vedderb/rise_sdvp/Hardware/Controller/Documents/CC2520/Readme.txt

XXXXXXXXXXXXXXXXXXXXXXXXXXXXXXXXXXXXXXXXXXXXXXXXXXXXXXXXXXXXXXXXX
X   	Artwork and documentation done by: 			X
X								X
X	TEXAS INSTRUMENTS NORWAY LPW              		X
X  								X
X	Address: Gaustadalléen 21    0349 OSLO                  X
X 	web: www.ti.com/lpw 		                        X
X                                                           	X
XXXXXXXXXXXXXXXXXXXXXXXXXXXXXXXXXXXXXXXXXXXXXXXXXXXXXXXXXXXXXXXXX

PCB NAME : CC2520-CC2591EM
REVISION: 3.0
DATE: 2009-09-21

FILE:  PACKED WITH WinZIP 

PCB DESCRIPTION:4 LAYER PCB 1.6 MM
      Copper        1   35 um
      Dielectric  1-2   0.175 mm (e.g. 1x Prepreg 7628 AT05 47% Resin)
      Copper        2   18 um
      Dielectric  2-3   1.14 mm (6x 7628M 43% Resin)
      Copper        3   18 um
      Dielectric  3-4   0.175 mm (e.g. 1x Prepreg 7628 AT05 47% Resin)
      Copper        4   35 um
  DE104iML or equivalent substrate (Resin contents around 45%, which gives Er=4.42@2.4GHz, TanD=0.016)
  Dimensions in mil (0.001 inch)
  DOUBLE SIDE SOLDER MASK,
  DOUBLE SIDE SILKSCREEN,
  8 MIL MIN TRACE WIDTH AND 5 MIL MIN ISOLATION.

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

*** ASSEMBLY FILES:
PASTCOMP.SPL            SOLDER PAST COMPONENT SIDE/POSITIVE         EXT. GERBER
PASTSOLD.SPL             SOLDER PAST SOLDER SIDE/POSITIVE            EXT. GERBER
ASSYCOMP.SPL            ASSEMBLY DRAWING COMPONENT SIDE/NEGATIVE    EXT. GERBER
ASSYSOLD.SPL            ASSEMBLY DRAWING SOLDER SIDE/NEGATIVE       EXT. GERBER
P_P_COMP.REP             PICK AND PLACE FILE COMPONENT SIDE          ASCII
P_P_SOLD.REP             PICK AND PLACE FILE SOLDER SIDE             ASCII
CC2520-CC2591EM_Partlist.xls	BOM				Excel

PDF FILES:
CC2520_CC2591_EM_SCHEMATIC.PDF	Circuit Diagram
CC2520_CC2591_EM_LAYOUT.PDF	Layout Diagram

CADSTAR FILES:
CC2520_CC2591_EM.SCM		Cadstar Schematic file
CC2520_CC2591_EM.CSA		Cadstar Shematic archive
CC2520_CC2591_EM.PCB		Cadstar layout file
CC2520_CC2591_EM.CPA		Cadstar PCB archive

README.TXT           	THIS FILE                                 			ASCII

END.
