vedderb/rise_sdvp/Misc/Test Data/paper_2018-06/plots/3_diff_flat_10.pdf

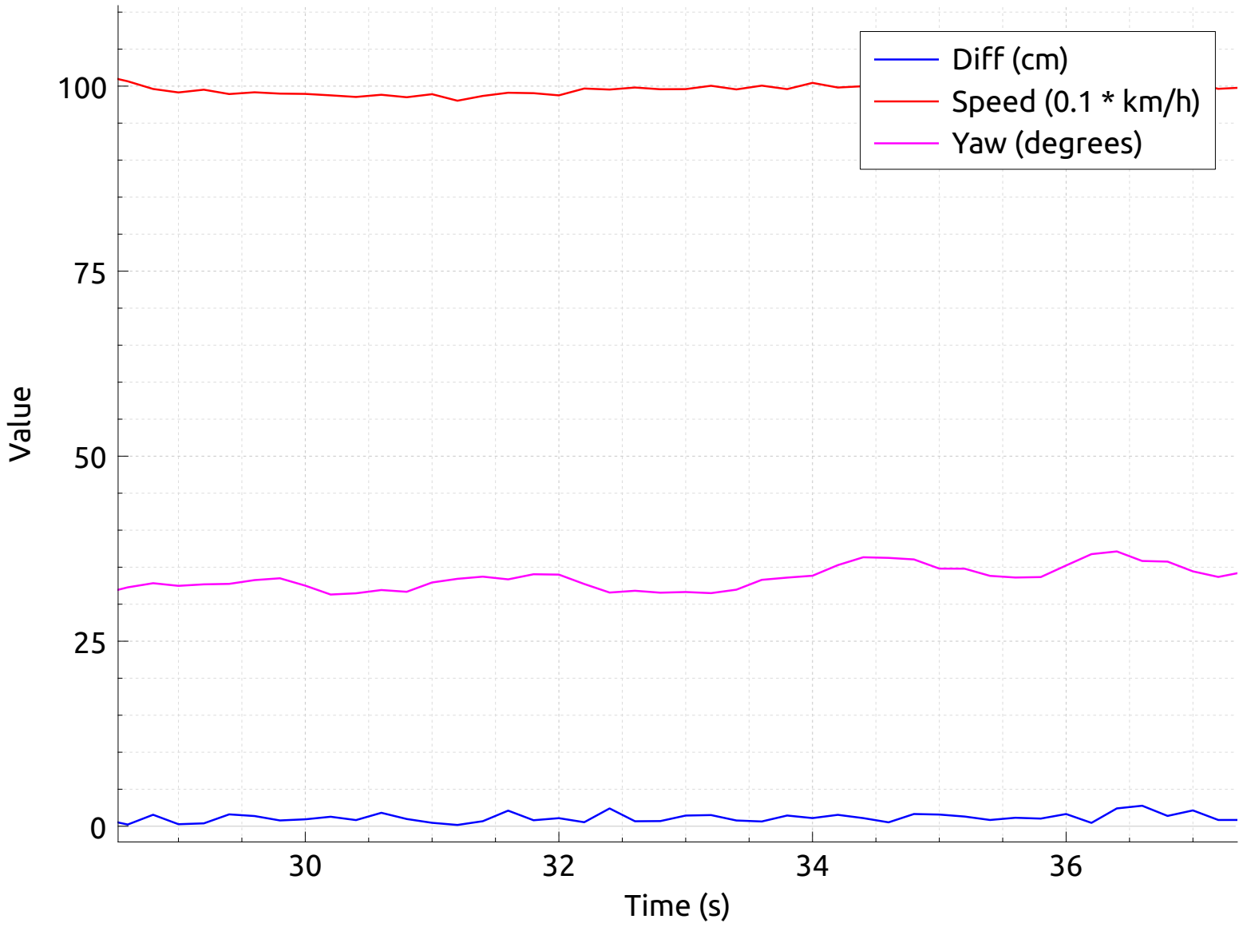
[picture p5: figure]
Time (s); alu; Diff (cm) Speed (0.1 * km/h) Yaw (degrees)
