vedderb/rise_sdvp/Misc/Test Data/paper_2018-06/plots/1_diff_flat_wrong_wheel_rad.pdf

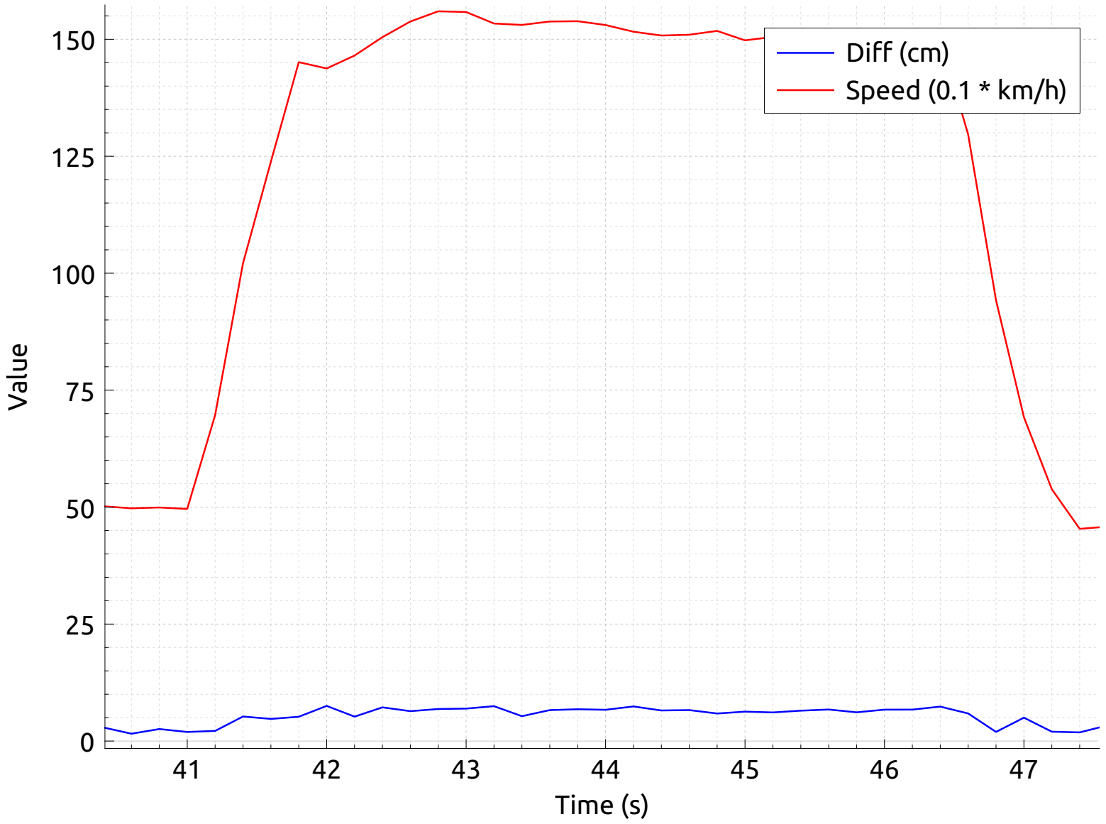
[picture p7: figure]
Time (s); alu; Diff (cm) Speed (0.1 * km/h)
