vedderb/rise_sdvp/Misc/Test Data/paper_2018-06/plots/3_diff_no_corr_zoom.pdf

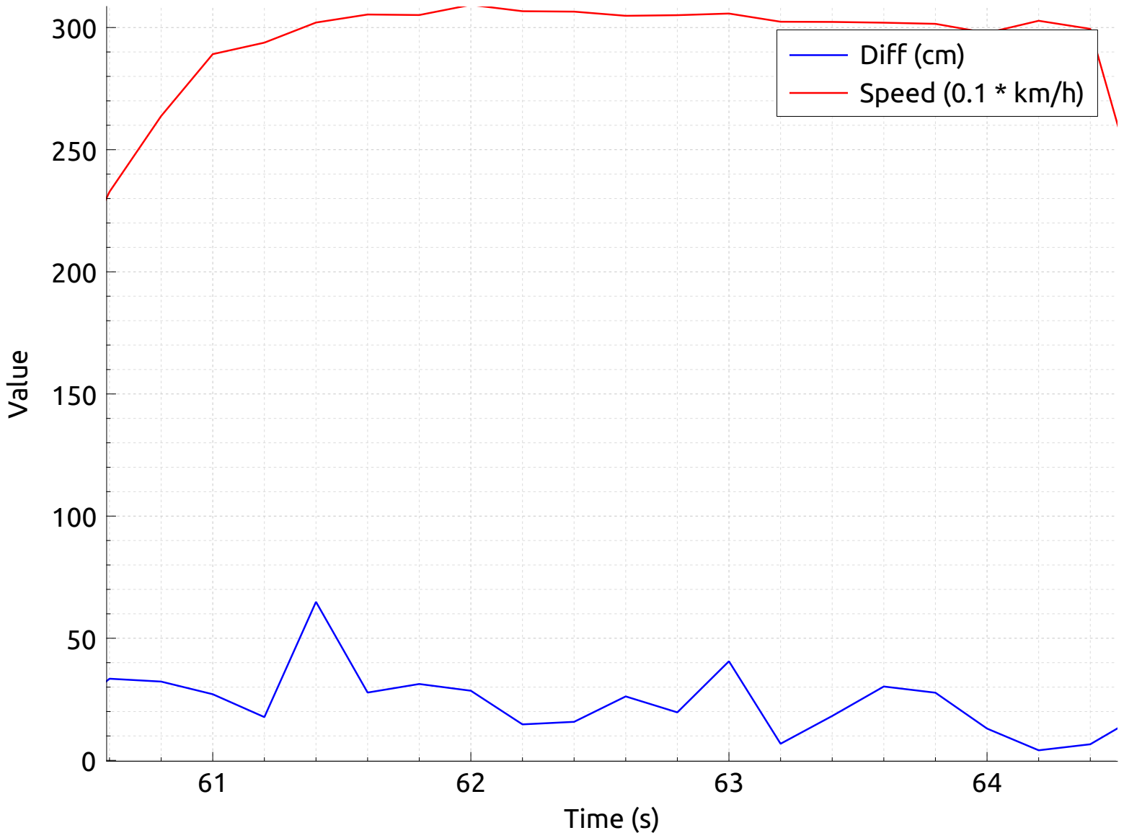
[picture p10: figure]
Time (s); alu; Diff (cm) Speed (0.1 * km/h)
