vedderb/rise_sdvp/Misc/Test Data/paper_2018-06/plots/3_diff_zoom.pdf

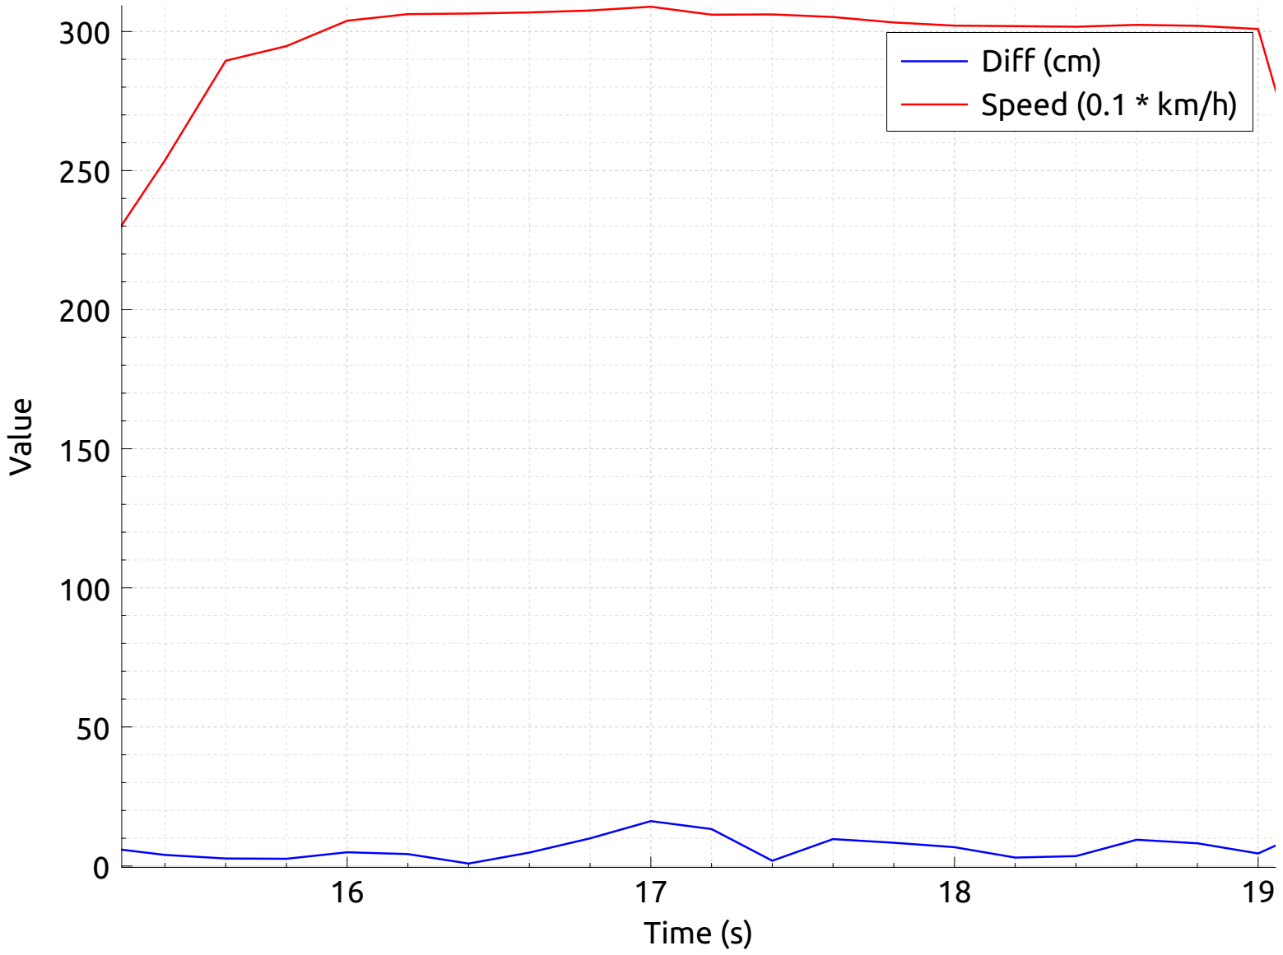
[picture p11: figure]
Value
