vedderb/rise_sdvp/Hardware/Controller/Images/Back.png

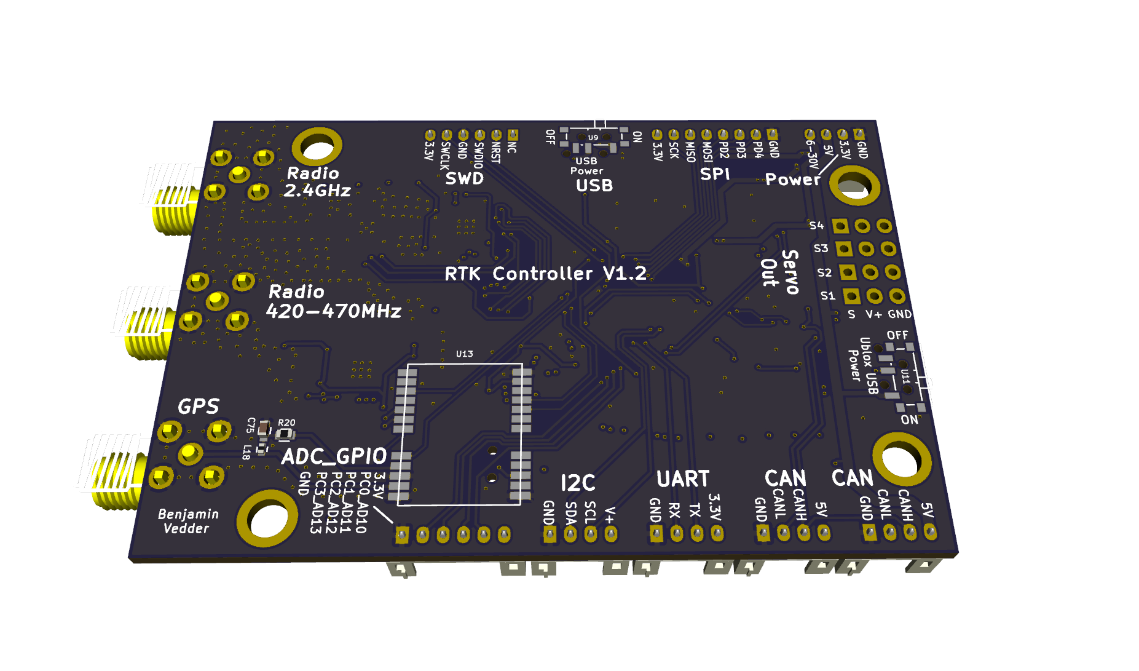
Hardware/Controller/Images/Back.png
