vedderb/rise_sdvp/Hardware/Controller/Images/Front.png

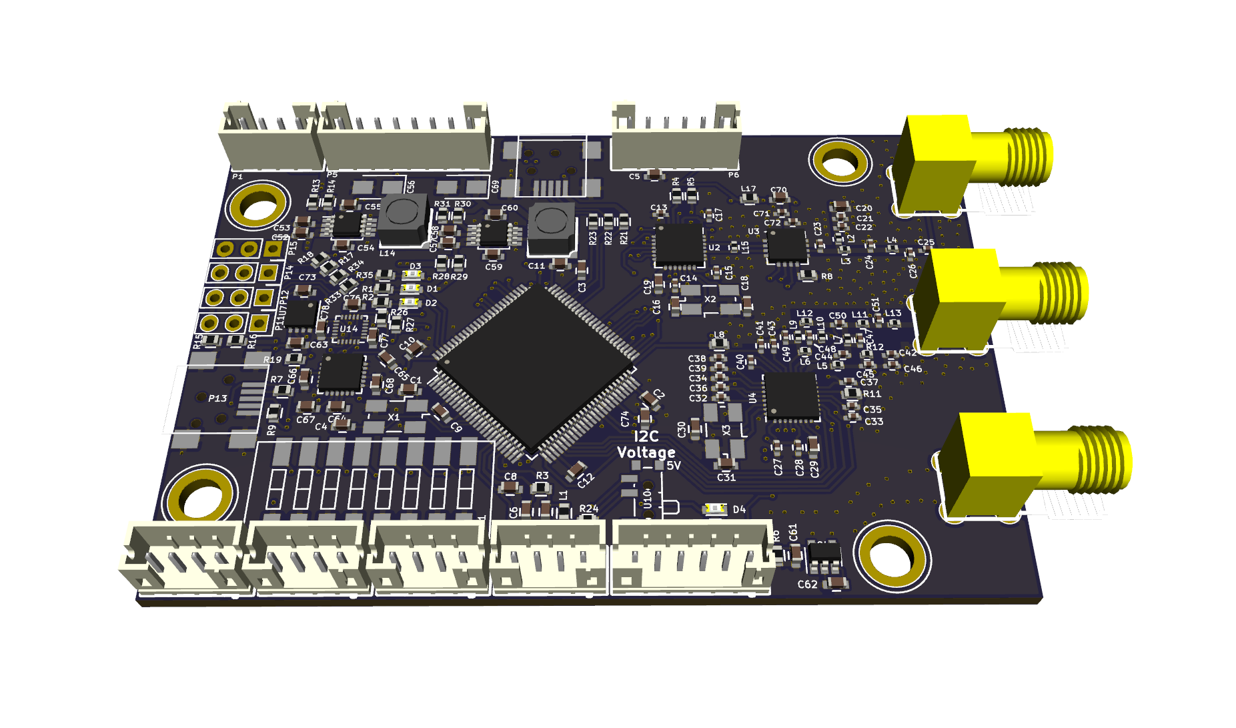
Hardware/Controller/Images/Front.png
