vedderb/rise_sdvp/Hardware/Controller/Images/pcb_dim.png

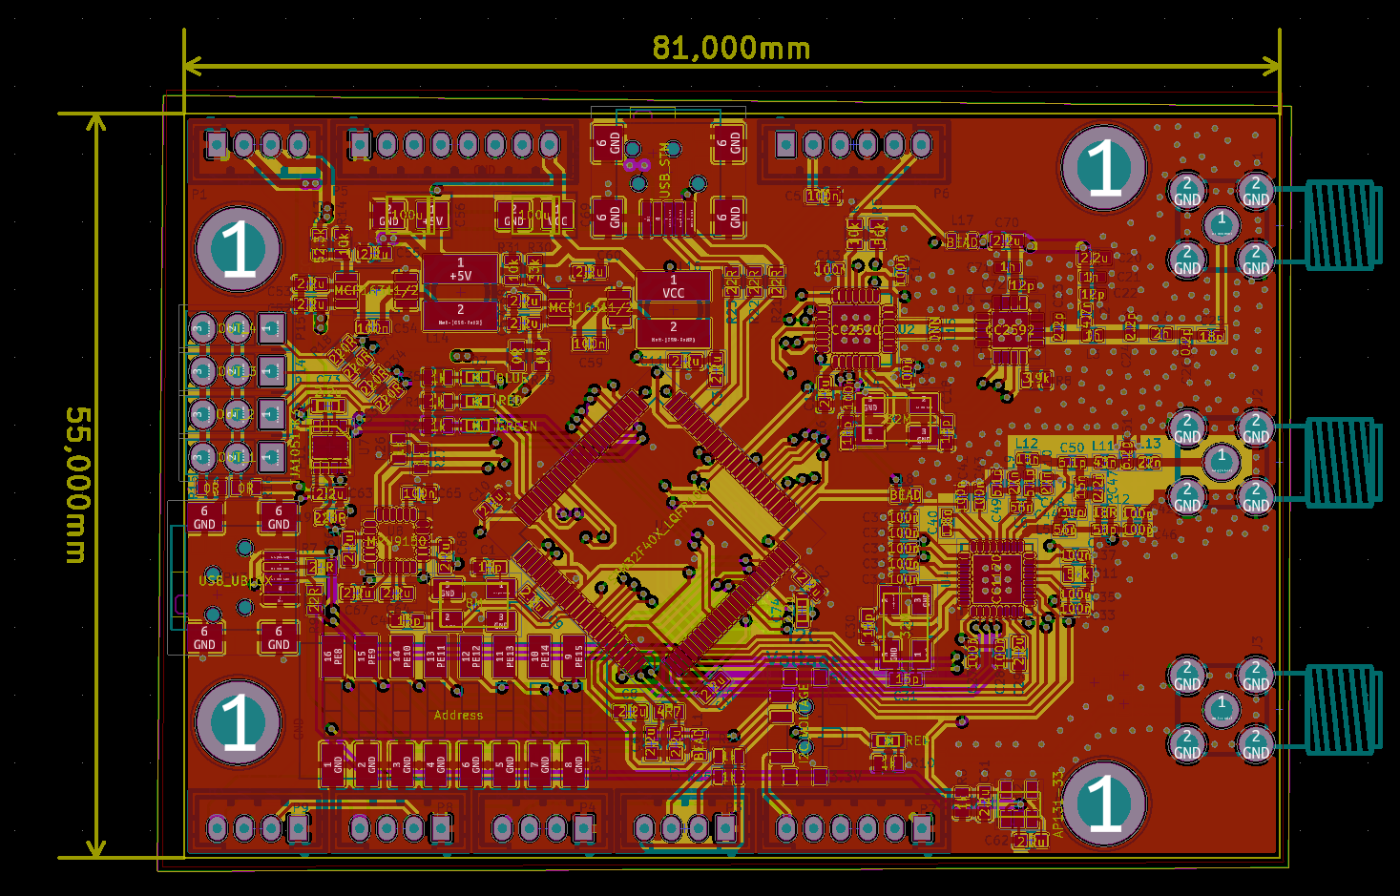
Hardware/Controller/Images/pcb_dim.png
