vedderb/rise_sdvp/Hardware/io_board/doc/20200402_221031.jpg

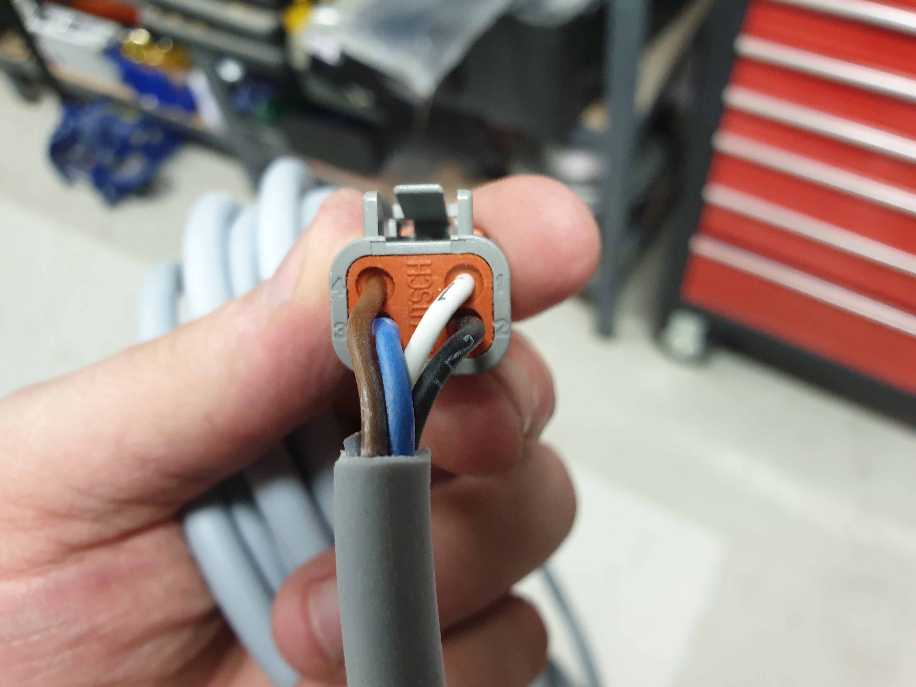
Hardware/io_board/doc/20200402_221031.jpg
