vedderb/rise_sdvp/Hardware/io_board/freecad/20200411_190108.jpg

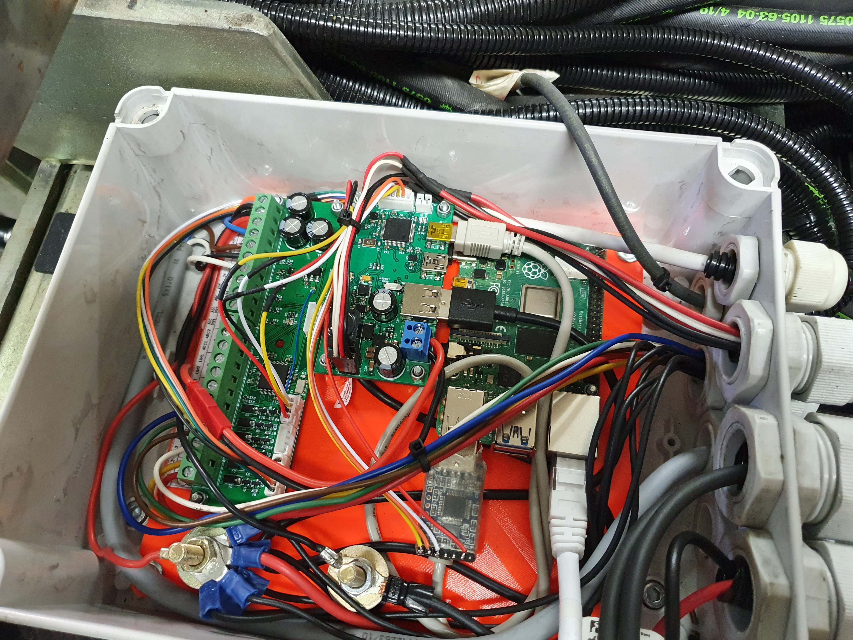
Hardware/io_board/freecad/20200411_190108.jpg
