vedderb/rise_sdvp/Hardware/io_board/freecad/freecad.png

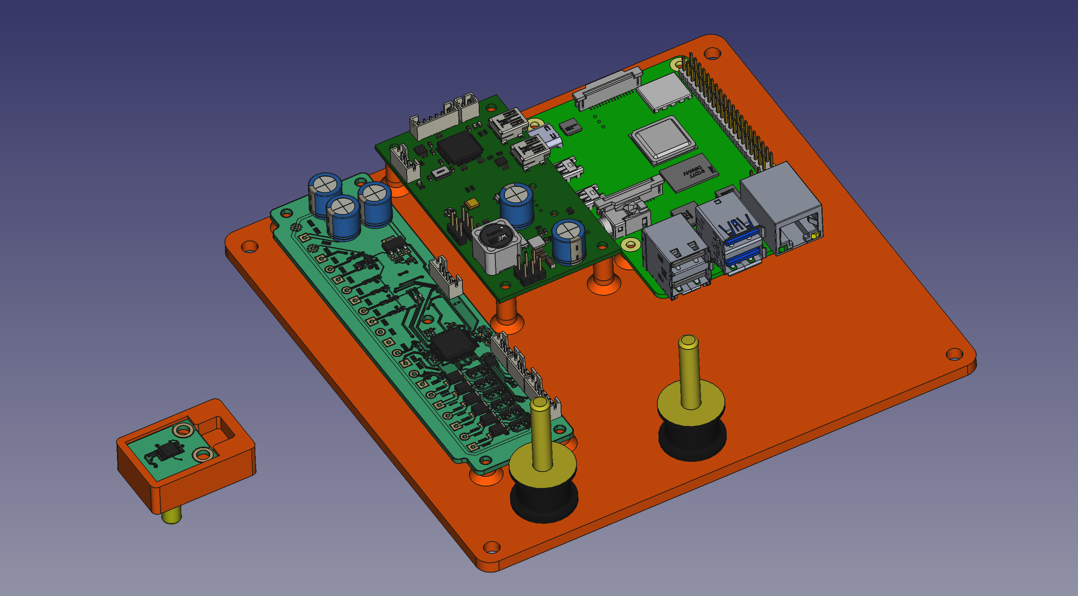
Hardware/io_board/freecad/freecad.png
