vedderb/rise_sdvp/Hardware/RFMote_PA/Images/Back_3D.png

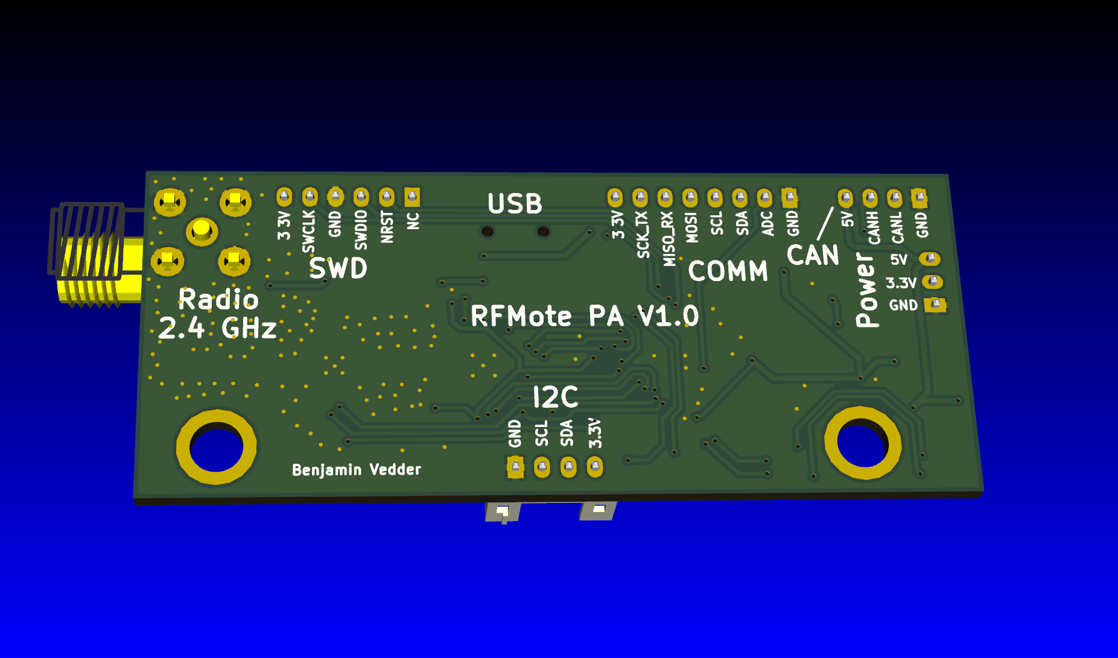
Hardware/RFMote_PA/Images/Back_3D.png
