vedderb/rise_sdvp/Hardware/RFMote_PA/Images/Front_3D.png

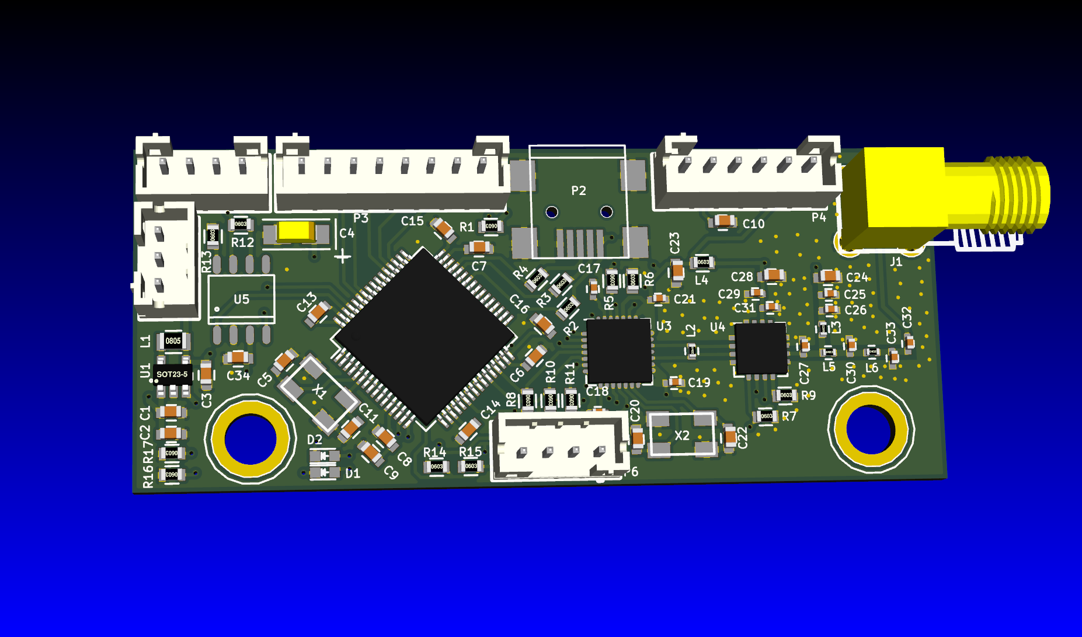
Hardware/RFMote_PA/Images/Front_3D.png
