vedderb/rise_sdvp/Linux/Car_Client/res/button.png

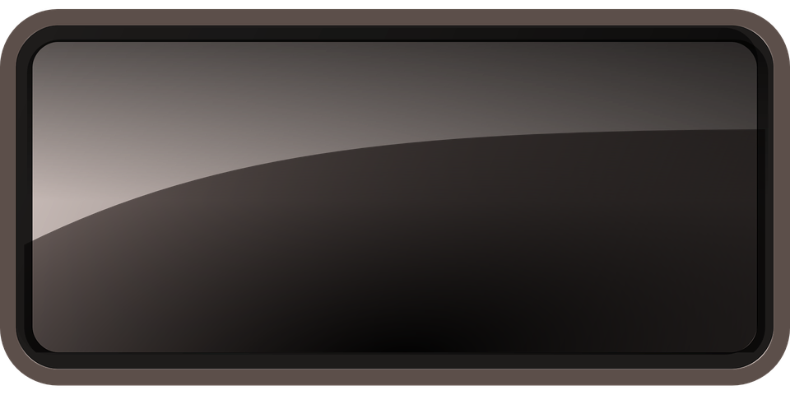
Linux/Car_Client/res/button.png
