vedderb/rise_sdvp/Linux/Car_Client/res/start.jpg

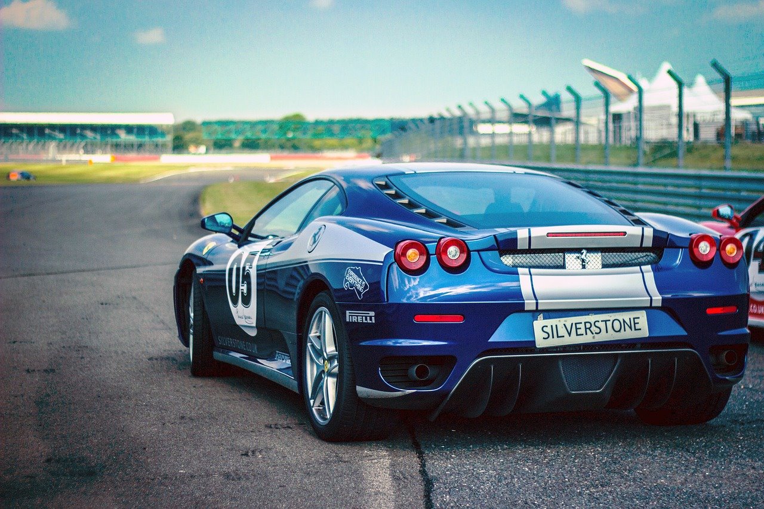
Linux/Car_Client/res/start.jpg
