vedderb/rise_sdvp/Hardware/Controller/Documents/BOM.ods

Designator | Package | Designation | Qty/Board | Mouser | Farnell | Part Number | Price/Unit | Price/Board | Comment
C1,C4,C16,C18,C30,C31 | C_0603 | 15p | 6 |  | 1759124 | MC0603N150J101CT | 0,228 | 1,368
C2,C3,C6,C7,C8,C9,C10,C11,C12,C19,C20,C29,C52,C53,C55,C57,C58,C60,C61,C62,C63,C64,C66,C67,C68,C70,C73,C74,C77,C78 | C_0603 | 2.2u | 30 | 810-C1608X5R1C225M-4 |  | C1608X5R1C225M-4 | 0,515 | 15,45
C5,C54,C59,C65,C75,C76 | C_0603 | 100n | 6 |  | 432210 | CC0603KRX7R7BB104 | 0,08 | 0,48
C13,C14,C15,C17,C27,C28,C32,C33,C34,C35,C36,C37,C38,C39,C41,C42,C43 | C_0402 | 100n | 17 |  | 1759380 | MC0402X104K100CT | 0,0457 | 0,7769
C21,C71 | C_0402 | 1n | 2 |  | 8819556 | GRM1555C1H102JA01D | 0,327 | 0,654
C22,C72 | C_0402 | 12p | 2 |  | 1828875 | GRM1555C1H120JA01D | 0,113 | 0,226
C23,C24,C47 | C_0402 | 2.2p | 3 |  | 2434609 | GRM1555C1H2R2CA01D | 0,113 | 0,339
C25 | C_0402 | 18p | 1 |  | 1828876 | GRM1555C1H180JA01D | 0,1164 | 0,1164
C26 | C_0402 | 0.2p | 1 | 81-GRM1555C1HR20BA1D |  | GRM1555C1HR20BA1D | 0,326 | 0,326
C40 | C_0402 | 1.8n | 1 |  | 2456099 | GRM1557U1A182JA01D | 0,676 | 0,676
C44 | C_0402 | 39p | 1 |  | 1828878 | GRM1555C1H390JA01D | 0,1212 | 0,1212
C45 | C_0402 | 56p | 1 |  | 1828879 | GRM1555C1H560JA01D | 0,123 | 0,123
C46 | C_0402 | 100p | 1 |  | 2218836 | GRM1555C1H101JA01D | 0,0927 | 0,0927
C48,C49,C50 | C_0402 | 5.1p | 3 | 81-GRM1555C1E5R1CA1D |  | GRM1555C1E5R1CA01D | 0,074 | 0,222
C51 | C_0402 | 6.2p | 1 | 81-GRM1555C1H6R2BA1D |  | GRM1555C1H6R2BA01D | 0,205 | 0,205
C56,C69 | TantalC_SizeB_EIA-3528_Wave | 100u | 2 |  | 1432579 | TPSB107K006R0400 | 4,01 | 8,02
J1,J2,J3 | sma_90_r300.124.403 | SMA | 3 |  | 1909297 | 73251-3131 | 28,79 | 86,37
L1,L8,L17 | R_0603 | BEAD | 3 |  | 2443237 | BLM18HE152SN1D | 1,1 | 3,3
L2 | R_0402 | 4.7n | 1 | 81-LQW15AN4N7B00D |  | LQW15AN4N7B00D | 1,09 | 1,09
L3 | R_0402 | 1n | 1 | 81-LQP15MN1N0B02D |  | LQP15MN1N0B02D | 1,11 | 1,11
L4 | R_0402 | 2n | 1 | 81-LQP15MN2N0B02D |  | LQP15MN2N0B02D | 1,11 | 1,11
L5,L6,L18 | R_0402 | 56n | 3 | 81-LQW15AN56NJ00D |  | LQW15AN56NJ00D | 0,986 | 2,958
L7,L12 | R_0402 | 15n | 2 | 81-LQW15AN15NJ00D |  | LQW15AN15NJ00D | 0,986 | 1,972
L9,L10 | R_0402 | 27n | 2 | 81-LQW15AN27NG00D |  | LQW15AN27NG00D | 1,09 | 2,18
L11 | R_0402 | 43n | 1 | 81-LQW15AN43NG00D |  | LQW15AN43NG00D | 1,09 | 1,09
L13 | R_0402 | 22n | 1 | 81-LQW15AN22NG00D |  | LQW15AN22NG00D | 1,09 | 1,09
L14,L16 | inductor_smd_4.8x2.8mm | 22U | 2 |  | 2066945 | 74408943220 | 16,55 | 33,1
L15 | R_0402 | DNM | 1 |  |  |  |  | 0 | Do not mount
P1,P3,P4,P8,P9 | b4b-ph-kl | Mini-JST 4P | 5 |  | 9492437 | B4B-PH-K-S(LF)(SN) | 1,75 | 8,75
P2,P13 | USB_Mini-B | USB_OTG | 2 |  | 2112367 | 10033526-N3212MLF | 4,45 | 8,9
P5 | b8b-ph-kl | Mini-JST 8P | 1 |  | 9492461 | B8B-PH-K-S(LF)(SN) | 3,5 | 3,5
P6,P7 | b6b-ph-kl | Mini-JST 6P | 2 |  | 9492453 | B6B-PH-K-S(LF)(SN) | 2,6 | 5,2
P11,P12,P14,P15 | Pin_Header_Straight_1x03 | Servo | 4 | 538-22-28-4035 |  | 22-28-4035 | 1,81 | 7,24
R1,R2,R6,R10,R24,R25,R26,R27,R35 | R_0603 | 1k | 9 |  | 2447272 | MCWR06X1001FTL | 0,0636 | 0,5724
R3,R20 | R_0603 | 4R7 | 2 |  | 2447390 | MCWR06W4R70FTL | 0,0793 | 0,1586
R4,R14,R31 | R_0603 | 10k | 3 |  | 2447230 | MCWR06X1002FTL | 0,0627 | 0,1881
R5,R11 | R_0603 | 56k | 2 |  | 2447399 | MCWR06X5602FTL | 0,0627 | 0,1254
R8 | R_0603 | 3.9k | 1 |  | 2447363 | MCWR06X3901FTL | 0,0627 | 0,0627
R12 | R_0402 | 18R | 1 |  | 2447119 | MCWR04X18R0FTL | 0,0614 | 0,0614
R13 | R_0603 | 52.3k | 1 |  | 1170957 | MC0063W0603152K3 | 0,156 | 0,156
R16,R28 | R_0603 | 0R | 0 |  | 2689614 | MCWR06X000 PTL | 0,0575 | 0 | Do not mount
R15,R29 | R_0603 | 0R | 2 |  | 2689614 | MCWR06X000 PTL | 0,0575 | 0,115
R17,R18,R19,R33,R34 | R_0603 | 220R | 5 |  | 2447298 | MCWR06X2200FTL | 0,0627 | 0,3135
R7,R9,R21,R22,R23 | R_0603 | 22R | 5 |  | 2447301 | MCWR06X22R0FTL | 0,0636 | 0,318
R30 | R_0603 | 33k | 1 |  | 2447342 | MCWR06X3302FTL | 0,0636 | 0,0636
SW1 | SW_DIP_x8_Slide | Address | 1 |  | 1813625 | ADF08S04 | 13,55 | 13,55
U1 | LQFP-100_14x14mm_Pitch0.5mm | STM32F40X_LQFP100 | 1 |  | 2064368 | STM32F407VGT6 | 86,41 | 86,41
U2 | QFN-28-1EP_5x5mm_Pitch0.5mm | CC2520 | 1 |  | 1573887 | CC2520RHDT | 42,35 | 42,35
U3 | QFN-16-1EP_4x4mm_Pitch0.65mm | CC2592 | 1 |  | 2422919 | CC2592RGVT | 25,3 | 25,3
U4 | QFN-32-1EP_5x5mm_Pitch0.5mm | CC1120 | 1 |  | 2422922 | CC1120RHBT | 50 | 50
U5,U6 | MSOP-8_3x3mm_Pitch0.65mm | MCP16311/2 | 2 |  | 2414134 |  | 10,42 | 20,84
U7 | DFN-8-EP-0.65 | TJA1051TK/3118 | 1 | 771-TJA1051TK/3118 | 2574964 | TJA1051TK/3 | 7,64 | 7,64 | Mouser or farnell, depending on stock
U8 | QFN-24_4x4mm_Pitch0.5mm | MPU9150 | 0 |  |  |  |  | 0 | Do not mount
U14 | QFN-24_3x3mm_Pitch0.4mm | MPU9250 | 1 | 410-MPU-9250 |  | MPU-9250 | 68,02 | 68,02
X1 | Crystal_5x3mm_3pin | 8M | 1 |  | 2467817 | ABM3B-8.000MHZ-10-1-U-T | 6,68 | 6,68
X2,X3 | Crystal_5x3mm_3pin | 32M | 2 | 815-ABM3B-32-B2 |  | ABM3B-32.000MHZ-B2-T | 8,08 | 16,16
D1,D4 | LED-0603 | RED | 2 |  | 1226390 | LSQ976-Z | 2,68 | 5,36
D2 | LED-0603 | GREEN | 1 |  | 2575345 | LGQ396-PS-35 | 1,23 | 1,23
D3 | LED-0603 | BLUE | 1 |  | 1908058 | LNJ937W8CRA | 3,1 | 3,1
U9,U10,U11 | Switch | Switch | 3 | 611-PCM12SMTR |  | PCM12SMTR | 0,75 | 2,25
U12 | SOT23-5 | Vreg | 1 | 998-MIC5504-3.3YM5TR |  | MIC5504-3.3YM5TR | 1,02 | 1,02
U13 | Ublox-NEO | Ublox M8P | 0 |  |  | NEO-M8P-2 | 1650 | 0 | Do not mount
 |  | Components total | 165 |  |  |  | Total SEK | 550,2009
