vedderb/rise_sdvp/Hardware/RFMote_PA/Documents/BOM_RFMote_PA.ods

Designator | Package | Designation | Qty/Board | Qty Order | Mouser | Farnell | Part Number | Price/Unit | Price/Board | Price Order | Comment
C1,C2,C3,C6,C7,C8,C9,C13,C14,C15,C16,C23,C24,C28,C34 | C_0603 | 2.2u | 15 | 100 |  | 1962117 | C1608X5R1C225M080AB | 0,241 | 3,615 | 24,1
C4 | TantalC_SizeA_EIA-3216_Wave | 100u | 1 | 10 |  | 1432579 | TPSB107K006R0400 | 4,01 | 4,01 | 40,1
C5,C11,C20,C22 | C_0603 | 15p | 4 | 50 |  | 1759124 | MC0603N150J101CT | 0,228 | 0,912 | 11,4
C10 | C_0603 | 100n | 1 | 10 |  | 432210 | CC0603KRX7R7BB104 | 0,08 | 0,08 | 0,8
C17,C18,C19,C21 | C_0402 | 100n | 4 | 100 |  | 1759380 | MC0402X104K100CT | 0,0457 | 0,1828 | 4,57
C25,C29 | C_0402 | 1n | 2 | 50 |  | 8819556 | GRM1555C1H102JA01D | 0,327 | 0,654 | 16,35
C26,C31 | C_0402 | 12p | 2 | 50 |  | 1828875 | GRM1555C1H120JA01D | 0,113 | 0,226 | 5,65
C27,C30 | C_0402 | 2.2p | 2 | 50 |  | 2434609 | GRM1555C1H2R2CA01D | 0,113 | 0,226 | 5,65
C32 | C_0402 | 18p | 1 | 10 |  | 1828876 | GRM1555C1H180JA01D | 0,1164 | 0,1164 | 1,164
C33 | C_0402 | 0.2p | 1 | 10 | 81-GRM1555C1HR20BA1D |  | GRM1555C1HR20BA1D | 0,326 | 0,326 | 3,26
J1 | sma_90_crf | SMA | 1 | 5 |  | 1909297 | 73251-3131 | 28,79 | 28,79 | 143,95
L1 | R_0805 | 2.2u | 1 | 10 |  | 2309790 | ELG-TEA2R2NA | 2,34 | 2,34 | 23,4
L2 | R_0402 | DNM | 0 | 0 |  |  |  |  | 0 | 0
L3 | R_0402 | 4.7n | 1 | 10 | 81-LQW15AN4N7B00D |  | LQW15AN4N7B00D | 1,09 | 1,09 | 10,9
L4 | R_0603 | BEAD | 1 | 10 |  | 2443237 | BLM18HE152SN1D | 1,1 | 1,1 | 11
L5 | R_0402 | 1n | 1 | 10 | 81-LQP15MN1N0B02D |  | LQP15MN1N0B02D | 1,11 | 1,11 | 11,1
L6 | R_0402 | 2n | 1 | 10 | 81-LQP15MN2N0B02D |  | LQP15MN2N0B02D | 1,11 | 1,11 | 11,1
P1 | b3b-ph-kl | V_IN | 1 | 10 |  | 9492429 | B3B-PH-K-S(LF)(SN) | 1,55 | 1,55 | 15,5
P2 | USB_Mini-B | USB_OTG | 1 | 10 |  | 2112367 | 10033526-N3212MLF | 4,45 | 4,45 | 44,5
P3 | b8b-ph-kl | COMM | 1 | 10 |  | 9492461 | B8B-PH-K-S(LF)(SN) | 3,5 | 3,5 | 35
P4 | b6b-ph-kl | SWD | 1 | 10 |  | 9492453 | B6B-PH-K-S(LF)(SN) | 2,6 | 2,6 | 26
P5,P6 | b4b-ph-kl | CAN | 2 | 10 |  | 9492437 | B4B-PH-K-S(LF)(SN) | 1,75 | 3,5 | 17,5
R1 | R_0603 | 0R | 1 | 10 |  | 2447743 | MCWR06X000 PTL | 0,0575 | 0,0575 | 0,575
R2,R3,R4 | R_0603 | 22R | 3 | 50 |  | 2447301 | MCWR06X22R0FTL | 0,0636 | 0,1908 | 3,18
R5,R8,R10,R11,R13 | R_0603 | 10k | 5 | 100 |  | 2447230 | MCWR06X1002FTL | 0,0627 | 0,3135 | 6,27
R6,R7 | R_0603 | 56k | 2 | 50 |  | 2447399 | MCWR06X5602FTL | 0,0627 | 0,1254 | 3,135
R9 | R_0603 | 3.9k | 1 | 10 |  | 2447363 | MCWR06X3901FTL | 0,0627 | 0,0627 | 0,627
R12 | R_0603 | 220R | 1 | 10 |  | 2447298 | MCWR06X2200FTL | 0,0627 | 0,0627 | 0,627
U1 | SOT-23-5 | LM3671 | 1 | 5 |  | 1685767 | LM3671MF-3.3/NOPB | 6,55 | 6,55 | 32,75
U3 | QFN-28-1EP_5x5mm_Pitch0.5mm | CC2520 | 1 | 5 |  | 1573887 | CC2520RHDT | 42,35 | 42,35 | 211,75
U4 | QFN-16-1EP_4x4mm_Pitch0.65mm | CC2592 | 1 | 5 |  | 2422919 | CC2592RGVT | 25,3 | 25,3 | 126,5
U5 | SO-8 | MCP2551-I/SN | 1 | 5 |  | 9758569 | MCP2551-I/SN | 7,64 | 7,64 | 38,2
X2 | Crystal_5x3mm_3pin | 32M | 1 | 5 | 815-ABM3B-32-B2 |  | ABM3B-32.000MHZ-B2-T | 8,08 | 8,08 | 40,4
U2 | LQFP-64_10x10mm_Pitch0.5mm | STM32F40X_LQFP64 | 1 | 5 |  | 2064363 | STM32F405RGT6 | 115,25 | 115,25 | 576,25
X1 | Crystal_5x3mm_3pin | 8m | 1 | 5 |  | 2467817 | ABM3B-8.000MHZ-10-1-U-T | 10,4 | 10,4 | 52
R14,R15,R16,R17 | R_0603 | 1k | 4 | 10 |  | 2447272 | MCWR06X1001FTL | 0,0636 | 0,2544 | 0,636
D1 | LED-0603 | RED | 1 | 10 |  | 1226390 | LSQ976-Z | 2,68 | 2,68 | 26,8
D2 | LED-0603 | GREEN | 1 | 10 |  | 1226372 | LGQ971 | 1,15 | 1,15 | 11,5
 |  | Total | 71 |  |  |  |  | Total | 281,9552 | 1594,194
