vedderb/rise_sdvp/Hardware/Controller/Documents/CC1120/CC1120EM_420_470_Partlist.xls

CC1120 EM Rev 1.1.0 420-470 MHz version
Including LPF
Ref. | Part name | Pcs/unit | Description | Manufacturer | Part number | Supplier | Ordering code | Alt. Manufacturer | Alt. Part number | Alt. Supplier | Alt. Ordering code | Comments
C11 | C_47N_0402_X7R_K_25 | 1 | Capacitor, 47n, 0402, X7R, 10%, 25V | Murata | GRM155R71E473KA88D
C12 | C_100N_0402_X5R_K_10 | 0 | Do not mount
C41 | C_10N_0402_X7R_K_25 | 0 | Do not mount
C51 | C_47N_0402_X7R_K_25 | 1 | Capacitor, 47n, 0402, X7R, 10%, 25V | Murata | GRM155R71E473KA88D
C52 | C_2U2_0603_X5R_K_10 | 1 | Capacitor, 2u2, 0603, X5R, 10%, 10V | Murata | GRM188R61A225KE34D
C53 | C_0402 | 0 | Do not mount
C61 | C_220N_0402_X5R_K_10 | 1 | Capacitor, 220n, 0402, X5R, 10%, 10V | Murata | GRM155R61A224KE19D
C121 | C_47N_0402_X7R_K_25 | 1 | Capacitor, 47n, 0402, X7R, 10%, 25V | Murata | GRM155R71E473KA88D
C131 | C_47N_0402_X7R_K_25 | 1 | Capacitor, 47n, 0402, X7R, 10%, 25V | Murata | GRM155R71E473KA88D
C151 | C_47N_0402_X7R_K_25 | 1 | Capacitor, 47n, 0402, X7R, 10%, 25V | Murata | GRM155R71E473KA88D
C171 | C_10N_0402_X7R_K_25 | 1 | Capacitor, 10n, 0402, X7R, 10%, 25V | Murata | GRM155R71E103KA01D
C172 | C_100P_0402_NP0_J_50 | 1 | Capacitor, 100p, 0402, NP0, 5% 50V | Murata | GRM1555C1H101JZ01D
C173 | C_56P_0402_NP0_J_50 | 0 | Do not mount |  |  | #N/A | #N/A | #N/A | #N/A | #N/A | #N/A | #N/A
C174 | C_39P_0402_NP0_J_50 | 1 | Capacitor, 39p, 0402, NP0, 5%, 50V | Murata | GRM1555C1H390JZ01D
C175 | C_6P2_0402_NP0_C_50 | 1 | Capacitor, 6p2, 0402, NP0, +-0.25pF 50V | Murata | GRM1555C1H6R2CZ01D
C176 | C_2P2_0402_NP0_C_50 | 1 | Capacitor, 2p2, 0402, NP0, +-0.25pF, 50V | Murata | GRM1555C1H2R2CZ01
C177 | C_0402 | 0 | Do not mount
C181 | C_5P1_0402_NP0_C_50 | 1 | Capacitor, 5p1, 0402, NP0, +-0.25pF, 50V | Murata | GRM1555C1H5R1CZ01D
C191 | C_5P1_0402_NP0_C_50 | 1 | Capacitor, 5p1, 0402, NP0, +-0.25pF, 50V | Murata | GRM1555C1H5R1CZ01D
C201 | C_5P1_0402_NP0_C_50 | 1 | Capacitor, 5p1, 0402, NP0, +-0.25pF, 50V | Murata | GRM1555C1H5R1CZ01D
C211 | C_10N_0402_X7R_K_25 | 1 | Capacitor, 10n, 0402, X7R, 10%, 25V | Murata | GRM155R71E103KA01D
C221 | C_47N_0402_X7R_K_25 | 1 | Capacitor, 47n, 0402, X7R, 10%, 25V | Murata | GRM155R71E473KA88D
C231 | C_1N8_0402_U2J_J_10 | 1 | Capacitor, 1n8, 0402, U2J, 5%, 10V | Murata | GRM1557U1A182JA01D
C251 | C_47N_0402_X7R_K_25 | 1 | Capacitor, 47n, 0402, X7R, 10%, 25V | Murata | GRM155R71E473KA88D
C261 | C_47N_0402_X7R_K_25 | 1 | Capacitor, 47n, 0402, X7R, 10%, 25V | Murata | GRM155R71E473KA88D
C271 | C_47N_0402_X7R_K_25 | 1 | Capacitor, 47n, 0402, X7R, 10%, 25V | Murata | GRM155R71E473KA88D
C281 | C_47N_0402_X7R_K_25 | 1 | Capacitor, 47n, 0402, X7R, 10%, 25V | Murata | GRM155R71E473KA88D
C291 | C_47N_0402_X7R_K_25 | 1 | Capacitor, 47n, 0402, X7R, 10%, 25V | Murata | GRM155R71E473KA88D
C301 | C_15P_0402_NP0_J_50 | 1 | Capacitor, 15p, 0402, NP0, 5%, 50V | Murata | GRM1555C1H150JZ01D
C302 | C_0402 | 0 | Do not mount
C311 | C_15P_0402_NP0_J_50 | 1 | Capacitor, 15p, 0402, NP0, 5%, 50V | Murata | GRM1555C1H150JZ01D
C321 | C_100N_0402_X5R_K_10 | 0 | Do not mount
C322 | C_22P_0402_NP0_J_50 | 0 | Do not mount
L1 | L_BEAD_102_0402 | 1 | EMI filter bead, 0402 1k ohms Tape GHz Band Gen Use | Murata | BLM15HG102SN1D | ACTE
L171 | L_56N_0402_J_LQW | 1 | Inductor, 56n, 0402, ±5%, wire-wound type | Murata | LQW15AN56NJ00 | ACTE
L172 | L_15N_0402_J_LQW | 1 | Inductor, 15n, 0402, ±5%, wire-wound type | Murata | LQW15AN15NJ00D
L173 | L_43N_0402_J_LQW | 1 | Inductor, 43n, 0402, ±5%, wire-wound type | Murata | LQW15AN43NJ00 | ACTE
L174 | L_22N_0402_J_LQW | 1 | Inductor, 22n, 0402, ±5%, wire-wound type | Murata | LQW15AN22NJ00D | ACTE
L191 | L_56N_0402_J_LQW | 1 | Inductor, 56n, 0402, ±5%, wire-wound type | Murata | LQW15AN56NJ00 | ACTE
L192 | L_27N_0402_J_LQW | 1 | Inductor, 27n, 0402, ±5%, wire-wound type | Murata | LQW15AN27NJ00D | ACTE
L193 | L_15N_0402_J_LQW | 1 | Inductor, 15n, 0402, ±5%, wire-wound type | Murata | LQW15AN15NJ00D
L201 | L_27N_0402_J_LQW | 1 | Inductor, 27n, 0402, ±5%, wire-wound type | Murata | LQW15AN27NJ00D | ACTE
P1 | SMD_SOCKET_2x10 | 1 | SMD pinrow socket, .050 spacing, 2x10 | Samtec | SFM-110-02-SM-D-A-K-TR | Abacus |  |  |  | AFU, Arrow |  | Yes
P2 | SMD_SOCKET_2x10 | 1 | SMD pinrow socket, .050 spacing, 2x10 | Samtec | SFM-110-02-SM-D-A-K-TR | Abacus |  |  |  | AFU, Arrow |  | Yes
P3 | SMA_SMD | 1 | SMA connector, straight SMD-mount | Hus-Tsan Group Taiwan | SMA-10V21-TGG | EC Partner A/S | SMA-10V21-TGG
R12 | R_0_0402 | 1 | Resistor, 0 ohm, 0402 | Koa | RK73Z1ETTP | ELFA | 60-470-05
R141 | R_56K_0402_F | 1 | Resistor, 56k ohms, 0402, ±1% | Koa | RK73H1ETTP5602F | ELFA | 60-488-96
R171 | R_18_0402_J | 1 | Resistor, 18 ohms, 0402, 5% | Koa | RK73H1ETTP18R0F (±1%) | ELFA | 60-472-11
R321 | R_0402 | 0 | Do not mount | Koa | RK73Z1ETTP | ELFA | 60-470-05
R322 | R_0_0402 | 0 | Do not mount
U1 | CC112X | 1 | TI tranciver | Texas Instruments
U2 | TPS79930 | 0 | Do not mount |  |  |  | #N/A | #N/A | #N/A | #N/A
X1 | X_32.000/10/20/60/10 | 1 | Crystal, 32.000000MHz, FA-128, 10.0pF, +/-10ppm, (FTC: +/-20ppm at -40/85C), 60ohms | Epson Toyocom | FA-128, 32MHZ, 10PPM, 10PF, 2x1.6mm, -40/+85C, 60ohms | ACTE | Q22FA1280009200
X2 | TG_5021CG | 0 | Do not mount |  |  |  |  | #N/A | #N/A | #N/A
 |  | 42
