vedderb/rise_sdvp/Hardware/Controller/Documents/CC2520/CC2520-CC2591EM_PARTLIST_zip.xls

CC2520_CC2591EM_3_0_1 Part List
Ref. | Part name | Pcs/unit | Description | Manufacturer | Part number | Supplier | Ordering code | Alt. Manufacturer | Alt. Part number | Alt. Supplier | Alt. Ordering code | Comments
C1;C2 | C_2U2_0402_X5R_M_4VDC | 2 | Capacitor, 2u2, 0402, X5R, +/-20%, 4V | Murata | GRM1555C1H2R2CD01
C11;C131;C161 | C_1N_0402_NP0_J_50 | 3 | Capacitor, 1n, 0402, NP0, 5%, 50V | Murata | GRM1555C1H102JA01D
C12;C132 | C_0402 | 2 | Capacitor, general, 0402; Do not mount
C21 | C_3P0_0402_NP0_C_50 | 1 | Capacitor, 3p0, 0402, NP0, +-0.25pF, 50V | Murata | GRM1555C1H3R0CZ01D
C41 | C_3P9_0402_NP0_C_50 | 1 | Capacitor, 3p9, 0402, NP0, +-0.25pF, 50V | Murata | GRM1555C1H3R9CZ01D
C102 | L_1N1_0402_S | 1 | Inductor, 1n1, 0402, Monolithic type, +/-0.3 nH | Murata | LQG15HS1N1S02D | ACTE |  | Coilcraft
C111 | C_6P8_0402_NP0_C_50 | 1 | Capacitor, 6p8, 0402, NP0, +-0.25pF 50V | Murata | GRM1555C1H6R8CZ01D | ELFA | 65-881-23
C112 | C_1P0_0402_NP0_B_50 | 1 | Capacitor, 1p, 0402, NP0, +/-0.1pF 50V | Murata | GRM1555C1H1R0BZ01D
C113 | C_2P7_0402_NP0_C_50 | 1 | Capacitor, 2p7, 0402, NP0, +-0.25pF, 50V | Murata | GRM1555C1H2R7CZ01D
C121;C1301 | C_27P_0402_NP0_J_50 | 2 | Capacitor, 27p, 0402, NP0, 5%, 50V | Murata | GRM1555C1H270JZ01D
C271;C1401;C1501;C1601 | C_100N_0402_X5R_K_10 | 4 | Capacitor, 100n, 0402, X5R, 10%, 10V | Murata | GRM155R71A104KA01D
L1;L2 | L_BEAD_102_0402 | 2 | EMI filter bead, 0402 1Kohms Tape GHz Band Gen Use | Murata | BLM15HG102SN1D | ACTE
L21;L41;L42;L112 | L_1N0_0402_S | 4 | Inductor, 1n0, 0402, Monolithic type, +/-0.3 nH | Murata | LQG15HS1N0S02D |  |  | Coilcraft
L22 | L_2N0_0402_S | 1 | Inductor, 2n0, 0402, +/-0.3 nH | Murata | LQG15HS2N0S02D
L23 | L_0402 | 1 | Inductor, general, 0402; Do not mount
L101 | C_15P_0402_NP0_J_50 | 1 | Capacitor, 15p, 0402, NP0, 5%, 50V | Murata | GRM1555C1H150JZ01D
L102 | L_5N1_0402_S | 1 | Inductor, 5n1, 0402, +/-0.3 nH | Murata | LQG15HS5N1S02D |  |  | Coilcraft
L111 | L_1N5_0402_B_LQW | 1 | Inductor, 1n5, 0402, wire-wound type, +/-0.1 nH | Murata | LQW15AN1N5B00D
P1;P2 | SMD_SOCKET_2x10 | 2 | SMD pinrow socket, .050 spacing, 2x10 | Samtec | SFM-110-02-SM-D-A-K-TR | Abacus |  |  |  | Freber, AFU, Arrow
P3 | SMA_SMD | 1 | SMA connector, straight SMD-mount | Hus-Tsan Group Taiwan | SMA-10V21-TGG | EC Partner A/S | SMA-10V21-TGG | Vitelec | 142-0711-201 | AFU
R1 | R_330K_0402_F | 1 | Resistor, 330k ohms, 0402, ±1% | Koa | RK73H1ETTP3303F | ELFA | 60-492-58
R2;R3;R4;R8 | R_0_0402_3PORT_1-2 | 4 | Resistor 3 ports, 0 ohm, 0402, mounted between pad 1 and pad 2 | Koa | RK73Z1ETTP | ELFA | 60-470-05
R5;R6;R7 | R_1K0_0402_F | 3 | Resistor, 1k ohm, 0402, ±1% | Koa | RK73H1ETTP1001F | ELFA | 60-480-52
R11 | R_1M0_0402_F | 1 | Resistor, 1m0 ohm, 0402, ±1% | Koa | RK73H1ETTP1004F | ELFA | 60-494-98
R111 | R_3R3_0402_F | 1 | Resistor, 3.3 ohms, 0402, ±1% | Koa | RK73H1ETTP3R32F
R151 | R_4K3_0402_G | 1 | Resistor, 4k3 ohms, 0402, 2% | Koa | RK73H1ETTP4301F | ELFA | 60-483-59
R231 | R_56K_0402_F | 1 | Resistor, 56k ohms, 0402, ±1% | Koa | RK73H1ETTP5602F | ELFA | 60-488-96
R261 | R_0402 | 1 | Resistor, general, 0402; Do not mount
U1 | CC2520 | 1 | Single-chip transceiver | TI | CC2520 | TI | CC2520 |  |  |  |  | Yes
U2 | CC2591 | 1 | LNA and PA 20 dBm | TI | CC2591 | TI | CC2591
X1 | X_32.000/10/15/30/16 | 1 | Crystal, 32.000MHz, NX3225DA, 10/15ppm, 16 pF ! Temp range -30 - +85 deg C ! | NDK | NX3225SA | NDK France | NX3225SA 32 MHz EXS00A-02994
Total number of components |  | 49
