vedderb/rise_sdvp/Hardware/f9p_board/stp/DPR0010A.stp

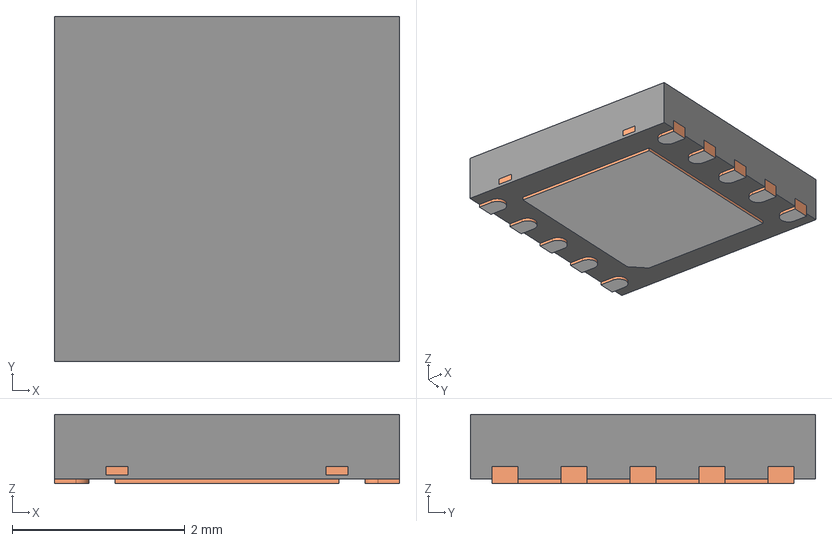
[picture p25: CAD file, 2019-11-06]
Hardware/f9p_board/stp/DPR0010A.stp
4.00 x 4.00 x 0.8 mm
BODY-SON
FRAME-AAA00XXA
PIN1-ID
