vedderb/rise_sdvp/Hardware/f9p_board/stp/PowerDI5.stp

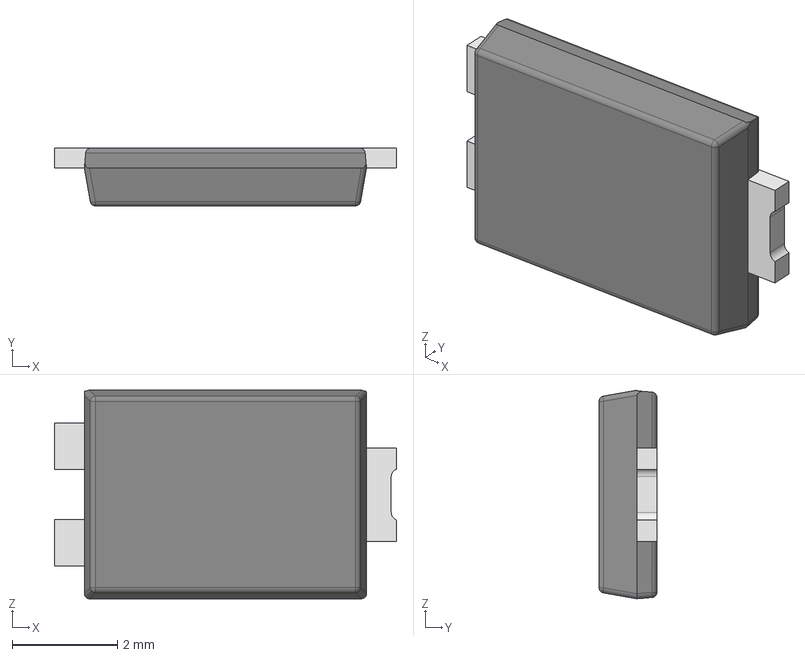
[picture p26: CAD file, 2019-11-06]
Hardware/f9p_board/stp/PowerDI5.stp
6.51 x 1.10 x 3.97 mm
PD-5 compound
PD-5 LF_0
PD-5 LF
