vedderb/rise_sdvp/Hardware/f9p_board/stp/STEP-WE-PD-1210-rev1.stp

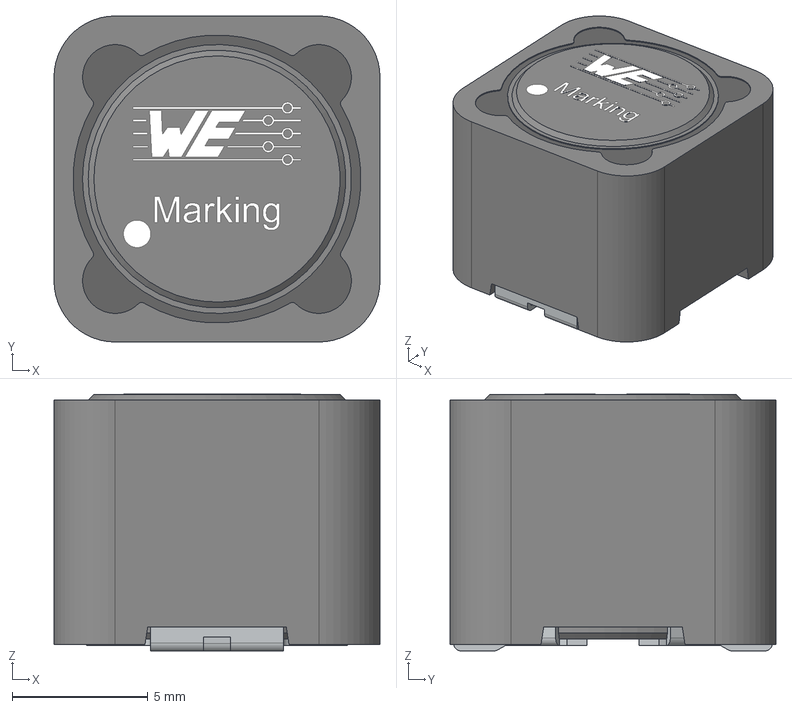
[picture p27: CAD file, 2019-11-06]
Hardware/f9p_board/stp/STEP-WE-PD-1210-rev1.stp
12.0 x 12.0 x 9.46 mm
Core
ShieldRing
Glue
Leadframe
