vedderb/rise_sdvp/Hardware/f9p_board/stp/ABM3C.STEP

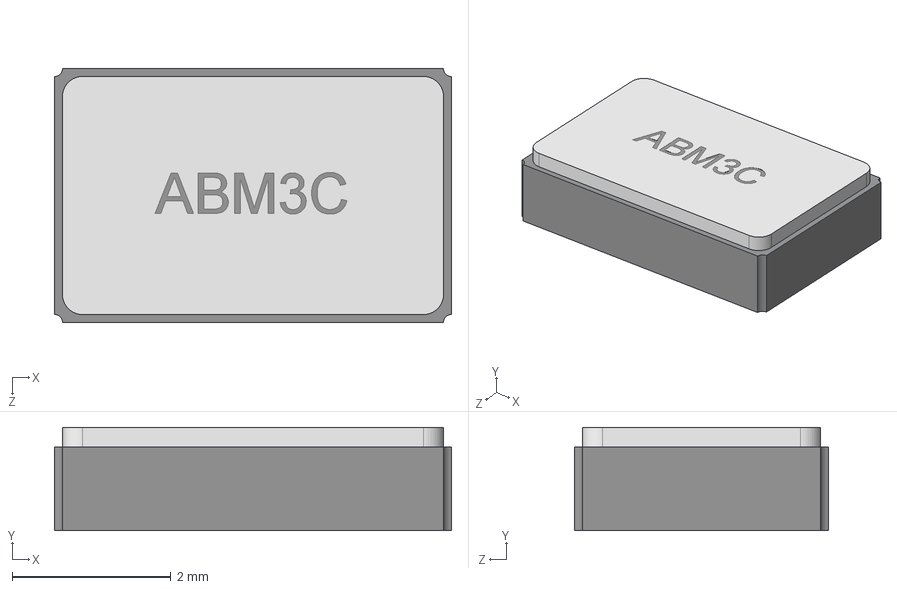
[picture p28: CAD file, 2019-11-06]
Hardware/f9p_board/stp/ABM3C.STEP
5.00 x 1.30 x 3.20 mm
