vedderb/rise_sdvp/Hardware/f9p_board/stp/734120110.stp

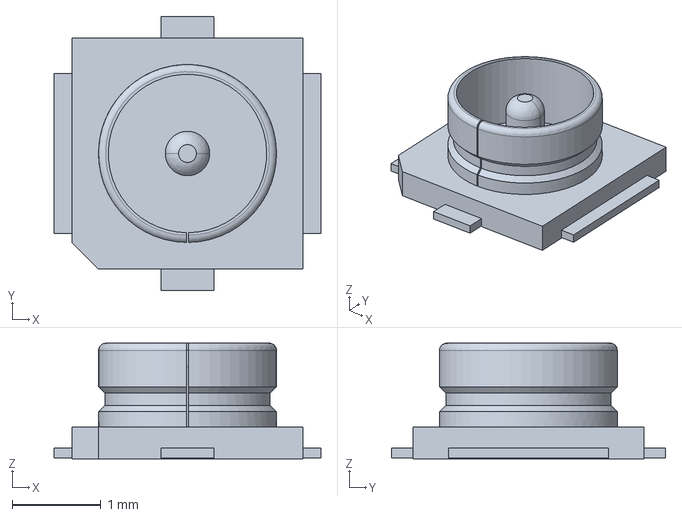
[picture p29: CAD file, 2019-11-06]
Hardware/f9p_board/stp/734120110.stp
3.00 x 3.08 x 1.30 mm
