vedderb/rise_sdvp/Hardware/uwb_pcb/cad/case.FCStd

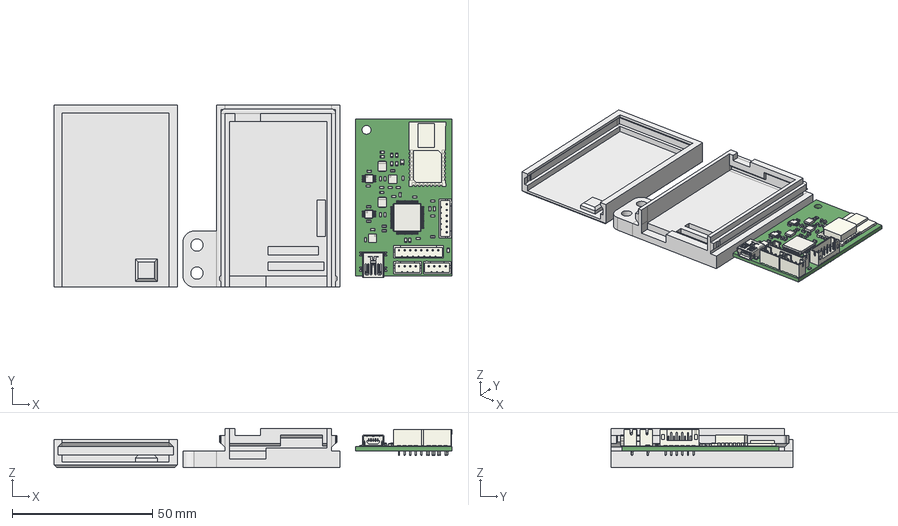
[picture p30: CAD file, 2019-09-25, an earlier design]
Hardware/uwb_pcb/cad/case.FCStd
142.0 x 65.0 x 14.0 mm
Base
Cover
