vedderb/rise_sdvp/Hardware/uwb_pcb/cad/base.stl

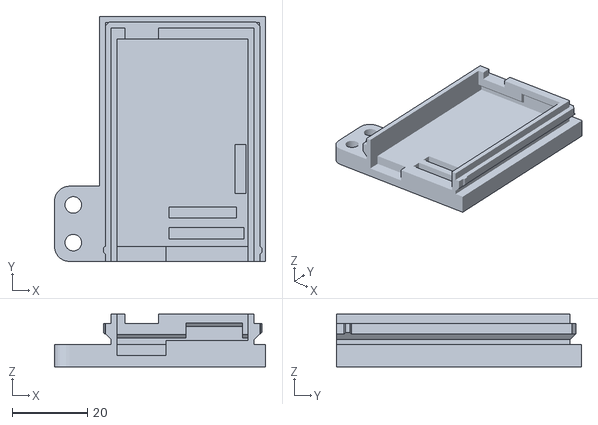
[picture p31: CAD file, 2019-09-25, an earlier design]
Hardware/uwb_pcb/cad/base.stl
56.0 x 65.0 x 14.0
