vedderb/rise_sdvp/Hardware/uwb_pcb/cad/cover.stl

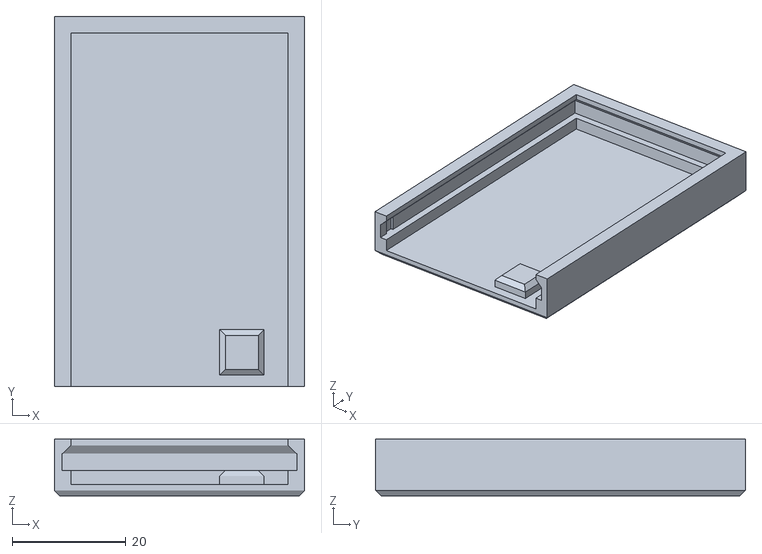
[picture p32: CAD file, 2019-09-25, an earlier design]
Hardware/uwb_pcb/cad/cover.stl
44.0 x 65.0 x 10.0
