vedderb/rise_sdvp/(list of files, cad)

Other CAD files:
Linux/RC_Car_Tool/Models/quadrotor.blend
Linux/RControlStation/Models/car.blend
Linux/RControlStation/Models/quadrotor.blend
