vedderb/rise_sdvp/Hardware/Controller/Plot/plot_all.pdf

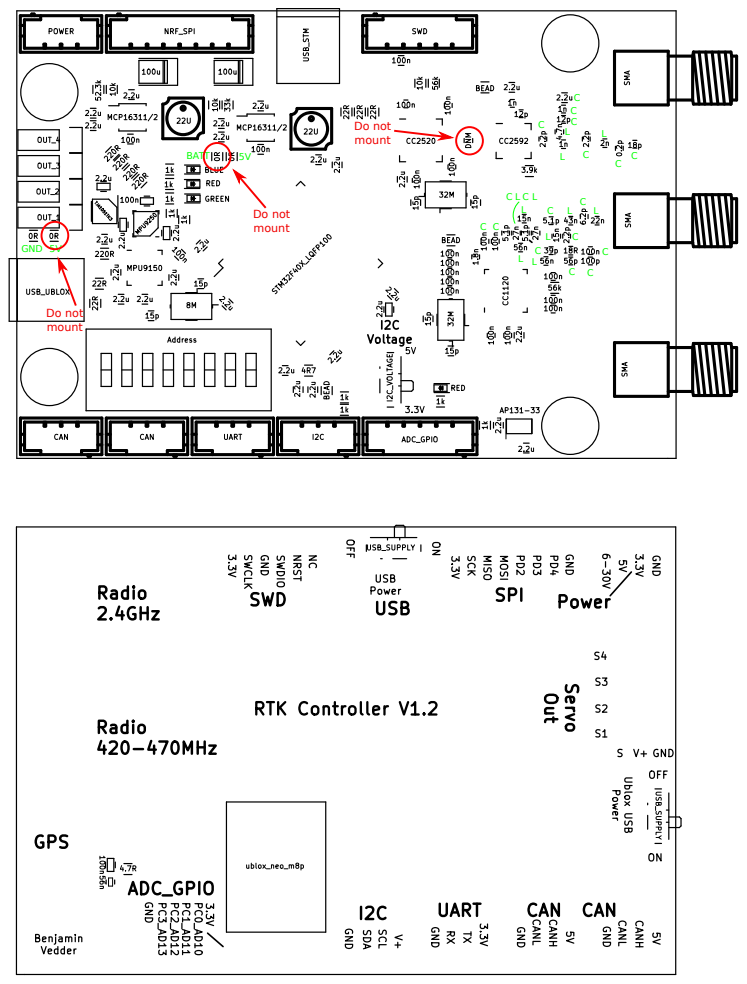
[picture p33: page 1]
BATT; GND 5V; Do not mount; CCC; LCL
