vedderb/rise_sdvp/Hardware/Controller/Plot/RCCAR_IF_Board_GPS.pdf

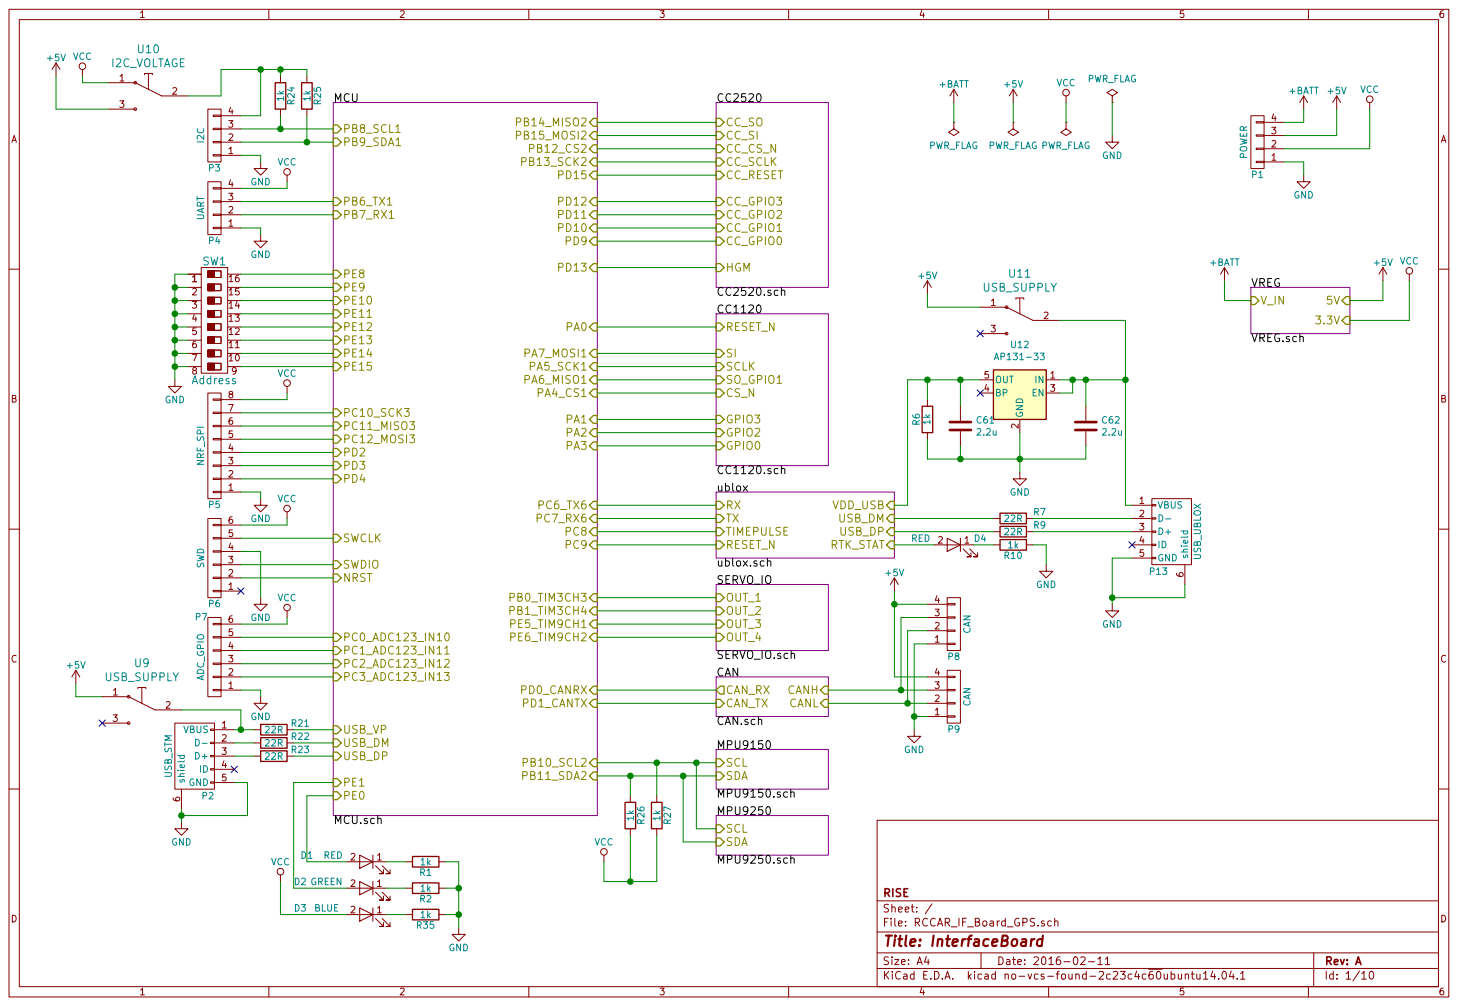
[picture p34: page 1]

5 | 12
6 | 11
7 | 10

2 EN 3 BP 4 OUT 5 U12 AP131-33 GND

6 P6 SWD 4

File: RCCAR_IF_Board_GPS.sch Sheet: / RISE

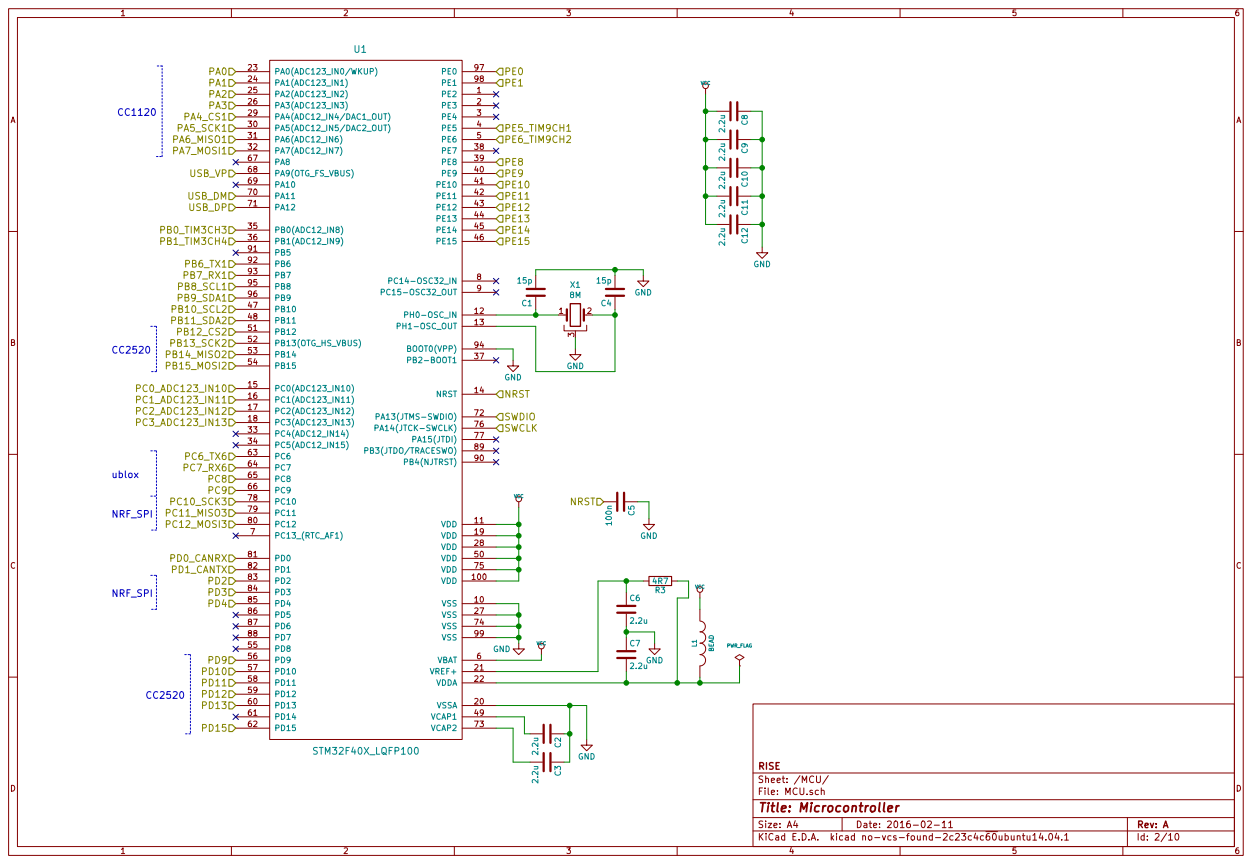
[picture p35: page 2]

Id: 2/10 Title: Microcontroller File: MCU.sch Sheet: /MCU/ RISE

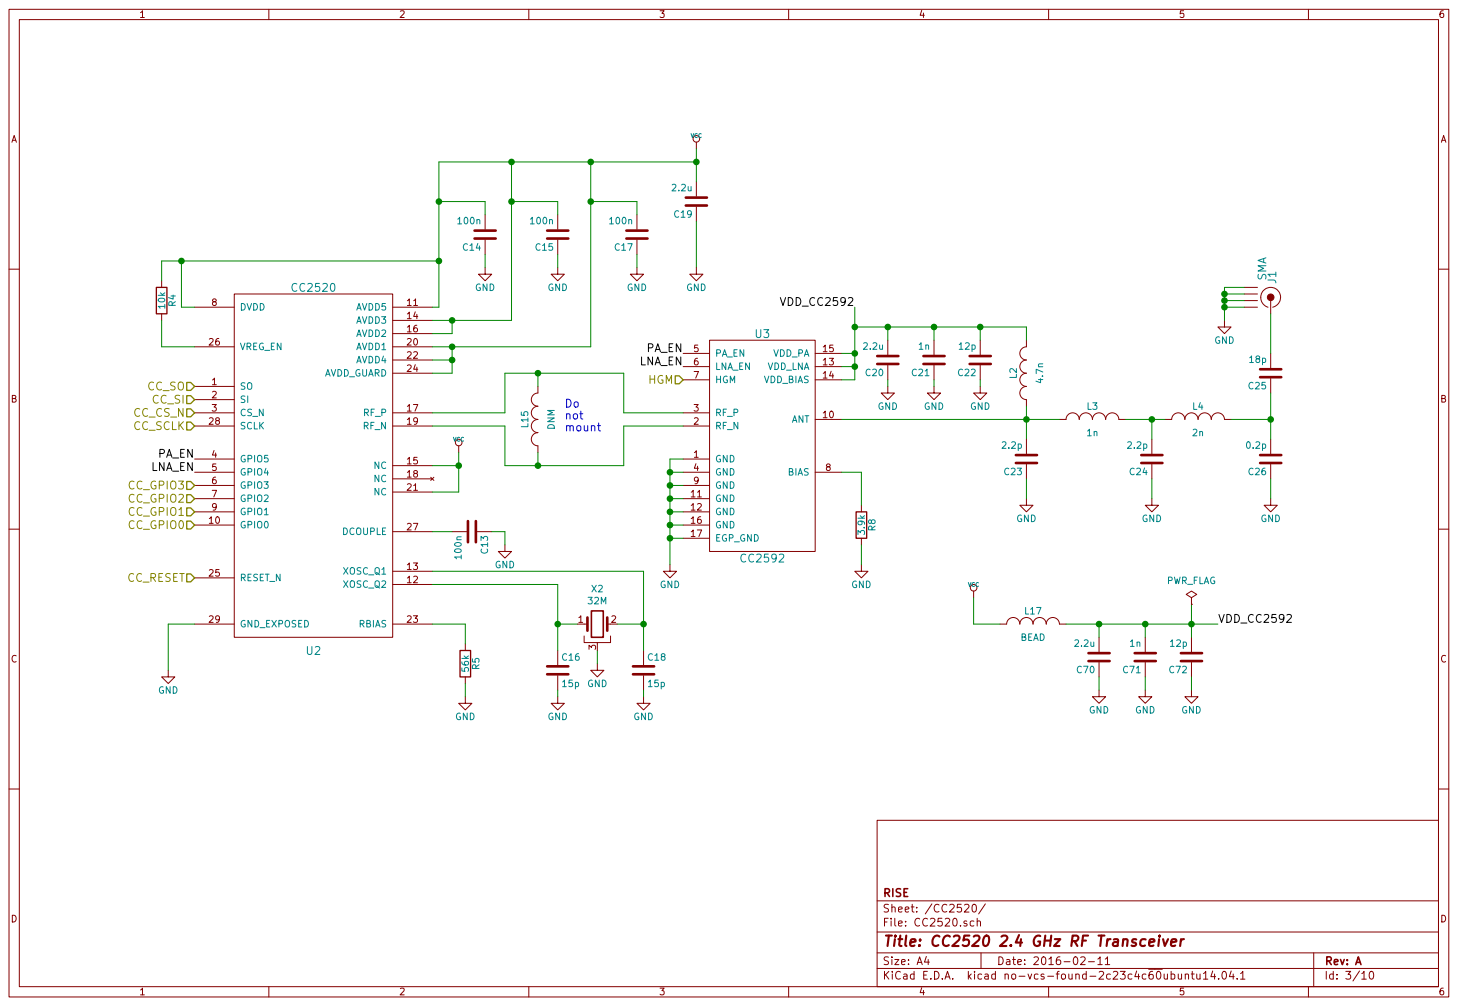
[picture p36: page 3]

Id: 3/10 Title: CC2520 2.4 GHz RF Transceiver File: CC2520.sch Sheet: /CC2520/ RISE

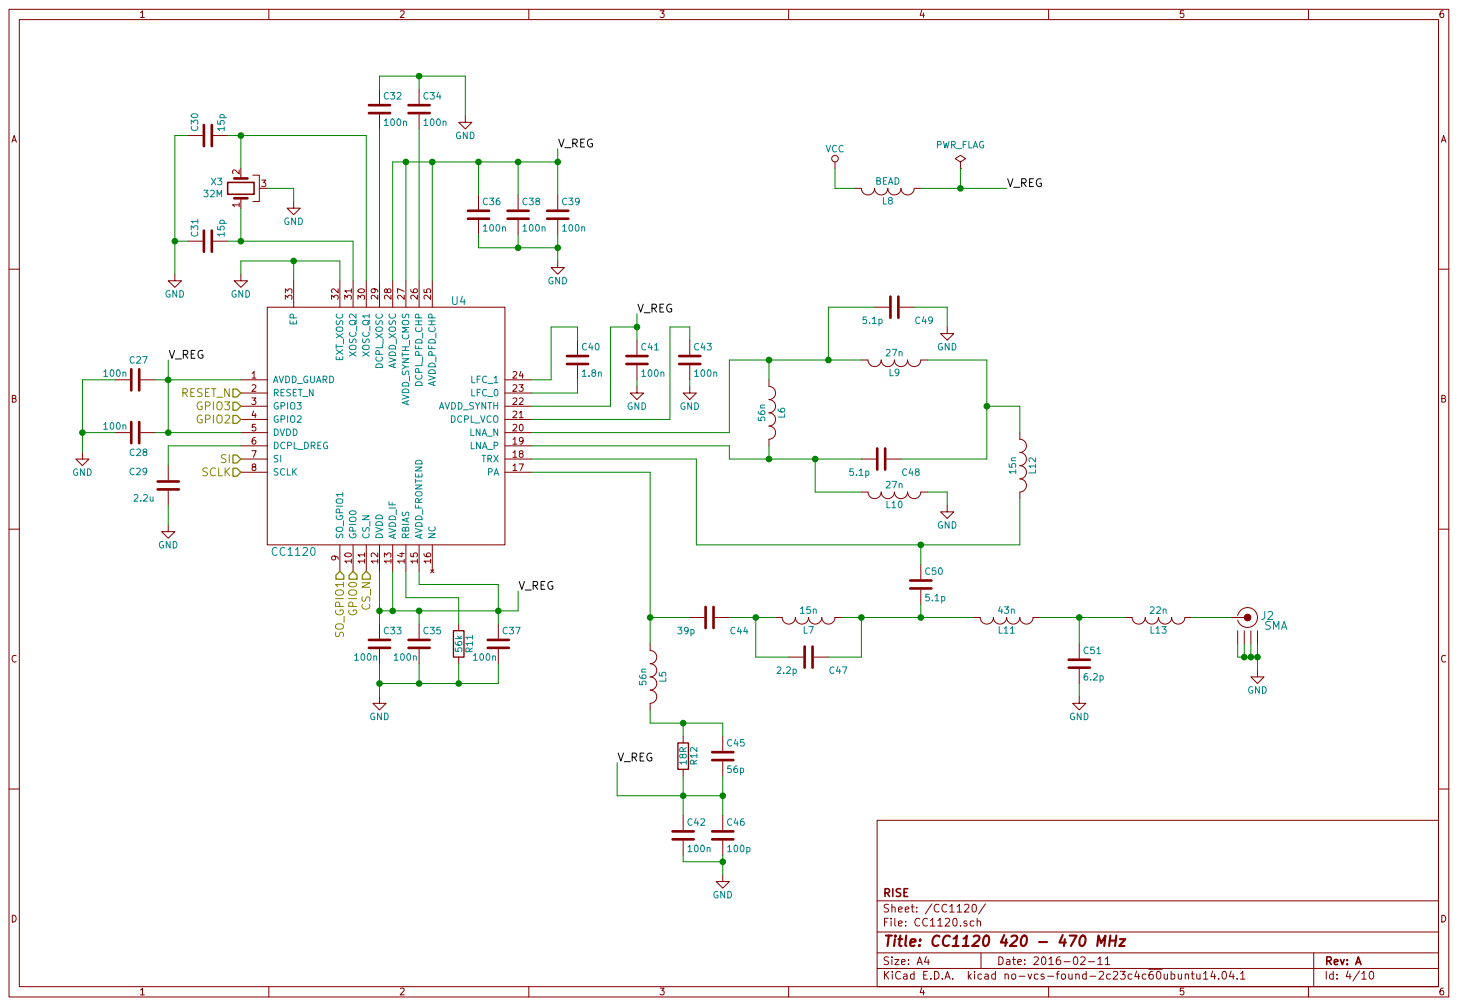
[picture p37: page 4]

File: CC1120.sch Sheet: /CC1120/ RISE

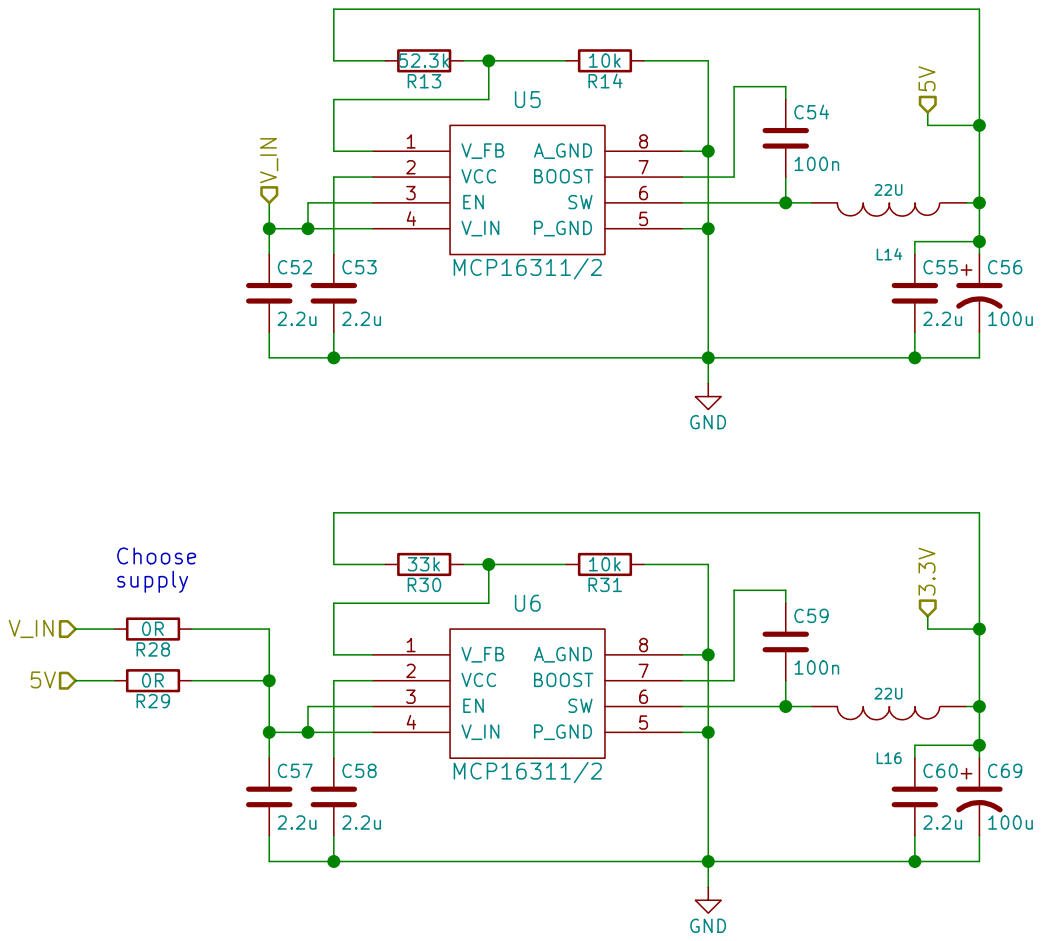
[picture p38: page 5]

File: VREG.sch Sheet: /VREG/ RISE

Id: 5/10 Title: Voltage regulators

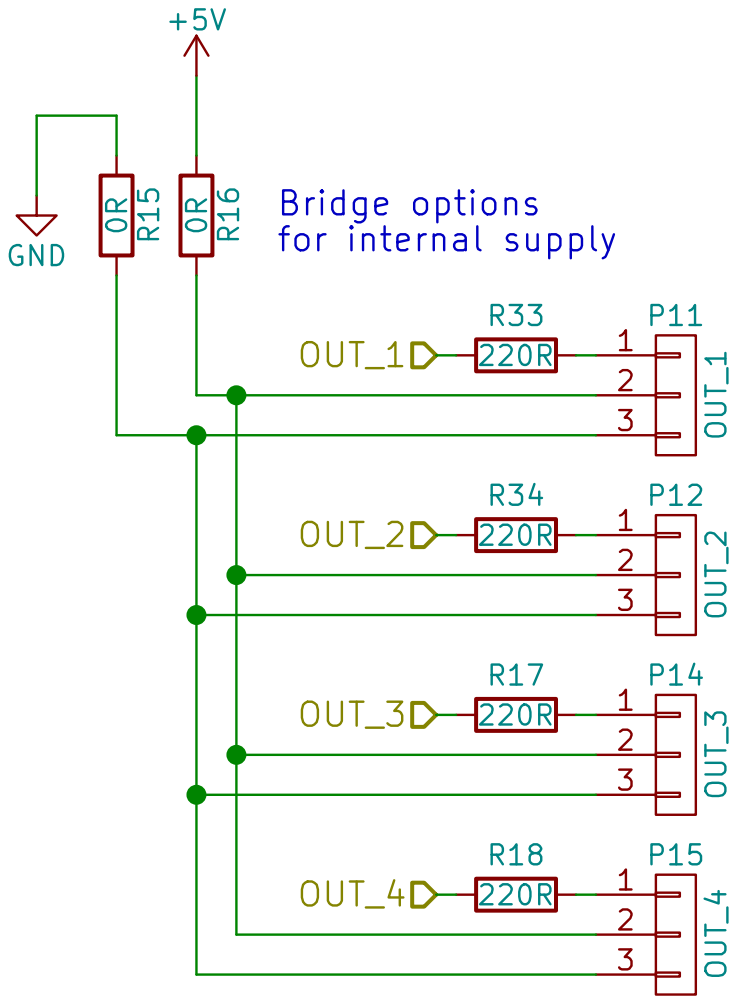
[picture p39: page 6]

File: SERVO_IO.sch
Id: 6/10 Title: Servo IO

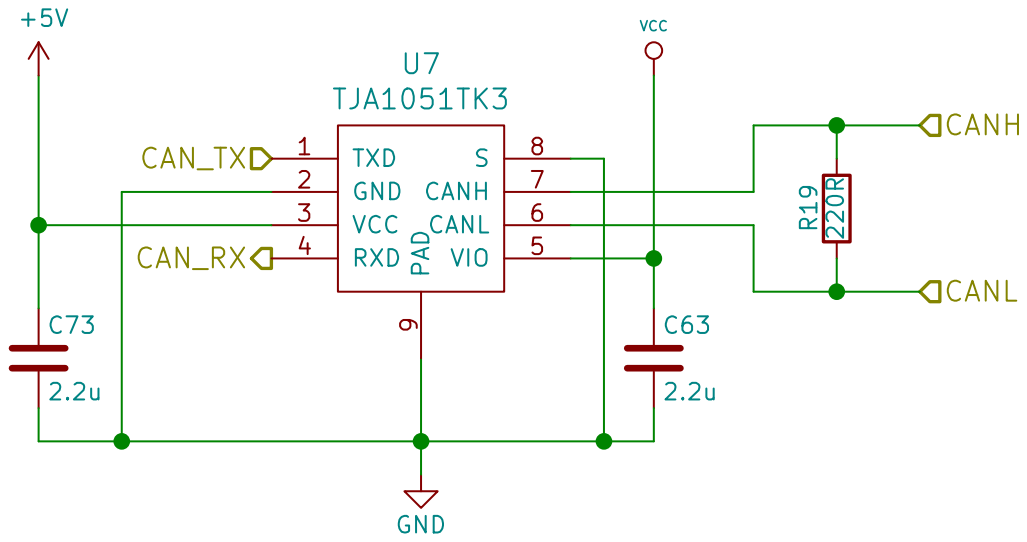
[picture p40: page 7]

Id: 7/10 Title: CAN Transceiver File: CAN.sch Sheet: /CAN/ RISE

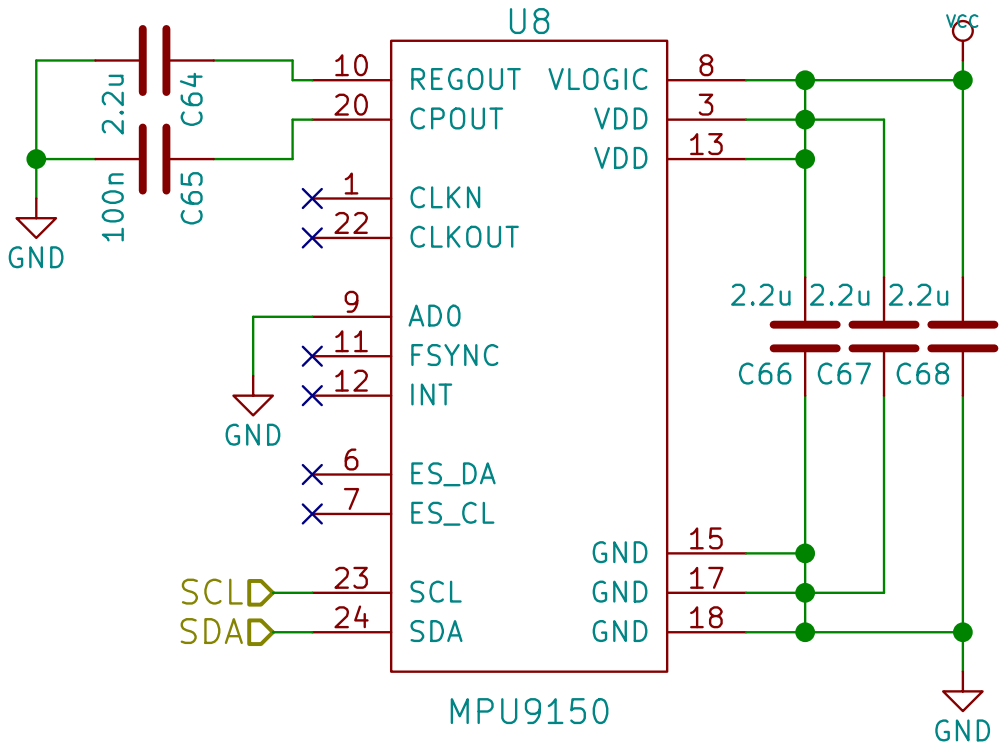
[picture p41: page 8]

File: MPU9150.sch Sheet: /MPU9150/ RISE

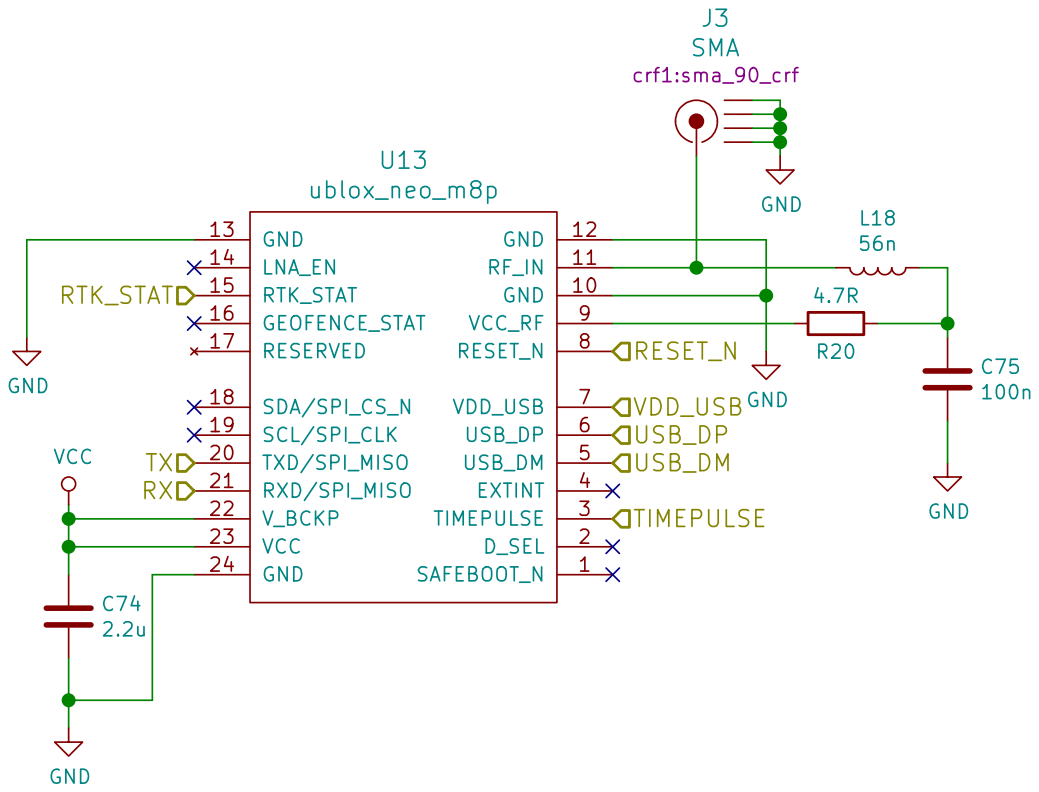
[picture p42: page 9]

File: ublox.sch Sheet: /ublox/ RISE

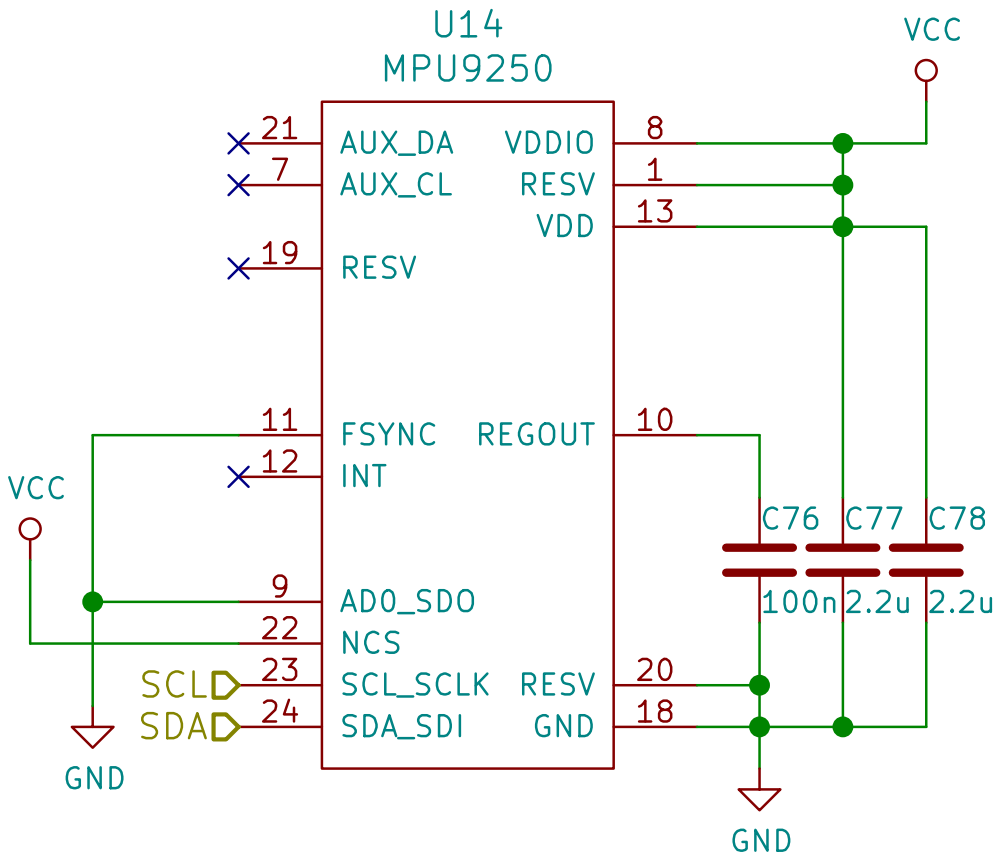
[picture p43: page 10]

Id: 10/10 Title: File: MPU9250.sch Sheet: /MPU9250/ RISE
