vedderb/rise_sdvp/Hardware/RFMote_PA/Images/RFMote_PA.pdf

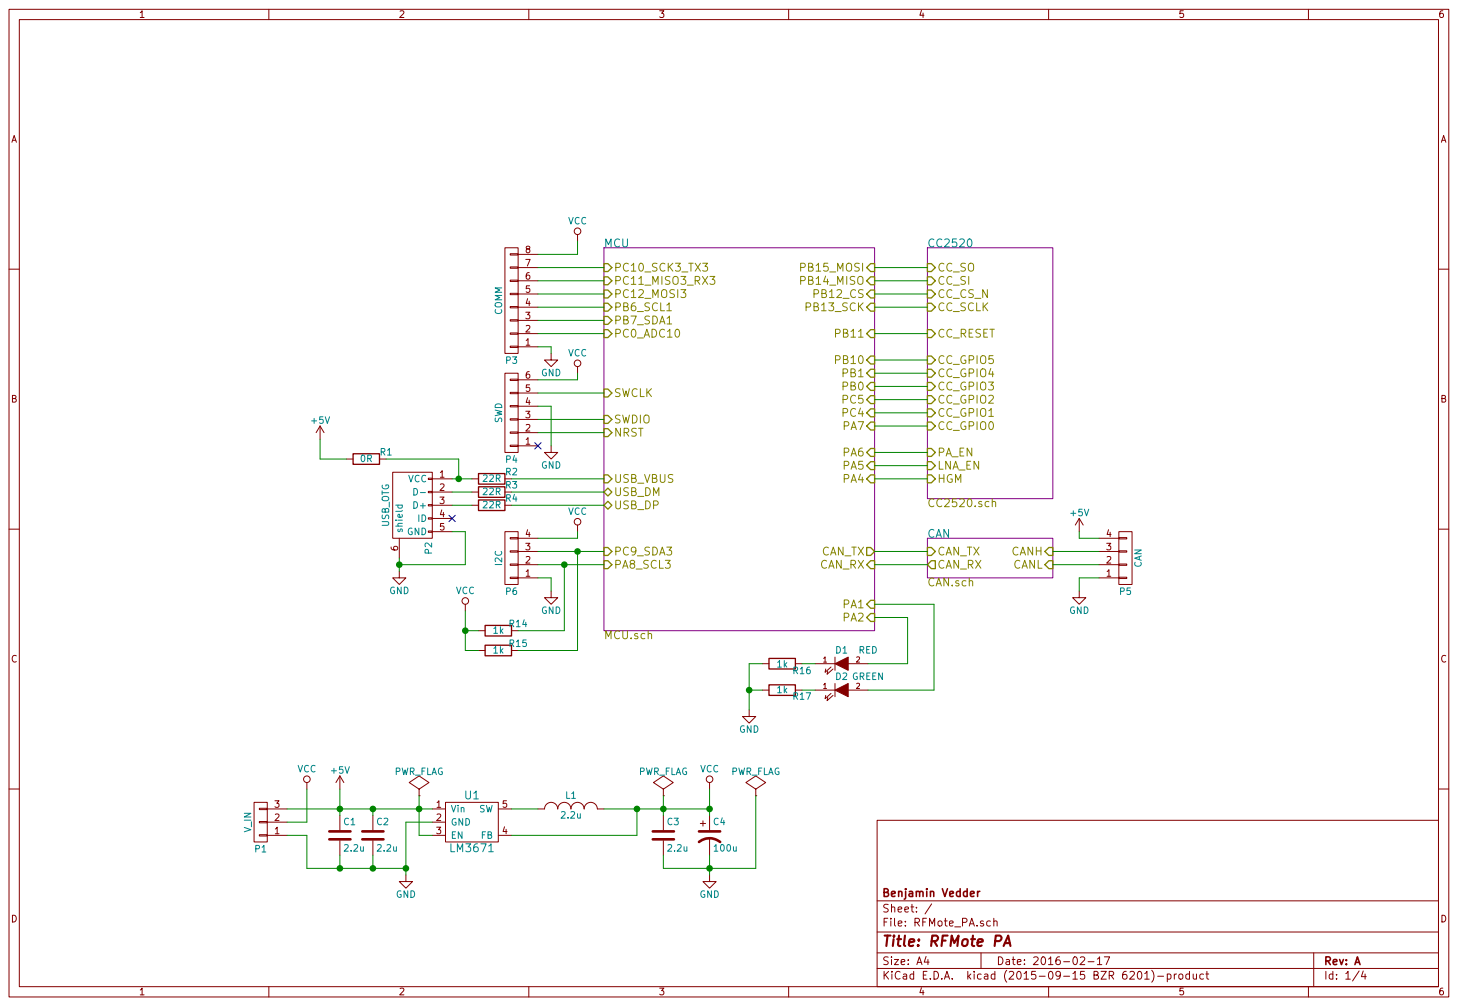
[picture p44: page 1]

6 P4 SWD 4

File: RFMote_PA.sch Sheet: / Benjamin Vedder

Id: 1/4 Title: RFMote PA

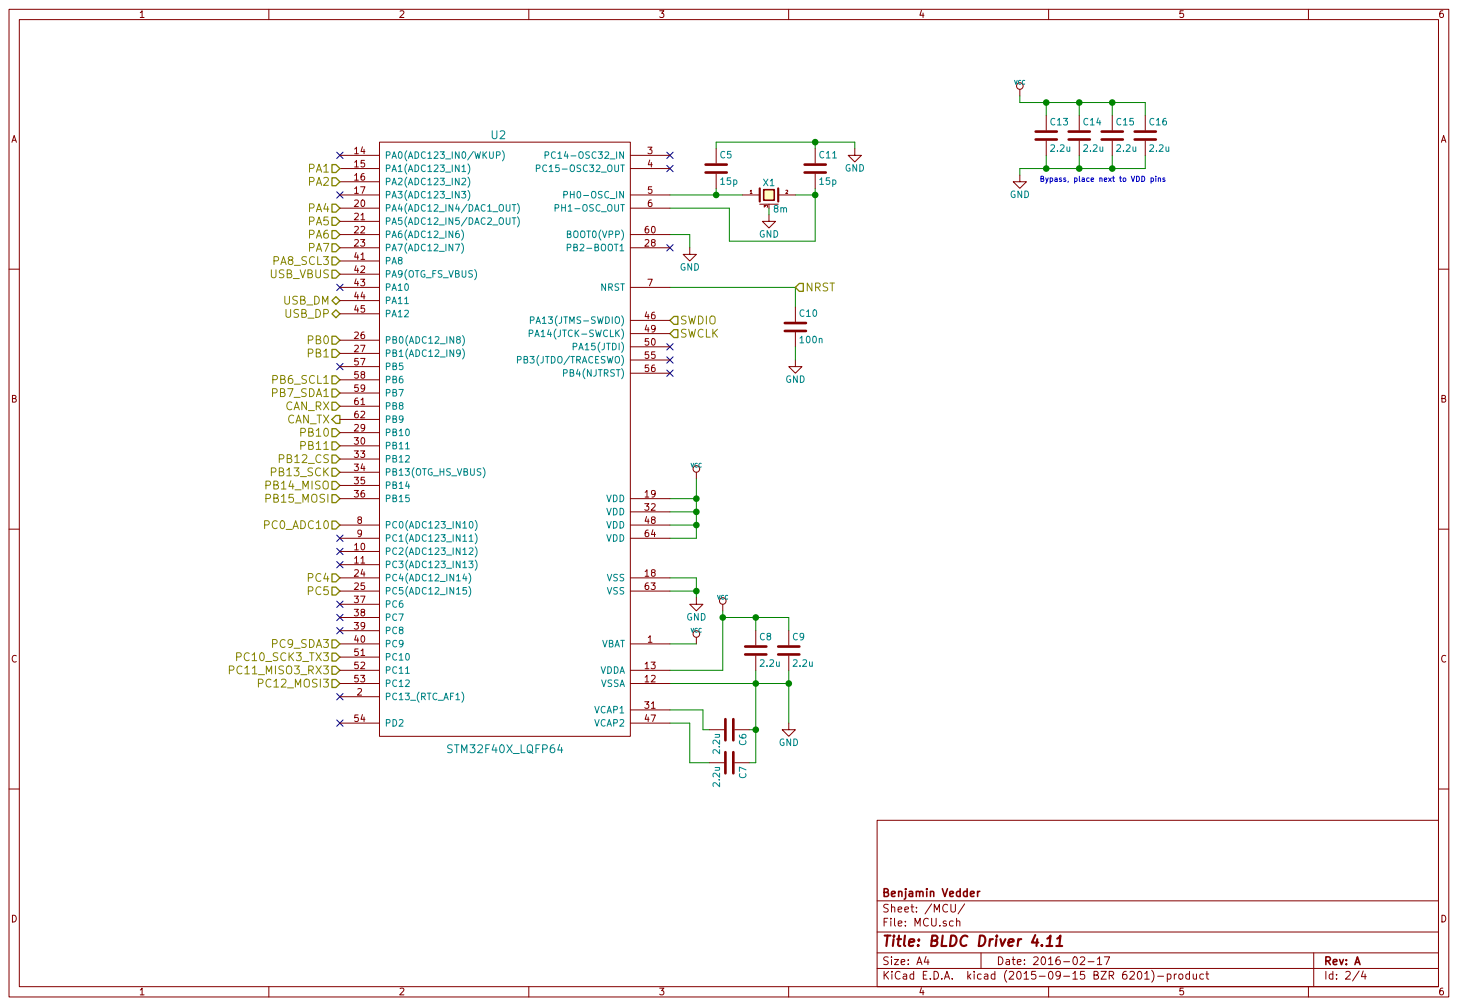
[picture p45: page 2]

2.2u USB_VBUS
PA8_SCL3 PA1 PA2
Bypass, place next to VDD pins CAN_RX

File: MCU.sch Sheet: /MCU/ Benjamin Vedder

Id: 2/4 Title: BLDC Driver 4.11

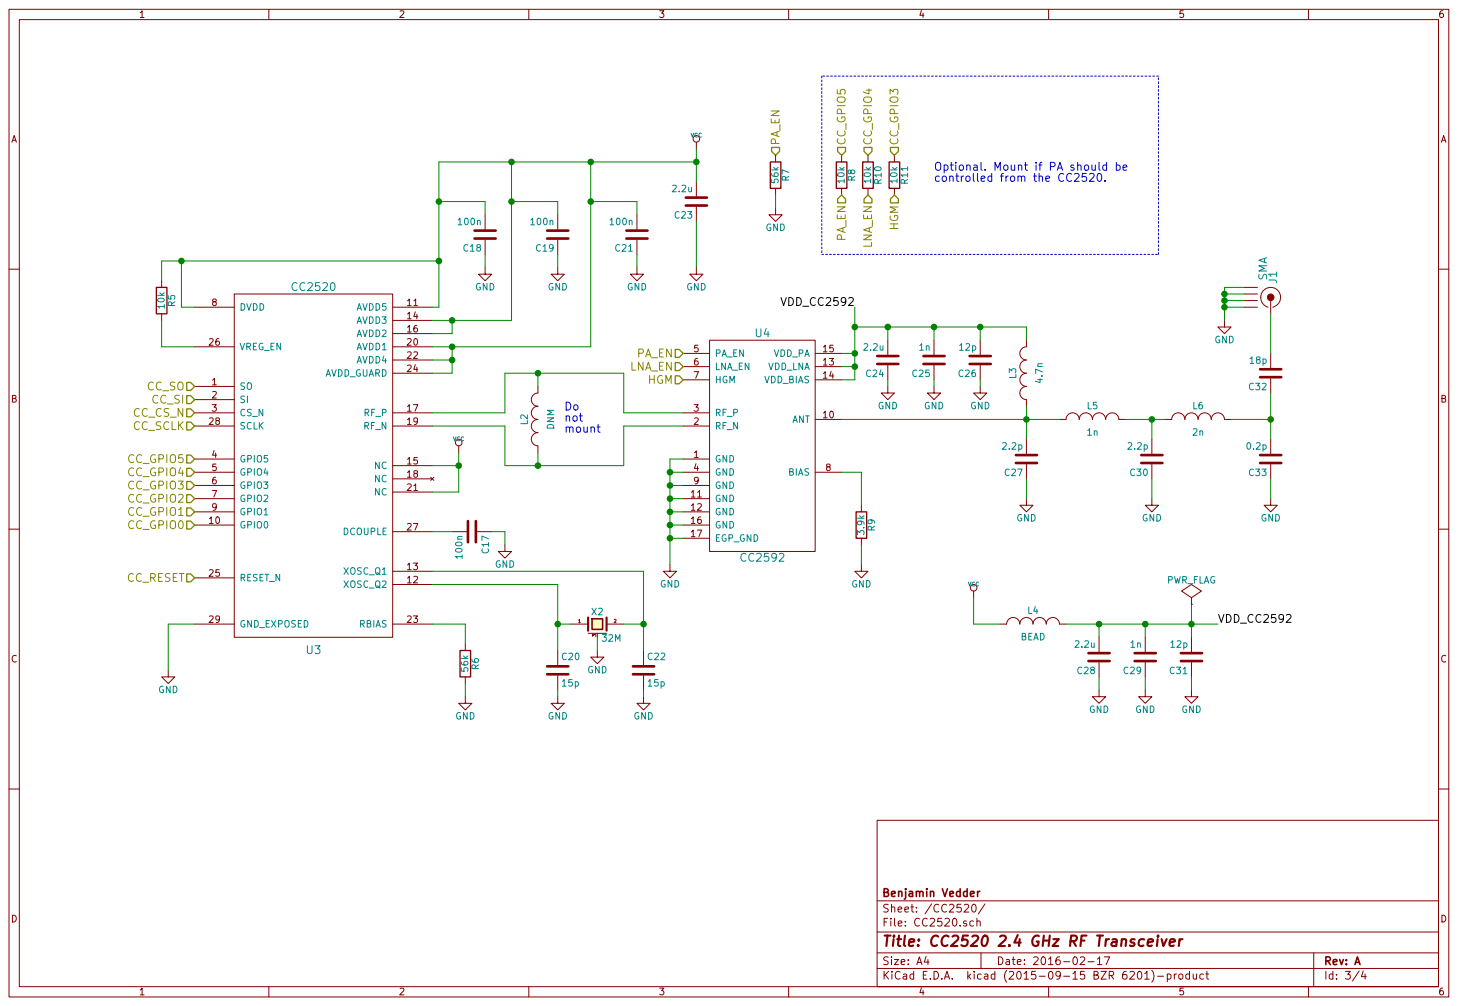
[picture p46: page 3]

controlled from the CC2520. PA_EN 56k R7 GND

Optional. Mount if PA should be

Id: 3/4 Title: CC2520 2.4 GHz RF Transceiver File: CC2520.sch Sheet: /CC2520/ Benjamin Vedder

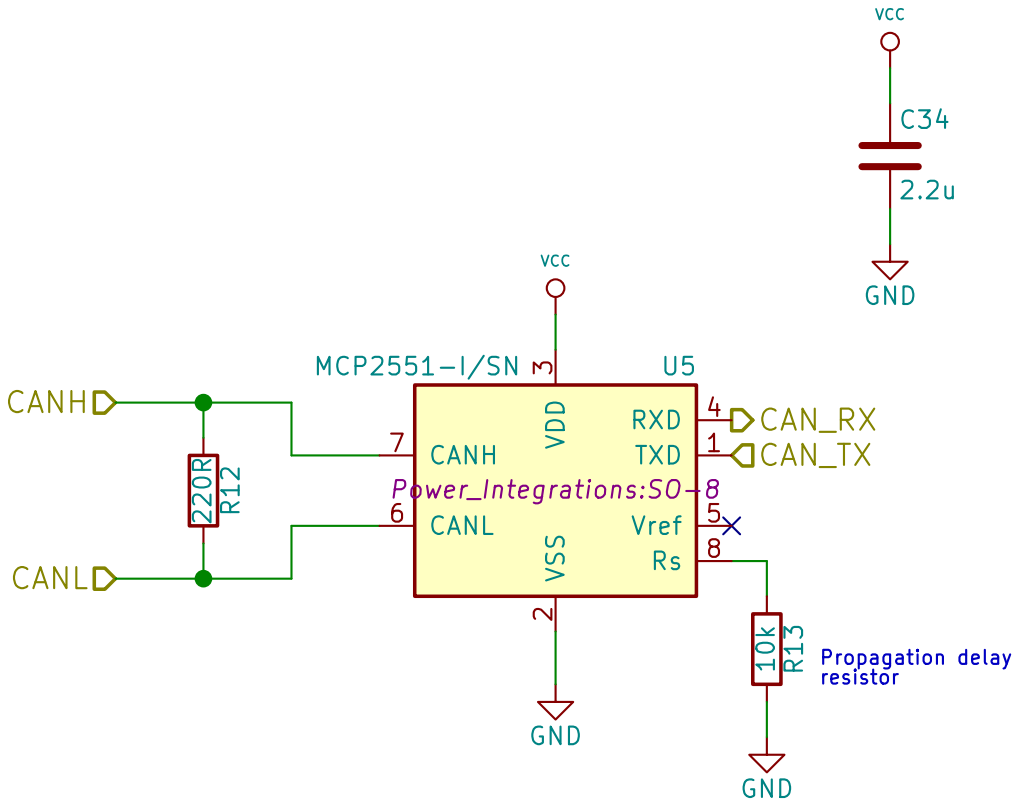
[picture p47: page 4]

3 RXD 4 Vref 5 CANL 6 CANH 7 Rs 8 MCP2551-I/SN U5 Power_Integrations:SO-8

Id: 4/4 Title: CAN Transceiver File: CAN.sch Sheet: /CAN/ Benjamin Vedder
