vedderb/rise_sdvp/Misc/Test Data/Automated_testing_2019/data_1/fi_01_zoom.pdf

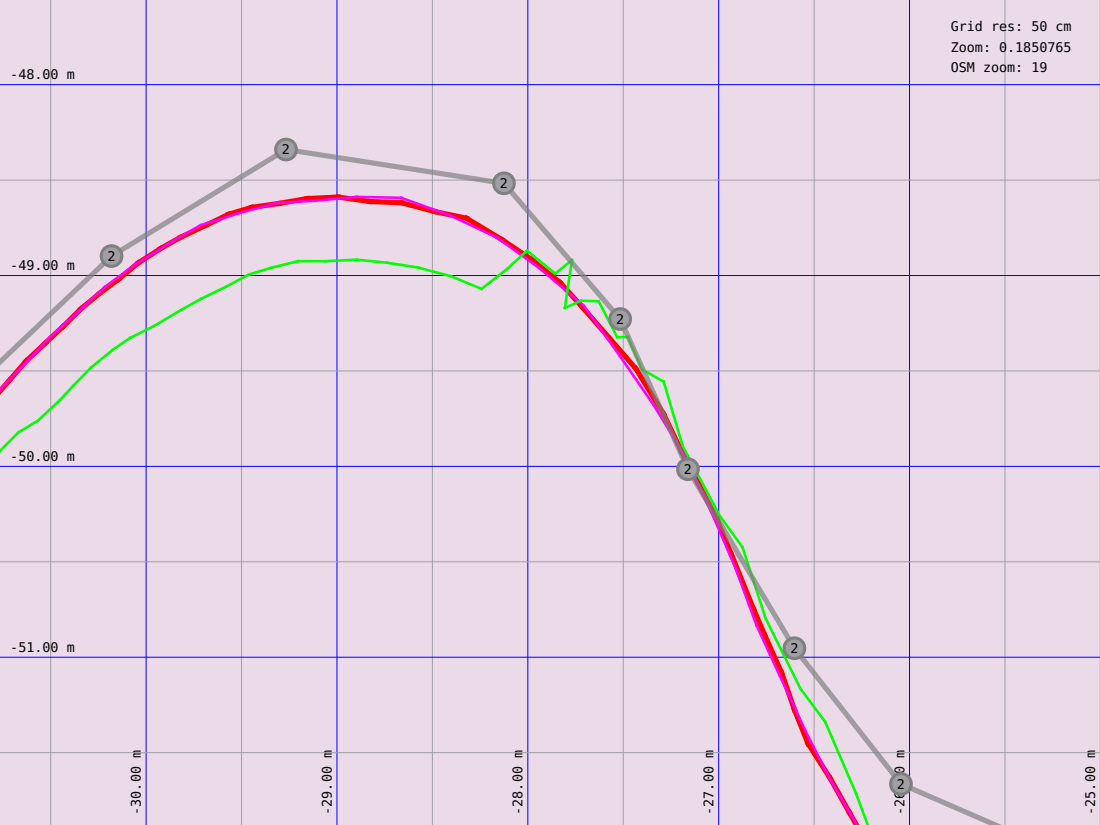
[picture p48: page 1]

Grid res: 50 cm
Zoom: 0.1850765
OSM zoom: 19
