vedderb/rise_sdvp/Misc/Test Data/Automated_testing_2019/data_1/fi_04_zoom.pdf

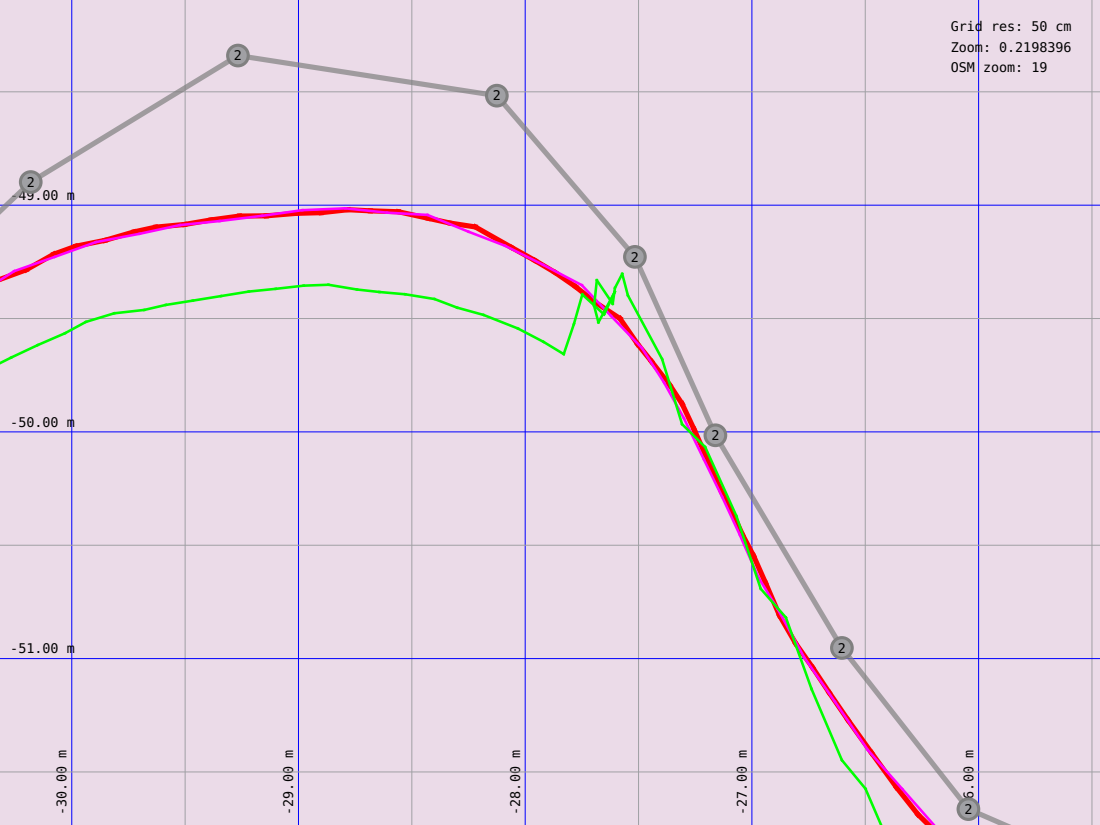
[picture p49: page 1]
OSM; zoom: 19

Grid res: 50 cm
Zoom: 0.2198396
