vedderb/rise_sdvp/Misc/Test Data/paper_2018-06/plots/ap_comp_0.8.pdf

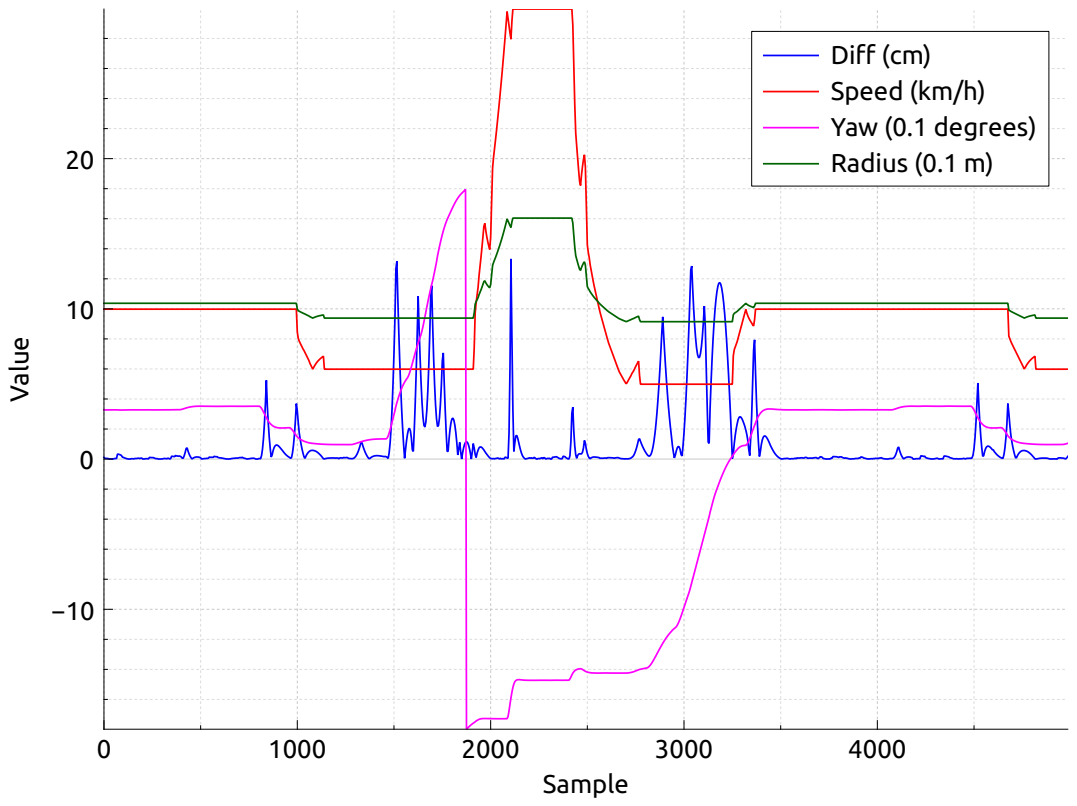
[picture p51: page 1]
Sample; alu; Diff (cm) Speed (km/h) Yaw (0.1 degrees) Radius (0.1 m)
