vedderb/rise_sdvp/Misc/Test Data/paper_2018-06/plots/delay.pdf

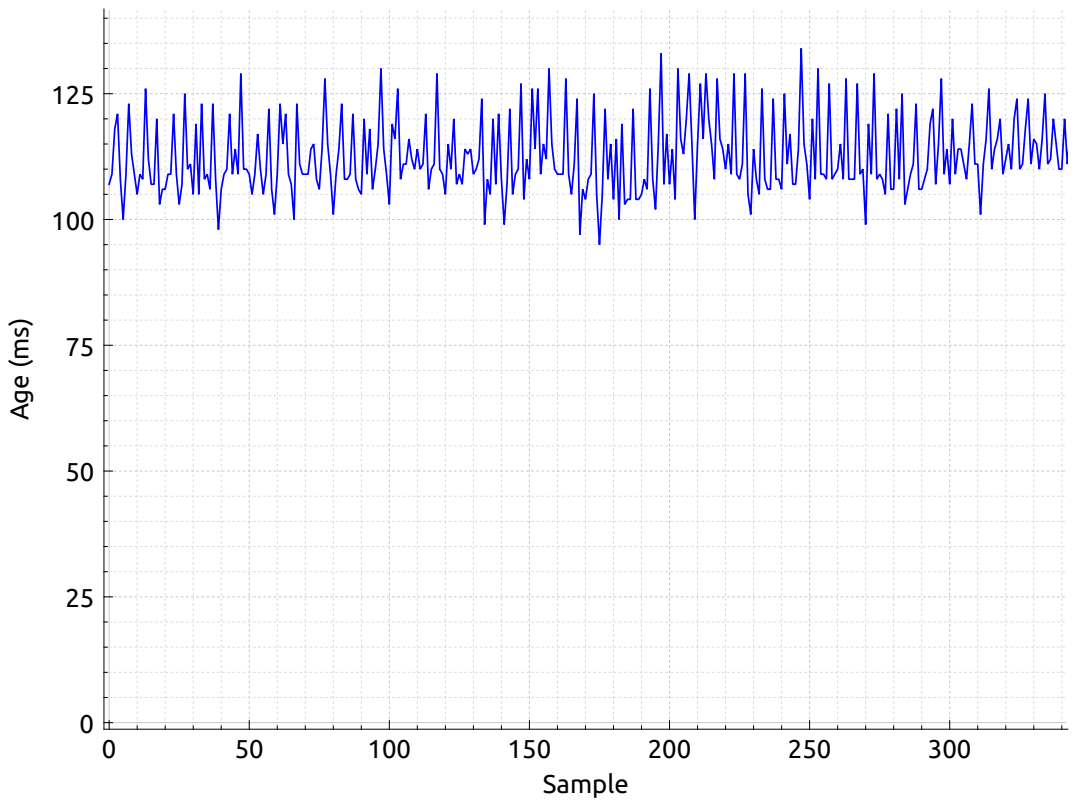
[picture p53: page 1]
Sample
