vedderb/rise_sdvp/Hardware/f9p_board/plot/all.pdf

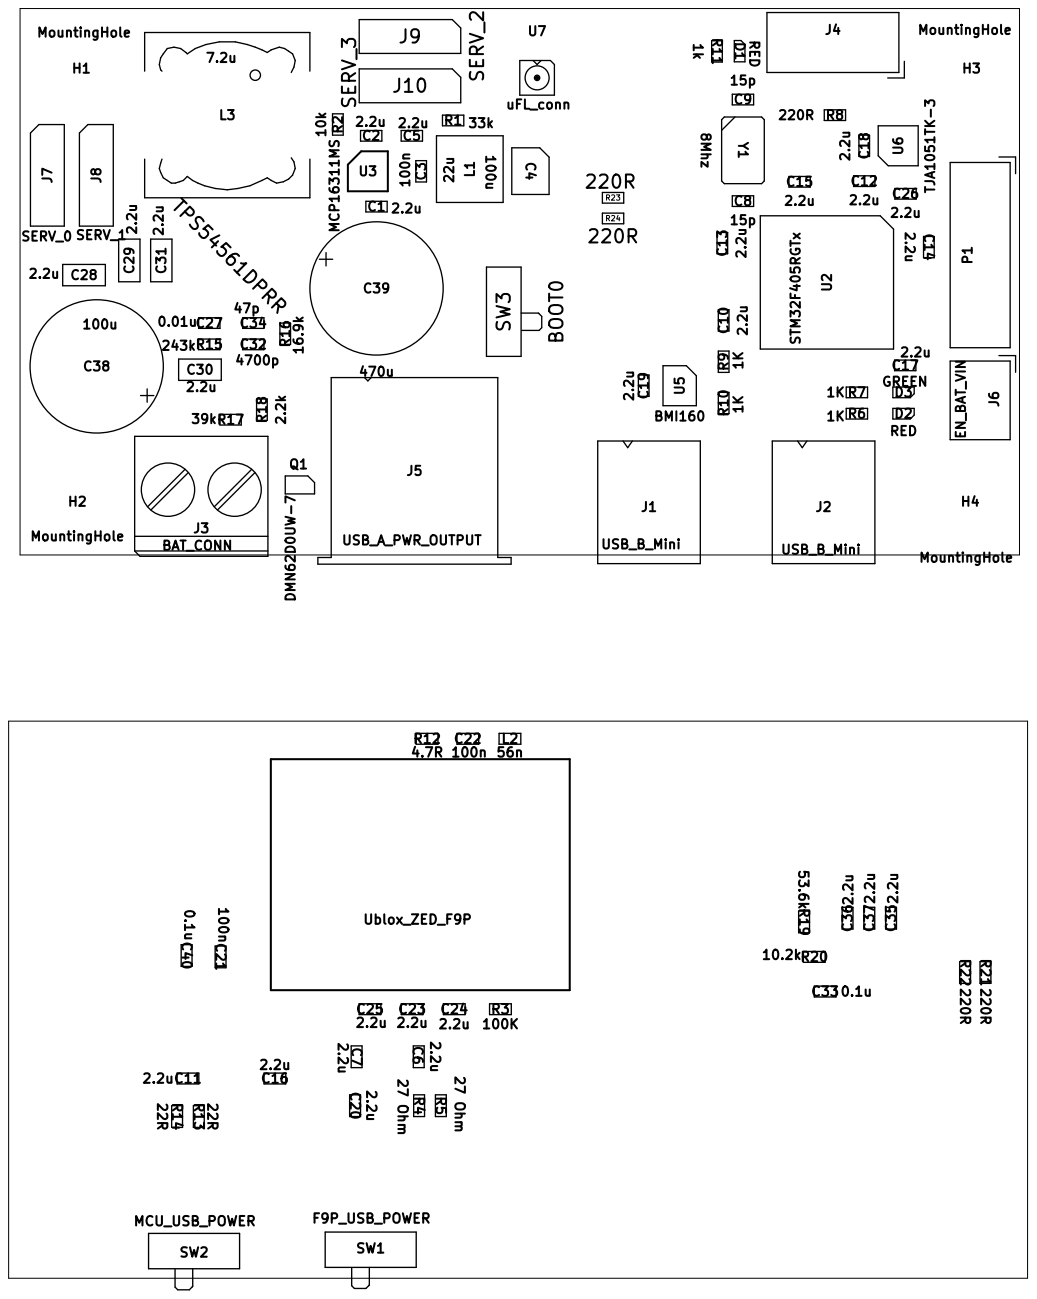
[picture p54: page 1]
