vedderb/rise_sdvp/Misc/Test Data/uwb_2018-06-14/uwb_test.pdf

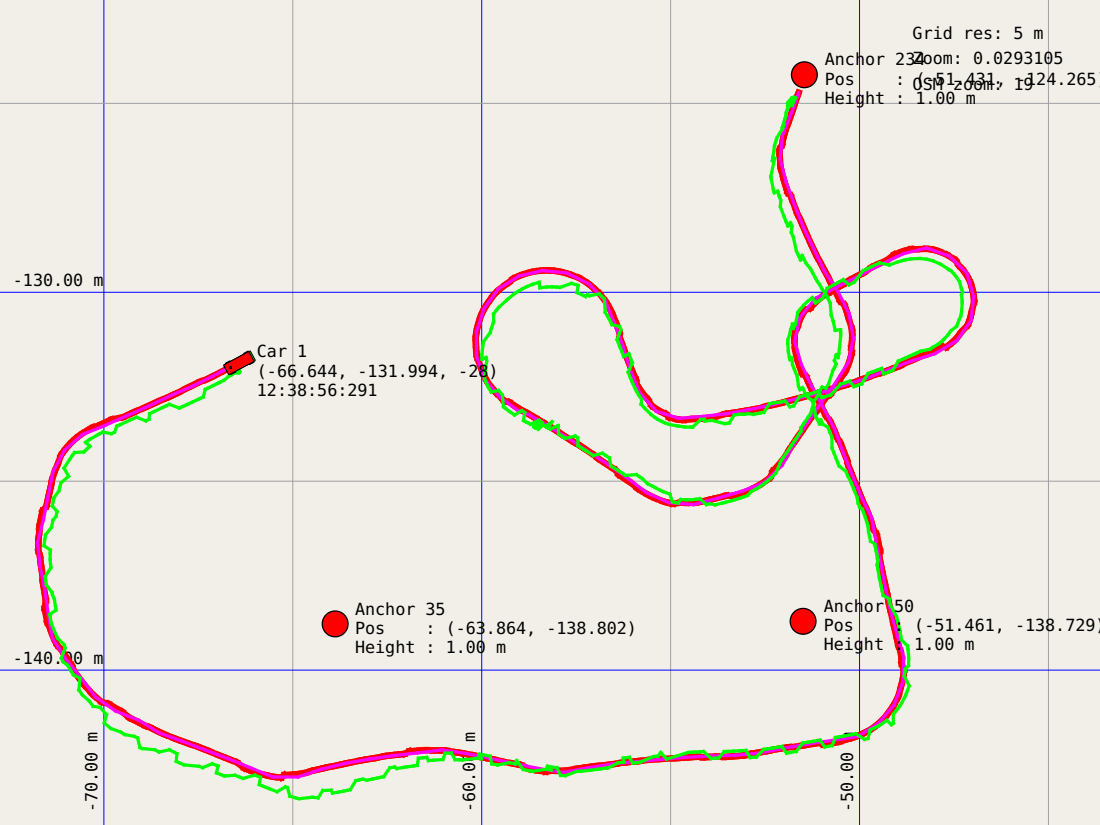
[picture p55: page 1]
Car; Anchor 50; Pos; Height : 1.00 m; Anchor 234; Anchor 35; Grid res: 5 m Zoom: 0.0293105 OSM zoom: 19
