vedderb/rise_sdvp/Hardware/RFMote_PA/Images/Values.pdf

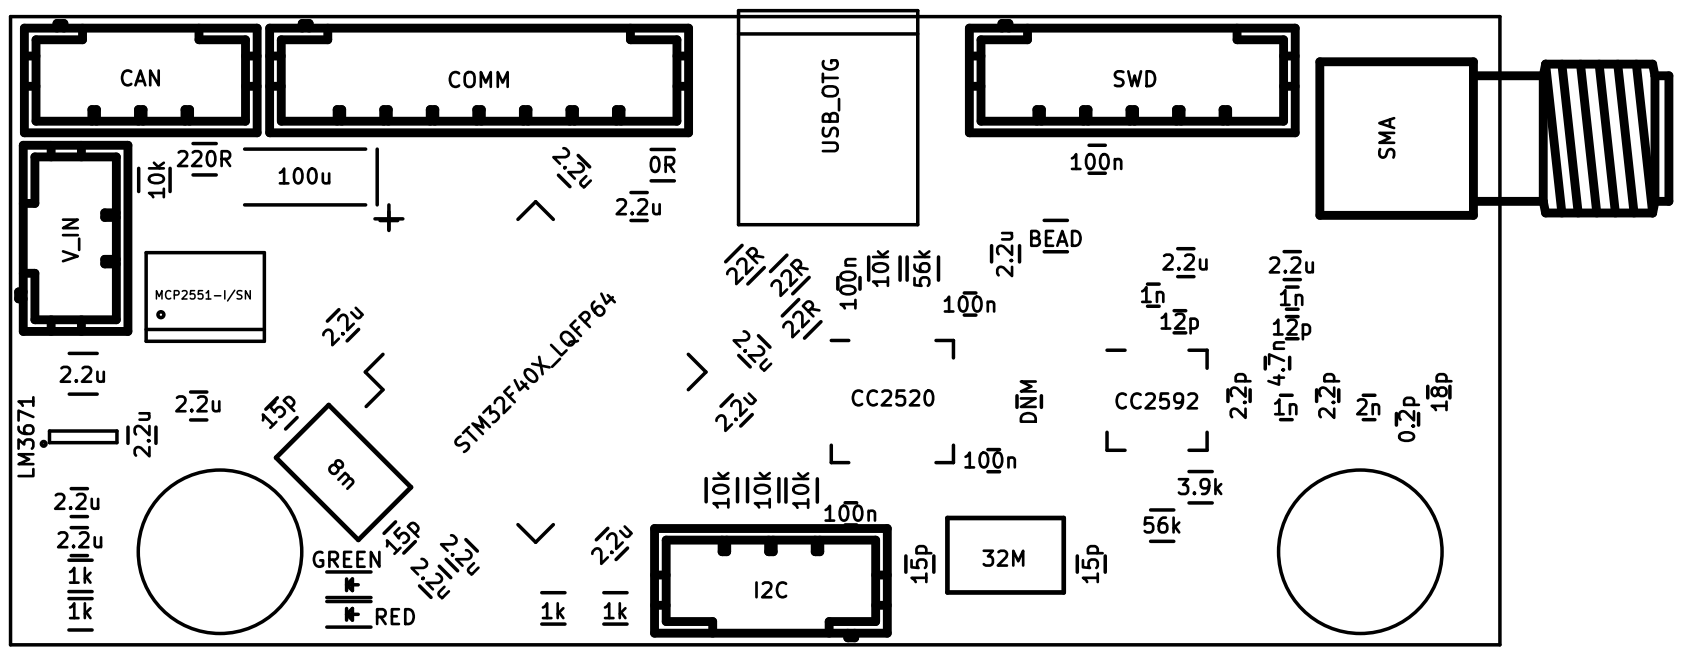
[picture p56: page 1]
