vedderb/rise_sdvp/Misc/Test Data/Automated_testing_2019/data_2/test_01.pdf

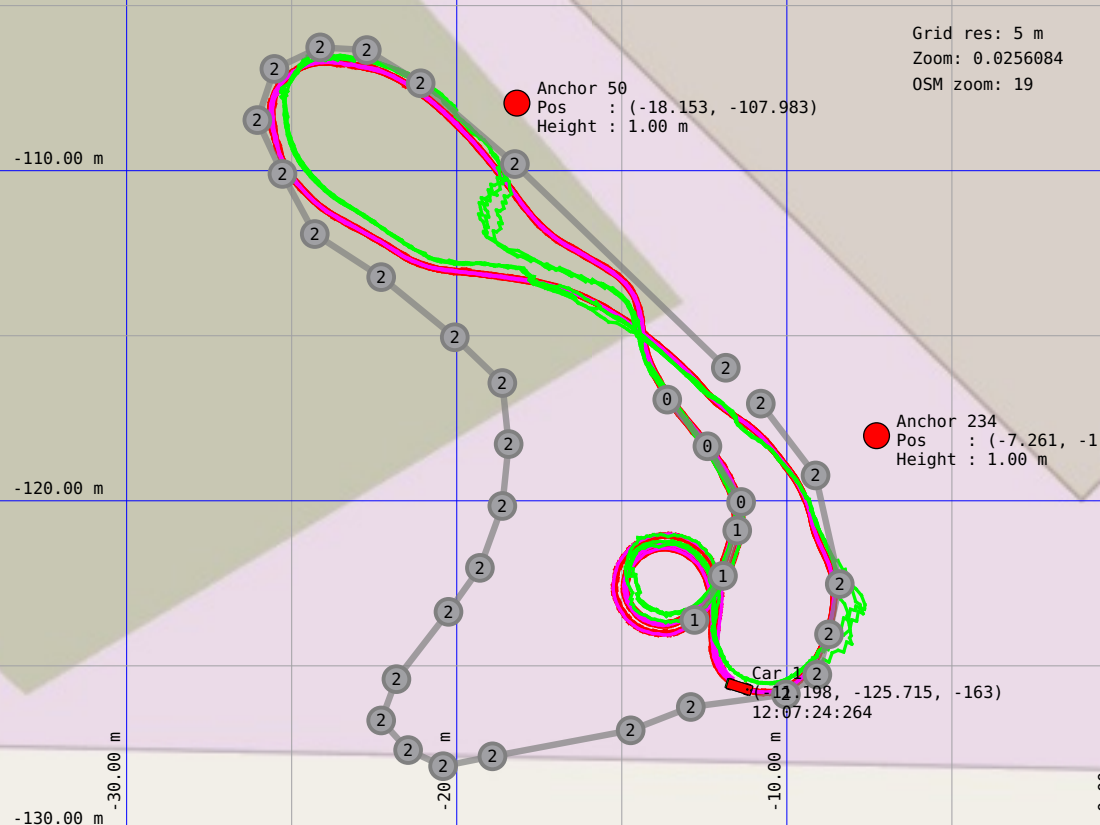
[picture p57: page 1]
