vedderb/rise_sdvp/Misc/Test Data/Automated_testing_2019/data_2/test_01_all.pdf

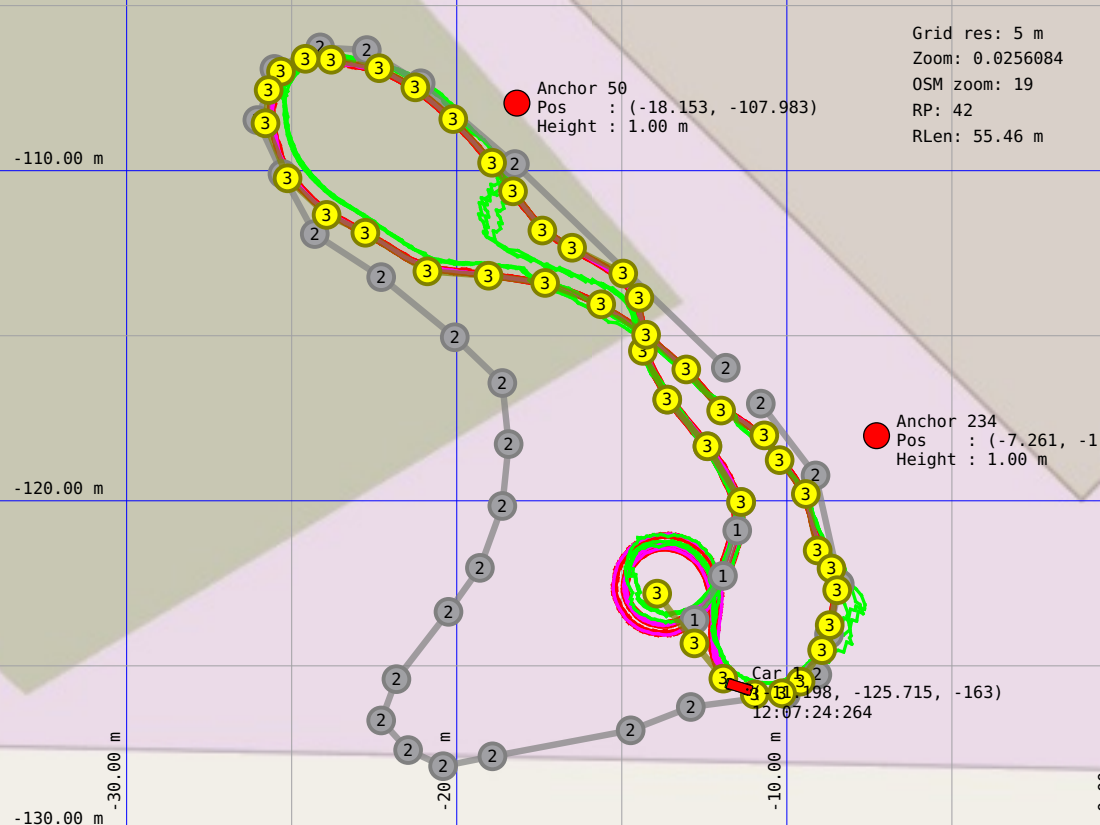
[picture p58: page 1]
