vedderb/rise_sdvp/Misc/Test Data/Automated_testing_2019/data_2/test_01_nf.pdf

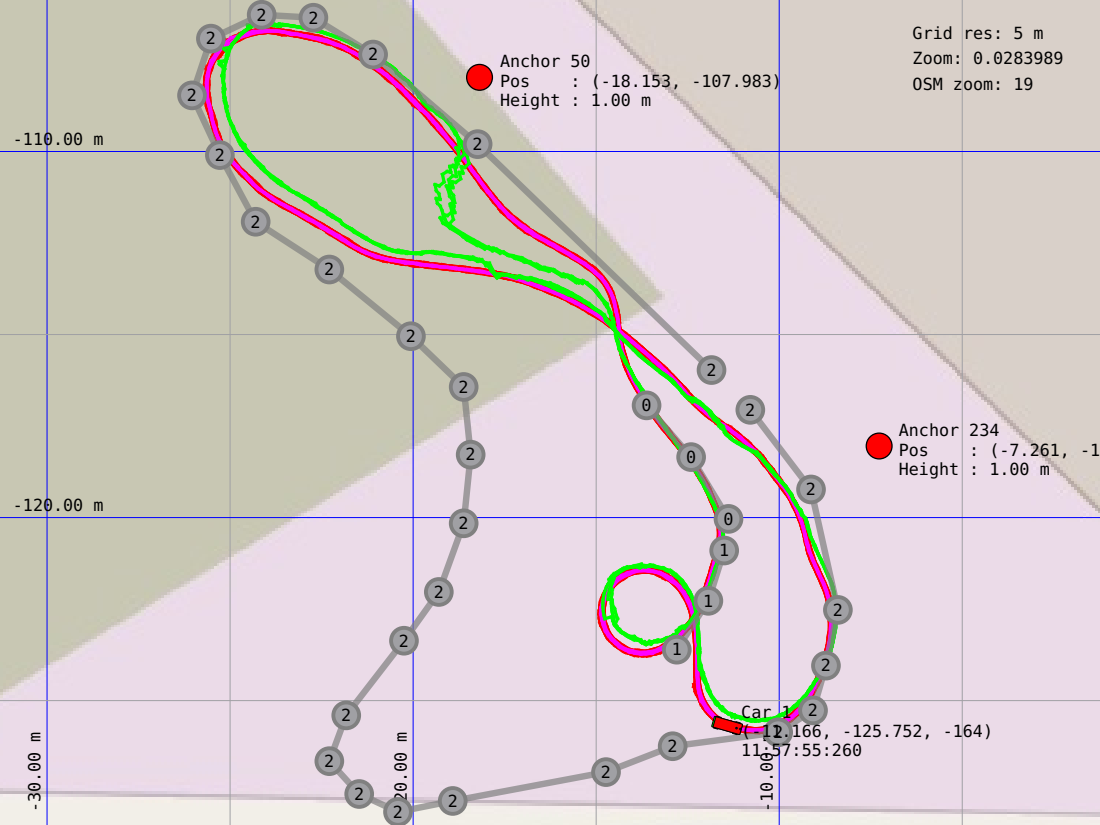
[picture p59: page 1]
Car; Anchor 50; Pos; Height : 1.00 m; Anchor; Height; Grid; res: 5 m; Zoom:; OSM zoom: 19
