vedderb/rise_sdvp/Misc/Test Data/Automated_testing_2019/data_2/test_01_nf_all.pdf

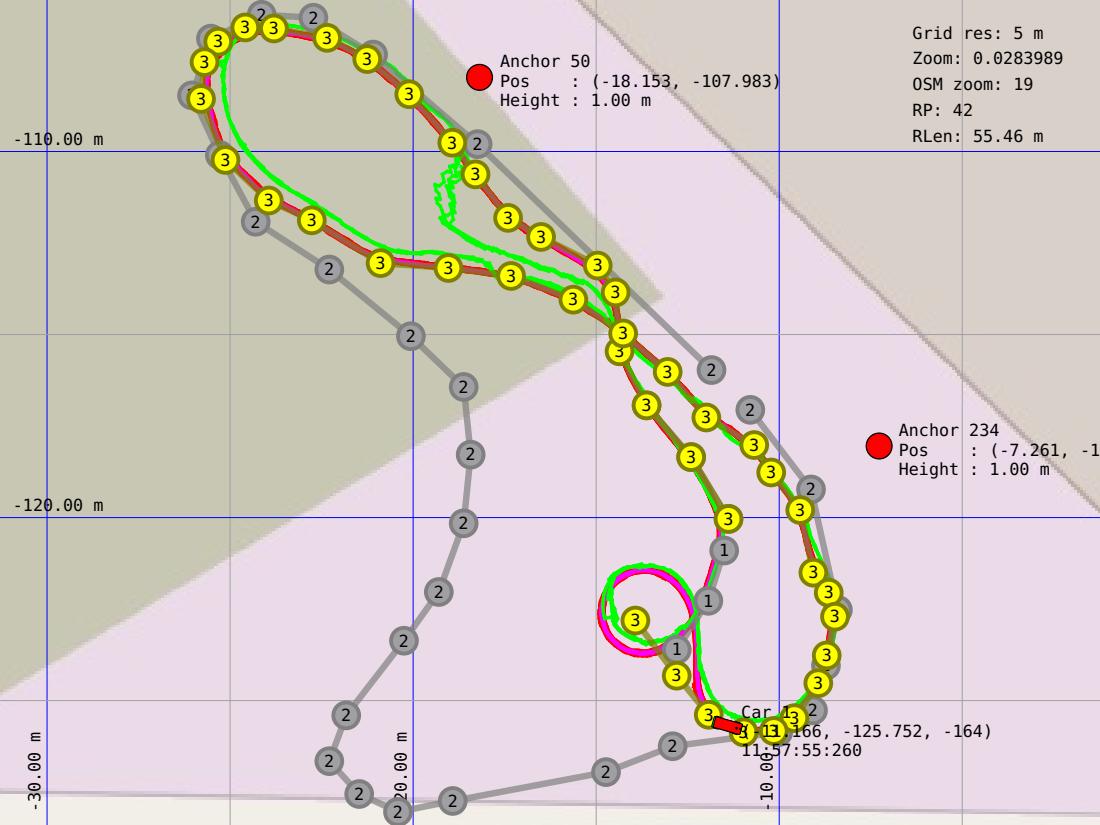
[picture p60: page 1]
