vedderb/rise_sdvp/Misc/Test Data/Automated_testing_2019/data_2/test_02.pdf

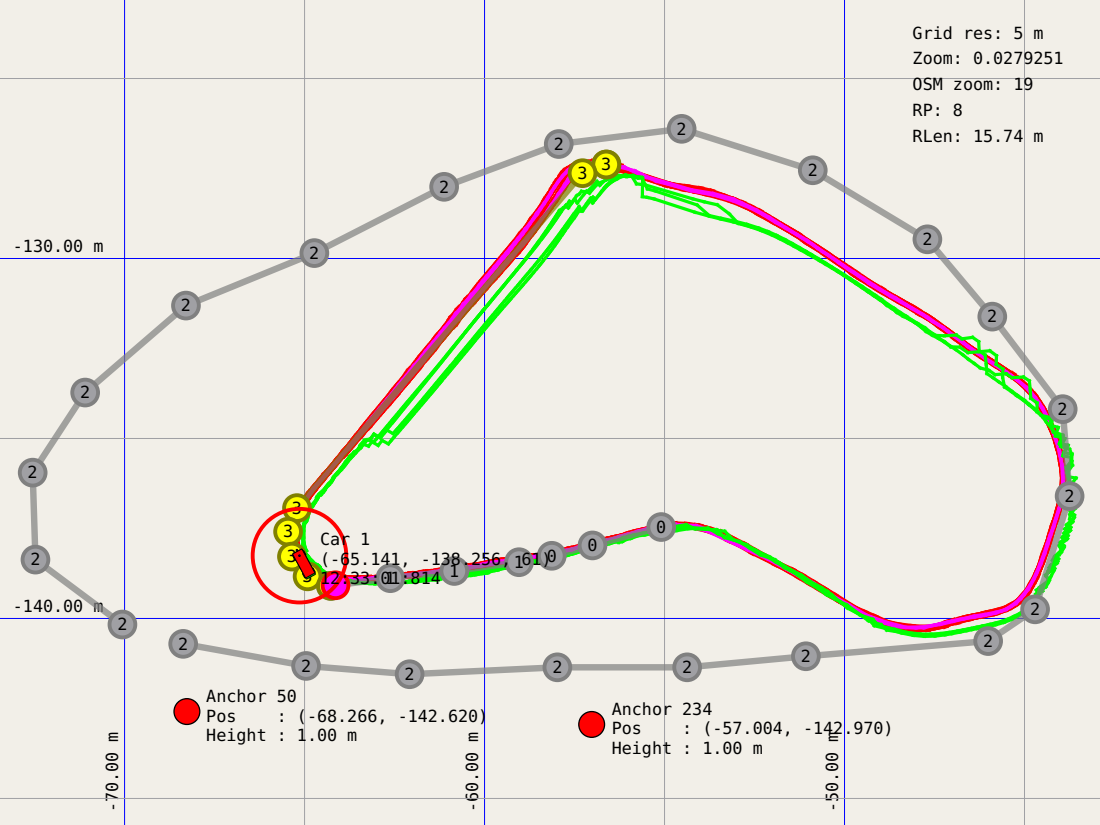
[picture p61: page 1]
Car 1 (-65.141, -138.256, 61) 12:33:01:814; Anchor 50; Pos; Height : 1.00 m; Anchor 234; Grid res: 5; Zoom: 0.0279251 OSM zoom: 19 RP: 8; RLen: 15.74
