vedderb/rise_sdvp/Misc/Test Data/Automated_testing_2019/data_2/test_03.pdf

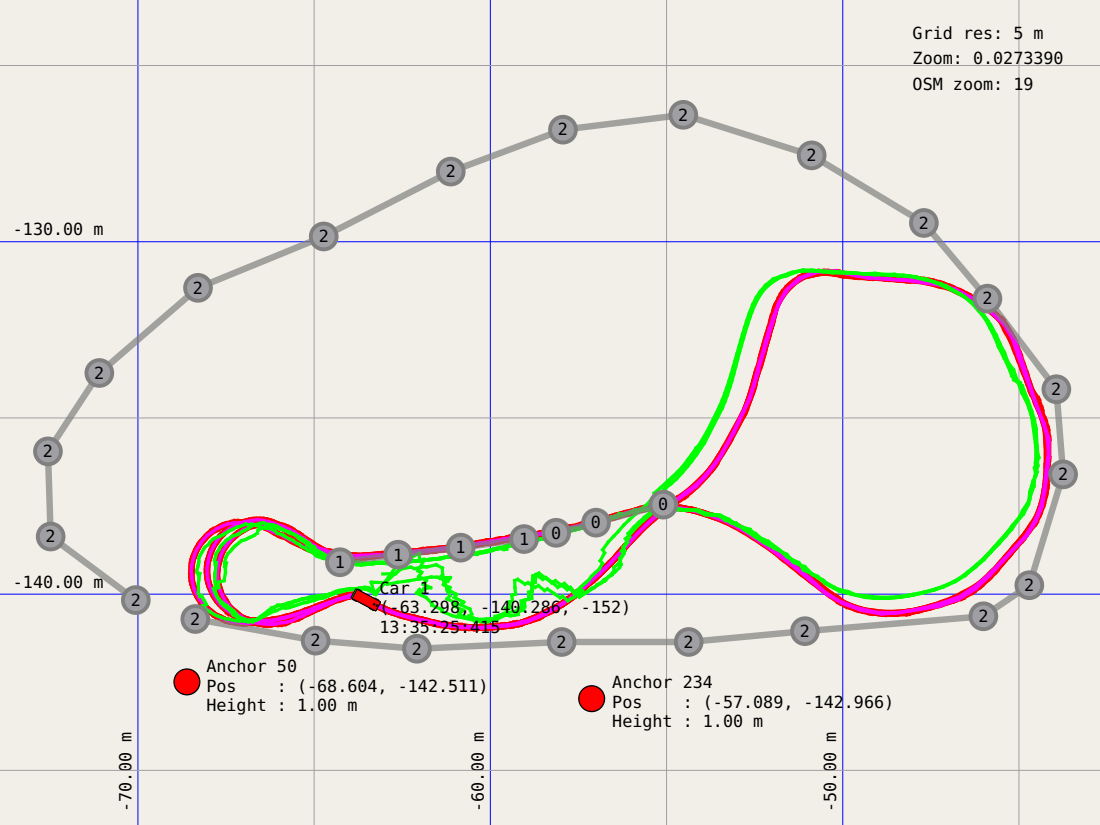
[picture p62: page 1]
Car 1 (-63.298, -140.286, -152) 13:35:25:415; Anchor 50; Pos; Height : 1.00 m; Anchor 234; Grid res: 5 m Zoom: 0.0273390 OSM zoom: 19
