vedderb/rise_sdvp/Misc/Test Data/Automated_testing_2019/data_2/test_03_nf.pdf

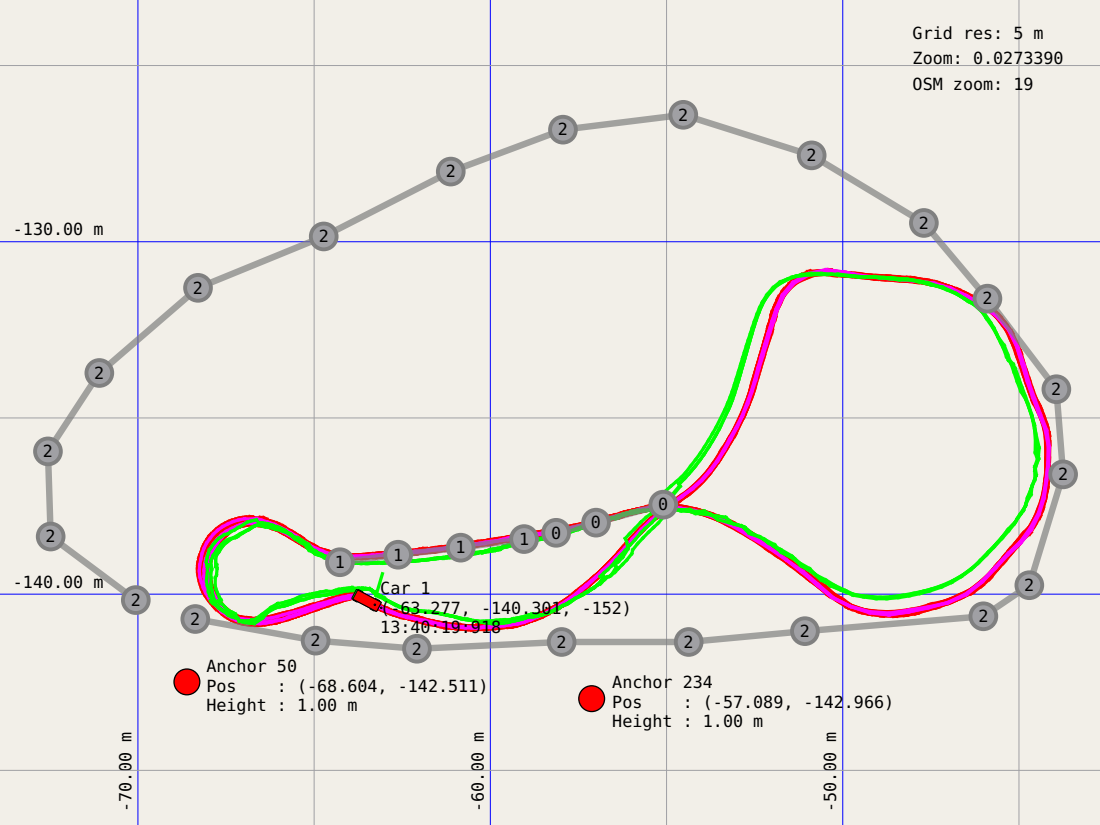
[picture p63: page 1]
Car 1 (-63.277, -140.301, -152) 13:40:19:918; Anchor 50; Pos; Height : 1.00 m; Anchor 234; Grid res: 5 m Zoom: 0.0273390 OSM zoom: 19
