vedderb/rise_sdvp/Misc/Test Data/Automated_testing_2019/data_2/traces_no_fi.pdf

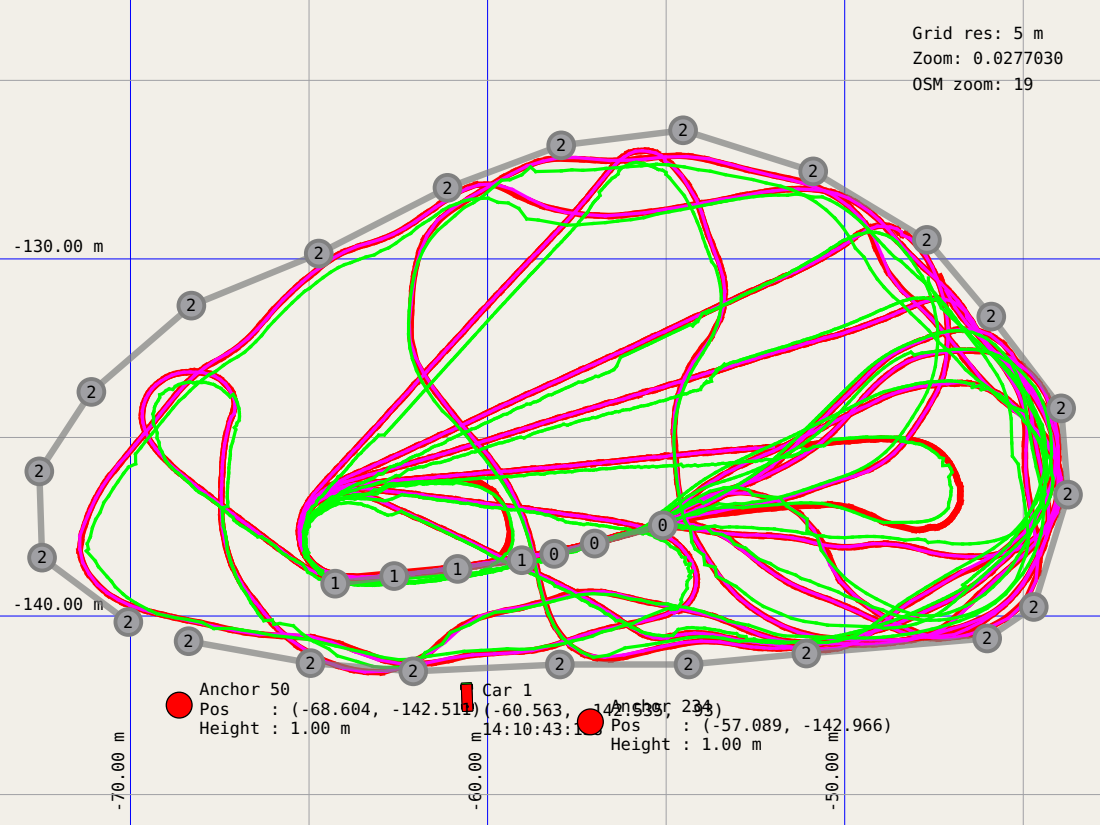
[picture p64: page 1]
Car 1 (-60.563, -142.535, -93) 14:10:43:138; Anchor 50; Pos; Height : 1.00 m; Anchor 234; Grid res: 5; Zoom: 0.0277030 OSM zoom: 19
