vedderb/rise_sdvp/Misc/Test Data/Automated_testing_2019/data_1/01_all.pdf

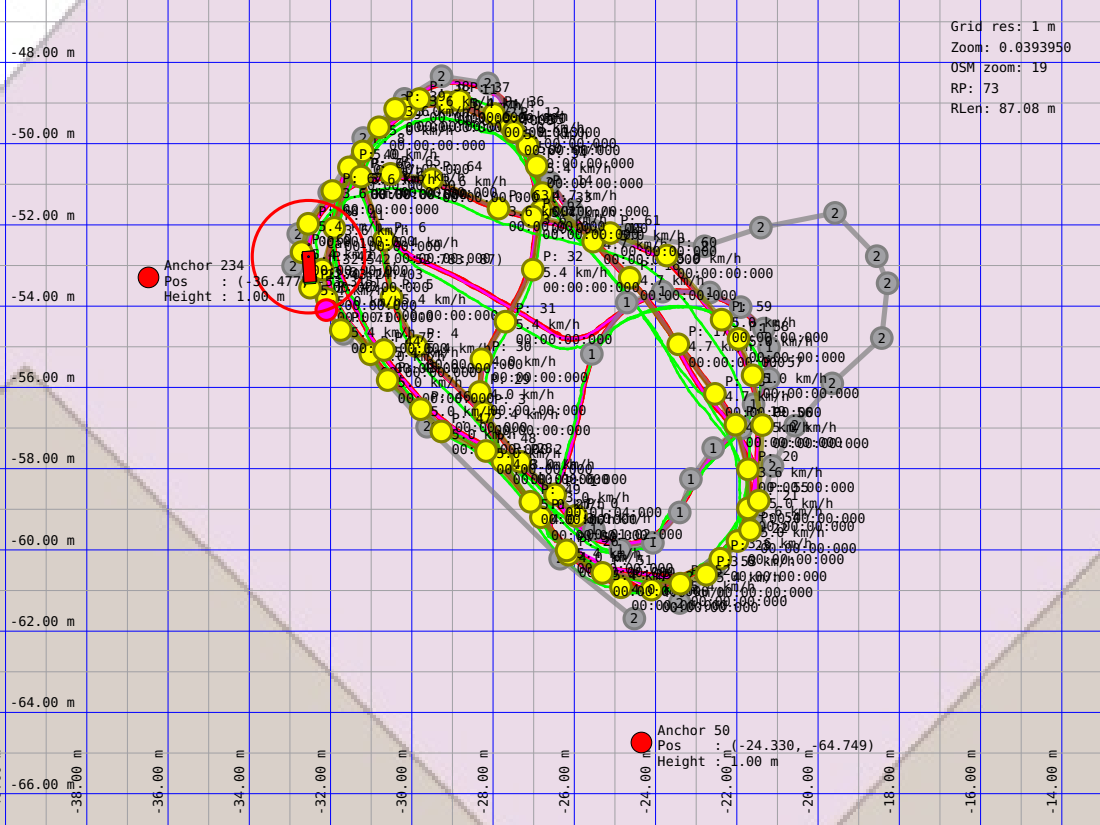
[picture p65: page 1]
