vedderb/rise_sdvp/Misc/Test Data/Automated_testing_2019/data_1/01_trace.pdf

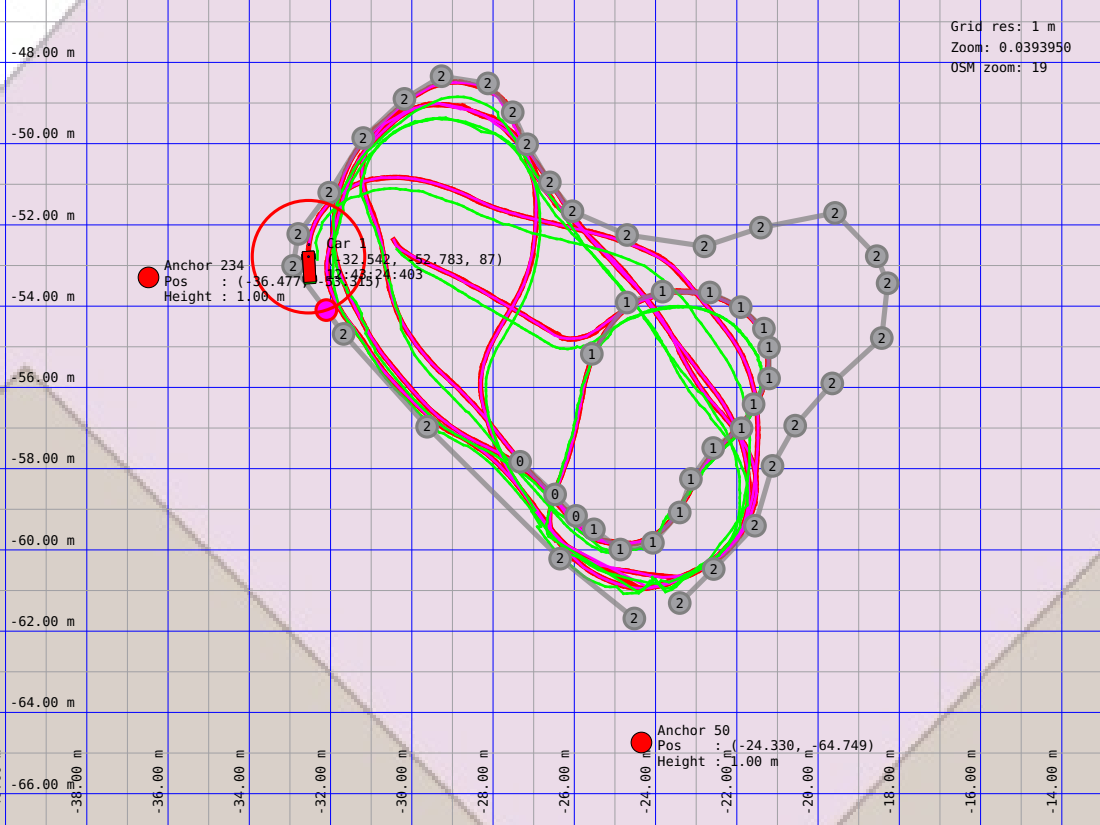
[picture p66: page 1]
Car 1 (-32.542, -52.783, 87) 12:43:24:403; Anchor 234; Pos; Height : 1.00 m; Anchor 50; Grid res: 1 m Zoom: 0.0393950; OSM; zoom: 19
