vedderb/rise_sdvp/Misc/Test Data/Automated_testing_2019/data_1/02_all.pdf

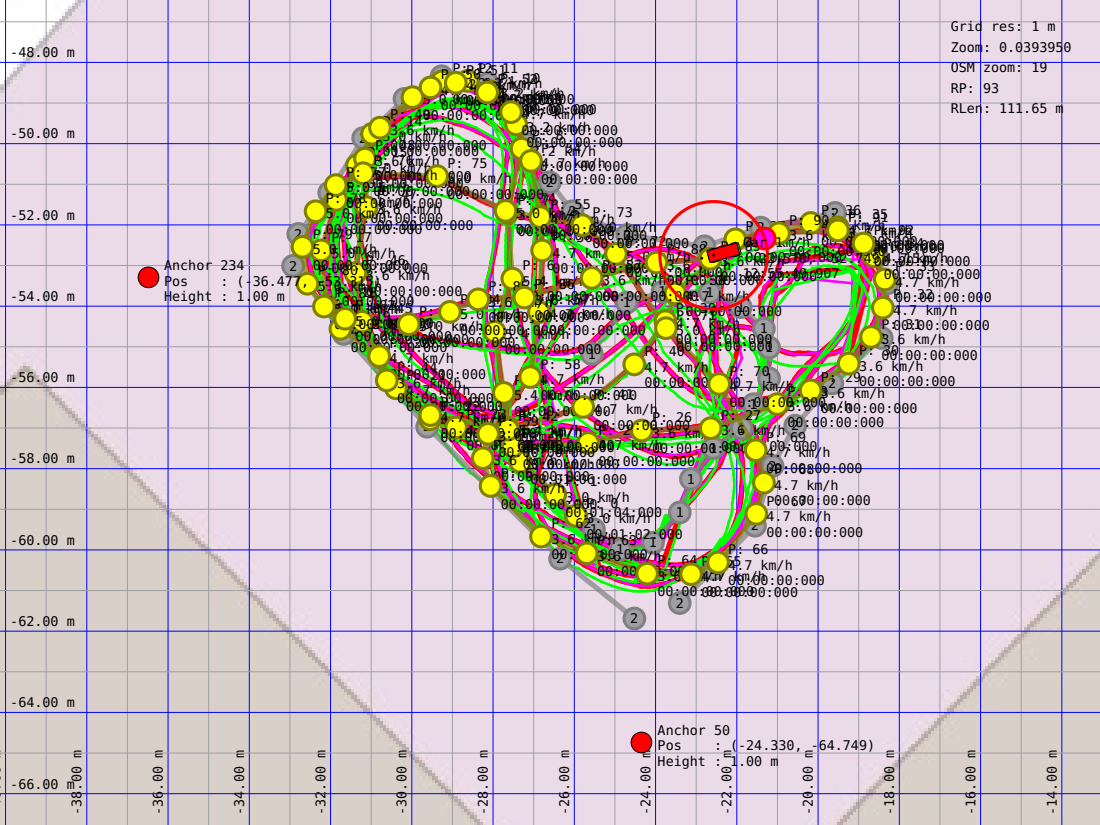
[picture p67: page 1]
Car 1; Anchor 234; Pos; Height : 1.00 m; Anchor 50; Grid res: 1 m Zoom: 0.0393950; OSM; zoom: 19; RLen: 111.65 m
