vedderb/rise_sdvp/Misc/Test Data/Automated_testing_2019/data_1/03_trace.pdf

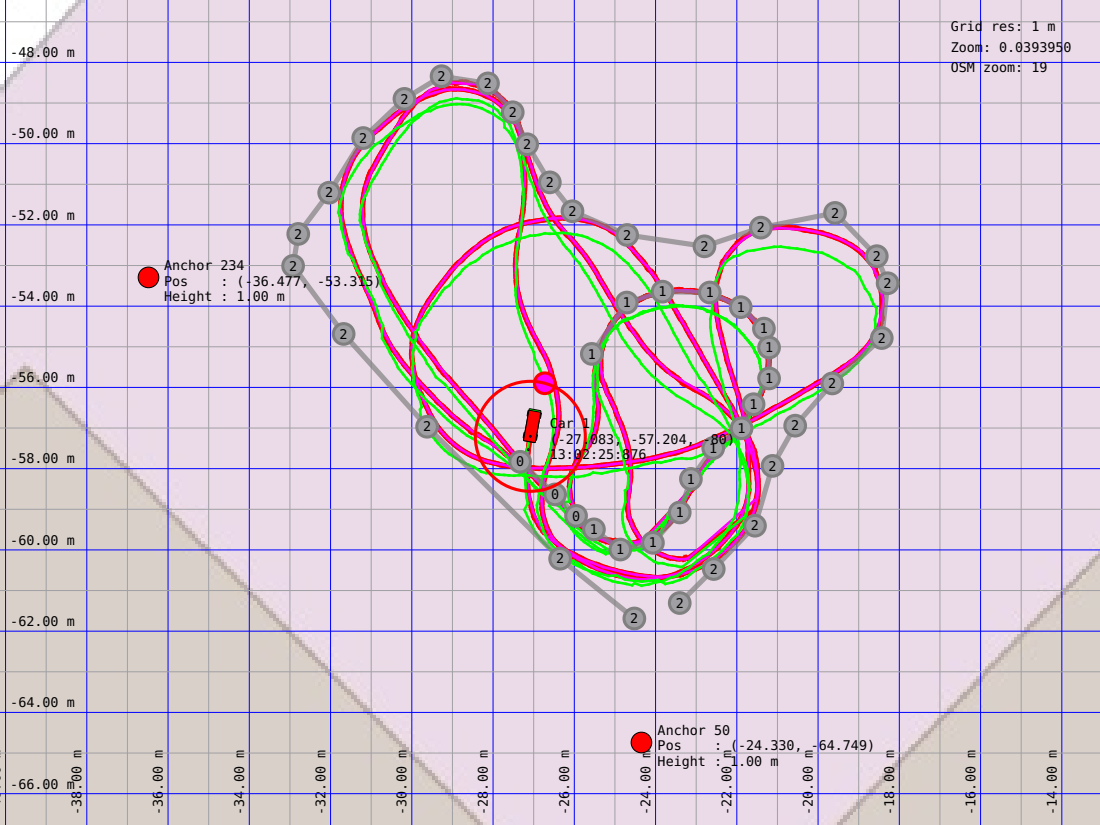
[picture p68: page 1]
