vedderb/rise_sdvp/Misc/Test Data/Automated_testing_2019/data_1/fi_02_all.pdf

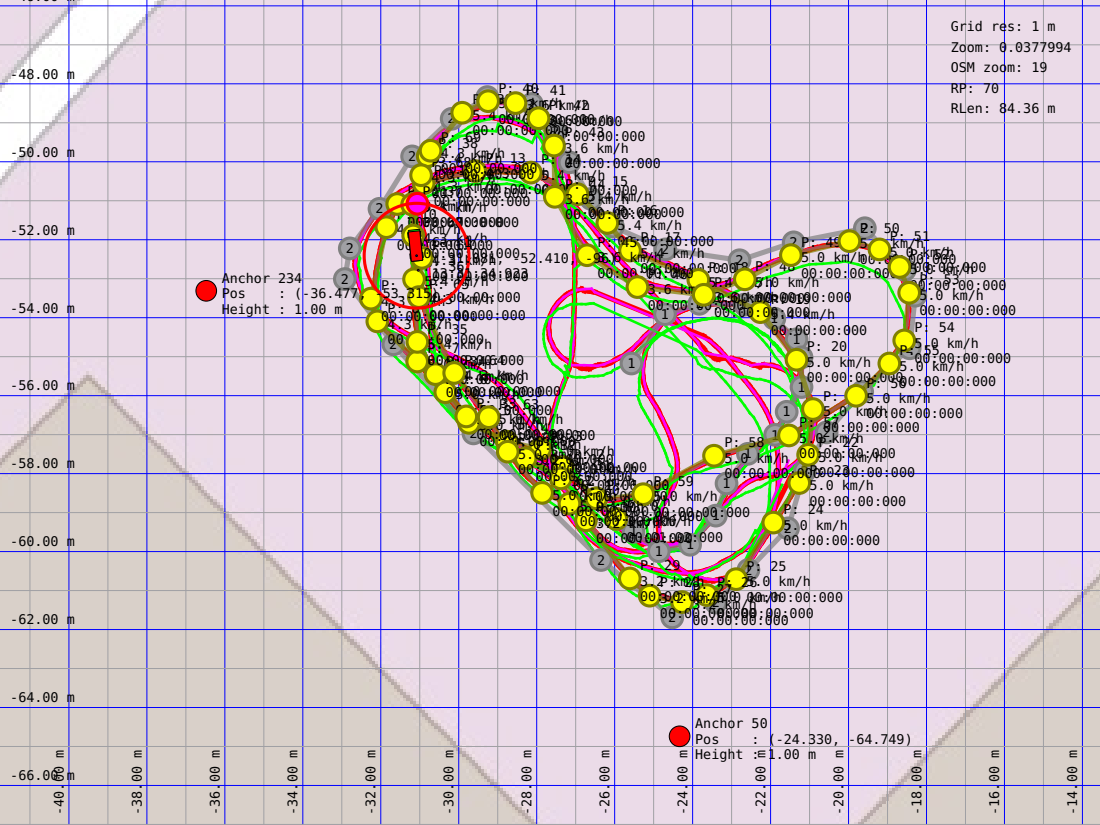
[picture p69: page 1]
Car; 13:31:34:923 Anchor 234; Pos; Height : 1.00 m; Anchor 50; Grid res: 1; Zoom: 0.0377994 OSM zoom: 19 RP: 70; RLen: 84.36
