vedderb/rise_sdvp/Misc/Test Data/Automated_testing_2019/data_1/fi_03_all.pdf

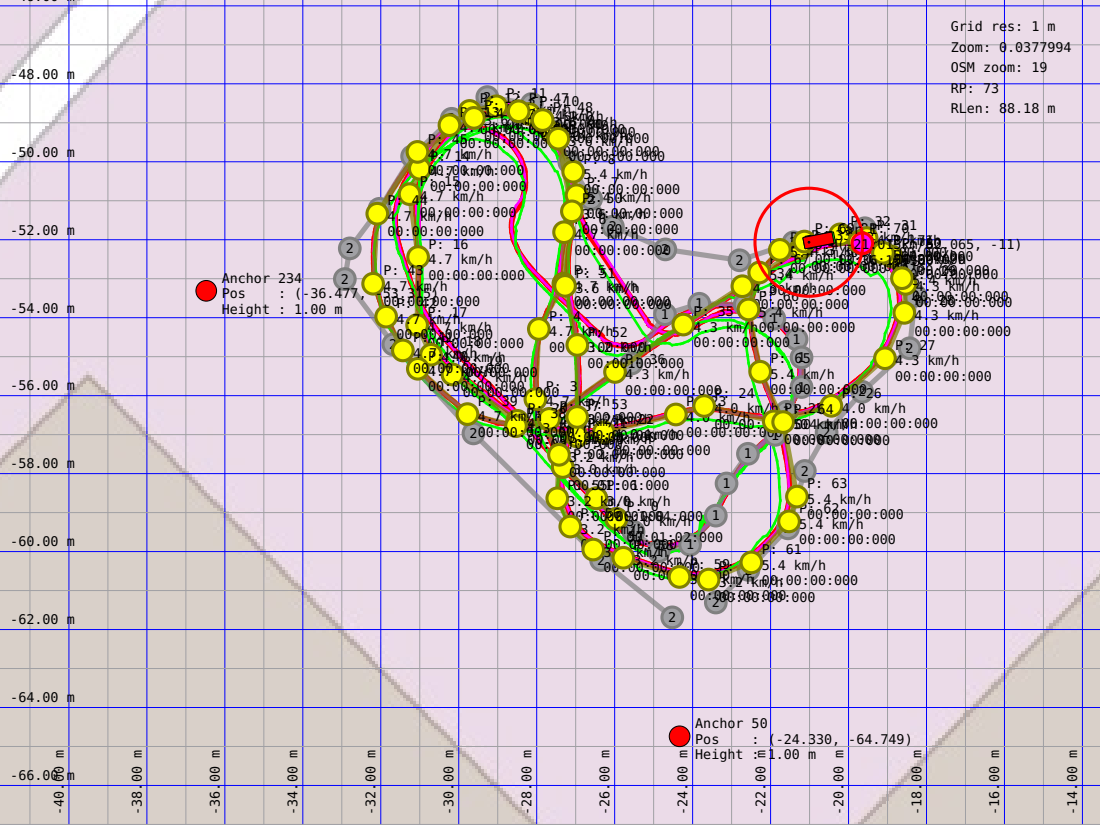
[picture p70: page 1]
Car 1 (-21.015, -52.065, -11) 13:36:15:500; Anchor 234; Pos; Height : 1.00 m; Anchor 50; Grid res: 1; Zoom: 0.0377994 OSM zoom: 19 RP: 73; RLen: 88.18
