vedderb/rise_sdvp/Misc/Test Data/Automated_testing_2019/data_1/fi_04_all.pdf

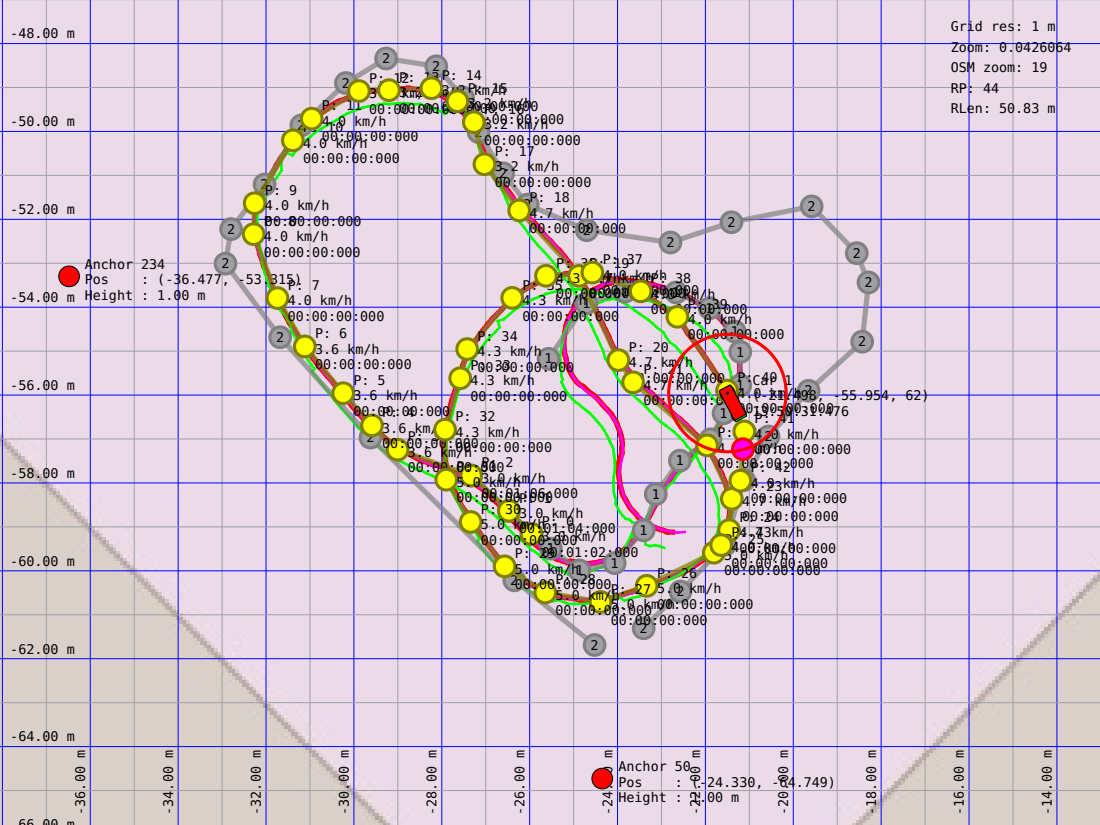
[picture p71: page 1]
Car 1 (-21.498, -55.954, 62) 13:50:31:476; Anchor; Pos; Height; Anchor 50; Height : 1.00 m; Grid res: 1 m Zoom: 0.0426064 OSM zoom: 19 RP: 44 RLen: 50.83 m
