vedderb/rise_sdvp/Misc/Test Data/Automated_testing_2019/data_1/fi_04_nf_all.pdf

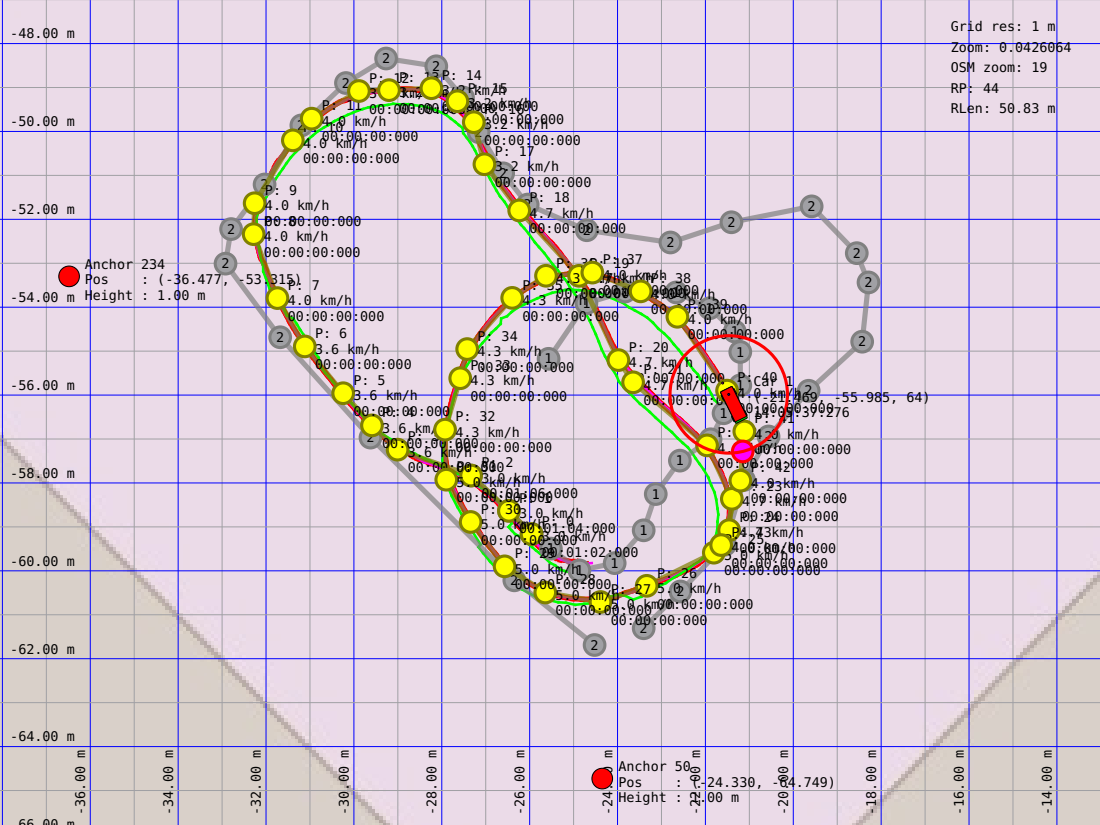
[picture p72: page 1]
Car 1 (-21.469, -55.985, 64) 14:05:37:276; Anchor; Pos; Height; Anchor 50; Height : 1.00 m; Grid res: 1 m Zoom: 0.0426064 OSM zoom: 19 RP: 44 RLen: 50.83 m
