vedderb/rise_sdvp/Misc/Test Data/Automated_testing_2019/data_1/fi_04_trace.pdf

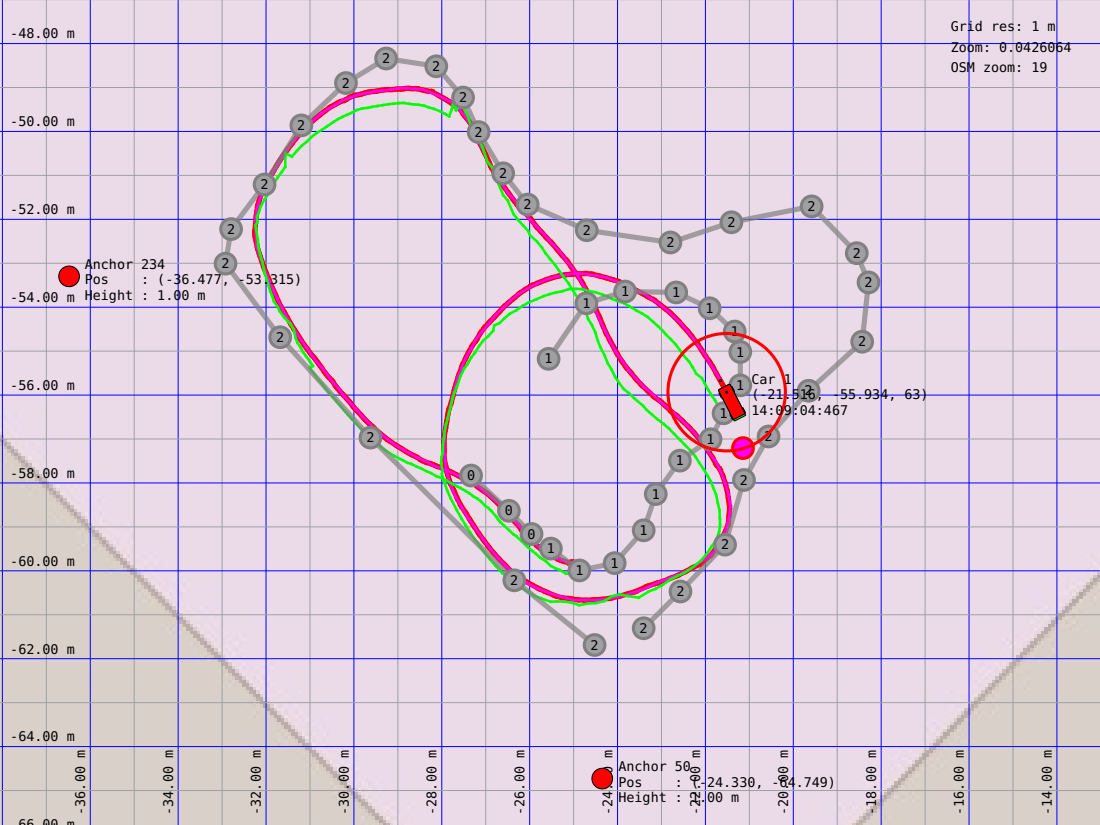
[picture p73: page 1]
Car 1 (-21.516, -55.934, 63) 14:09:04:467; Anchor; Pos; Height; Anchor 50; Height : 1.00 m; Grid res: 1 m Zoom: 0.0426064 OSM zoom: 19
