vedderb/rise_sdvp/Misc/Test Data/paper_2018-06/plots/1_diff_no_corr.pdf

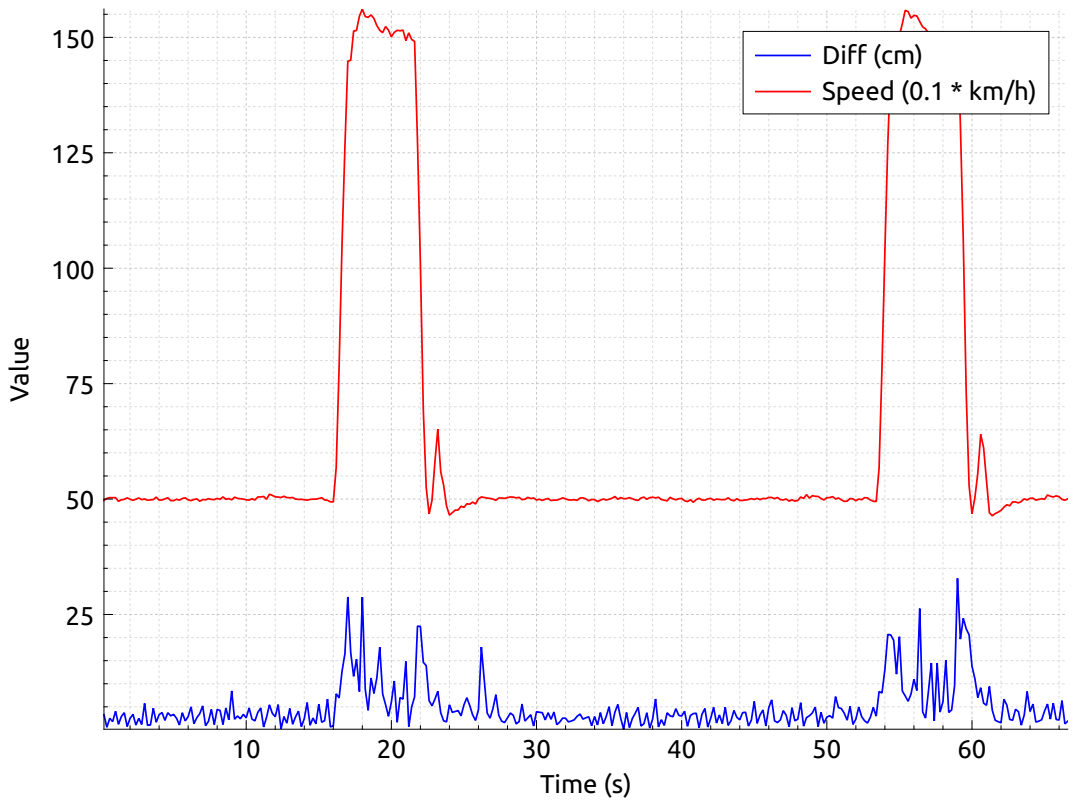
[picture p75: page 1]
Time (s); alu; Diff (cm) Speed (0.1 * km/h)
