vedderb/rise_sdvp/Misc/Test Data/paper_2018-06/plots/2_diff_no_corr.pdf

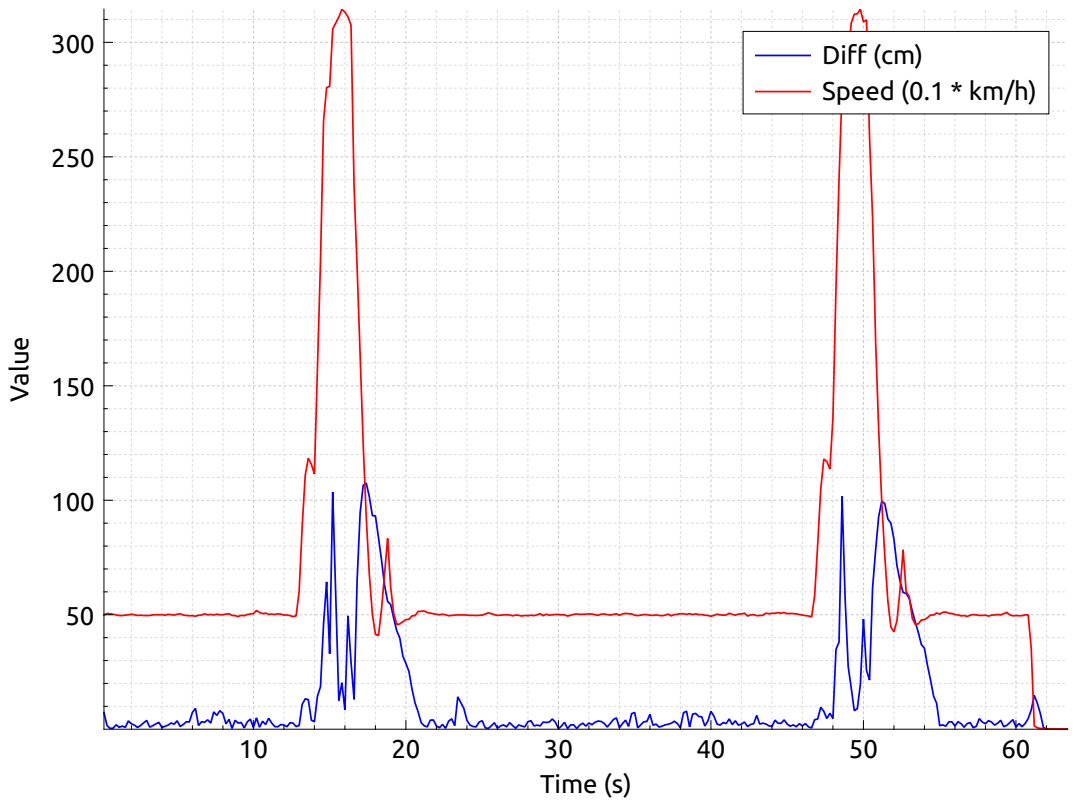
[picture p77: page 1]
Time (s); alu; Diff (cm) Speed (0.1 * km/h)
