vedderb/rise_sdvp/Misc/Test Data/paper_2018-06/plots/2_route.pdf

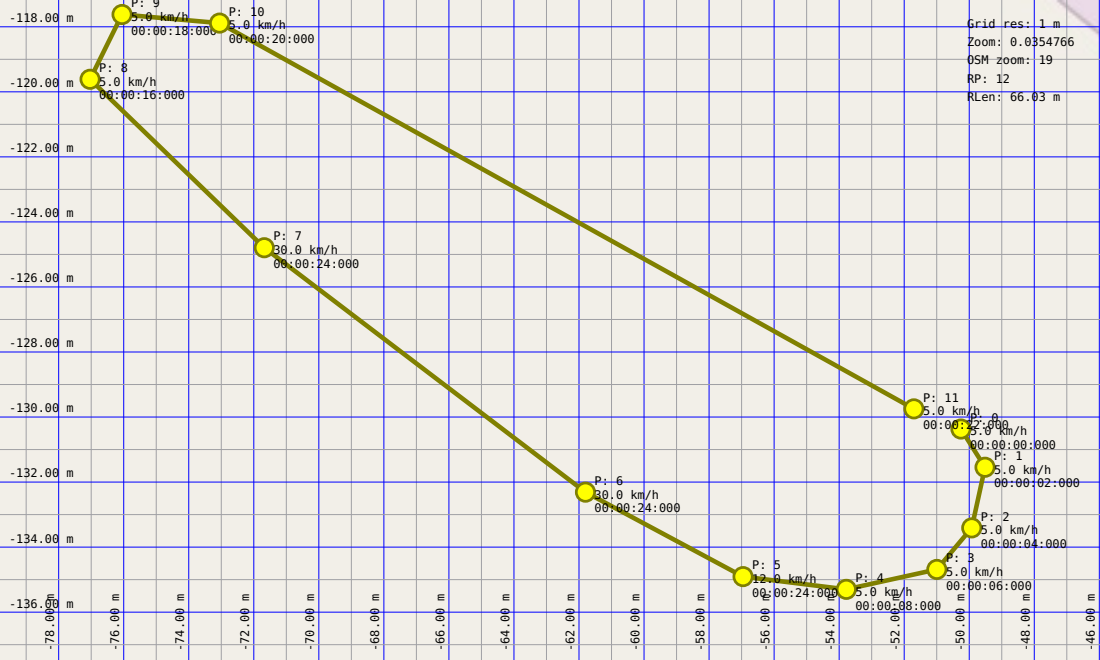
[picture p78: page 1]
Grid; res:; Zoom:; OSM zoom:; RLen:
