vedderb/rise_sdvp/Misc/Test Data/paper_2018-06/plots/ap_goal_outside.pdf

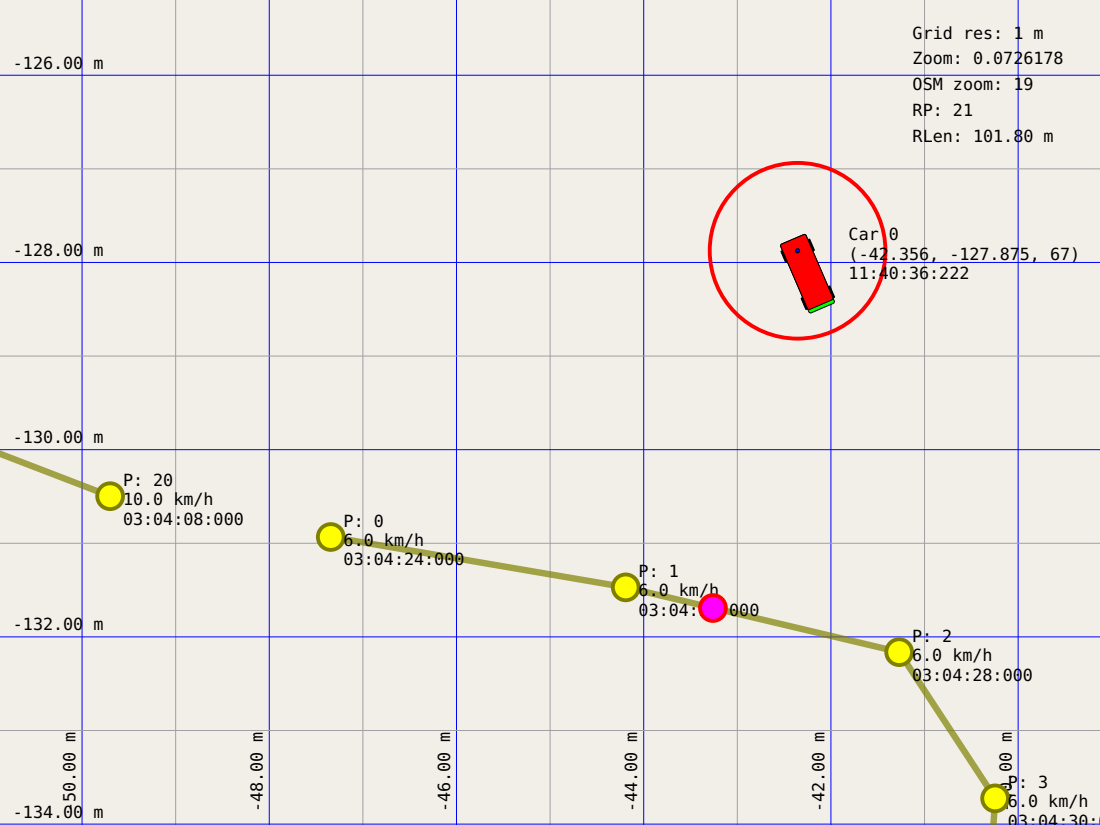
[picture p81: page 1]
Car 0 (-42.356, -127.875, 67) 11:40:36:222; Grid res: 1 m Zoom: 0.0726178 OSM zoom: 19 RP: 21 RLen: 101.80 m
