vedderb/rise_sdvp/Misc/Test Data/paper_2018-06/plots/diff_circle.pdf

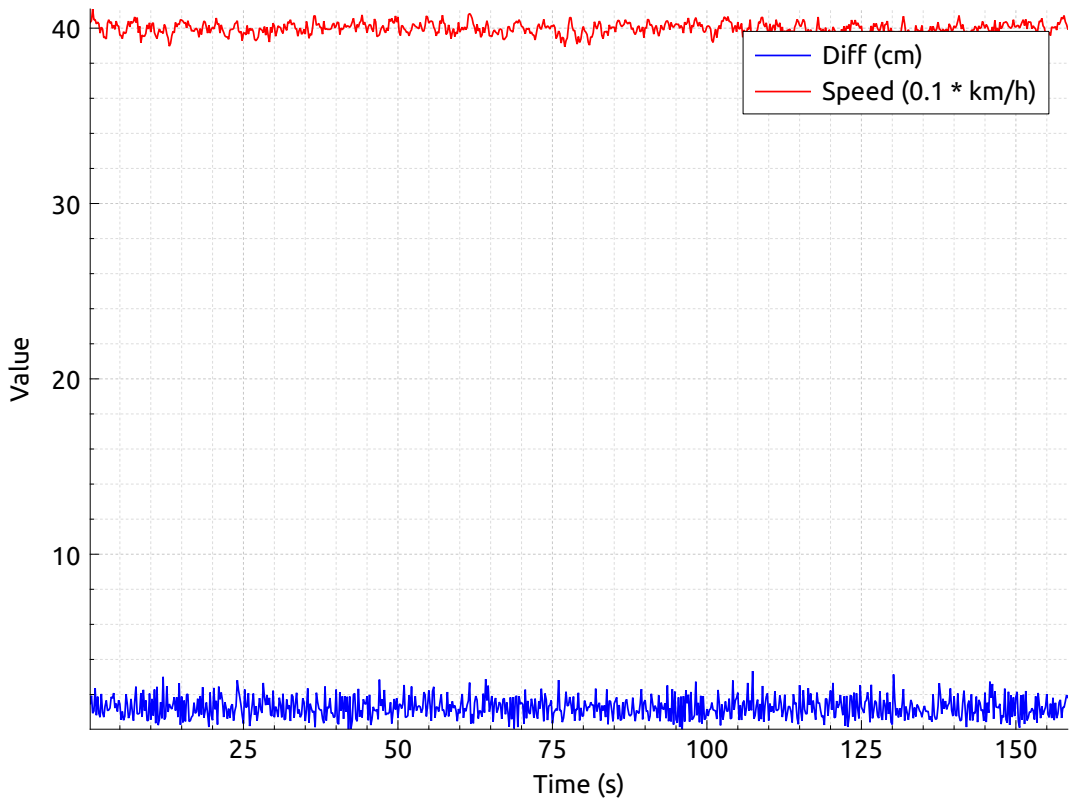
[picture p82: page 1]
Time (s); alu; Diff (cm) Speed (0.1 * km/h)
