vedderb/rise_sdvp/Misc/Test Data/paper_2018-06/plots/route_circle.pdf

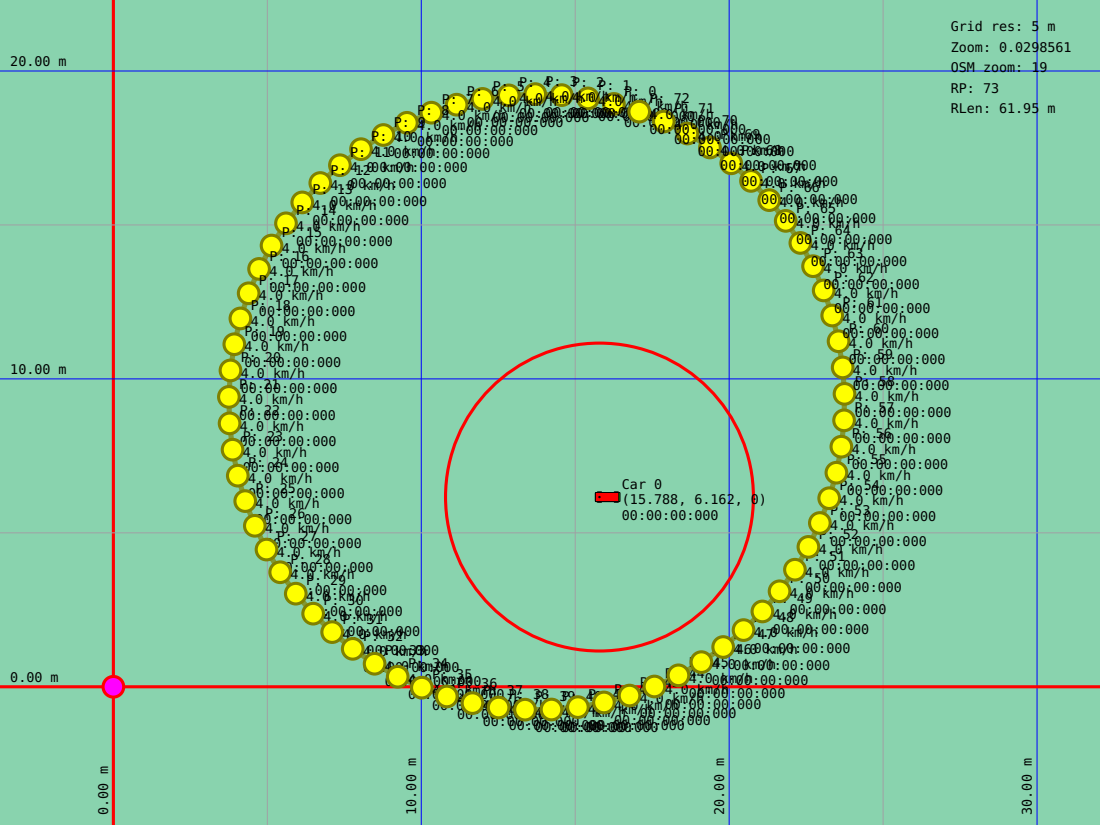
[picture p83: page 1]
Car 0 (15.788, 6.162, 0) 00:00:00:000; Grid res: 5 m Zoom: 0.0298561 OSM zoom: 19 RP: 73 RLen: 61.95 m
