vedderb/rise_sdvp/Misc/Test Data/paper_2018-06/plots/trace_ang_comp.pdf

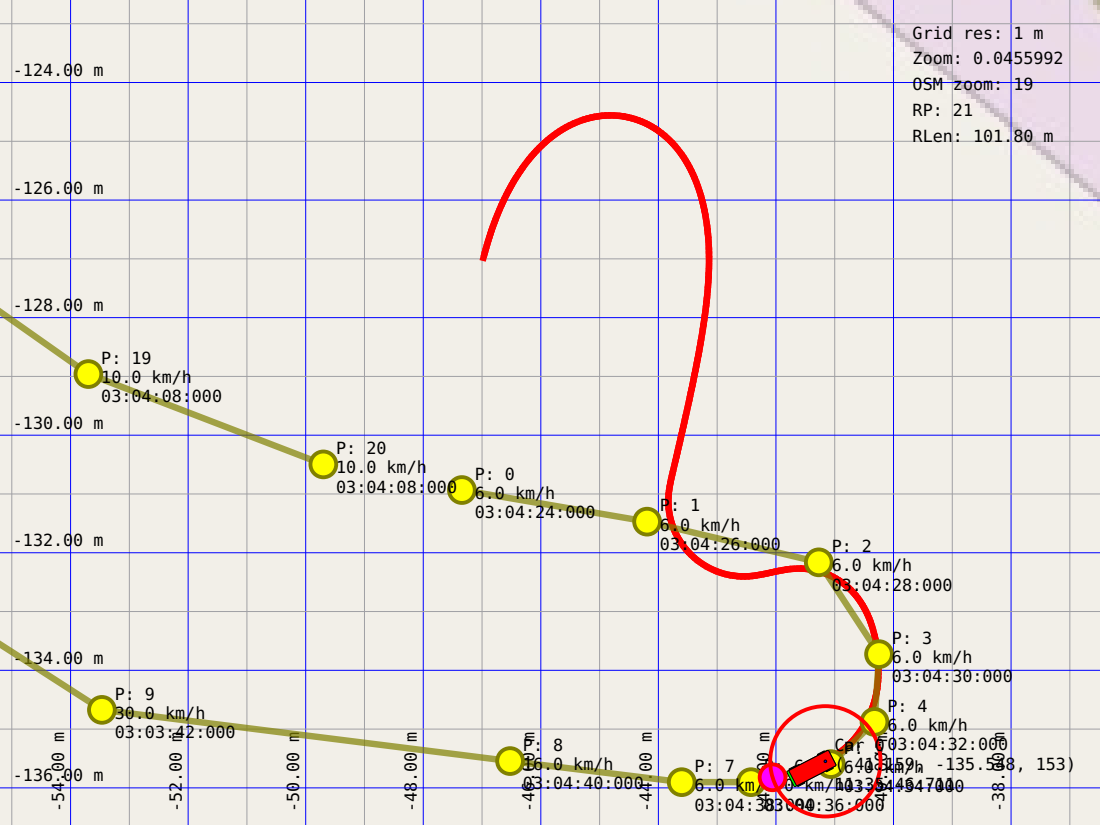
[picture p84: page 1]
Car 0 (-41.159, -135.548, 153) 11:35:46:711; Grid; res:; Zoom: 0.0455992; OSM; zoom:; RLen: 101.80 m
