vedderb/rise_sdvp/Misc/Test Data/paper_2018-06/plots/trace_ang_no_comp.pdf

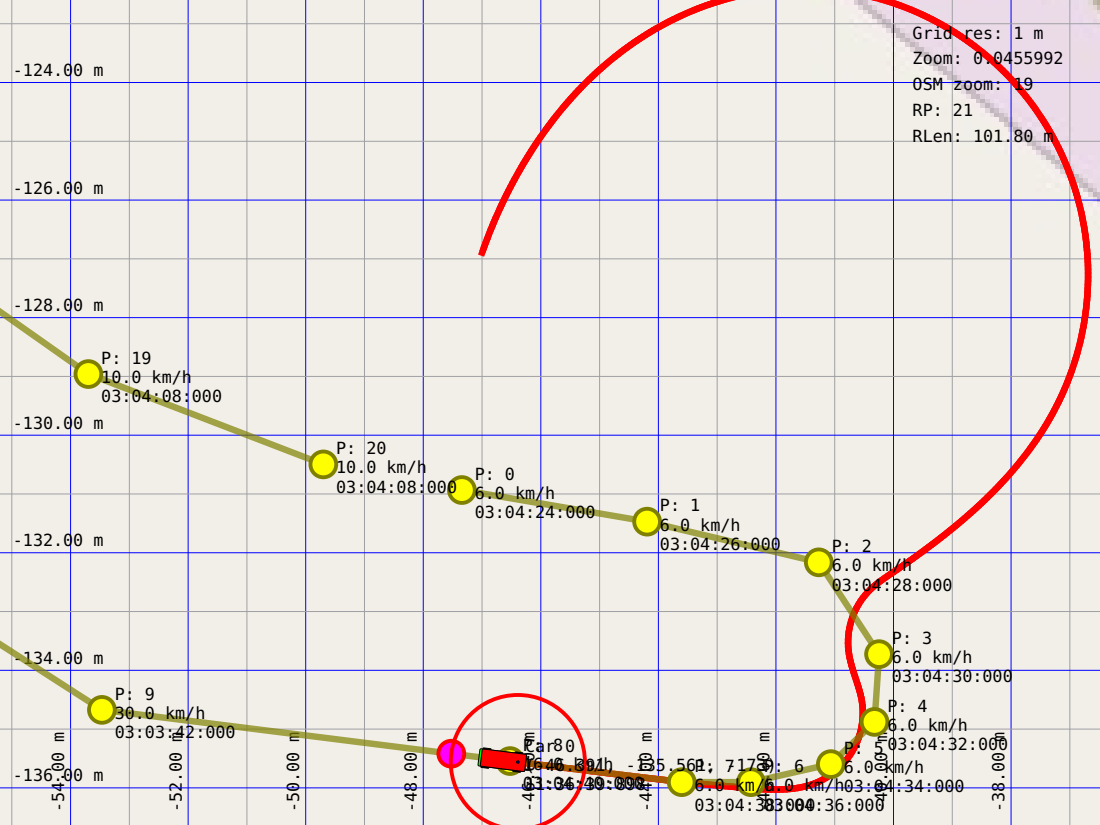
[picture p85: page 1]
Car 0; Grid; res:; Zoom: 0.0455992; OSM; zoom:; RLen: 101.80 m
