vedderb/rise_sdvp/Misc/Test Data/paper_2018-06/plots/trace_speed_0.8_comp.pdf

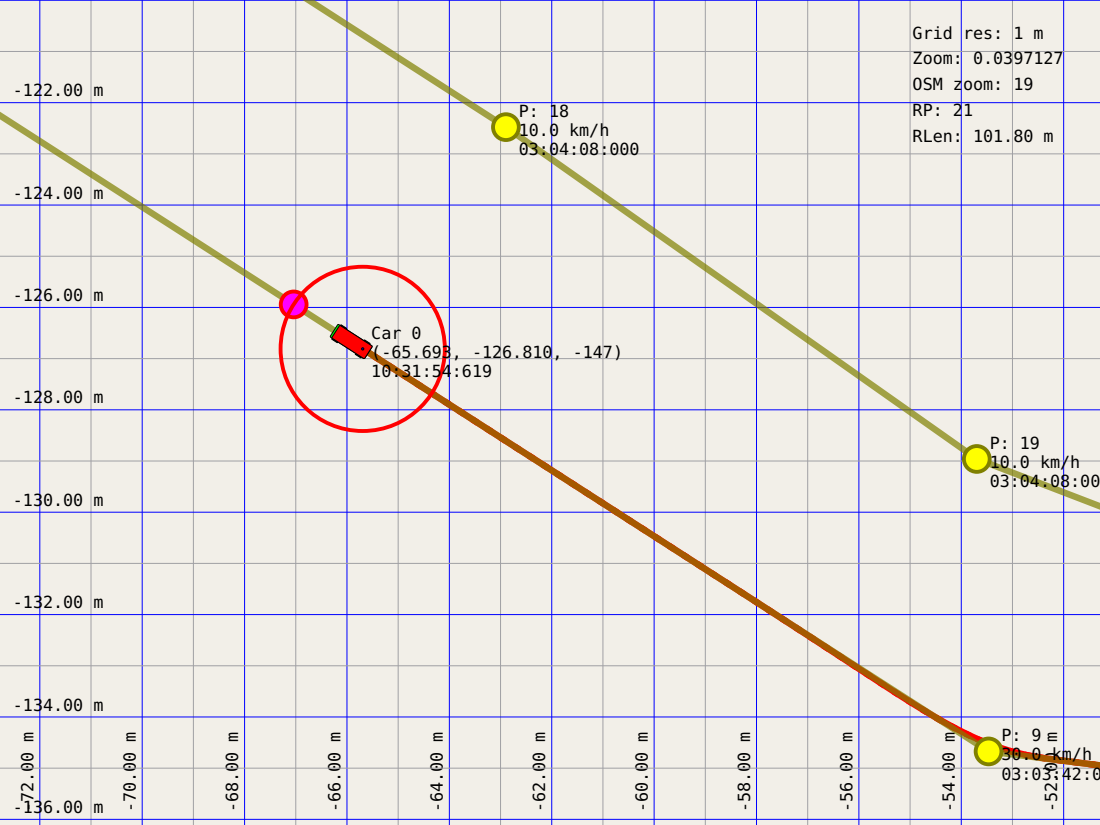
[picture p86: page 1]
Car 0 (-65.693, -126.810, -147) 10:31:54:619; Grid; res:; Zoom: 0.0397127; OSM zoom:; RP: 21 RLen: 101.80 m
