vedderb/rise_sdvp/Misc/Test Data/paper_2018-06/plots/trace_speed_0.8_no_comp.pdf

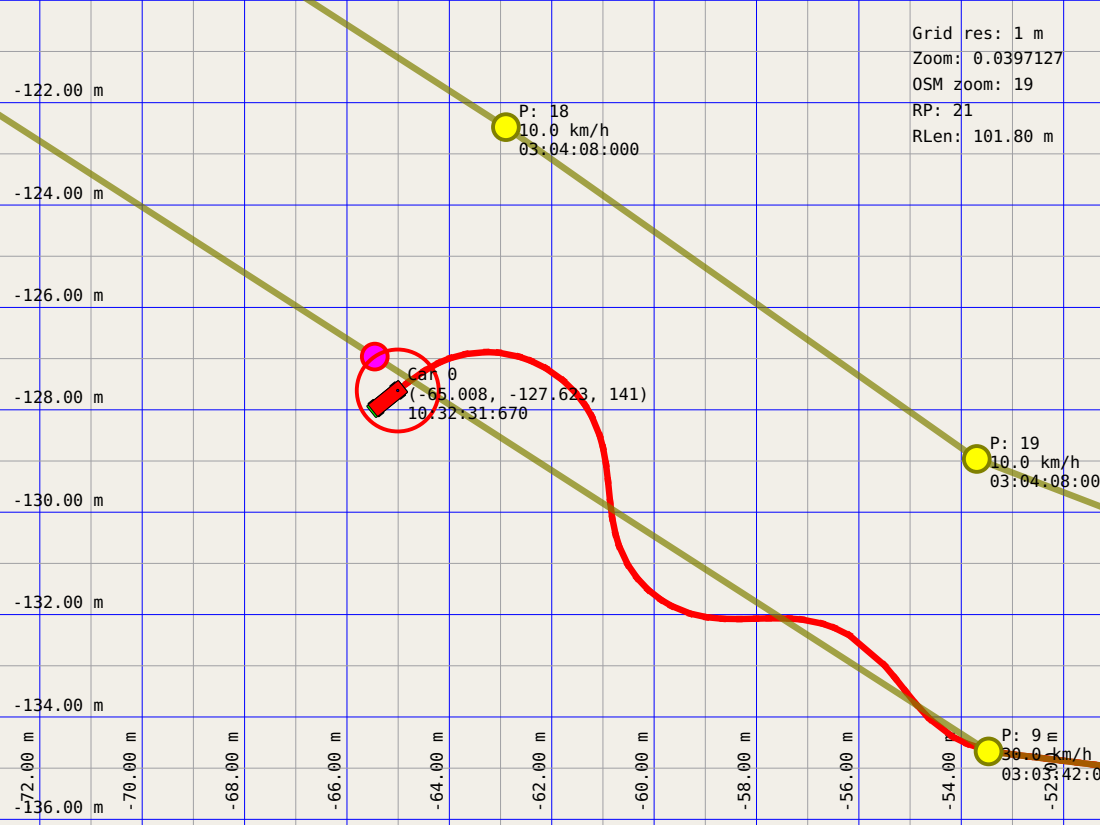
[picture p87: page 1]
Car; Grid; res:; Zoom: 0.0397127; OSM zoom:; RP: 21 RLen: 101.80 m
