vedderb/rise_sdvp/Misc/Test Data/paper_2018-06/plots/trace_turn_0.8_comp.pdf

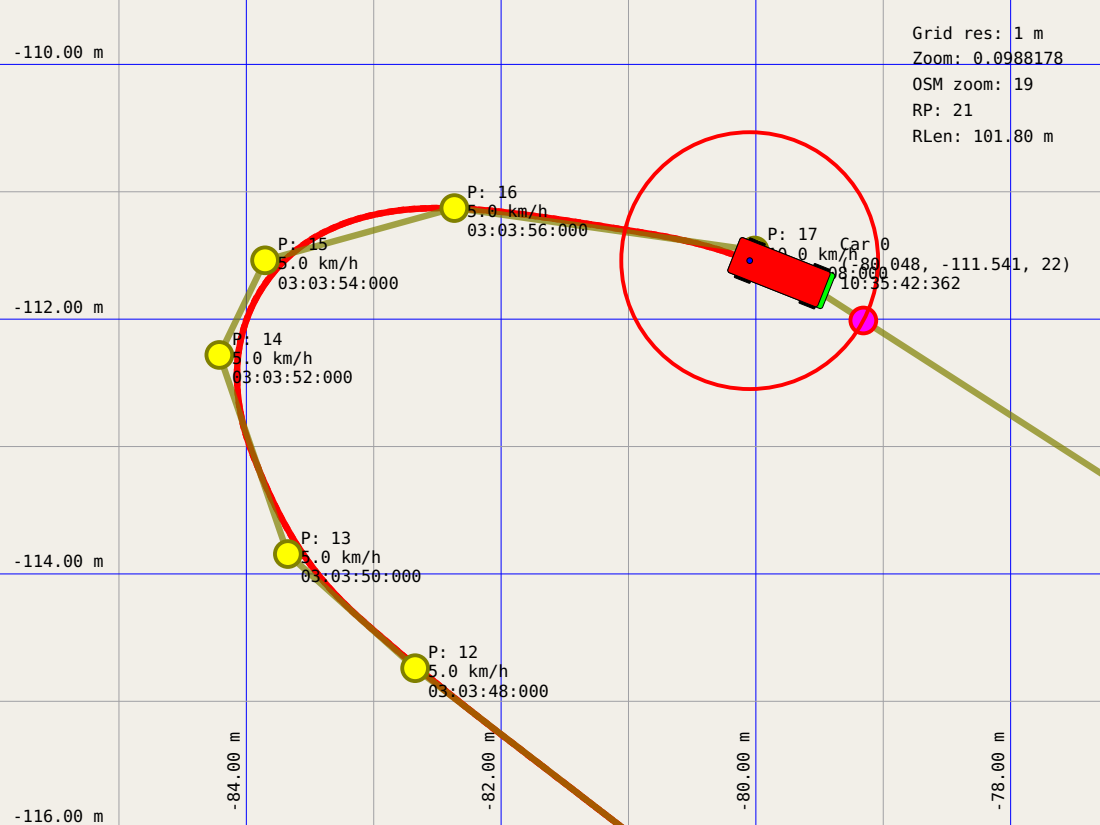
[picture p88: page 1]
Car 0 (-80.048, -111.541, 22) 10:35:42:362; Grid res:; Zoom: 0.0988178; OSM zoom:; RP: 21 RLen: 101.80 m
