vedderb/rise_sdvp/Misc/Test Data/paper_2018-06/plots/trace_turn_1.6_no_comp.pdf

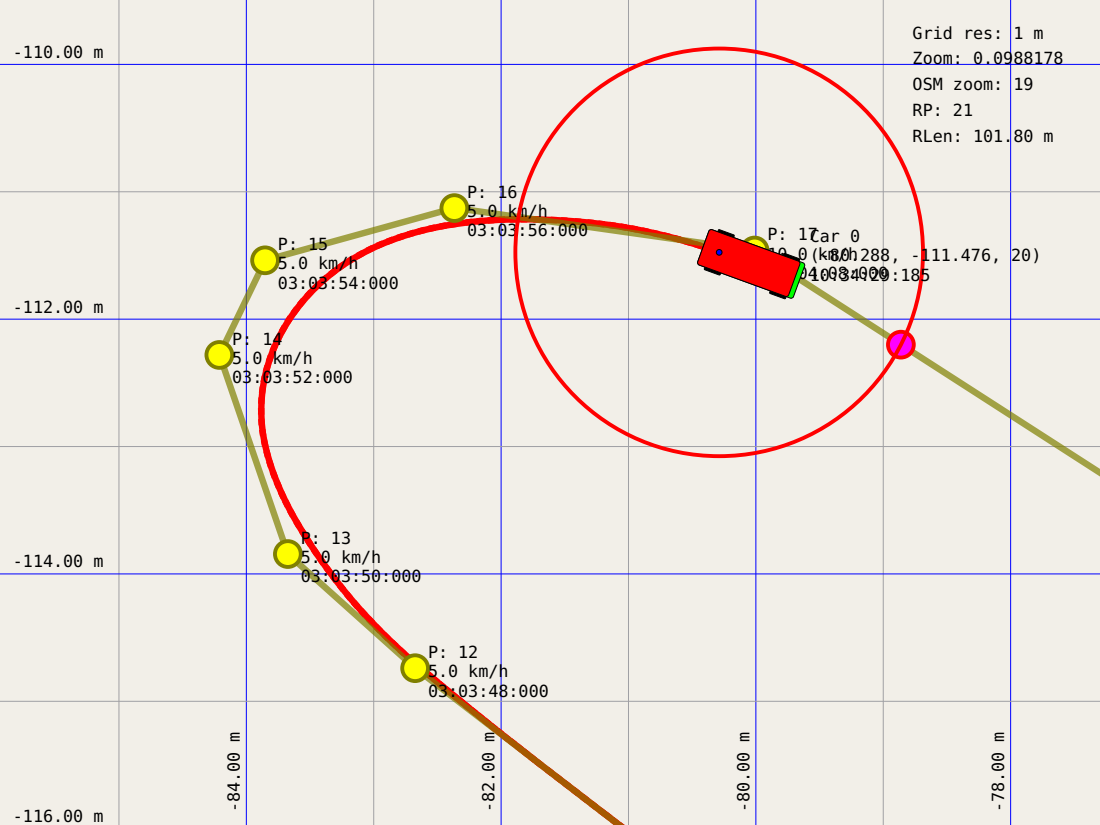
[picture p89: page 1]
Car 0; Grid res:; Zoom: 0.0988178; OSM zoom:; RP: 21 RLen: 101.80 m
