vedderb/rise_sdvp/Hardware/io_board/io_board.kicad_pcb

## KiCad design Hardware/io_board/io_board.kicad_pcb (2020-04-02)

Schematic: io_board.sch

Parts:
C1, C2, C3, C4, C17: 2.2u; C_0603_1608Metric
C9, C14, C15: 100u; CP_Radial_D10.0mm_P5.00mm
D1, D2, D5, D6, D7, D8: D_Schottky; D_SMA
D3: RED; LED_0603_1608Metric
D4: GREEN; LED_0603_1608Metric
H1, H2, H3, H4, H5: MountingHole; MountingHole_3.2mm_M3
J1, J2, J3: Valves; TerminalBlock_Phoenix_PT-1,5-2-5.0-H_1x02_P5.00mm_Horizontal
J4, J5: Steering; TerminalBlock_Phoenix_PT-1,5-2-5.0-H_1x02_P5.00mm_Horizontal
J6, J7: Limit SW; TerminalBlock_Phoenix_PT-1,5-2-5.0-H_1x02_P5.00mm_Horizontal
J8: ADC_IO; TerminalBlock_Phoenix_PT-1,5-2-5.0-H_1x02_P5.00mm_Horizontal
J9, J10: ADC_VDIV; TerminalBlock_Phoenix_PT-1,5-2-5.0-H_1x02_P5.00mm_Horizontal
J11: 12V IN; TerminalBlock_Phoenix_PT-1,5-2-5.0-H_1x02_P5.00mm_Horizontal
J12, J15: CAN; JST_PH_B4B-PH-K_1x04_P2.00mm_Vertical
J13: AS5047; JST_PH_B6B-PH-K_1x06_P2.00mm_Vertical
Q1, Q2, Q3, Q4, Q5, Q6, Q7, Q8, Q9, Q10, Q11, Q12, Q13: Q_NMOS_GSD; SOT-23
R1, R2, R3, R6, R7, R9, R12, R14, R17, R20, R23: 10k; R_0603_1608Metric
R4, R5, R10, R11, R13, R15, R16, R18, R19, R21, R22, R24, R25: 1k; R_0603_1608Metric
R8: 220R; R_0603_1608Metric
U1: AZ1117-3.3; SOT-223
U2: TJA1051TK-3; DFN-8-1EP_3x3mm_P0.65mm_EP1.55x2.4mm

Connections:
+5V: C1.1, C17.1, J12.4, J15.4, U1.3, U2.3 (VCC)
+12V: C9.1, C14.1, D1.1 (K), D2.1 (K), D5.1 (K), D6.1 (K), D7.1 (K), D8.1 (K), J5.1, J11.1, R10.1
/ADC1: J8.1; also elsewhere on the board
/ADC2: J8.2; also elsewhere on the board
/ADC_DIV1: R14.2, R15.1; also elsewhere on the board
/ADC_DIV2: R17.2, R18.1; also elsewhere on the board
/ADC_DIV3: R20.2, R21.1; also elsewhere on the board
/ADC_DIV4: R23.2, R24.1; also elsewhere on the board
/AS_CS: J13.5; also elsewhere on the board
/AS_MISO: J13.4; also elsewhere on the board
/AS_MOSI: J13.2; also elsewhere on the board
/AS_SCK: J13.3; also elsewhere on the board
/CANH: J12.3, J15.3, R8.1, U2.7 (CANH)
/CANL: J12.2, J15.2, R8.2, U2.6 (CANL)
/CAN_RX: U2.4 (RXD); also elsewhere on the board
/CAN_TX: U2.1 (TXD); also elsewhere on the board
/LED_GREEN: D4.2 (A); also elsewhere on the board
/LED_RED: D3.2 (A); also elsewhere on the board
/LIM1: J7.2, R16.2; also elsewhere on the board
/LIM2: J7.1, R19.2; also elsewhere on the board
/LIM3: J6.2, R22.2; also elsewhere on the board
/LIM4: J6.1, R25.2; also elsewhere on the board
/SP: R12.2, R13.1; also elsewhere on the board
/VALVE1: Q1.1 (G), Q2.1 (G), R1.1; also elsewhere on the board
/VALVE2: Q3.1 (G), Q4.1 (G), R2.1; also elsewhere on the board
/VALVE3: Q5.1 (G), Q6.1 (G), R3.1; also elsewhere on the board
/VALVE4: Q7.1 (G), Q8.1 (G), R6.1; also elsewhere on the board
/VALVE5: Q9.1 (G), Q10.1 (G), R7.1; also elsewhere on the board
/VALVE6: Q11.1 (G), Q13.1 (G), R9.1; also elsewhere on the board
/VALVE_STEERING: Q12.1 (G); also elsewhere on the board
GND: C1.2, C2.2, C3.2, C4.2, C9.2, C14.2, C15.2, C17.2, J5.2, J11.2, J12.1, J13.6, J15.1, Q1.2 (S), Q2.2 (S), Q3.2 (S), Q4.2 (S), Q5.2 (S), Q6.2 (S), Q7.2 (S), Q8.2 (S), Q9.2 (S), Q10.2 (S), Q11.2 (S), Q12.2 (S), Q13.2 (S), R1.2, R2.2, R3.2, R4.1, R5.1, R6.2, R7.2, R9.2, R13.2, R15.2, R18.2, R21.2, R24.2, U1.1, U2.2 (GND), U2.8 (S), U2.9 (GND); also elsewhere on the board
unnamed: C4.1, J4.1, R11.1
unnamed: D1.2 (A), J1.1, Q1.3 (D), Q2.3 (D)
unnamed: D2.2 (A), J1.2, Q3.3 (D), Q4.3 (D)
unnamed: D3.1 (K), R4.2
unnamed: D4.1 (K), R5.2
unnamed: D5.2 (A), J2.1, Q5.3 (D), Q6.3 (D)
unnamed: D6.2 (A), J2.2, Q7.3 (D), Q8.3 (D)
unnamed: D7.2 (A), J3.1, Q9.3 (D), Q10.3 (D)
unnamed: D8.2 (A), J3.2, Q11.3 (D), Q13.3 (D)
unnamed: J4.2, R12.1
unnamed: J9.1, R14.1
unnamed: J9.2, R17.1
unnamed: J10.1, R20.1
unnamed: J10.2, R23.1
unnamed: Q12.3 (D), R10.2, R11.2
VCC: C2.1, C3.1, C15.1, J13.1, R16.1, R19.1, R22.1, R25.1, U1.2, U2.5 (VIO); also elsewhere on the board

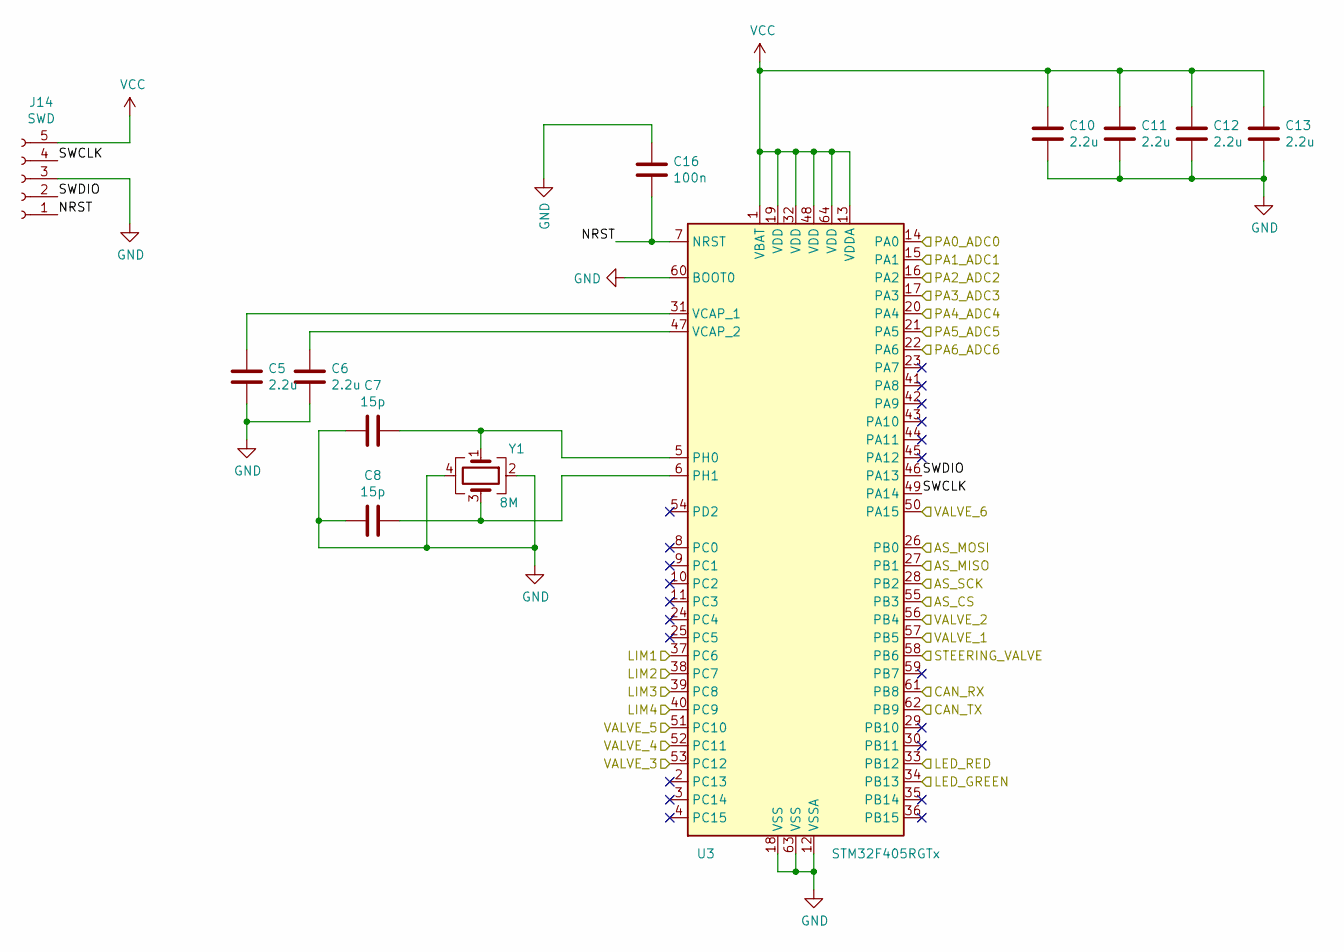
[picture p90: schematic mcu.sch]

Parts:
C5, C6, C10, C11, C12, C13: 2.2u; C_0603_1608Metric
C7, C8: 15p; C_0603_1608Metric
C16: 100n; C_0603_1608Metric
J14: SWD; JST_PH_B5B-PH-K_1x05_P2.00mm_Vertical
U3: STM32F405RGTx; LQFP-64_10x10mm_P0.5mm
Y1: 8M; Crystal_SMD_Abracon_ABM3C-4Pin_5.0x3.2mm

Connections:
/ADC1: U3.20 (PA4); also elsewhere on the board
/ADC2: U3.21 (PA5); also elsewhere on the board
/ADC_DIV1: U3.14 (PA0); also elsewhere on the board
/ADC_DIV2: U3.15 (PA1); also elsewhere on the board
/ADC_DIV3: U3.16 (PA2); also elsewhere on the board
/ADC_DIV4: U3.17 (PA3); also elsewhere on the board
/AS_CS: U3.55 (PB3); also elsewhere on the board
/AS_MISO: U3.27 (PB1); also elsewhere on the board
/AS_MOSI: U3.26 (PB0); also elsewhere on the board
/AS_SCK: U3.28 (PB2); also elsewhere on the board
/CAN_RX: U3.61 (PB8); also elsewhere on the board
/CAN_TX: U3.62 (PB9); also elsewhere on the board
/LED_GREEN: U3.34 (PB13); also elsewhere on the board
/LED_RED: U3.33 (PB12); also elsewhere on the board
/LIM1: U3.37 (PC6); also elsewhere on the board
/LIM2: U3.38 (PC7); also elsewhere on the board
/LIM3: U3.39 (PC8); also elsewhere on the board
/LIM4: U3.40 (PC9); also elsewhere on the board
/SP: U3.22 (PA6); also elsewhere on the board
/VALVE1: U3.57 (PB5); also elsewhere on the board
/VALVE2: U3.56 (PB4); also elsewhere on the board
/VALVE3: U3.53 (PC12); also elsewhere on the board
/VALVE4: U3.52 (PC11); also elsewhere on the board
/VALVE5: U3.51 (PC10); also elsewhere on the board
/VALVE6: U3.50 (PA15); also elsewhere on the board
/VALVE_STEERING: U3.58 (PB6); also elsewhere on the board
/mcu/NRST: C16.2, J14.1, U3.7 (NRST)
/mcu/SWCLK: J14.4, U3.49 (PA14)
/mcu/SWDIO: J14.2, U3.46 (PA13)
GND: C5.2, C6.2, C7.2, C8.2, C10.2, C11.2, C12.2, C13.2, C16.1, J14.3, U3.12 (VSSA), U3.18 (VSS), U3.60 (BOOT0), U3.63 (VSS), Y1.2, Y1.4; also elsewhere on the board
unnamed: C5.1, U3.31 (VCAP_1)
unnamed: C6.1, U3.47 (VCAP_2)
unnamed: C7.1, U3.5 (PH0), Y1.1
unnamed: C8.1, U3.6 (PH1), Y1.3
VCC: C10.1, C11.1, C12.1, C13.1, J14.5, U3.1 (VBAT), U3.13 (VDDA), U3.19 (VDD), U3.32 (VDD), U3.48 (VDD), U3.64 (VDD); also elsewhere on the board

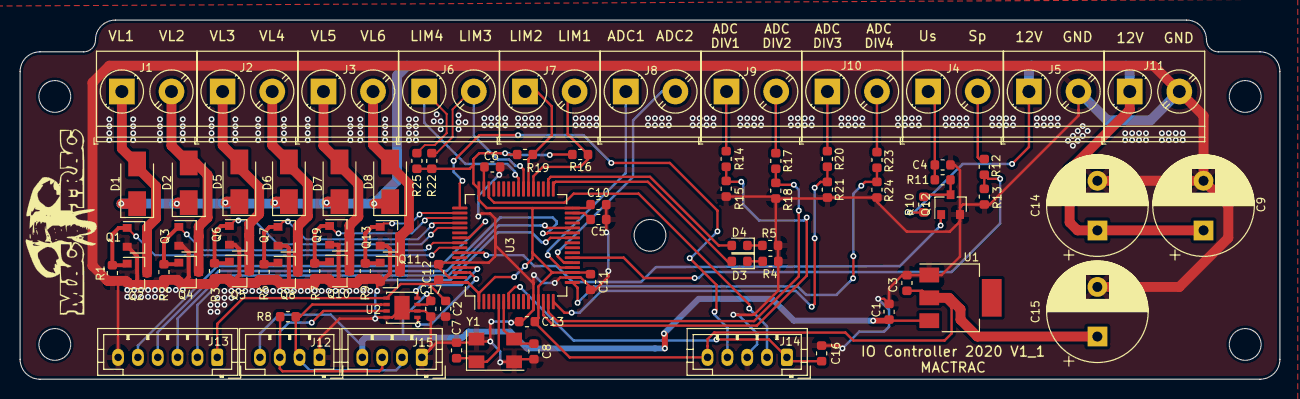
[picture p91: board io_board.kicad_pcb from above]

Board: 2 copper layers, 127.0 x 36.2 mm, 87 parts (0 on the bottom side), 54 nets.
