vedderb/rise_sdvp/Hardware/f9p_board/f9p_board.kicad_pcb

## KiCad design Hardware/f9p_board/f9p_board.kicad_pcb (2020-01-14)

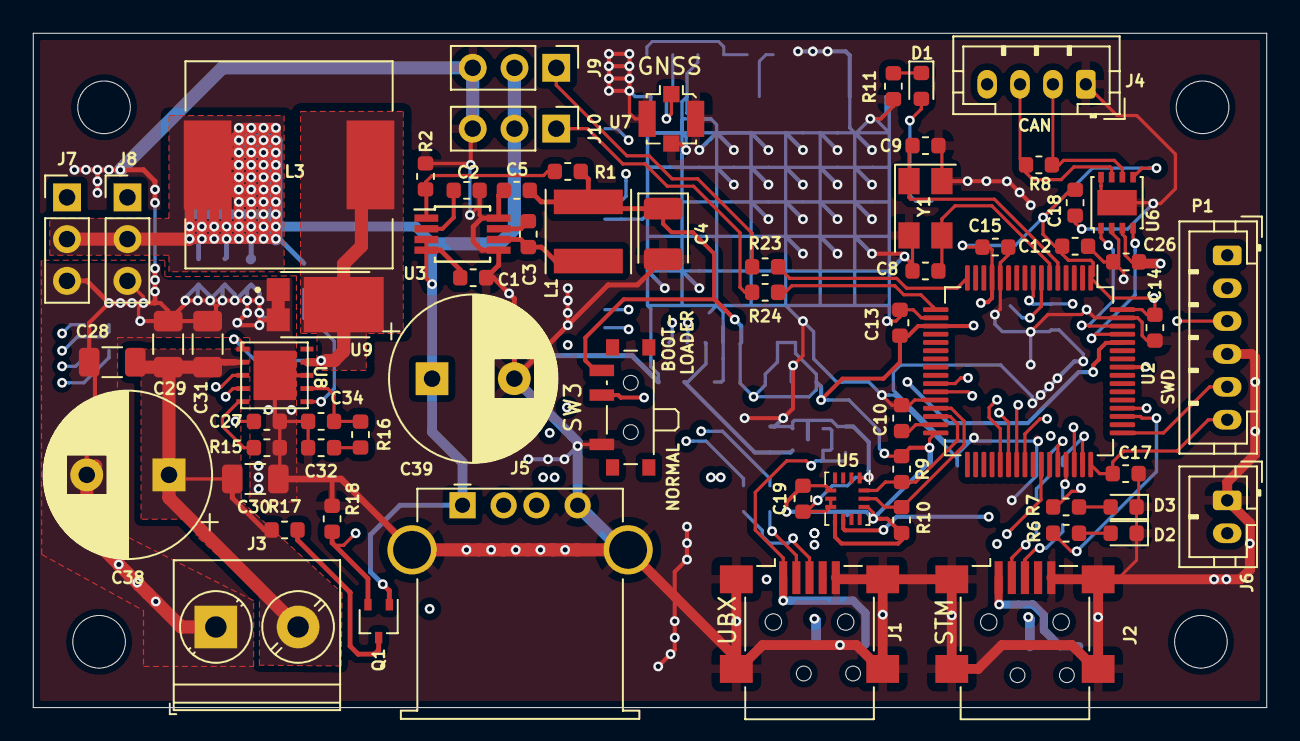
[picture p92: board f9p_board.kicad_pcb from above]

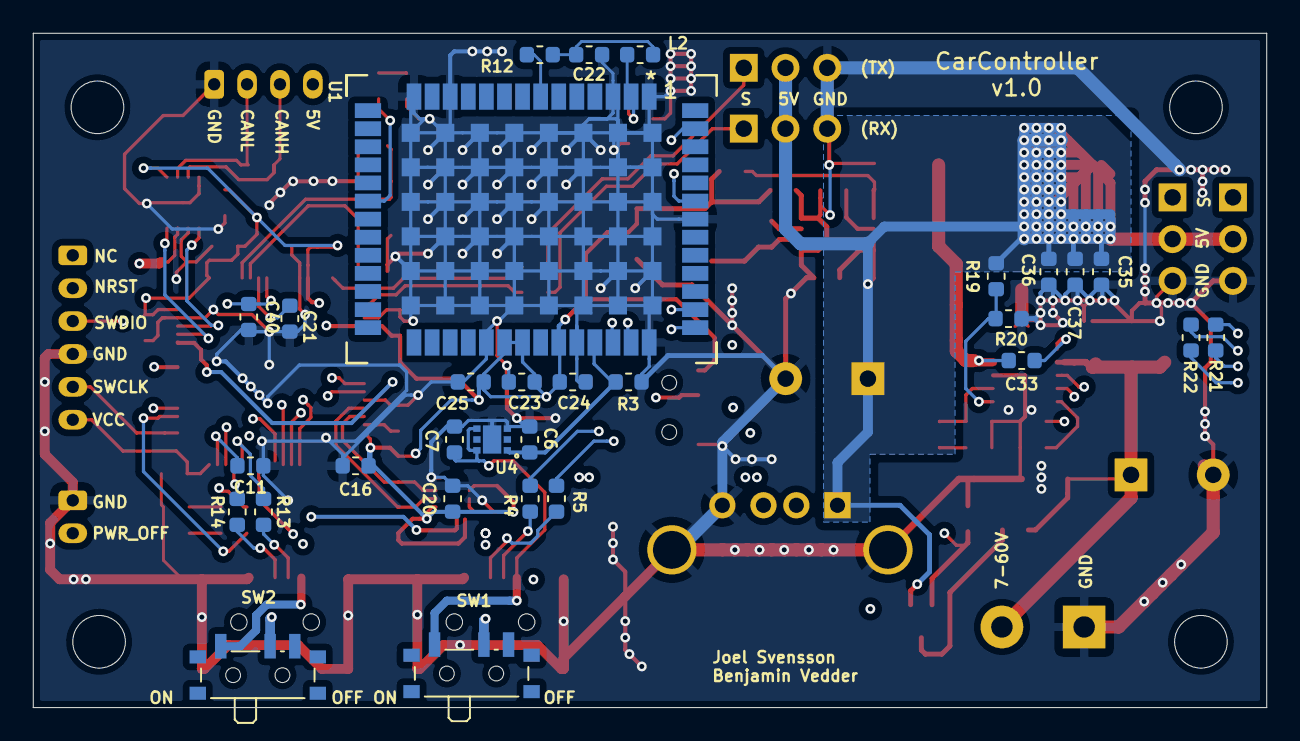
[picture p93: board f9p_board.kicad_pcb from below]

Board: 4 copper layers, 75.0 x 41.0 mm, 99 parts (30 on the bottom side), 65 nets.

Parts:
C1, C2, C5, C6, C7, C10, C11, C12, C13, C14, C15, C16, C17, C18, C19, C20, C23, C24, C25, C26, C35, C36, C37: 2.2u; C_0603_1608Metric
C3, C21, C22: 100n; C_0603_1608Metric
C4: 100u; CP_EIA-3528-12_Kemet-T
C8, C9: 15p; C_0603_1608Metric
C27: 0.01u; C_0603_1608Metric
C28, C29, C30, C31: 2.2u; C_1206_3216Metric
C32: 4700p; C_0603_1608Metric
C33, C40: 0.1u; C_0603_1608Metric
C34: 47p; C_0603_1608Metric
C38: 100u; CP_Radial_D10.0mm_P5.00mm
C39: 470u; CP_Radial_D10.0mm_P5.00mm
D1, D2: RED; LED_0603_1608Metric
D3: GREEN; LED_0603_1608Metric
H1, H2, H3, H4: MountingHole; MountingHole_3.2mm_M3
J1, J2: USB_B_Mini; USB_Mini-B_Lumberg_2486_01_Horizontal
J3: BAT_CONN; TerminalBlock_Phoenix_PT-1,5-2-5.0-H_1x02_P5.00mm_Horizontal
J4: CAN; JST_PH_B4B-PH-K_1x04_P2.00mm_Vertical
J5: USB_A_PWR_OUTPUT; USB_A_Stewart_SS-52100-001_Horizontal
J6: EN_BAT_VIN; JST_PH_B2B-PH-K_1x02_P2.00mm_Vertical
J7: SERV_0; PinHeader_1x03_P2.54mm_Vertical
J8: SERV_1; PinHeader_1x03_P2.54mm_Vertical
J9: SERV_2; PinHeader_1x03_P2.54mm_Vertical
J10: SERV_3; PinHeader_1x03_P2.54mm_Vertical
L1: 22u; L_Taiyo-Yuden_MD-5050
L2: 56n; L_0603_1608Metric
L3: 7.2u; L_12x12mm_H8mm
P1: SWD; JST_PH_B6B-PH-K_1x06_P2.00mm_Vertical
Q1: DMN62D0UW-7; SOT-323_SC-70
R1: 33k; R_0603_1608Metric
R2: 10k; R_0603_1608Metric
R3: 100K; R_0603_1608Metric
R4, R5: 27 Ohm; R_0603_1608Metric
R6, R7, R9, R10: 1K; R_0603_1608Metric
R8, R21, R22, R23, R24: 220R; R_0603_1608Metric
R11: 1k; R_0603_1608Metric
R12: 4.7R; R_0603_1608Metric
R13, R14: 22R; R_0603_1608Metric
R15: 243k; R_0603_1608Metric
R16: 16.9k; R_0603_1608Metric
R17: 39k; R_0603_1608Metric
R18: 2.2k; R_0603_1608Metric
R19: 53.6k; R_0603_1608Metric
R20: 10.2k; R_0603_1608Metric
SW1: F9P_USB_POWER; SW_SPDT_PCM12
SW2: MCU_USB_POWER; SW_SPDT_PCM12
SW3: BOOT0; SW_SPDT_PCM12
U1: Ublox_ZED_F9P; UBLOX_ZED_F9P
U2: STM32F405RGTx; LQFP-64_10x10mm_P0.5mm
U3: MCP16311MS; MSOP-8_3x3mm_P0.65mm
U4: ncv8705; WDFN6
U5: BMI160; Bosch_LGA-14_3x2.5mm_P0.5mm
U6: TJA1051TK-3; DFN-8-1EP_3x3mm_P0.65mm_EP1.55x2.4mm
U7: uFL_conn; U.FL_Molex_MCRF_73412-0110_Vertical
U8: TPS54561DPRR; TI-DPR
U9: PDS760-13; POWERDI5
Y1: 8Mhz; Crystal_SMD_5032-4Pin_5.0x3.2mm

Connections:
BAT_VIN: C28.1, C29.1, C30.1, C31.1, C38.1, J3.2, R17.1, U8.2
CANH: J4.3, R8.1, U6.7
CANL: J4.2, R8.2, U6.6
CAN_RX: U2.61, U6.4
CAN_TX: U2.62, U6.1
F9P_3v3: C6.1, R3.1, U1.38, U4.1
F9P_RESET_N: U1.49, U2.40
F9P_USB_DM: J1.2, R4.1
F9P_USB_DP: J1.3, R5.1
F9P_USB_VBUS: C7.1, J1.1, SW1.1, U4.4, U4.6
FB: R19.1, R20.2, U8.6
GND: C1.2, C2.2, C4.2, C5.2, C6.2, C7.2, C8.1, C9.1, C10.2, C11.2, C12.2, C13.2, C14.2, C15.2, C16.2, C17.2, C18.2, C19.2, C20.2, C21.1, C22.2, C23.1, C24.1, C25.1, C26.1, C27.2, C28.2, C29.2, C30.2, C31.2, C32.2, C34.2, C35.2, C36.2, C37.2, C38.2, C39.2, C40.2, D2.1, D3.1, J1.5, J1.6, J2.5, J2.6, J3.1, J4.1, J5.4, J5.5, J6.1, J7.3, J8.3, J9.3, J10.3, P1.4, R2.1, R3.2, R11.2, R15.2, R18.2, R20.1, SW3.1, U1.0, U1.1, U1.3, U1.12, U1.14, U1.32, U1.37, U1.41, U1.48, U2.12, U2.18, U2.28, U2.63, U3.5, U3.8, U4.3, U4.GND, U5.1, U5.6, U5.7, U6.2, U6.8, U6.9, U7.2, U8.8, U8.11, U9.1, U9.2, Y1.2, Y1.4
IMU_INT2: U2.57, U5.9
LED0: R6.2, U2.51
LED1: R7.2, U2.52
MCU_RX_F9P_TX: U1.42, U2.38
MCU_TX_F9P_RX: U1.43, U2.37
MCU_USB_DM: J2.2, R13.1
MCU_USB_DP: J2.3, R14.1
MCU_USB_VBUS: J2.1, SW2.1
NRST: C21.2, P1.2, U2.7
unnamed: C2.1, U3.2
unnamed: C3.1, U3.7
unnamed: C3.2, L1.2, U3.6
unnamed: C8.2, U2.6, Y1.3
unnamed: C9.2, U2.5, Y1.1
unnamed: C10.1, U2.31
unnamed: C11.1, U2.47
unnamed: C22.1, L2.2, R12.2
unnamed: C27.1, U8.4
unnamed: C32.1, R16.2
unnamed: C33.1, U8.1
unnamed: C34.1, R16.1, U8.7
unnamed: D1.1, R11.1
unnamed: D1.2, U1.20
unnamed: D2.2, R6.1
unnamed: D3.2, R7.1
unnamed: J6.2, U8.3
unnamed: J7.1, R21.1
unnamed: J8.1, R22.1
unnamed: J9.1, R23.1
unnamed: J10.1, R24.1
unnamed: L2.1, U1.2, U7.1
unnamed: Q1.3, R17.2
unnamed: R1.1, R2.2, U3.1
unnamed: R4.2, U1.39
unnamed: R5.2, U1.40
unnamed: R12.1, U1.7
unnamed: R13.2, U2.44
unnamed: R14.2, U2.45
unnamed: R15.1, U8.5
unnamed: R21.2, U2.26
unnamed: R22.2, U2.27
unnamed: SW3.2, U2.60
PWR_5V: C1.1, C26.2, C35.1, C36.1, C37.1, C39.1, J4.4, J5.1, J7.2, J8.2, J9.2, J10.2, L3.2, Q1.1, R19.2, SW1.2, SW2.2, U2.42, U3.3, U3.4, U6.3
SCL: R10.2, U2.29, U5.13
SDA: R9.2, U2.30, U5.14
SERV_2: R23.2, U2.16
SERV_3: R24.2, U2.17
SW: C33.2, L3.1, U8.9, U9.3
SWCLK: P1.5, U2.49
SWDIO: P1.3, U2.46
TIMEPULSE: U1.53, U2.39
VCC: C4.1, C5.1, C12.1, C13.1, C14.1, C15.1, C16.1, C17.1, C18.1, C19.1, C20.1, C23.2, C24.2, C25.2, L1.1, P1.6, R1.2, R9.1, R10.1, SW3.3, U1.33, U1.34, U1.36, U2.1, U2.13, U2.19, U2.32, U2.48, U2.64, U5.5, U5.8, U5.12, U6.5
VOLT_METER: C40.1, Q1.2, R18.1, U2.8
