vedderb/rise_sdvp/Hardware/Controller/RCCAR_IF_Board_GPS.kicad_pcb

## KiCad design Hardware/Controller/RCCAR_IF_Board_GPS.kicad_pcb (2017-10-20)

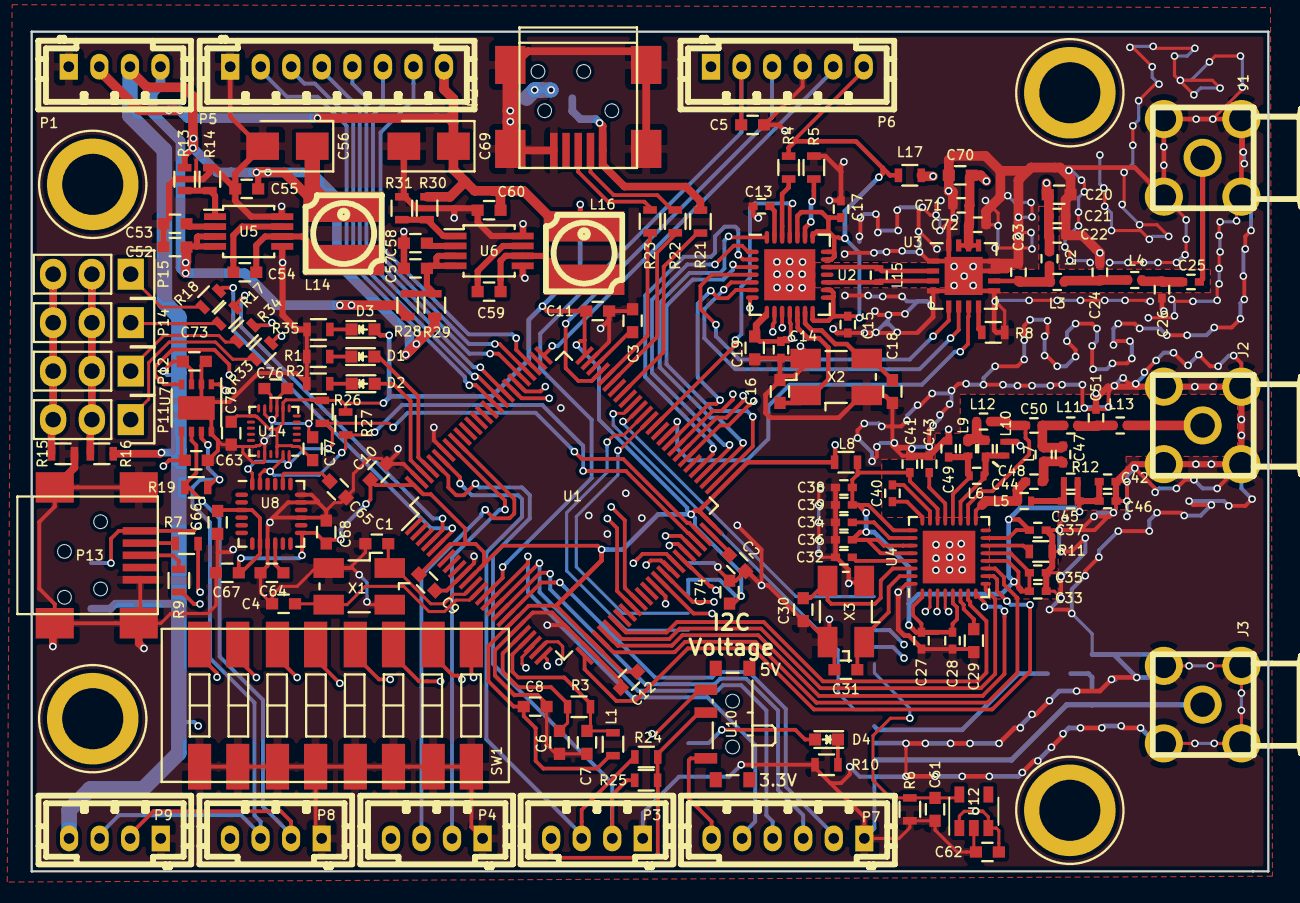
[picture p94: board RCCAR_IF_Board_GPS.kicad_pcb from above]

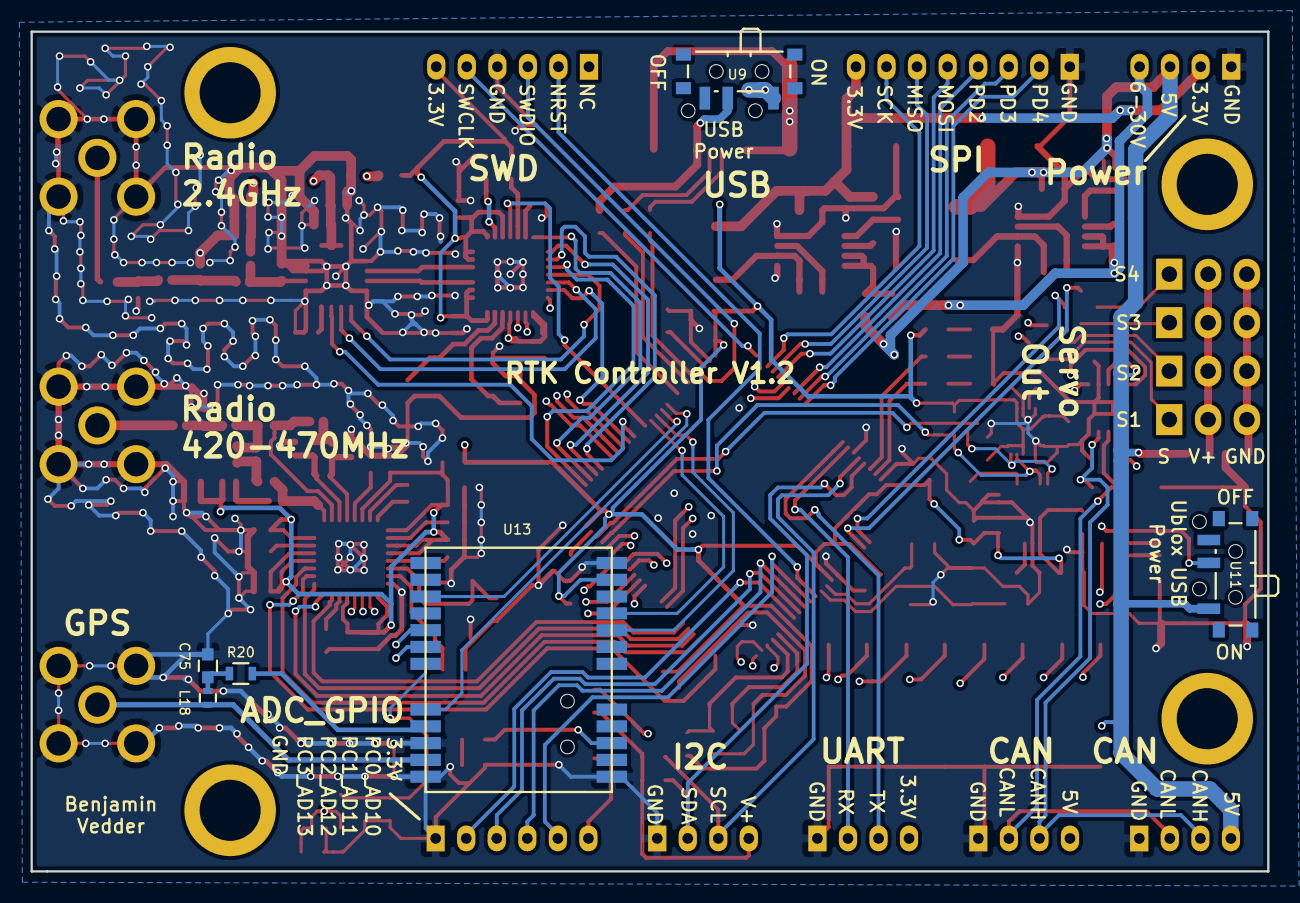
[picture p95: board RCCAR_IF_Board_GPS.kicad_pcb from below]

Board: 4 copper layers, 81.0 x 55.0 mm, 173 parts (6 on the bottom side), 143 nets.

Parts:
1PIN, 1PIN#2, 1PIN#3, 1PIN#4: P***; 1pin_4mm
C1, C4, C16, C18, C30, C31: 15p; C_0603
C2, C3, C6, C7, C8, C9, C10, C11, C12, C19, C20, C29, C52, C53, C55, C57, C58, C60, C61, C62, C63, C64, C66, C67, C68, C70, C73, C74, C77, C78: 2.2u; C_0603
C5, C54, C59, C65, C75, C76: 100n; C_0603
C13, C14, C15, C17, C27, C28, C32, C33, C34, C35, C36, C37, C38, C39, C41, C42, C43: 100n; C_0402
C21, C71: 1n; C_0402
C22, C72: 12p; C_0402
C23, C24, C47: 2.2p; C_0402
C25: 18p; C_0402
C26: 0.2p; C_0402
C40: 1.8n; C_0402
C44: 39p; C_0402
C45: 56p; C_0402
C46: 100p; C_0402
C48, C49, C50: 5.1p; C_0402
C51: 6.2p; C_0402
C56, C69: 100u; Tantalum_Case-B_EIA-3528-21_Wave
D1, D4: RED; LED_0603
D2: GREEN; LED_0603
D3: BLUE; LED_0603
J1, J2, J3: SMA; sma_90_crf
L1, L8, L17: BEAD; R_0603
L2: 4.7n; R_0402
L3: 1n; R_0402
L4: 2n; R_0402
L5, L6, L18: 56n; R_0402
L7, L12: 15n; R_0402
L9, L10: 27n; R_0402
L11: 43n; R_0402
L13: 22n; R_0402
L14, L16: 22U; inductor_smd_4.8x2.8mm
L15: DNM; R_0402
P1: POWER; b4b-ph-kl
P2: USB_STM; USB_Mini-B
P3: I2C; b4b-ph-kl
P4: UART; b4b-ph-kl
P5: NRF_SPI; b8b-ph-kl
P6: SWD; b6b-ph-kl
P7: ADC_GPIO; b6b-ph-kl
P8, P9: CAN; b4b-ph-kl
P11: OUT_1; Pin_Header_Straight_1x03
P12: OUT_2; Pin_Header_Straight_1x03
P13: USB_UBLOX; USB_Mini-B
P14: OUT_3; Pin_Header_Straight_1x03
P15: OUT_4; Pin_Header_Straight_1x03
R1, R2, R6, R10, R24, R25, R26, R27, R35: 1k; R_0603
R3: 4R7; R_0603
R4, R14, R31: 10k; R_0603
R5, R11: 56k; R_0603
R7, R9, R21, R22, R23: 22R; R_0603
R8: 3.9k; R_0603
R12: 18R; R_0402
R13: 52.3k; R_0603
R15, R16, R28, R29: 0R; R_0603
R17, R18, R19, R33, R34: 220R; R_0603
R20: 4.7R; R_0603
R30: 33k; R_0603
SW1: Address; SW_DIP_SMD_x8_Slide
U1: STM32F40X_LQFP100; LQFP-100_14x14mm_Pitch0.5mm
U2: CC2520; QFN-28-1EP_5x5mm_Pitch0.5mm
U3: CC2592; QFN-16-1EP_4x4mm_Pitch0.65mm
U4: CC1120; QFN-32-1EP_5x5mm_Pitch0.5mm
U5, U6: MCP16311/2; MSOP-8_3x3mm_Pitch0.65mm
U7: TJA1051TK3; DFN-8-1EP_3x3mm_Pitch0.65mm
U8: MPU9150; QFN-24-1EP_4x4mm_Pitch0.5mm
U9, U11: USB_SUPPLY; SW_SPDT_PCM12
U10: I2C_VOLTAGE; SW_SPDT_PCM12
U12: AP131-33; SOT-23-5
U13: ublox_neo_m8p; ublox_neo
U14: MPU9250; QFN-24_3x3mm_Pitch0.4mm
X1: 8M; Crystal_SMD_5032_4Pads
X2, X3: 32M; Crystal_SMD_5032_4Pads

Connections:
+5V: C55.1, C56.1, C73.1, L14.1, P1.3, P8.4, P9.4, R13.2, R16.1, R29.2, U7.3, U9.1, U10.3, U11.1
+BATT: C52.1, P1.4, R28.2, U5.3, U5.4
/CAN/CANH: P8.3, P9.3, R19.1, U7.7
/CAN/CANL: P8.2, P9.2, R19.2, U7.6
/CAN/CAN_RX: U1.81, U7.4
/CAN/CAN_TX: U1.82, U7.1
/CC1120/CS_N: U1.29, U4.11
/CC1120/GPIO0: U1.26, U4.10
/CC1120/GPIO2: U1.25, U4.4
/CC1120/GPIO3: U1.24, U4.3
/CC1120/V_REG: C27.1, C28.1, C33.1, C35.1, C36.1, C37.1, C38.1, C39.1, C41.1, C42.1, C45.2, C46.1, L8.1, R12.2, U4.1, U4.5, U4.12, U4.13, U4.15, U4.22, U4.25, U4.27, U4.28
/CC2520/CC_CS_N: U1.51, U2.3
/CC2520/CC_GPIO0: U1.56, U2.10
/CC2520/CC_GPIO1: U1.57, U2.9
/CC2520/CC_GPIO2: U1.58, U2.7
/CC2520/CC_GPIO3: U1.59, U2.6
/CC2520/CC_RESET: U1.62, U2.25
/CC2520/CC_SCLK: U1.52, U2.28
/CC2520/CC_SI: U1.54, U2.2
/CC2520/CC_SO: U1.53, U2.1
/CC2520/HGM: U1.60, U3.7
/CC2520/LNA_EN: U2.5, U3.6
/CC2520/PA_EN: U2.4, U3.5
/CC2520/VDD_CC2592: C20.2, C21.2, C22.2, C70.2, C71.2, C72.2, L2.2, L17.2, U3.13, U3.14, U3.15
/MCU/NRST: C5.2, P6.2, U1.14
/MCU/PA0: U1.23, U4.2
/MCU/PA5_SCK1: U1.30, U4.8
/MCU/PA6_MISO1: U1.31, U4.9
/MCU/PA7_MOSI1: U1.32, U4.7
/MCU/PB6_TX1: P4.3, U1.92
/MCU/PB7_RX1: P4.2, U1.93
/MCU/PB8_SCL1: P3.3, R24.2, U1.95
/MCU/PB9_SDA1: P3.2, R25.2, U1.96
/MCU/PB10_SCL2: R27.1, U1.47, U8.23, U14.23
/MCU/PB11_SDA2: R26.1, U1.48, U8.24, U14.24
/MCU/PC0_ADC123_IN10: P7.5, U1.15
/MCU/PC1_ADC123_IN11: P7.4, U1.16
/MCU/PC2_ADC123_IN12: P7.3, U1.17
/MCU/PC3_ADC123_IN13: P7.2, U1.18
/MCU/PC6_TX6: U1.63, U13.21
/MCU/PC7_RX6: U1.64, U13.20
/MCU/PC8: U1.65, U13.3
/MCU/PC9: U1.66, U13.8
/MCU/PC10_SCK3: P5.7, U1.78
/MCU/PC11_MISO3: P5.6, U1.79
/MCU/PC12_MOSI3: P5.5, U1.80
/MCU/PD2: P5.4, U1.83
/MCU/PD3: P5.3, U1.84
/MCU/PD4: P5.2, U1.85
/MCU/PE0: D1.2, U1.97
/MCU/PE1: D2.2, U1.98
/MCU/PE8: SW1.16, U1.39
/MCU/PE9: SW1.15, U1.40
/MCU/PE10: SW1.14, U1.41
/MCU/PE11: SW1.13, U1.42
/MCU/PE12: SW1.12, U1.43
/MCU/PE13: SW1.11, U1.44
/MCU/PE14: SW1.10, U1.45
/MCU/PE15: SW1.9, U1.46
/MCU/SWCLK: P6.5, U1.76
/MCU/SWDIO: P6.3, U1.72
/MCU/USB_DM: R22.1, U1.70
/MCU/USB_DP: R23.1, U1.71
/MCU/USB_VP: R21.1, U1.68
/SERVO_IO/OUT_1: R33.2, U1.35
/SERVO_IO/OUT_2: R34.2, U1.36
/SERVO_IO/OUT_3: R17.2, U1.4
/SERVO_IO/OUT_4: R18.2, U1.5
/ublox/RTK_STAT: D4.2, U13.15
/ublox/USB_DM: R7.2, U13.5
/ublox/USB_DP: R9.2, U13.6
/ublox/VDD_USB: C61.1, R6.1, U12.5, U13.7
GND: C1.2, C2.1, C3.1, C4.2, C5.1, C6.2, C7.1, C8.1, C9.1, C10.1, C11.1, C12.1, C13.1, C14.1, C15.1, C16.2, C17.1, C18.2, C19.1, C20.1, C21.1, C22.1, C23.1, C24.1, C26.1, C27.2, C28.2, C29.1, C30.1, C31.1, C32.1, C33.2, C34.1, C35.2, C36.2, C37.2, C38.2, C39.2, C41.2, C42.2, C43.2, C46.2, C49.1, C51.2, C52.2, C53.2, C55.2, C56.2, C57.2, C58.2, C60.2, C61.2, C62.2, C63.2, C64.2, C65.2, C66.1, C67.1, C68.1, C69.2, C70.1, C71.1, C72.1, C73.2, C74.2, C75.2, C76.2, C77.2, C78.2, J1.2, J2.2, J3.2, L10.1, P1.1, P2.5, P2.6, P3.1, P4.1, P5.1, P6.4, P7.1, P8.1, P9.1, P13.5, P13.6, R1.2, R2.2, R5.2, R6.2, R8.2, R10.2, R11.2, R14.1, R15.1, R31.1, R35.2, SW1.1, SW1.2, SW1.3, SW1.4, SW1.5, SW1.6, SW1.7, SW1.8, U1.10, U1.20, U1.27, U1.74, U1.94, U1.99, U2.29, U3.1, U3.4, U3.9, U3.11, U3.12, U3.16, U3.17, U4.32, U4.33, U5.5, U5.8, U6.5, U6.8, U7.2, U7.8, U7.9, U8.9, U8.15, U8.17, U8.18, U12.2, U13.10, U13.12, U13.13, U13.24, U14.9, U14.11, U14.18, U14.20, X1.3, X2.3, X3.3
unnamed: C1.1, U1.12, X1.1
unnamed: C2.2, U1.49
unnamed: C3.2, U1.73
unnamed: C4.1, U1.13, X1.2
unnamed: C6.1, R3.2, U1.21
unnamed: C7.2, L1.2, R3.1, U1.22
unnamed: C13.2, U2.27
unnamed: C16.1, U2.12, X2.1
unnamed: C18.1, U2.13, X2.2
unnamed: C23.2, L2.1, L3.1, U3.10
unnamed: C24.2, L3.2, L4.1
unnamed: C25.1, C26.2, L4.2
unnamed: C25.2, J1.1
unnamed: C29.2, U4.6
unnamed: C30.2, U4.30, X3.2
unnamed: C31.2, U4.31, X3.1
unnamed: C32.2, U4.29
unnamed: C34.2, U4.26
unnamed: C40.1, U4.24
unnamed: C40.2, U4.23
unnamed: C43.1, U4.21
unnamed: C44.1, C47.2, L7.2
unnamed: C44.2, L5.1, U4.17
unnamed: C45.1, L5.2, R12.1
unnamed: C47.1, C50.2, L7.1, L11.2
unnamed: C48.1, L9.1, L12.1
unnamed: C48.2, L6.2, L10.2, U4.19
unnamed: C49.2, L6.1, L9.2, U4.20
unnamed: C50.1, L12.2, U4.18
unnamed: C51.1, L11.1, L13.2
unnamed: C53.1, U5.2
unnamed: C54.1, U5.7
unnamed: C54.2, L14.2, U5.6
unnamed: C57.1, R28.1, R29.1, U6.3, U6.4
unnamed: C58.1, U6.2
unnamed: C59.1, U6.7
unnamed: C59.2, L16.2, U6.6
unnamed: C62.1, P13.1, U11.2, U12.1, U12.3
unnamed: C64.1, U8.10
unnamed: C65.1, U8.20
unnamed: C75.1, L18.1, R20.1
unnamed: C76.1, U14.10
unnamed: D1.1, R1.1
unnamed: D2.1, R2.1
unnamed: D3.1, R35.1
unnamed: D4.1, R10.1
unnamed: J2.1, L13.1
unnamed: J3.1, L18.2, U13.11
unnamed: L15.1, U2.19, U3.2
unnamed: L15.2, U2.17, U3.3
unnamed: P2.1, R21.2, U9.2
unnamed: P2.2, R22.2
unnamed: P2.3, R23.2
unnamed: P3.4, R24.1, R25.1, U10.2
unnamed: P11.1, R33.1
unnamed: P11.2, P12.2, P14.2, P15.2, R16.2
unnamed: P11.3, P12.3, P14.3, P15.3, R15.2
unnamed: P12.1, R34.1
unnamed: P13.2, R7.1
unnamed: P13.3, R9.1
unnamed: P14.1, R17.1
unnamed: P15.1, R18.1
unnamed: R4.2, U2.26
unnamed: R5.1, U2.23
unnamed: R8.1, U3.8
unnamed: R11.1, U4.14
unnamed: R13.1, R14.2, U5.1
unnamed: R20.2, U13.9
unnamed: R30.1, R31.2, U6.1
VCC: C8.2, C9.2, C10.2, C11.2, C12.2, C14.2, C15.2, C17.2, C19.2, C60.1, C63.1, C66.2, C67.2, C68.2, C69.1, C74.1, C77.1, C78.1, D3.2, L1.1, L8.2, L16.1, L17.1, P1.2, P4.4, P5.8, P6.6, P7.6, R4.1, R26.2, R27.2, R30.2, U1.6, U1.11, U1.19, U1.28, U1.50, U1.75, U1.100, U2.8, U2.11, U2.14, U2.15, U2.16, U2.20, U2.21, U2.22, U2.24, U7.5, U8.3, U8.8, U8.13, U10.1, U13.22, U13.23, U14.1, U14.8, U14.13, U14.22
