vedderb/rise_sdvp/Hardware/uwb_pcb/uwb_pcb.kicad_pcb

## KiCad design Hardware/uwb_pcb/uwb_pcb.kicad_pcb (2018-05-23, an earlier design)

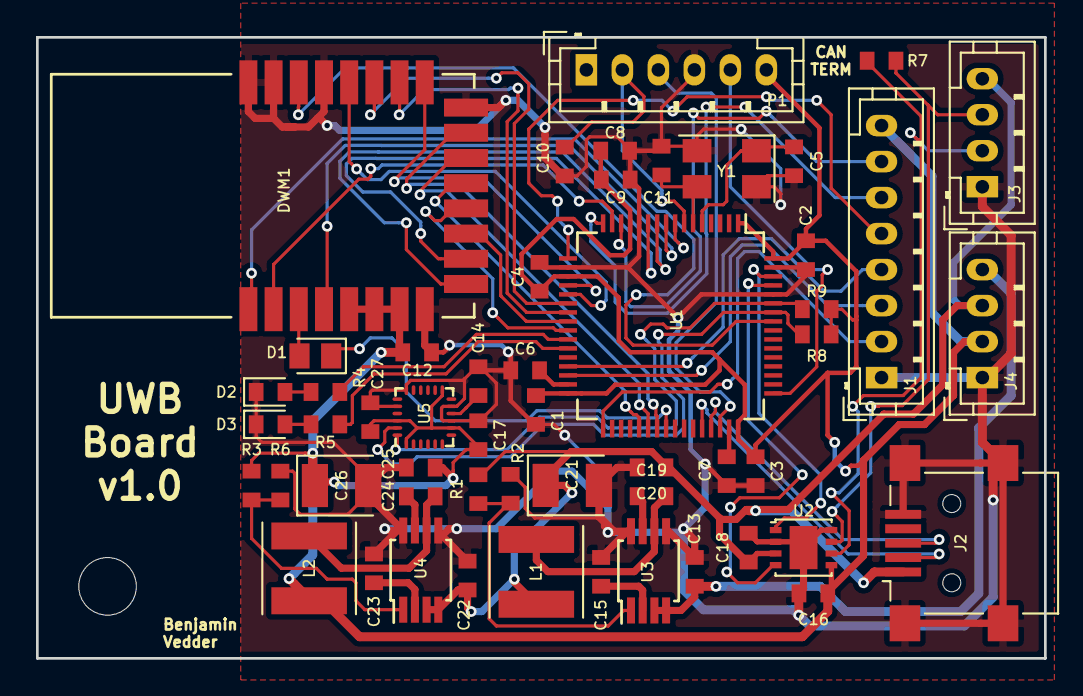
[picture p96: board uwb_pcb.kicad_pcb from above]

Board: 2 copper layers, 56.0 x 34.5 mm, 54 parts (0 on the bottom side), 55 nets.

Parts:
C1, C2, C3, C4, C6, C7, C8, C9, C12, C13, C15, C16, C17, C18, C20, C22, C23, C25, C27: 2.2u; C_0603_1608Metric
C5, C11: 15p; C_0603_1608Metric
C10, C14, C19, C24: 100n; C_0603_1608Metric
C21, C26: 100u; CP_EIA-3528-12_Kemet-T
D1: D_Schottky; D_0805_2012Metric
D2: RED; LED_0603_1608Metric
D3: GREEN; LED_0603_1608Metric
DWM1: DWM1000
J1: COMM; JST_PH_B8B-PH-K_1x08_P2.00mm_Vertical
J2: USB_B_Mini; USB_Mini-B_Lumberg_2486_01_Horizontal
J3: CAN; JST_PH_B4B-PH-K_1x04_P2.00mm_Vertical
J4: PWR; JST_PH_B4B-PH-K_1x04_P2.00mm_Vertical
L1, L2: 22U; L_Taiyo-Yuden_MD-5050
MK1: Mounting_Hole; MountingHole_3.2mm_M3
P1: SWD; JST_PH_B6B-PH-K_1x06_P2.00mm_Vertical
R1: 52.3k; R_0603_1608Metric
R2, R6: 10k; R_0603_1608Metric
R3: 33k; R_0603_1608Metric
R4, R5, R8, R9: 1k; R_0603_1608Metric
R7: 220R; R_0603_1608Metric
U1: STM32F40X_LQFP64; LQFP-64_10x10mm_P0.5mm
U2: TJA1051TK-3; DFN-8-1EP_3x3mm_P0.65mm_EP1.55x2.4mm
U3, U4: MCP16311/2; MSOP-8_3x3mm_P0.65mm
U5: MPU9250; QFN-24-1EP_3x3mm_P0.4mm_nopp
Y1: 8M; Crystal_SMD_5032-4Pin_5.0x3.2mm

Connections:
5V: C18.1, C20.1, C21.1, C22.1, J2.1, J3.4, J4.3, L1.1, R1.2, U2.3, U4.3, U4.4
CANH: J3.3, R7.2, U2.7
CANL: J3.2, R7.1, U2.6
CAN_RX: U1.61, U2.4
CAN_TX: U1.62, U2.1
DW_CLK: DWM1.20, U1.21
DW_CS: DWM1.17, U1.20
DW_EXTON: DWM1.1, U1.8
DW_GPIO0: DWM1.15, U1.39
DW_GPIO1: DWM1.14, U1.38
DW_GPIO2: DWM1.13, U1.37
DW_GPIO3: DWM1.12, U1.25
DW_GPIO4: DWM1.11, U1.24
DW_GPIO5: DWM1.10, U1.11
DW_GPIO6: DWM1.9, U1.10
DW_GPIO7: DWM1.4, U1.9
DW_IRQ: DWM1.22, U1.57
DW_MISO: DWM1.19, U1.22
DW_MOSI: DWM1.18, U1.23
DW_RST: D1.1, U1.40
DW_WAKEUP: DWM1.2, U1.15
GND: C1.2, C2.2, C3.2, C4.2, C5.1, C6.1, C7.1, C8.2, C9.2, C10.2, C11.1, C12.2, C13.2, C14.2, C15.2, C16.2, C17.2, C18.2, C20.2, C21.2, C22.2, C23.2, C25.2, C26.2, C27.2, D2.1, D3.1, DWM1.8, DWM1.16, DWM1.21, DWM1.23, DWM1.24, J1.1, J2.5, J2.6, J3.1, J4.1, P1.4, R2.1, R6.1, U1.12, U1.18, U1.60, U1.63, U2.2, U2.8, U2.9, U3.5, U3.8, U4.5, U4.8, U5.9, U5.11, U5.18, U5.20, Y1.2, Y1.4
LED_GREEN: R4.1, U1.26
LED_RED: R5.1, U1.27
NRST: C10.1, P1.2, U1.7
unnamed: C5.2, U1.5, Y1.1
unnamed: C6.2, U1.31
unnamed: C7.2, U1.47
unnamed: C11.2, U1.6, Y1.3
unnamed: C14.1, U5.10
unnamed: C15.1, U3.2
unnamed: C19.1, U3.7
unnamed: C19.2, L1.2, U3.6
unnamed: C23.1, U4.2
unnamed: C24.1, U4.7
unnamed: C24.2, L2.2, U4.6
unnamed: D1.2, DWM1.3
unnamed: D2.2, R4.2
unnamed: D3.2, R5.2
unnamed: R1.1, R2.2, U3.1
unnamed: R3.1, R6.2, U4.1
PA0: J1.7, U1.14
PA2: J1.6, U1.16
PA3: J1.5, U1.17
PB10: J1.4, U1.29
PB11: J1.3, U1.30
PB12: J1.2, U1.33
SCL: R8.1, U1.58, U5.23
SDA: R9.1, U1.59, U5.24
SWCLK: P1.5, U1.49
SWDIO: P1.3, U1.46
USB_DM: J2.2, U1.44
USB_DP: J2.3, U1.45
VCC: C1.1, C2.1, C3.1, C4.1, C8.1, C9.1, C12.1, C16.1, C17.1, C25.1, C26.1, C27.1, DWM1.5, DWM1.6, DWM1.7, J1.8, J4.2, L2.1, P1.6, R3.2, R8.2, R9.2, U1.1, U1.13, U1.19, U1.32, U1.48, U1.64, U2.5, U5.1, U5.8, U5.13, U5.22
V_IN: C13.1, J4.4, U3.3, U3.4
