vedderb/rise_sdvp/Hardware/RFMote_PA/RFMote_PA.kicad_pcb

## KiCad design Hardware/RFMote_PA/RFMote_PA.kicad_pcb (2016-03-22)

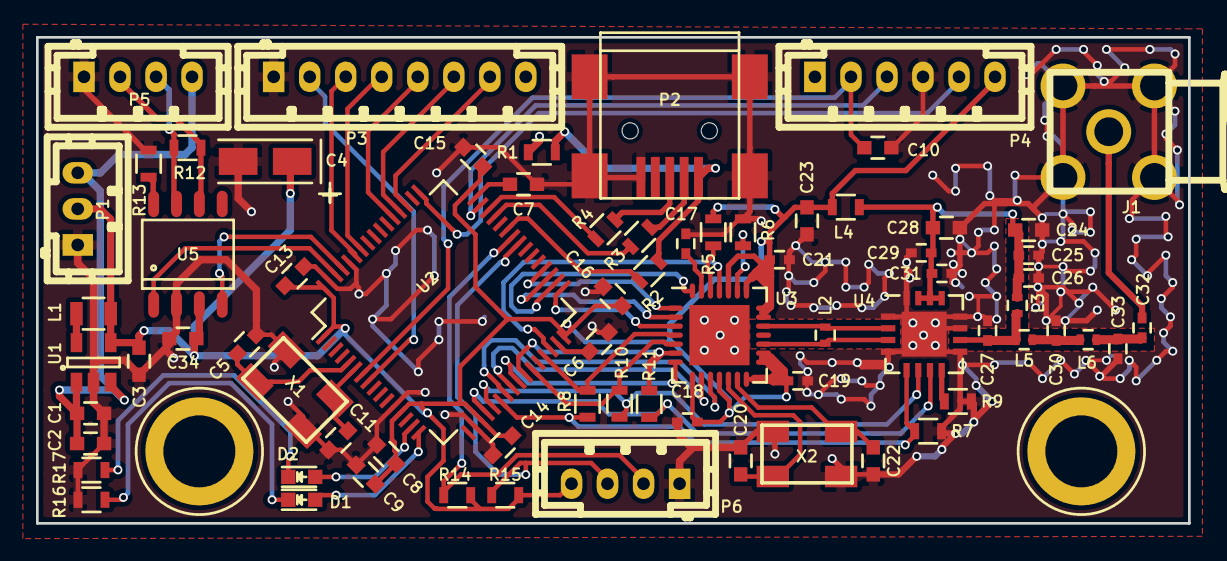
[picture p97: board RFMote_PA.kicad_pcb from above]

Board: 4 copper layers, 64.0 x 27.0 mm, 74 parts (0 on the bottom side), 61 nets.

Parts:
1PIN, 1PIN#2: P***; 1pin_4mm
C1, C2, C3, C6, C7, C8, C9, C13, C14, C15, C16, C23, C24, C28, C34: 2.2u; C_0603
C4: 100u; TantalC_SizeA_EIA-3216_Wave
C5, C11, C20, C22: 15p; C_0603
C10: 100n; C_0603
C17, C18, C19, C21: 100n; C_0402
C25, C29: 1n; C_0402
C26, C31: 12p; C_0402
C27, C30: 2.2p; C_0402
C32: 18p; C_0402
C33: 0.2p; C_0402
D1: RED; LED-0603
D2: GREEN; LED-0603
J1: SMA; sma_90_crf
L1: 2.2u; R_0805
L2: DNM; R_0402
L3: 4.7n; R_0402
L4: BEAD; R_0603
L5: 1n; R_0402
L6: 2n; R_0402
P1: V_IN; b3b-ph-kl
P2: USB_OTG; USB_Mini-B
P3: COMM; b8b-ph-kl
P4: SWD; b6b-ph-kl
P5: CAN; b4b-ph-kl
P6: I2C; b4b-ph-kl
R1: 0R; R_0603
R2, R3, R4: 22R; R_0603
R5, R8, R10, R11, R13: 10k; R_0603
R6, R7: 56k; R_0603
R9: 3.9k; R_0603
R12: 220R; R_0603
R14, R15, R16, R17: 1k; R_0603
U1: LM3671; SOT-23-5
U2: STM32F40X_LQFP64; LQFP-64_10x10mm_Pitch0.5mm
U3: CC2520; QFN-28-1EP_5x5mm_Pitch0.5mm
U4: CC2592; QFN-16-1EP_4x4mm_Pitch0.65mm
U5: MCP2551-I/SN; SO-8
X1: 8m; Crystal_5x3mm_3pin
X2: 32M; Crystal_5x3mm_3pin

Connections:
+5V: C1.1, C2.1, P1.3, P5.4, R1.2, U1.1, U1.3
/CAN/CANH: P5.3, R12.1, U5.7
/CAN/CANL: P5.2, R12.2, U5.6
/CAN/CAN_RX: U2.61, U5.4
/CAN/CAN_TX: U2.62, U5.1
/CC2520/CC_CS_N: U2.33, U3.3
/CC2520/CC_GPIO0: U2.23, U3.10
/CC2520/CC_GPIO1: U2.24, U3.9
/CC2520/CC_GPIO2: U2.25, U3.7
/CC2520/CC_GPIO3: R11.1, U2.26, U3.6
/CC2520/CC_GPIO4: R10.1, U2.27, U3.5
/CC2520/CC_GPIO5: R8.1, U2.29, U3.4
/CC2520/CC_RESET: U2.30, U3.25
/CC2520/CC_SCLK: U2.34, U3.28
/CC2520/CC_SI: U2.35, U3.2
/CC2520/CC_SO: U2.36, U3.1
/CC2520/HGM: R11.2, U2.20, U4.7
/CC2520/LNA_EN: R10.2, U2.21, U4.6
/CC2520/VDD_CC2592: C24.2, C25.2, C26.2, C28.2, C29.2, C31.2, L3.2, L4.2, U4.13, U4.14, U4.15
/MCU/NRST: C10.1, P4.2, U2.7
/MCU/PA1: D2.2, U2.15
/MCU/PA2: D1.2, U2.16
/MCU/PA6: R7.1, R8.2, U2.22, U4.5
/MCU/PA8_SCL3: P6.2, R14.1, U2.41
/MCU/PB6_SCL1: P3.4, U2.58
/MCU/PB7_SDA1: P3.3, U2.59
/MCU/PC0_ADC10: P3.2, U2.8
/MCU/PC9_SDA3: P6.3, R15.1, U2.40
/MCU/PC10_SCK3_TX3: P3.7, U2.51
/MCU/PC11_MISO3_RX3: P3.6, U2.52
/MCU/PC12_MOSI3: P3.5, U2.53
/MCU/SWCLK: P4.5, U2.49
/MCU/SWDIO: P4.3, U2.46
/MCU/USB_DM: R3.1, U2.44
/MCU/USB_DP: R4.1, U2.45
/MCU/USB_VBUS: R2.1, U2.42
GND: C1.2, C2.2, C3.2, C4.2, C5.1, C6.1, C7.1, C8.2, C9.2, C10.2, C11.1, C13.2, C14.2, C15.2, C16.2, C17.1, C18.1, C19.1, C20.2, C21.1, C22.2, C23.1, C24.1, C25.1, C26.1, C27.1, C28.1, C29.1, C30.1, C31.1, C33.1, C34.2, J1.2, P1.1, P2.5, P2.6, P3.1, P4.4, P5.1, P6.1, R6.2, R7.2, R9.2, R13.2, R16.2, R17.2, U1.2, U2.12, U2.18, U2.60, U2.63, U3.29, U4.1, U4.4, U4.9, U4.11, U4.12, U4.16, U4.17, U5.2, X1.3, X2.3
unnamed: C5.2, U2.5, X1.1
unnamed: C6.2, U2.31
unnamed: C7.2, U2.47
unnamed: C11.2, U2.6, X1.2
unnamed: C17.2, U3.27
unnamed: C20.1, U3.12, X2.1
unnamed: C22.1, U3.13, X2.2
unnamed: C27.2, L3.1, L5.1, U4.10
unnamed: C30.2, L5.2, L6.1
unnamed: C32.1, C33.2, L6.2
unnamed: C32.2, J1.1
unnamed: D1.1, R16.1
unnamed: D2.1, R17.1
unnamed: L1.1, U1.5
unnamed: L2.1, U3.19, U4.2
unnamed: L2.2, U3.17, U4.3
unnamed: P2.1, R1.1, R2.2
unnamed: P2.2, R3.2
unnamed: P2.3, R4.2
unnamed: R5.2, U3.26
unnamed: R6.1, U3.23
unnamed: R9.1, U4.8
unnamed: R13.1, U5.8
VCC: C3.1, C4.1, C8.1, C9.1, C13.1, C14.1, C15.1, C16.1, C18.2, C19.2, C21.2, C23.2, C34.1, L1.2, L4.1, P1.2, P3.8, P4.6, P6.4, R5.1, R14.2, R15.2, U1.4, U2.1, U2.13, U2.19, U2.32, U2.48, U2.64, U3.8, U3.11, U3.14, U3.15, U3.16, U3.20, U3.21, U3.22, U3.24, U5.3
