vedderb/rise_sdvp/Linux/RControlStation/main.cpp

/*
    Copyright 2016 - 2017 Benjamin Vedder	benjamin@vedder.se

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
    You should have received a copy of the GNU General Public License
    along with this program.  If not, see <http://www.gnu.org/licenses/>.
 */

#include "mainwindow.h"
#include <QApplication>
#include <QStyleFactory>
#include <memory>
#include "utility.h"
#include "mapwidget.h"
#include "task_basestation.h"

void showHelp()
{
    std::cout << "Arguments" << std::endl;
    std::cout << "-h, --help : Show help text" << std::endl;
    std::cout << "--basestation [surveyInMinDuration:[surveyInMinAcc:[tcpPort:[ubxSerialPort:[baudrate]]]]] : Run RTK GNSS basestation on command line" << std::endl;
    std::cout << "--plotroutes xmlFile : Plot routes from XML file" << std::endl;
    std::cout << "--plotroutessize w:h : Size to plot with in pixels" << std::endl;
    std::cout << "--plotroutesformat format : plot format; PDF or PNG" << std::endl;
    std::cout << "--plotroutesmargins margins : Margins around the plot" << std::endl;
    std::cout << "--plotroutesselect id : Select route with id" << std::endl;
    std::cout << "--plotroutesshowgrid : Show grid in plot" << std::endl;
    std::cout << "--plotroutesshowtext : Show text next to route points" << std::endl;
    std::cout << "--addcar id[:pollData] : Add car tab with car id" << std::endl;
    std::cout << "--connectjs dev : Connect to joystick dev (e.g. /dev/input/js0)" << std::endl;
    std::cout << "--connecttcp ip[:port] : Connect to car over TCP (multiple connections possible)" << std::endl;
    std::cout << "--xmltcpserver port : Run XML TCP server on port" << std::endl;
    std::cout << "--xmludpserver port : Run XML UDP server on port" << std::endl;
    std::cout << "--loadroutes xmlFile : Load routes from XML file" << std::endl;
}

int main(int argc, char *argv[])
{
    QStringList args;
    for (int i = 0; i < argc; i++)
        args.append(argv[i]);

    typedef enum {
        RUN_DEFAULT_GUI = 0,
        RUN_BASESTATION
    } RUN_MODE;

    typedef enum {
        PLOT_ROUTE_FORMAT_PDF = 0,
        PLOT_ROUTE_FORMAT_PNG
    } PLOT_ROUTE_FORMAT;

    struct CarConn {
        QString ip;
        int port;
    };

    struct CarToAdd {
        int id;
        bool pollData;
    };

    bool noGui = false;
    RUN_MODE run_mode = RUN_DEFAULT_GUI;

    QString plotRoutesFile;
    int plotRoutesW = 640;
    int plotRoutesH = 480;
    PLOT_ROUTE_FORMAT plotRoutesFormat = PLOT_ROUTE_FORMAT_PDF;
    double plotRoutesMargins = 0.1;
    int plotRoutesSelect = -1;
    bool plotRoutesShowGrid = false;
    bool plotRoutesShowText = false;
    QVector<CarToAdd> carsToAdd;
    QString jsStr;
    QList<CarConn> carsToConn;
    int xmlTcpPort = -2;
    int xmlUdpPort = -2;
    QString loadRoutesFile;

    // Commandline basestation parameters
    int surveyInMinDuration = 300; // 5 minutes
    double surveyInMinAcc = 2.0; // 2 meters
    int tcpPort = 2101;
    QString ubxSerialPort;
    int ubxBaudrate = 115200;

    for (int i = 0;i < args.size();i++) {
        // Skip the program argument
        if (i == 0) {
            continue;
        }

        QString str = args.at(i).toLower();

        // Skip path argument
        if (i >= args.size() && args.size() >= 3) {
            break;
        }

        bool dash = str.startsWith("-") && !str.startsWith("--");
        bool found = false;

        if ((dash && str.contains('h')) || str == "--help") {
            showHelp();
            found = true;
            return 0;
        }

        if (str == "--basestation") {
            noGui = true;
            run_mode = RUN_BASESTATION;
            found = true;
            if ((i + 1) < args.size()) {
                i++;
                QStringList modeArgs = args.at(i).split(":");

                surveyInMinDuration = modeArgs.at(0).toInt();
                if (modeArgs.size() >= 2)
                    surveyInMinAcc = modeArgs.at(1).toDouble();
                if (modeArgs.size() >= 3)
                    tcpPort = modeArgs.at(2).toInt();
                if (modeArgs.size() >= 4)
                    ubxSerialPort = modeArgs.at(3);
                if (modeArgs.size() >= 5)
                    ubxBaudrate = modeArgs.at(4).toInt();

            }
        }

        if (str == "--plotroutes") {
            if ((i + 1) < args.size()) {
                i++;
                plotRoutesFile = args.at(i);
                found = true;
            }
        }

        if (str == "--plotroutessize") {
            if ((i + 1) < args.size()) {
                i++;
                QString tmp = args.at(i);
                QStringList numbers = tmp.split(":");

                if (numbers.size() == 2) {
                    found = true;
                    plotRoutesW = numbers.at(0).toInt();
                    plotRoutesH = numbers.at(1).toInt();
                }
            }
        }

        if (str == "--plotroutesformat") {
            if ((i + 1) < args.size()) {
                i++;

                QString str2 = args.at(i).toLower();

                if (str2 == "pdf") {
                    plotRoutesFormat = PLOT_ROUTE_FORMAT_PDF;
                } else if (str2 == "png") {
                    plotRoutesFormat = PLOT_ROUTE_FORMAT_PNG;
                } else {
                    qCritical() << "Invalid format:" << str2;
                    return 1;
                }

                found = true;
            }
        }

        if (str == "--plotroutesmargins") {
            if ((i + 1) < args.size()) {
                i++;
                plotRoutesMargins = args.at(i).toDouble();
                found = true;
            }
        }

        if (str == "--plotroutesselect") {
            if ((i + 1) < args.size()) {
                i++;
                plotRoutesSelect = args.at(i).toInt();
                found = true;
            }
        }

        if (str == "--plotroutesshowgrid") {
            plotRoutesShowGrid = true;
            found = true;
        }

        if (str == "--plotroutesshowtext") {
            plotRoutesShowText = true;
            found = true;
        }

        if (str == "--addcar") {
            if ((i + 1) < args.size()) {
                i++;
                QString tmp = args.at(i);
                QStringList numbers = tmp.split(":");

                if (numbers.size() == 1) {
                    found = true;
                    CarToAdd c;
                    c.id = numbers.at(0).toInt();
                    c.pollData = false;
                    carsToAdd.append(c);
                } else if (numbers.size() == 2) {
                    found = true;
                    CarToAdd c;
                    c.id = numbers.at(0).toInt();
                    c.pollData = numbers.at(1).toInt();
                    carsToAdd.append(c);
                }
            }
        }

        if (str == "--connectjs") {
            if ((i + 1) < args.size()) {
                i++;
                jsStr = args.at(i);
                found = true;
            }
        }

        if (str == "--connecttcp") {
            if ((i + 1) < args.size()) {
                i++;
                QString tmp = args.at(i);
                QStringList numbers = tmp.split(":");

                if (numbers.size() == 1) {
                    found = true;
                    CarConn c;
                    c.ip = numbers.at(0);
                    c.port = 8300;
                    carsToConn.append(c);
                } else if (numbers.size() == 2) {
                    found = true;
                    CarConn c;
                    c.ip = numbers.at(0);
                    c.port = numbers.at(1).toInt();
                    carsToConn.append(c);
                }
            }
        }

        if (str == "--xmltcpserver") {
            if ((i + 1) < args.size()) {
                i++;
                xmlTcpPort = args.at(i).toInt();
                found = true;
            }
        }

        if (str == "--xmludpserver") {
            if ((i + 1) < args.size()) {
                i++;
                xmlUdpPort = args.at(i).toInt();
                found = true;
            }
        }

        if (str == "--loadroutes") {
            if ((i + 1) < args.size()) {
                i++;
                loadRoutesFile = args.at(i);
                found = true;
            }
        }

        if (!found) {
            if (dash) {
                qCritical() << "At least one of the flags is invalid:" << str;
            } else {
                qCritical() << "Invalid option:" << str;
            }

            showHelp();
            return 1;
        }
    }

    std::unique_ptr<QCoreApplication> a;
    QCoreApplication::setAttribute(Qt::AA_UseHighDpiPixmaps);
    if (noGui) {
        a.reset(new QCoreApplication(argc, argv));
    } else {
        a.reset(new QApplication(argc, argv));

        // Style
        static_cast<QApplication*>(a.get())->setStyleSheet("");
        static_cast<QApplication*>(a.get())->setStyle(QStyleFactory::create("Fusion"));
    }

    // Settings
    a->setOrganizationName("RISE");
    a->setOrganizationDomain("ri.se");
    a->setApplicationName("RControlStation");


    std::unique_ptr<Task> task;
    std::unique_ptr<MainWindow> w;
    if (!noGui) {
        if (!plotRoutesFile.isEmpty()) {
            MapWidget map;
            int res = utility::loadRoutes(plotRoutesFile, &map);

            if (res >= 0) {
                map.zoomInOnRoute(-1, plotRoutesMargins, plotRoutesW, plotRoutesH);
                map.setDrawGrid(plotRoutesShowGrid);
                map.setDrawRouteText(plotRoutesShowText);

                if (plotRoutesSelect >= 0) {
                    map.setRouteNow(plotRoutesSelect);
                } else {
                    map.setRouteNow(map.getRouteNum() - 1);
                }

                if (plotRoutesFormat == PLOT_ROUTE_FORMAT_PDF) {
                    map.printPdf(plotRoutesFile + ".pdf", plotRoutesW, plotRoutesH);
                } else {
                    map.printPng(plotRoutesFile + ".png", plotRoutesW, plotRoutesH);
                }
            } else {
                qCritical() << "Could not load routes from" << plotRoutesFile;
            }
        } else {
            w.reset(new MainWindow());
            w->show();

            if (!loadRoutesFile.isEmpty()) {
                MapWidget *map = w->map();
                int res = utility::loadRoutes(loadRoutesFile, map);

                if (res >= 0) {
                    map->zoomInOnRoute(-1, 0.8, 400, 400);
                } else {
                    qCritical() << "Could not load routes from" << plotRoutesFile;
                }
            }

            for (auto c: carsToAdd) {
                w->addCar(c.id, c.pollData);
            }

            if (!jsStr.isEmpty()) {
                w->connectJoystick(jsStr);
            }

            for (auto c: carsToConn) {
                w->addTcpConnection(c.ip, c.port);
            }

            if (xmlTcpPort >= -1) {
                w->setNetworkTcpEnabled(true, xmlTcpPort);
            }

            if (xmlUdpPort >= -1) {
                w->setNetworkUdpEnabled(true, xmlUdpPort);
            }
        }
    } else {
        switch (run_mode) {
        case RUN_BASESTATION: task.reset(new Task_BaseStation(a.get(), surveyInMinDuration, surveyInMinAcc, tcpPort, ubxSerialPort, ubxBaudrate)); break;
        default: break;
        }
        QObject::connect(task.get(), SIGNAL(finished()), a.get(), SLOT(quit()));
        QTimer::singleShot(0, task.get(), SLOT(run()));
    }

    return a->exec();
}
