vedderb/rise_sdvp/Linux/RControlStation/mainwindow.cpp

/*
    Copyright 2016 - 2017 Benjamin Vedder	benjamin@vedder.se

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
    You should have received a copy of the GNU General Public License
    along with this program.  If not, see <http://www.gnu.org/licenses/>.
 */

#include "mainwindow.h"
#include "ui_mainwindow.h"
#include <QSerialPortInfo>
#include <QDebug>
#include <cmath>
#include <QMessageBox>
#include <QFileDialog>
#include <QHostInfo>
#include <QInputDialog>
#include <QXmlStreamWriter>
#include <QXmlStreamReader>
#include <QStringList>
#include <QElapsedTimer>
#include <QNetworkInterface>

#include "utility.h"
#include "routemagic.h"
#include "wireguard.h"
#include "attributes_masks.h"

namespace {
void stepTowards(double &value, double goal, double step) {
    if (value < goal) {
        if ((value + step) < goal) {
            value += step;
        } else {
            value = goal;
        }
    } else if (value > goal) {
        if ((value - step) > goal) {
            value -= step;
        } else {
            value = goal;
        }
    }
}

void deadband(double &value, double tres, double max) {
    if (fabs(value) < tres) {
        value = 0.0;
    } else {
        double k = max / (max - tres);
        if (value > 0.0) {
            value = k * value + max * (1.0 - k);
        } else {
            value = -(k * -value + max * (1.0 - k));
        }

    }
}
}

MainWindow::MainWindow(QWidget *parent) :
    QMainWindow(parent),
    ui(new Ui::MainWindow)
{
    ui->setupUi(this);

    mVersion = "0.8";
    mSupportedFirmwares.append(qMakePair(12, 3));
    mSupportedFirmwares.append(qMakePair(20, 1));

    qRegisterMetaType<LocPoint>("LocPoint");

    mTimer = new QTimer(this);
    mTimer->start(ui->pollIntervalBox->value());
    mHeartbeatTimer = new QTimer(this);
    mHeartbeatTimer->start(mHeartbeatMS);
    mStatusLabel = new QLabel(this);
    ui->statusBar->addPermanentWidget(mStatusLabel);
    mStatusInfoTime = 0;
    mPacketInterface = new PacketInterface(this);
    mSerialPort = new QSerialPort(this);
    mThrottle = 0.0;
    mSteering = 0.0;

#ifdef HAS_JOYSTICK
    mJoystick = new Joystick(this);
    mJsType = JS_TYPE_HK;

    connect(mJoystick, SIGNAL(buttonChanged(int,bool)),
            this, SLOT(jsButtonChanged(int,bool)));
#endif

    mPing = new Ping(this);
    mNmea = new NmeaServer(this);
    mUdpSocket = new QUdpSocket(this);
    mTcpClientMulti = new TcpClientMulti(this);
    mUdpSocket->setSocketOption(QAbstractSocket::LowDelayOption, true);

    mIntersectionTest = new IntersectionTest(this);
    mIntersectionTest->setCars(&mCars);
    mIntersectionTest->setMap(ui->mapWidget);
    mIntersectionTest->setPacketInterface(mPacketInterface);
    connect(ui->nComWidget, SIGNAL(dataRx(ncom_data)),
            mIntersectionTest, SLOT(nComRx(ncom_data)));

#ifdef HAS_LIME_SDR
    mGpsSim = new GpsSim(this);
    mGpsSim->setMap(ui->mapWidget);
#endif

    mKeyUp = false;
    mKeyDown = false;
    mKeyLeft = false;
    mKeyRight = false;

    ui->mapWidget->setRoutePointSpeed(ui->mapRouteSpeedBox->value() / 3.6);
    ui->networkLoggerWidget->setMap(ui->mapWidget);
    ui->networkInterface->setMap(ui->mapWidget);
    ui->networkInterface->setPacketInterface(mPacketInterface);
    ui->networkInterface->setCars(&mCars);
    ui->moteWidget->setPacketInterface(mPacketInterface);
    ui->nComWidget->setMap(ui->mapWidget);
    ui->baseStationWidget->setMap(ui->mapWidget);

    connect(mTimer, SIGNAL(timeout()), this, SLOT(timerSlot()));
    connect(mSerialPort, SIGNAL(readyRead()),
            this, SLOT(serialDataAvailable()));
    connect(mSerialPort, SIGNAL(error(QSerialPort::SerialPortError)),
            this, SLOT(serialPortError(QSerialPort::SerialPortError)));
    connect(mTimer, SIGNAL(timeout()), this, SLOT(timerSlot()));
    connect(mHeartbeatTimer, SIGNAL(timeout()), this, SLOT(sendHeartbeat()));
    connect(mPacketInterface, SIGNAL(dataToSend(QByteArray&)),
            this, SLOT(packetDataToSend(QByteArray&)));
    connect(mPacketInterface, SIGNAL(stateReceived(quint8,CAR_STATE)),
            this, SLOT(stateReceived(quint8,CAR_STATE)));
    connect(mPacketInterface, SIGNAL(mrStateReceived(quint8,MULTIROTOR_STATE)),
            this, SLOT(mrStateReceived(quint8,MULTIROTOR_STATE)));
    connect(ui->mapWidget, SIGNAL(posSet(quint8,LocPoint)),
            this, SLOT(mapPosSet(quint8,LocPoint)));
    connect(mPacketInterface, SIGNAL(ackReceived(quint8,CMD_PACKET,QString)),
            this, SLOT(ackReceived(quint8,CMD_PACKET,QString)));
    connect(ui->rtcmWidget, SIGNAL(rtcmReceived(QByteArray)),
            this, SLOT(rtcmReceived(QByteArray)));
    connect(ui->baseStationWidget, SIGNAL(rtcmOut(QByteArray)),
            this, SLOT(rtcmReceived(QByteArray)));
    connect(ui->rtcmWidget, SIGNAL(refPosGet()), this, SLOT(rtcmRefPosGet()));
    connect(mPing, SIGNAL(pingRx(int,QString)), this, SLOT(pingRx(int,QString)));
    connect(mPing, SIGNAL(pingError(QString,QString)), this, SLOT(pingError(QString,QString)));
    connect(mPacketInterface, SIGNAL(enuRefReceived(quint8,double,double,double)),
            this, SLOT(enuRx(quint8,double,double,double)));
    connect(mNmea, SIGNAL(clientGgaRx(int,NmeaServer::nmea_gga_info_t)),
            this, SLOT(nmeaGgaRx(int,NmeaServer::nmea_gga_info_t)));
    connect(ui->mapWidget, SIGNAL(routePointAdded(LocPoint)),
            this, SLOT(routePointAdded(LocPoint)));
    connect(ui->mapWidget, SIGNAL(infoTraceChanged(int)),
            this, SLOT(infoTraceChanged(int)));

    connect(ui->actionAboutQt, SIGNAL(triggered(bool)),
            qApp, SLOT(aboutQt()));

    connect(mTcpClientMulti, &TcpClientMulti::packetRx, [this](QByteArray data) {
        mPacketInterface->processPacket((unsigned char*)data.data(), data.size());
    });

    connect(mTcpClientMulti, &TcpClientMulti::stateChanged, [this](QString msg, bool isError) {
        showStatusInfo(msg, !isError);

        if (isError) {
            qWarning() << "TCP Error:" << msg;
            QMessageBox::warning(this, "TCP Error", msg);
        }
    });

    on_serialRefreshButton_clicked();
    on_mapCameraWidthBox_valueChanged(ui->mapCameraWidthBox->value());
    on_mapCameraOpacityBox_valueChanged(ui->mapCameraOpacityBox->value());
    if (WireGuard::isWireGuardInstalled()) {
        ui->wgStatusLabel->setText("Status: Ready");
        ui->wgGroupBox->setEnabled(true);
    } else {
        ui->wgStatusLabel->setText("Status: Not installed");
        ui->wgGroupBox->setEnabled(false);
    }


#ifdef HAS_JOYSTICK
    // Connect micronav joystick by default
    bool connectJs = false;

    {
        Joystick js;
        if (js.init(ui->jsPortEdit->text()) == 0) {
            if (js.getName().contains("micronav one", Qt::CaseInsensitive)) {
                connectJs = true;
            }
        }
    }

    if (connectJs) {
        on_jsConnectButton_clicked();
    }
#endif


#ifdef HAS_SIM_SCEN
    mSimScen = new PageSimScen;
    ui->mainTabWidget->addTab(mSimScen, QIcon(":/models/Icons/Sedan-96.png"), "");
    ui->mainTabWidget->setTabToolTip(ui->mainTabWidget->count() - 1,
                                     "Simulation Scenarios");
#endif

    qApp->installEventFilter(this);
}

MainWindow::~MainWindow()
{
    // Remove all vehicles before this window is destroyed to not get segfaults
    // in their destructors.
    while (mCars.size() > 0 || mCopters.size() > 0) {
        QWidget *w = ui->carsWidget->currentWidget();

        if (dynamic_cast<CarInterface*>(w) != NULL) {
            CarInterface *car = (CarInterface*)w;

            ui->carsWidget->removeTab(ui->carsWidget->currentIndex());
            mCars.removeOne(car);
            delete car;
        } else if (dynamic_cast<CopterInterface*>(w) != NULL) {
            CopterInterface *copter = (CopterInterface*)w;

            ui->carsWidget->removeTab(ui->carsWidget->currentIndex());
            mCopters.removeOne(copter);
            delete copter;
        }
    }

    delete ui;
}

bool MainWindow::eventFilter(QObject *object, QEvent *e)
{
    Q_UNUSED(object);

    // Emergency stop on escape
    if (e->type() == QEvent::KeyPress) {
        QKeyEvent *keyEvent = static_cast<QKeyEvent *>(e);
        if (keyEvent->key() == Qt::Key_Escape) {
            on_stopButton_clicked();
            return true;
        }
    }

    // Handle F10 here as it won't be detected from the camera window otherwise.
    if (e->type() == QEvent::KeyPress) {
        QKeyEvent *keyEvent = static_cast<QKeyEvent *>(e);
        if (keyEvent->key() == Qt::Key_F10) {
            on_actionToggleCameraFullscreen_triggered();
            return true;
        }
    }

#ifdef HAS_JOYSTICK
    if (mJoystick->isConnected()) {
        return false;
    }
#endif

    if (ui->throttleOffButton->isChecked()) {
        return false;
    }

    if (e->type() == QEvent::KeyPress || e->type() == QEvent::KeyRelease) {
        QKeyEvent *keyEvent = static_cast<QKeyEvent *>(e);
        bool isPress = e->type() == QEvent::KeyPress;

        switch(keyEvent->key()) {
        case Qt::Key_Up:
        case Qt::Key_Down:
        case Qt::Key_Left:
        case Qt::Key_Right:
            break;

        default:
            return false;
        }

        switch(keyEvent->key()) {
        case Qt::Key_Up: mKeyUp = isPress; break;
        case Qt::Key_Down: mKeyDown = isPress; break;
        case Qt::Key_Left: mKeyLeft = isPress; break;
        case Qt::Key_Right: mKeyRight = isPress; break;

        default:
            break;
        }

        // Return true to not pass the key event on
        return true;
    }

    return false;
}

void MainWindow::addCar(int id, bool pollData)
{
    CarInterface *car = new CarInterface(this);
    mCars.append(car);
    QString name;
    name.sprintf("Car %d", id);
    car->setID(id);
    ui->carsWidget->addTab(car, name);
    car->setMap(ui->mapWidget);
    car->setPacketInterface(mPacketInterface);
    car->setPollData(pollData);
    connect(car, SIGNAL(showStatusInfo(QString,bool)), this, SLOT(showStatusInfo(QString,bool)));
}

void MainWindow::connectJoystick(QString dev)
{
#ifdef HAS_JOYSTICK
    if (mJoystick->init(dev) == 0) {
        qDebug() << "JS Axes:" << mJoystick->numAxes();
        qDebug() << "JS Buttons:" << mJoystick->numButtons();
        qDebug() << "JS Name:" << mJoystick->getName();

        if (mJoystick->getName().contains("Sony PLAYSTATION(R)3")) {
            mJsType = JS_TYPE_PS3;
            qDebug() << "Treating joystick as PS3 USB controller.";
            showStatusInfo("PS3 USB joystick connected!", true);
        } else if (mJoystick->getName().contains("sony", Qt::CaseInsensitive) ||
                   mJoystick->getName().contains("wireless controller", Qt::CaseInsensitive)) {
            mJsType = JS_TYPE_PS4;
            qDebug() << "Treating joystick as PS4 USB controller.";
            showStatusInfo("PS4 USB joystick connected!", true);
        } else if (mJoystick->getName().contains("micronav one", Qt::CaseInsensitive)) {
            mJsType = JS_TYPE_MICRONAV_ONE;
            qDebug() << "Treating joystick as Micronav One.";
            showStatusInfo("Micronav One joystick connected!", true);
            mJoystick->setRepeats(10, true);
            mJoystick->setRepeats(14, true);
        } else {
            mJsType = JS_TYPE_HK;
            qDebug() << "Treating joystick as hobbyking simulator.";
            showStatusInfo("HK joystick connected!", true);
        }
    } else {
        qWarning() << "Opening joystick failed.";
        showStatusInfo("Opening joystick failed.", false);
    }
#else
    QMessageBox::warning(this, "Joystick",
                         "This build does not have joystick support.");
#endif
}

void MainWindow::addTcpConnection(QString ip, int port)
{
    mTcpClientMulti->addConnection(ip, port);
}

void MainWindow::setNetworkTcpEnabled(bool enabled, int port)
{
    ui->networkInterface->setTcpEnabled(enabled, port);
}

void MainWindow::setNetworkUdpEnabled(bool enabled, int port)
{
    ui->networkInterface->setUdpEnabled(enabled, port);
}

MapWidget *MainWindow::map()
{
    return ui->mapWidget;
}

void MainWindow::serialDataAvailable()
{
    while (mSerialPort->bytesAvailable() > 0) {
        QByteArray data = mSerialPort->readAll();
        mPacketInterface->processData(data);
    }
}

void MainWindow::serialPortError(QSerialPort::SerialPortError error)
{
    QString message;
    switch (error) {
    case QSerialPort::NoError:
        break;

    default:
        message = "Serial port error: " + mSerialPort->errorString();
        break;
    }

    if(!message.isEmpty()) {
        showStatusInfo(message, false);

        if(mSerialPort->isOpen()) {
            mSerialPort->close();
        }
    }
}

void MainWindow::timerSlot()
{
    bool js_connected = false;
    double js_mr_thr = 0.0;
    double js_mr_roll = 0.0;
    double js_mr_pitch = 0.0;
    double js_mr_yaw = 0.0;

#ifdef HAS_JOYSTICK
    js_connected = mJoystick->isConnected();
#endif

    // Update throttle and steering from keys.
    if (js_connected) {
#ifdef HAS_JOYSTICK
        if (mJsType == JS_TYPE_HK) {
            mThrottle = -(double)mJoystick->getAxis(4) / 32768.0;
            deadband(mThrottle,0.1, 1.0);
            mSteering = -(double)mJoystick->getAxis(0) / 32768.0;

            js_mr_thr = (((double)mJoystick->getAxis(2) / 32768.0) + 0.85) / 1.7;
            js_mr_roll = -(double)mJoystick->getAxis(0) / 32768.0;
            js_mr_pitch = -(double)mJoystick->getAxis(1) / 32768.0;
            js_mr_yaw = -(double)mJoystick->getAxis(4) / 32768.0;
            utility::truncate_number(&js_mr_thr, 0.0, 1.0);
            utility::truncate_number_abs(&js_mr_roll, 1.0);
            utility::truncate_number_abs(&js_mr_pitch, 1.0);
            utility::truncate_number_abs(&js_mr_yaw, 1.0);
        } else if (mJsType == JS_TYPE_MICRONAV_ONE) {
            mThrottle = -(double)mJoystick->getAxis(1) / 32768.0;
            deadband(mThrottle,0.1, 1.0);
            mSteering = (double)mJoystick->getAxis(2) / 32768.0;

            js_mr_thr = ((-(double)mJoystick->getAxis(1) / 32768.0) + 0.85) / 1.7;
            js_mr_roll = (double)mJoystick->getAxis(2) / 32768.0;
            js_mr_pitch = (double)mJoystick->getAxis(3) / 32768.0;
            js_mr_yaw = (double)mJoystick->getAxis(0) / 32768.0;
            utility::truncate_number(&js_mr_thr, 0.0, 1.0);
            utility::truncate_number_abs(&js_mr_roll, 1.0);
            utility::truncate_number_abs(&js_mr_pitch, 1.0);
            utility::truncate_number_abs(&js_mr_yaw, 1.0);
        } else if (mJsType == JS_TYPE_PS4 || mJsType == JS_TYPE_PS3) {
            mThrottle = -(double)mJoystick->getAxis(1) / 32768.0;
            deadband(mThrottle,0.1, 1.0);
            mSteering = (double)mJoystick->getAxis(3) / 32768.0;

            js_mr_thr = -(double)mJoystick->getAxis(1) / 32768.0;
            js_mr_roll = (double)mJoystick->getAxis(3) / 32768.0;
            js_mr_pitch = (double)mJoystick->getAxis(4) / 32768.0;
            js_mr_yaw = (double)mJoystick->getAxis(0) / 32768.0;
            utility::truncate_number(&js_mr_thr, 0.0, 1.0);
            utility::truncate_number_abs(&js_mr_roll, 1.0);
            utility::truncate_number_abs(&js_mr_pitch, 1.0);
            utility::truncate_number_abs(&js_mr_yaw, 1.0);
        }

        //mSteering /= 2.0;
#endif
    } else {
        if (mKeyUp) {
            stepTowards(mThrottle, 1.0, ui->throttleGainBox->value());
        } else if (mKeyDown) {
            stepTowards(mThrottle, -1.0, ui->throttleGainBox->value());
        } else {
            stepTowards(mThrottle, 0.0, ui->throttleGainBox->value());
        }

        if (mKeyRight) {
            stepTowards(mSteering, 1.0, ui->steeringGainBox->value());
        } else if (mKeyLeft) {
            stepTowards(mSteering, -1.0, ui->steeringGainBox->value());
        } else {
            stepTowards(mSteering, 0.0, ui->steeringGainBox->value());
        }
    }

    ui->mrThrottleBar->setValue(js_mr_thr * 100.0);
    ui->mrRollBar->setValue(js_mr_roll * 100.0);
    ui->mrPitchBar->setValue(js_mr_pitch * 100.0);
    ui->mrYawBar->setValue(js_mr_yaw * 100.0);

    ui->throttleBar->setValue(mThrottle * 100.0);
    ui->steeringBar->setValue(mSteering * 100.0);

    // Notify about key events
    for(QList<CarInterface*>::Iterator it_car = mCars.begin();it_car < mCars.end();it_car++) {
        CarInterface *car = *it_car;
        car->setControlValues(mThrottle, mSteering, ui->throttleMaxBox->value(), ui->throttleCurrentButton->isChecked());
    }

    // Notify about joystick events
    for(QList<CopterInterface*>::Iterator it_copter = mCopters.begin();it_copter < mCopters.end();it_copter++) {
        CopterInterface *copter = *it_copter;
        copter->setControlValues(js_mr_thr, js_mr_roll, js_mr_pitch, js_mr_yaw);
    }

    // Update status label
    if (mStatusInfoTime) {
        mStatusInfoTime--;
        if (!mStatusInfoTime) {
            mStatusLabel->setStyleSheet(qApp->styleSheet());
        }
    } else {
        if (mSerialPort->isOpen() || mPacketInterface->isUdpConnected() || mTcpClientMulti->isAnyConnected()) {
            mStatusLabel->setText("Connected");
        } else {
            mStatusLabel->setText("Not connected");
        }
    }

    // Poll data (one vehicle per timeslot)
    static int next_car = 0;
    int ind = 0;
    int largest = 0;
    bool polled = false;

    for(QList<CarInterface*>::Iterator it_car = mCars.begin();it_car < mCars.end();it_car++) {
        CarInterface *car = *it_car;
        if (car->pollData() && ind >= next_car && !polled) {
            mPacketInterface->getState(car->getId());
            next_car = ind + 1;
            polled = true;
        }

        if (car->pollData() && ind > largest) {
            largest = ind;
        }

        ind++;
    }

    for(QList<CopterInterface*>::Iterator it_copter = mCopters.begin();it_copter < mCopters.end();it_copter++) {
        CopterInterface *copter = *it_copter;
        if (copter->pollData() && ind >= next_car && !polled) {
            mPacketInterface->getMrState(copter->getId());
            next_car = ind + 1;
            polled = true;
        }

        if (copter->pollData() && ind > largest) {
            largest = ind;
        }

        ind++;
    }

    if (next_car > largest) {
        next_car = 0;
    }

    // Update map settings
    if (ui->mapFollowBox->isChecked()) {
        ui->mapWidget->setFollowCar(ui->mapCarBox->value());
    } else {
        ui->mapWidget->setFollowCar(-1);
    }
    if (ui->mapTraceBox->isChecked()) {
        ui->mapWidget->setTraceCar(ui->mapCarBox->value());
    } else {
        ui->mapWidget->setTraceCar(-1);
    }
    ui->mapWidget->setSelectedCar(ui->mapCarBox->value());

    // Joystick connected
#ifdef HAS_JOYSTICK
    static bool jsWasconn = false;
    if (mJoystick->isConnected() != jsWasconn) {
        jsWasconn = mJoystick->isConnected();

        if (jsWasconn) {
            ui->jsConnectedLabel->setText("Connected");
        } else {
            ui->jsConnectedLabel->setText("Not connected");
        }
    }
#endif

    // Update nmea stream connected label
    static bool wasNmeaStreamConnected = false;
    if (wasNmeaStreamConnected != mNmea->isClientTcpConnected()) {
        wasNmeaStreamConnected = mNmea->isClientTcpConnected();

        if (wasNmeaStreamConnected) {
            ui->mapStreamNmeaConnectedLabel->setText("Connected");
        } else {
            ui->mapStreamNmeaConnectedLabel->setText("Not connected");
        }
    }
}

void MainWindow::sendHeartbeat()
{
    for(QList<CarInterface*>::Iterator it_car = mCars.begin();it_car < mCars.end();it_car++)
        if ((*it_car)->getFirmwareVersion().first >= 20)
            mPacketInterface->sendHeartbeat((*it_car)->getId());

    for(QList<CopterInterface*>::Iterator it_copter = mCopters.begin();it_copter < mCopters.end();it_copter++)
        if ((*it_copter)->getFirmwareVersion().first >= 20)
            mPacketInterface->sendHeartbeat((*it_copter)->getId());
}

void MainWindow::showStatusInfo(QString info, bool isGood)
{
    if (mStatusLabel->text() == info) {
        mStatusInfoTime = 80;
        return;
    }

    if (isGood) {
        mStatusLabel->setStyleSheet("QLabel { background-color : lightgreen; color : black; }");
    } else {
        mStatusLabel->setStyleSheet("QLabel { background-color : red; color : black; }");
    }

    mStatusInfoTime = 80;
    mStatusLabel->setText(info);
}

void MainWindow::packetDataToSend(QByteArray &data)
{
    if (mSerialPort->isOpen()) {
        mSerialPort->write(data);
    }

    mTcpClientMulti->sendAll(data);
}

void MainWindow::stateReceived(quint8 id, CAR_STATE state)
{
    if (!mSupportedFirmwares.contains(qMakePair(state.fw_major, state.fw_minor))) {
        on_disconnectButton_clicked();
        QMessageBox::warning(this, "Unsupported Firmware",
                             "This version of RControlStation is not compatible with the "
                             "firmware of the connected car. Update RControlStation, the car "
                             "firmware or both.");
    } else {
        for(QList<CarInterface*>::Iterator it_car = mCars.begin();it_car < mCars.end();it_car++) {
            CarInterface *car = *it_car;
            if (car->getId() == id) {
                car->setStateData(state);
            }
        }
    }
}

void MainWindow::mrStateReceived(quint8 id, MULTIROTOR_STATE state)
{
    for(QList<CopterInterface*>::Iterator it_copter = mCopters.begin();it_copter < mCopters.end();it_copter++) {
        CopterInterface *copter = *it_copter;
        if (copter->getId() == id) {
            copter->setStateData(state);
        }
    }
}

void MainWindow::mapPosSet(quint8 id, LocPoint pos)
{
    mPacketInterface->setPos(id, pos.getX(), pos.getY(), pos.getYaw() * 180.0 / M_PI);
}

void MainWindow::ackReceived(quint8 id, CMD_PACKET cmd, QString msg)
{
    (void)cmd;
    QString str;
    str.sprintf("Vehicle %d ack: ", id);
    str += msg;
    showStatusInfo(str, true);
}

void MainWindow::rtcmReceived(QByteArray data)
{
    mPacketInterface->sendRtcmUsb(255, data);

    if (ui->mapEnuBaseBox->isChecked()) {
        rtcm3_init_state(&mRtcmState);
        mRtcmState.decode_all = true;

        for(char b: data) {
            int res = rtcm3_input_data(b, &mRtcmState);
            if (res == 1005 || res == 1006) {
                ui->mapWidget->setEnuRef(mRtcmState.pos.lat, mRtcmState.pos.lon, mRtcmState.pos.height);
            }
        }
    }
}

void MainWindow::rtcmRefPosGet()
{
    QMessageBox::warning(this, "Reference Position",
                         "Not implemented yet");
}

void MainWindow::pingRx(int time, QString msg)
{
    QString str;
    str.sprintf("ping response time: %.3f ms", (double)time / 1000.0);
    QMessageBox::information(this, "Ping " + msg, str);
}

void MainWindow::pingError(QString msg, QString error)
{
    QMessageBox::warning(this, "Error ping " + msg, error);
}

void MainWindow::enuRx(quint8 id, double lat, double lon, double height)
{
    (void)id;
    ui->mapWidget->setEnuRef(lat, lon, height);
}

void MainWindow::nmeaGgaRx(int fields, NmeaServer::nmea_gga_info_t gga)
{
    if (fields >= 5) {
        if (gga.fix_type == 4 || gga.fix_type == 5 || gga.fix_type == 2 ||
                (gga.fix_type == 1 && !ui->mapStreamNmeaRtkOnlyBox->isChecked())) {
            double i_llh[3];

            if (ui->mapStreamNmeaZeroEnuBox->isChecked()) {
                i_llh[0] = gga.lat;
                i_llh[1] = gga.lon;
                i_llh[2] = gga.height;
                ui->mapWidget->setEnuRef(i_llh[0], i_llh[1], i_llh[2]);
                ui->mapStreamNmeaZeroEnuBox->setChecked(false);
            } else {
                ui->mapWidget->getEnuRef(i_llh);
            }

            double llh[3];
            double xyz[3];

            llh[0] = gga.lat;
            llh[1] = gga.lon;
            llh[2] = gga.height;
            utility::llhToEnu(i_llh, llh, xyz);

            LocPoint p;
            p.setXY(xyz[0], xyz[1]);
            QString info;

            QString fix_t = "Unknown";
            if (gga.fix_type == 4) {
                fix_t = "RTK fix";
                p.setColor(Qt::green);
            } else if (gga.fix_type == 5) {
                fix_t = "RTK float";
                p.setColor(Qt::yellow);
            } else if (gga.fix_type == 1) {
                fix_t = "Single";
                p.setColor(Qt::red);
            }

            info.sprintf("Fix type: %s\n"
                         "Sats    : %d\n"
                         "Height  : %.2f\n"
                         "Age     : %.2f",
                         fix_t.toLocal8Bit().data(),
                         gga.n_sat,
                         gga.height,
                         gga.diff_age);

            p.setInfo(info);
            ui->mapWidget->addInfoPoint(p);

            if (ui->mapStreamNmeaFollowBox->isChecked()) {
                ui->mapWidget->moveView(p.getX(), p.getY());
            }

            // Optionally stream the data over UDP
            if (ui->mapStreamNmeaForwardUdpBox->isChecked()) {
                QString hostString = ui->mapStreamNmeaForwardUdpHostEdit->text();
                QHostAddress host;

                host.setAddress(hostString);

                // In case setting the address failed try DNS lookup. Notice
                // that the lookup is stored in a static QHostInfo as long as
                // the host line does not change. This is to avoid some delay.
                if (host.isNull()) {
                    static QString hostStringBefore;
                    static QHostInfo hostBefore;

                    QList<QHostAddress> addresses = hostBefore.addresses();

                    // Make a new lookup if the address has changed or the old one is invalid.
                    if (hostString != hostStringBefore || addresses.isEmpty()) {
                        hostBefore = QHostInfo::fromName(hostString);
                        hostStringBefore = hostString;
                    }

                    if (!addresses.isEmpty()) {
                        host.setAddress(addresses.first().toString());
                    }
                }

                if (!host.isNull()) {
                    static int seq = 0;
                    QByteArray datagram;
                    QTextStream out(&datagram);
                    QString str;

                    utility::llhToXyz(llh[0], llh[1], llh[2],
                            &xyz[0], &xyz[1], &xyz[2]);

                    out << str.sprintf("%d\n", seq);          // Seq
                    out << str.sprintf("%05f\n", xyz[0]);     // X
                    out << str.sprintf("%05f\n", xyz[1]);     // Y
                    out << str.sprintf("%05f\n", xyz[2]);     // Height
                    out << str.sprintf("%05f\n", gga.t_tow);  // GPS time of week
                    out << str.sprintf("%d\n", 2);            // Vehicle ID
                    out.flush();

                    mUdpSocket->writeDatagram(datagram,
                                              host,
                                              ui->mapStreamNmeaForwardUdpPortBox->value());

                    seq++;
                } else {
                    QMessageBox::warning(this,
                                         tr("Host not found"),
                                         tr("Could not find %1").arg(hostString));
                    ui->mapStreamNmeaForwardUdpBox->setChecked(false);
                }
            }
        }
    }
}

void MainWindow::routePointAdded(LocPoint pos)
{
    (void)pos;
    QTime t = ui->mapRouteTimeEdit->time();
    t = t.addMSecs(ui->mapRouteAddTimeEdit->time().msecsSinceStartOfDay());
    ui->mapRouteTimeEdit->setTime(t);
}

void MainWindow::infoTraceChanged(int traceNow)
{
    ui->mapInfoTraceBox->setValue(traceNow);
}

void MainWindow::jsButtonChanged(int button, bool pressed)
{
//    qDebug() << "JS BT:" << button << pressed;

#ifdef HAS_JOYSTICK
    if (mJsType == JS_TYPE_MICRONAV_ONE) {
        QWidget *fw = QApplication::focusWidget();

        if (button == 1 && pressed) {
            on_actionToggleFullscreen_triggered();
        } else if (button == 3 && pressed) {
            on_actionToggleCameraFullscreen_triggered();
        } else if (button == 14 && pressed) {
            if (fw) {
                QKeyEvent *event = new QKeyEvent(
                            QEvent::KeyPress, Qt::Key_Up, Qt::NoModifier);
                QCoreApplication::postEvent(fw, event);
            }
        } else if (button == 10 && pressed) {
            if (fw) {
                QKeyEvent *event = new QKeyEvent(
                            QEvent::KeyPress, Qt::Key_Down, Qt::NoModifier);
                QCoreApplication::postEvent(fw, event);
            }
        } else  if (button == 13 && pressed) {
            ui->mapWidget->removeLastRoutePoint();
        }

        if (mJoystick->getButton(12)) {
            ui->mapWidget->setInteractionMode(MapWidget::InteractionModeShiftDown);
        } else if (mJoystick->getButton(5)) {
            ui->mapWidget->setInteractionMode(MapWidget::InteractionModeCtrlDown);
        } else if (mJoystick->getButton(6)) {
            ui->mapWidget->setInteractionMode(MapWidget::InteractionModeCtrlShiftDown);
        } else {
            ui->mapWidget->setInteractionMode(MapWidget::InteractionModeDefault);
        }
    } else if (mJsType == JS_TYPE_PS4) {
        // 5: Front Up
        // 7: Front Down
        // 4: Rear up
        // 6: Rear down
        // 1: Extra out
        // 3: Extra in

        if (button == 5 || button == 7 || button == 1 ||
                button == 3 || button == 4 || button == 6) {
            for(QList<CarInterface*>::Iterator it_car = mCars.begin();it_car < mCars.end();it_car++) {
                CarInterface *car = *it_car;
                if (car->getCtrlKb()) {
                    if (button == 5 || button == 7) {
                        if (pressed) {
                            if (button == 5) {
                                mPacketInterface->hydraulicMove(car->getId(), HYDRAULIC_POS_FRONT, HYDRAULIC_MOVE_UP);
                            } else {
                                mPacketInterface->hydraulicMove(car->getId(), HYDRAULIC_POS_FRONT, HYDRAULIC_MOVE_DOWN);
                            }
                        } else {
                            mPacketInterface->hydraulicMove(car->getId(), HYDRAULIC_POS_FRONT, HYDRAULIC_MOVE_STOP);
                        }
                    } else if (button == 4 || button == 6) {
                        if (pressed) {
                            if (button == 4) {
                                mPacketInterface->hydraulicMove(car->getId(), HYDRAULIC_POS_REAR, HYDRAULIC_MOVE_UP);
                            } else {
                                mPacketInterface->hydraulicMove(car->getId(), HYDRAULIC_POS_REAR, HYDRAULIC_MOVE_DOWN);
                            }
                        } else {
                            mPacketInterface->hydraulicMove(car->getId(), HYDRAULIC_POS_REAR, HYDRAULIC_MOVE_STOP);
                        }
                    } else if (button == 1 || button == 3) {
                        if (pressed) {
                            if (button == 1) {
                                mPacketInterface->hydraulicMove(car->getId(), HYDRAULIC_POS_EXTRA, HYDRAULIC_MOVE_OUT);
                            } else {
                                mPacketInterface->hydraulicMove(car->getId(), HYDRAULIC_POS_EXTRA, HYDRAULIC_MOVE_IN);
                            }
                        } else {
                            mPacketInterface->hydraulicMove(car->getId(), HYDRAULIC_POS_EXTRA, HYDRAULIC_MOVE_STOP);
                        }
                    }
                }
            }
        }
    }
#endif
}

void MainWindow::on_carAddButton_clicked()
{    
    addCar(mCars.size() + mCopters.size());
}

void MainWindow::on_copterAddButton_clicked()
{
    CopterInterface *copter = new CopterInterface(this);
    int id = mCars.size() + mCopters.size();
    mCopters.append(copter);
    QString name;
    name.sprintf("Copter %d", id);
    copter->setID(id);
    ui->carsWidget->addTab(copter, name);
    copter->setMap(ui->mapWidget);
    copter->setPacketInterface(mPacketInterface);

    connect(copter, SIGNAL(showStatusInfo(QString,bool)), this, SLOT(showStatusInfo(QString,bool)));
}

void MainWindow::on_serialConnectButton_clicked()
{
    if(mSerialPort->isOpen()) {
        return;
    }

    mSerialPort->setPortName(ui->serialPortBox->currentData().toString());
    mSerialPort->open(QIODevice::ReadWrite);

    if(!mSerialPort->isOpen()) {
        return;
    }

    mSerialPort->setBaudRate(QSerialPort::Baud115200);
    mSerialPort->setDataBits(QSerialPort::Data8);
    mSerialPort->setParity(QSerialPort::NoParity);
    mSerialPort->setStopBits(QSerialPort::OneStop);
    mSerialPort->setFlowControl(QSerialPort::NoFlowControl);

    mPacketInterface->stopUdpConnection();

    mTcpClientMulti->disconnectAll();
}

void MainWindow::on_serialRefreshButton_clicked()
{
    ui->serialPortBox->clear();
    bool found = false;

    QList<QSerialPortInfo> ports = QSerialPortInfo::availablePorts();
    foreach(const QSerialPortInfo &port, ports) {
        QString name = port.portName();
        int index = ui->serialPortBox->count();
        // put STMicroelectronics device first in list and add prefix
        if(port.manufacturer() == "STMicroelectronics") {
            name.insert(0, "IF - ");
            index = 0;
            found = true;
        }
        ui->serialPortBox->insertItem(index, name, port.systemLocation());
    }

    ui->serialPortBox->setCurrentIndex(0);

    if (found && !mSerialPort->isOpen()) {
        on_serialConnectButton_clicked();
    }
}

void MainWindow::on_disconnectButton_clicked()
{
    if (mSerialPort->isOpen()) {
        mSerialPort->close();
    }

    if (mPacketInterface->isUdpConnected()) {
        mPacketInterface->stopUdpConnection();
    }

    mTcpClientMulti->disconnectAll();
}

void MainWindow::on_mapRemoveTraceButton_clicked()
{
    ui->mapWidget->clearTrace();
}

void MainWindow::on_MapRemovePixmapsButton_clicked()
{
    ui->mapWidget->clearPerspectivePixmaps();
}

void MainWindow::on_udpConnectButton_clicked()
{
    QHostAddress ip;

    if (ip.setAddress(ui->udpIpEdit->text().trimmed())) {
        if (mSerialPort->isOpen()) {
            mSerialPort->close();
        }

        mTcpClientMulti->disconnectAll();

        mPacketInterface->startUdpConnection(ip, ui->udpPortBox->value());

        QHostAddress ip2;
        if (ip2.setAddress(ui->udpIp2Edit->text().trimmed())) {
            mPacketInterface->startUdpConnection2(ip2);
        }
    } else {
        showStatusInfo("Invalid IP address", false);
    }
}

void MainWindow::on_udpPingButton_clicked()
{
    mPing->pingHost(ui->udpIpEdit->text(), 64, "UDP Host");
}

void MainWindow::on_tcpConnectButton_clicked()
{
    mTcpClientMulti->disconnectAll();
    QStringList conns = ui->tcpConnEdit->toPlainText().split("\n");

    for (QString c: conns) {
        QStringList ipPort = c.split(":");

        if (ipPort.size() == 1) {
            mTcpClientMulti->addConnection(ipPort.at(0),
                                           8300);
        } else if (ipPort.size() == 2) {
            mTcpClientMulti->addConnection(ipPort.at(0),
                                           ipPort.at(1).toInt());
        }
    }
}

void MainWindow::on_tcpPingButton_clicked()
{
    QStringList conns = ui->tcpConnEdit->toPlainText().split("\n");

    for (QString c: conns) {
        QStringList ipPort = c.split(":");

        if (ipPort.size() == 2) {
            mPing->pingHost(ipPort.at(0), 64, "TCP Host");
            break;
        }
    }
}

void MainWindow::on_mapZeroButton_clicked()
{
    ui->mapWidget->setXOffset(0);
    ui->mapWidget->setYOffset(0);
}

void MainWindow::on_mapRemoveRouteButton_clicked()
{
    ui->mapWidget->clearRoute();
}

void MainWindow::on_mapRouteSpeedBox_valueChanged(double arg1)
{
    ui->mapWidget->setRoutePointSpeed(arg1 / 3.6);
}

void MainWindow::on_jsConnectButton_clicked()
{
    connectJoystick(ui->jsPortEdit->text());
}

void MainWindow::on_jsDisconnectButton_clicked()
{
#ifdef HAS_JOYSTICK
    mJoystick->stop();
#endif
}

void MainWindow::on_mapAntialiasBox_toggled(bool checked)
{
    ui->mapWidget->setAntialiasDrawings(checked);
}

void MainWindow::on_carsWidget_tabCloseRequested(int index)
{
    QWidget *w = ui->carsWidget->widget(index);
    ui->carsWidget->removeTab(index);

    if (dynamic_cast<CarInterface*>(w) != NULL) {
        CarInterface *car = (CarInterface*)w;
        mCars.removeOne(car);
        delete car;
    } else if (dynamic_cast<CopterInterface*>(w) != NULL) {
        CopterInterface *copter = (CopterInterface*)w;
        mCopters.removeOne(copter);
        delete copter;
    }
}

void MainWindow::on_genCircButton_clicked()
{
    double rad = ui->genCircRadBox->value();
    double speed = ui->mapRouteSpeedBox->value() / 3.6;
    double ang_ofs = M_PI;
    double cx = 0.0;
    double cy = 0.0;
    int points = ui->genCircPointsBox->value();
    int type = ui->genCircCenterBox->currentIndex();

    if (type == 1 || type == 2) {
        CarInfo *car = ui->mapWidget->getCarInfo(ui->mapCarBox->value());
        if (car) {
            LocPoint p = car->getLocation();
            double ang = p.getYaw();

            cx = p.getX();
            cy = p.getY();

            if (ui->genCircCenterBox->currentIndex() == 1) {
                cx += rad * sin(ang);
                cy += rad * cos(ang);
                ang_ofs = ang + M_PI;
            }
        }
    } else if (type == 3) {
        cx = ui->genCircXBox->value();
        cy = ui->genCircYBox->value();
    } else if (type == 4) {
        QList<LocPoint> r = ui->mapWidget->getRoute();
        int samples = 0;
        cx = 0.0;
        cy = 0.0;

        for (LocPoint lp: r) {
            cx += lp.getX();
            cy += lp.getY();
            samples++;
        }

        if (samples > 0) {
            cx /= (double)samples;
            cy /= (double)samples;
        }
    }

    QList<LocPoint> route;

    for (int i = 1;i <= points;i++) {
        int ind = i;

        if (rad < 0.0) {
            ind = points - i;
        }

        double ang = -((double)ind * 2.0 * M_PI) / (double)points + ang_ofs;

        double px = sin(ang) * rad;
        double py = cos(ang) * rad;

        // Move up
        px += cx;
        py += cy;

        bool res = true;
        LocPoint pos;
        pos.setXY(px, py);
        pos.setSpeed(speed);
        route.append(pos);

        QList<LocPoint> points;
        points.append(pos);

        for (int i = 0;i < mCars.size();i++) {
            if (mCars[i]->updateRouteFromMap()) {
                res = mPacketInterface->setRoutePoints(mCars[i]->getId(), points);
            }
        }

        if (!res) {
            QMessageBox::warning(this, "Generate Cirlce",
                                 "No ack from car when uploading point.");
            break;
        }
    }

    if (ui->genCircAppendCurrentBox->isChecked()) {
        for (LocPoint p: route) {
            ui->mapWidget->addRoutePoint(p.getX(), p.getY(), p.getSpeed(), p.getTime());
        }
    } else {
        ui->mapWidget->addRoute(route);
    }
}

void MainWindow::on_mapSetAbsYawButton_clicked()
{
    CarInfo *car = ui->mapWidget->getCarInfo(ui->mapCarBox->value());
    if (car) {
        if (mSerialPort->isOpen() || mPacketInterface->isUdpConnected() || mTcpClientMulti->isAnyConnected()) {
            ui->mapSetAbsYawButton->setEnabled(false);
            ui->mapAbsYawSlider->setEnabled(false);
            bool ok = mPacketInterface->setYawOffsetAck(car->getId(), (double)ui->mapAbsYawSlider->value());
            ui->mapSetAbsYawButton->setEnabled(true);
            ui->mapAbsYawSlider->setEnabled(true);

            if (!ok) {
                qDebug() << "No pos ack received";
            }
        }
    }
}

void MainWindow::on_mapAbsYawSlider_valueChanged(int value)
{
    (void)value;
    CarInfo *car = ui->mapWidget->getCarInfo(ui->mapCarBox->value());
    if (car) {
        mPacketInterface->setYawOffset(car->getId(), (double)ui->mapAbsYawSlider->value());
    }
}

void MainWindow::on_mapAbsYawSlider_sliderReleased()
{
    on_mapSetAbsYawButton_clicked();
}

void MainWindow::on_stopButton_clicked()
{
    for (int i = 0;i < mCars.size();i++) {
        mCars[i]->emergencyStop();
    }

    mPacketInterface->setRcControlCurrentBrake(255, 40.0, 0.0);
    mPacketInterface->setRcControlCurrentBrake(255, 40.0, 0.0);
    mPacketInterface->setRcControlCurrentBrake(255, 40.0, 0.0);
    mPacketInterface->setRcControlCurrentBrake(255, 40.0, 0.0);
}

void MainWindow::on_mapUploadRouteButton_clicked()
{
    if (!mSerialPort->isOpen() && !mPacketInterface->isUdpConnected() && !mTcpClientMulti->isAnyConnected()) {
        QMessageBox::warning(this, "Upload route",
                             "Serial port not connected.");
        return;
    }

    QList<LocPoint> route = ui->mapWidget->getRoute();
    int len = route.size();
    int car = ui->mapCarBox->value();
    bool ok = true;

    if (len <= 0) {
        QMessageBox::warning(this, "Upload route",
                             "No route on map.");
        return;
    }

    ui->mapUploadRouteButton->setEnabled(false);

    // Stop car
    for (int i = 0;i < mCars.size();i++) {
        if (mCars[i]->getId() == car) {
            ok = mCars[i]->setAp(false);
            break;
        }
    }

    // Clear previous route
    if (ok) {
        ok = mPacketInterface->clearRoute(car);
    }

    QElapsedTimer timer;
    timer.start();

    if (ok) {
        int ind = 0;
        for (ind = 0;ind < len;ind += 5) {
            QList<LocPoint> tmpList;
            for (int j = ind;j < (ind + 5);j++) {
                if (j < len) {
                    tmpList.append(route.at(j));
                }
            }

            ok = mPacketInterface->setRoutePoints(car, tmpList);

            if (!ok) {
                break;
            }

            if (timer.elapsed() >= 20) {
                timer.restart();
                ui->mapUploadRouteProgressBar->setValue((100 * (ind + 5)) / len);
            }
        }
    }

    if (!ok) {
        QMessageBox::warning(this, "Upload route",
                             "No response when uploading route.");
    } else {
        ui->mapUploadRouteProgressBar->setValue(100);
    }

    ui->mapUploadRouteButton->setEnabled(true);
}

void MainWindow::on_mapGetRouteButton_clicked()
{
    if (!mSerialPort->isOpen() && !mPacketInterface->isUdpConnected() && !mTcpClientMulti->isAnyConnected()) {
        QMessageBox::warning(this, "Get route",
                             "Car not connected.");
        return;
    }

    ui->mapGetRouteButton->setEnabled(false);

    QList<LocPoint> route;
    int routeLen = 0;
    bool ok = mPacketInterface->getRoutePart(ui->mapCarBox->value(), route.size(), 10, route, routeLen);

    QElapsedTimer timer;
    timer.start();

    while (route.size() < routeLen && ok) {
        ok = mPacketInterface->getRoutePart(ui->mapCarBox->value(), route.size(), 10, route, routeLen);
        if (timer.elapsed() >= 20) {
            timer.restart();
            ui->mapUploadRouteProgressBar->setValue((100 * route.size()) / routeLen);
        }
    }

    while (route.size() > routeLen) {
        route.removeLast();
    }

    ui->mapGetRouteButton->setEnabled(true);

    if (ok) {
        if (route.size() > 0) {
            ui->mapWidget->setRoute(route);
            ui->mapUploadRouteProgressBar->setValue(100);
            showStatusInfo("GetRoute OK", true);
        } else {
            showStatusInfo("GetRoute OK, but route empty", true);
        }
    } else {
        showStatusInfo("GetRoute failed", false);
        QMessageBox::warning(this, "Get route",
                             "Could not get route from car.");
    }
}

void MainWindow::on_mapApButton_clicked()
{
    for (int i = 0;i < mCars.size();i++) {
        if (mCars[i]->getId() == ui->mapCarBox->value()) {
            mCars[i]->setCtrlAp();
        }
    }
    ui->throttleOffButton->setChecked(true);
}

void MainWindow::on_mapKbButton_clicked()
{
    for (int i = 0;i < mCars.size();i++) {
        if (mCars[i]->getId() == ui->mapCarBox->value()) {
            mCars[i]->setCtrlKb();
        }
    }
    ui->throttleDutyButton->setChecked(true);
}

void MainWindow::on_mapOffButton_clicked()
{
    for (int i = 0;i < mCars.size();i++) {
        if (mCars[i]->getId() == ui->mapCarBox->value()) {
            mCars[i]->emergencyStop();
        }
    }
}

void MainWindow::on_mapUpdateSpeedButton_clicked()
{
    QList<LocPoint> route = ui->mapWidget->getRoute();
    qint32 timeAcc = 0;

    for (int i = 0;i < route.size();i++) {
        double speed = ui->mapRouteSpeedBox->value() / 3.6;
        route[i].setSpeed(speed);

        if (i == 0) {
            route[i].setTime(0);
        } else {
            double dist = route[i].getDistanceTo(route[i - 1]);
            timeAcc += (dist / speed) * 1000.0;
            route[i].setTime(timeAcc);
        }
    }

    ui->mapWidget->setRoute(route);
}

void MainWindow::on_mapOpenStreetMapBox_toggled(bool checked)
{
    ui->mapWidget->setDrawOpenStreetmap(checked);
    ui->mapWidget->update();
}

void MainWindow::on_mapAntialiasOsmBox_toggled(bool checked)
{
    ui->mapWidget->setAntialiasOsm(checked);
}

void MainWindow::on_mapOsmResSlider_valueChanged(int value)
{
    ui->mapWidget->setOsmRes((double)value / 100.0);
}

void MainWindow::on_mapChooseNmeaButton_clicked()
{
    QString path;
    path = QFileDialog::getOpenFileName(this, tr("Choose log file to open"));
    if (path.isNull()) {
        return;
    }

    ui->mapImportNmeaEdit->setText(path);
}

void MainWindow::on_mapImportNmeaButton_clicked()
{
    QFile file;
    file.setFileName(ui->mapImportNmeaEdit->text());
    bool mapUpdated = false;

    if (file.exists()) {
        bool ok = file.open(QIODevice::ReadOnly | QIODevice::Text);

        if (ok) {
            QTextStream in(&file);

            double i_llh[3];
            bool i_llh_set = false;

            while(!in.atEnd()) {
                QString line = in.readLine();

                NmeaServer::nmea_gga_info_t gga;
                int res = NmeaServer::decodeNmeaGGA(line.toLocal8Bit(), gga);

                if (res > 5) {
                    if (!i_llh_set) {
                        if (ui->mapImportNmeaZeroEnuBox->isChecked()) {
                            i_llh[0] = gga.lat;
                            i_llh[1] = gga.lon;
                            i_llh[2] = gga.height;
                            ui->mapWidget->setEnuRef(i_llh[0], i_llh[1], i_llh[2]);
                        } else {
                            ui->mapWidget->getEnuRef(i_llh);
                        }

                        i_llh_set = true;
                    }

                    double llh[3];
                    double xyz[3];

                    llh[0] = gga.lat;
                    llh[1] = gga.lon;
                    llh[2] = gga.height;
                    utility::llhToEnu(i_llh, llh, xyz);

                    LocPoint p;
                    p.setXY(xyz[0], xyz[1]);
                    QString info;

                    QString fix_t = "Unknown";
                    if (gga.fix_type == 4) {
                        fix_t = "RTK fix";
                        p.setColor(Qt::green);
                    } else if (gga.fix_type == 5) {
                        fix_t = "RTK float";
                        p.setColor(Qt::yellow);
                    } else if (gga.fix_type == 1) {
                        fix_t = "Single";
                        p.setColor(Qt::red);
                    }

                    info.sprintf("Fix type: %s\n"
                                 "Sats    : %d\n"
                                 "Height  : %.2f",
                                 fix_t.toLocal8Bit().data(),
                                 gga.n_sat,
                                 gga.height);

                    p.setInfo(info);

                    if (!mapUpdated) {
                        mapUpdated = true;
                        ui->mapWidget->setNextEmptyOrCreateNewInfoTrace();
                    }

                    ui->mapWidget->addInfoPoint(p);
                }
            }
        } else {
            QMessageBox::warning(this, "Open Error", "Could not open " + file.fileName());
        }

    } else {
        QMessageBox::warning(this, "Open Error", "Please select a valid log file");
    }
}

void MainWindow::on_mapRemoveInfoAllButton_clicked()
{
    ui->mapWidget->clearAllInfoTraces();
}

void MainWindow::on_traceInfoMinZoomBox_valueChanged(double arg1)
{
    ui->mapWidget->setInfoTraceTextZoom(arg1);
}

void MainWindow::on_removeRouteExtraButton_clicked()
{
    on_mapRemoveRouteButton_clicked();
}

void MainWindow::on_mapOsmClearCacheButton_clicked()
{
    ui->mapWidget->osmClient()->clearCache();
    ui->mapWidget->update();
}

void MainWindow::on_mapOsmServerOsmButton_toggled(bool checked)
{
    if (checked) {
        ui->mapWidget->osmClient()->setTileServerUrl("http://tile.openstreetmap.org");
    }
}

void MainWindow::on_mapOsmServerHiResButton_toggled(bool checked)
{
    if (checked) {
        ui->mapWidget->osmClient()->setTileServerUrl("http://c.osm.rrze.fau.de/osmhd"); // Also https
    }
}

void MainWindow::on_mapOsmServerVedderButton_toggled(bool checked)
{
    if (checked) {
        ui->mapWidget->osmClient()->setTileServerUrl("http://tiles.vedder.se/osm_tiles");
    }
}

void MainWindow::on_mapOsmServerVedderHdButton_toggled(bool checked)
{
    if (checked) {
        ui->mapWidget->osmClient()->setTileServerUrl("http://tiles.vedder.se/osm_tiles_hd");
    }
}

void MainWindow::on_mapOsmMaxZoomBox_valueChanged(int arg1)
{
    ui->mapWidget->setOsmMaxZoomLevel(arg1);
}

void MainWindow::on_mapDrawGridBox_toggled(bool checked)
{
    ui->mapWidget->setDrawGrid(checked);
}

void MainWindow::on_mapGetEnuButton_clicked()
{
    mPacketInterface->getEnuRef(ui->mapCarBox->value());
}

void MainWindow::on_mapSetEnuButton_clicked()
{
    double llh[3];
    ui->mapWidget->getEnuRef(llh);
    mPacketInterface->setEnuRef(ui->mapCarBox->value(), llh);
}

void MainWindow::on_mapOsmStatsBox_toggled(bool checked)
{
    ui->mapWidget->setDrawOsmStats(checked);
}

void MainWindow::on_removeTraceExtraButton_clicked()
{
    ui->mapWidget->clearTrace();
}

void MainWindow::on_mapEditHelpButton_clicked()
{
    QMessageBox::information(this, tr("Keyboard shortcuts"),
                             tr("<b>CTRL + Left click:</b> Move selected car<br>"
                                "<b>CTRL + Right click:</b> Update route point or anchor settings<br>"
                                "<b>Shift + Left click:</b> Add route point or anchor<br>"
                                "<b>Shift + Left drag:</b> Move route point or anchor<br>"
                                "<b>Shift + right click:</b> Delete route point or anchor<br>"
                                "<b>CTRL + SHIFT + Left click:</b> Zero map ENU coordinates<br>"));
}

void MainWindow::on_mapStreamNmeaConnectButton_clicked()
{
    mNmea->connectClientTcp(ui->mapStreamNmeaServerEdit->text(),
                            ui->mapStreamNmeaPortBox->value());
}

void MainWindow::on_mapStreamNmeaDisconnectButton_clicked()
{
    mNmea->disconnectClientTcp();
}

void MainWindow::on_mapStreamNmeaClearTraceButton_clicked()
{
    ui->mapWidget->clearInfoTrace();
}

void MainWindow::on_mapRouteBox_valueChanged(int arg1)
{
    ui->mapWidget->setRouteNow(arg1);
}

void MainWindow::on_mapRemoveRouteAllButton_clicked()
{
    ui->mapWidget->clearAllRoutes();
}

void MainWindow::on_mapUpdateTimeButton_clicked()
{
    bool ok;
    int res = QInputDialog::getInt(this,
                                   tr("Set new route start time"),
                                   tr("Seconds from now"), 30, 0, 60000, 1, &ok);

    if (ok) {
        QList<LocPoint> route = ui->mapWidget->getRoute();
        QDateTime date = QDateTime::currentDateTime();
        QTime current = QTime::currentTime().addSecs(-date.offsetFromUtc());
        qint32 now = current.msecsSinceStartOfDay() + res * 1000;
        qint32 start_diff = 0;

        for (int i = 0;i < route.size();i++) {
            if (i == 0) {
                start_diff = now - route[i].getTime();
            }

            route[i].setTime(route[i].getTime() + start_diff);
        }

        ui->mapWidget->setRoute(route);
    }
}

void MainWindow::on_mapRouteTimeEdit_timeChanged(const QTime &time)
{
    ui->mapWidget->setRoutePointTime(time.msecsSinceStartOfDay());
}

void MainWindow::on_mapTraceMinSpaceCarBox_valueChanged(double arg1)
{
    ui->mapWidget->setTraceMinSpaceCar(arg1 / 1000.0);
}

void MainWindow::on_mapTraceMinSpaceGpsBox_valueChanged(double arg1)
{
    ui->mapWidget->setTraceMinSpaceGps(arg1 / 1000.0);
}

void MainWindow::on_mapInfoTraceBox_valueChanged(int arg1)
{
    ui->mapWidget->setInfoTraceNow(arg1);
}

void MainWindow::on_removeInfoTraceExtraButton_clicked()
{
    ui->mapWidget->clearInfoTrace();
}

void MainWindow::on_pollIntervalBox_valueChanged(int arg1)
{
    mTimer->setInterval(arg1);
}

void MainWindow::on_actionAbout_triggered()
{
    QMessageBox::about(this, "RControlStation",
                       tr("<b>RControlStation %1</b><br>"
                          "&copy; Benjamin Vedder 2016 - 2017<br>"
                          "<a href=\"mailto:benjamin@vedder.se\">benjamin@vedder.se</a><br>").
                       arg(mVersion));
}

void MainWindow::on_actionAboutLibrariesUsed_triggered()
{
    QMessageBox::about(this, "Libraries Used",
                       tr("<b>Icons<br>"
                          "<a href=\"https://icons8.com/\">https://icons8.com/</a><br><br>"
                          "<b>Plotting<br>"
                          "<a href=\"http://qcustomplot.com/\">http://qcustomplot.com/</a><br><br>"
                          "<b>Linear Algebra<br>"
                          "<a href=\"http://eigen.tuxfamily.org\">http://eigen.tuxfamily.org</a>"));
}

void MainWindow::on_actionExit_triggered()
{
    qApp->exit();
}

void MainWindow::on_actionSaveRoutes_triggered()
{
    saveRoutes(false);
}

void MainWindow::on_actionSaveRouteswithIDs_triggered()
{
    saveRoutes(true);
}

void MainWindow::on_actionLoadRoutes_triggered()
{
    QString filename = QFileDialog::getOpenFileName(this,
                                                    tr("Load Routes"), "",
                                                    tr("Xml files (*.xml)"));

    if (!filename.isEmpty()) {
        int res = utility::loadRoutes(filename, ui->mapWidget);

        if (res >= 0) {
            showStatusInfo("Loaded routes", true);
        } else if (res == -1) {
            QMessageBox::critical(this, "Load Routes",
                                  "Could not open\n" + filename + "\nfor reading");
        } else if (res == -2) {
            QMessageBox::critical(this, "Load Routes",
                                  "routes tag not found in " + filename);
        } else {
            QMessageBox::critical(this, "Load Routes", "unknown error");
        }
    }
}

void MainWindow::on_actionTestIntersection_triggered()
{
    mIntersectionTest->show();
}

void MainWindow::on_actionSaveSelectedRouteAsDriveFile_triggered()
{
    QString filename = QFileDialog::getSaveFileName(this,
                                                    tr("Save Drive File"), "",
                                                    tr("Csv files (*.csv)"));

    // Cancel pressed
    if (filename.isEmpty()) {
        return;
    }

    if (!filename.toLower().endsWith(".csv")) {
        filename.append(".csv");
    }

    QFile file(filename);
    if (!file.open(QIODevice::WriteOnly)) {
        QMessageBox::critical(this, "Save Drive File",
                              "Could not open\n" + filename + "\nfor writing");
        showStatusInfo("Could not save drive file", false);
        return;
    }

    QFileInfo fileInfo(file);


    QTextStream stream(&file);
    stream.setCodec("UTF-8");

    QList<LocPoint> route = ui->mapWidget->getRoute();

    QString trajName = fileInfo.fileName();
    trajName.chop(4);
    stream << "TRAJECTORY;" << trajName <<
              ";0.1;" << route.size() << ";\n";

    for (LocPoint p: route) {
        // LINE;TIME(s);X(m);Y(m);Z(m);HEAD(rad, 0=right, ccw);VEL(m/s);ACCEL(m/s/s);CURVATURE(rad/m);MODE(0);ENDLINE;

        stream << "LINE;";
        stream << (double)p.getTime() / 1000.0 << ";";
        stream << p.getX() << ";" << p.getY() << ";" << "0.0;";
        stream << "0.0;";
        stream << p.getSpeed() << ";";
        stream << "0.0;";
        stream << "0.0;";
        stream << "0;";
        stream << "ENDLINE;\n";
    }

    stream << "ENDTRAJECTORY;";
    file.close();
    showStatusInfo("Saved drive file", true);
}

void MainWindow::on_actionLoadDriveFile_triggered()
{
    QString filename = QFileDialog::getOpenFileName(this,
                                                    tr("Load Drive File"), "",
                                                    tr("Csv files (*.csv)"));

    if (!filename.isEmpty()) {
        QFile file(filename);
        if (!file.open(QIODevice::ReadOnly)) {
            QMessageBox::critical(this, "Load Drive File",
                                  "Could not open\n" + filename + "\nfor reading");
            return;
        }

        QTextStream stream(&file);

        QList<LocPoint> route;

        while (!stream.atEnd()) {
            QString line = stream.readLine();
            if (line.toUpper().startsWith("LINE;")) {
                QStringList tokens = line.split(";");

                // LINE;TIME(s);X(m);Y(m);Z(m);HEAD(rad, 0=right, ccw);VEL(m/s);ACCEL(m/s/s);CURVATURE(rad/m);MODE(0);ENDLINE;

                LocPoint p;
                p.setTime(tokens.at(1).toDouble() * 1000.0);
                p.setX(tokens.at(2).toDouble());
                p.setY(tokens.at(3).toDouble());
                p.setSpeed(tokens.at(6).toDouble());

                route.append(p);
            }
        }

        if (route.size() == 0) {
            file.close();
            QMessageBox::critical(this, "Load Drive File",
                                  "Drive file empty or could not be parsed.");
            return;
        }

        // Reduce route density
        QList<LocPoint> routeReduced;
        LocPoint pointLast = route.first();
        routeReduced.append(route.first());

        for (LocPoint p: route) {
            if (p.getDistanceTo(pointLast) >= 1.0) {
                routeReduced.append(p);
                pointLast = p;
            }
        }

        if (route.last().getDistanceTo(pointLast) > 0.01) {
            routeReduced.append(route.last());
        }

        ui->mapWidget->addRoute(routeReduced);

        file.close();
        showStatusInfo("Loaded drive file", true);
    }
}

void MainWindow::on_mapSaveAsPdfButton_clicked()
{
    QString filename = QFileDialog::getSaveFileName(this,
                                                    tr("Save Map Image"), "",
                                                    tr("Pdf files (*.pdf)"));

    // Cancel pressed
    if (filename.isEmpty()) {
        return;
    }

    if (!filename.toLower().endsWith(".pdf")) {
        filename.append(".pdf");
    }

    ui->mapWidget->printPdf(filename,
                            ui->mapSaveWBox->value(),
                            ui->mapSaveHBox->value());

    mLastImgFileName = filename;
}

void MainWindow::on_mapSaveAsPngButton_clicked()
{
    QString filename = QFileDialog::getSaveFileName(this,
                                                    tr("Save Map Image"), "",
                                                    tr("png files (*.png)"));

    // Cancel pressed
    if (filename.isEmpty()) {
        return;
    }

    if (!filename.toLower().endsWith(".png")) {
        filename.append(".png");
    }

    ui->mapWidget->printPng(filename,
                            ui->mapSaveWBox->value(),
                            ui->mapSaveHBox->value());

    mLastImgFileName = filename;
}

void MainWindow::on_mapSaveRetakeButton_clicked()
{
    if (mLastImgFileName.toLower().endsWith(".pdf")) {
        ui->mapWidget->printPdf(mLastImgFileName,
                                ui->mapSaveWBox->value(),
                                ui->mapSaveHBox->value());
    } else if (mLastImgFileName.toLower().endsWith(".png")) {
        ui->mapWidget->printPng(mLastImgFileName,
                                ui->mapSaveWBox->value(),
                                ui->mapSaveHBox->value());
    } else {
        QMessageBox::critical(this, "Retake Image",
                              "No image has been taken yet, so a retake "
                              "is not possible.");
    }
}

void MainWindow::on_modeRouteButton_toggled(bool checked)
{
    ui->mapWidget->setAnchorMode(!checked);
}

void MainWindow::on_uploadAnchorButton_clicked()
{
    QVector<UWB_ANCHOR> anchors;
    for (LocPoint p: ui->mapWidget->getAnchors()) {
        UWB_ANCHOR a;
        a.dist_last = 0.0;
        a.height = p.getHeight();
        a.id = p.getId();
        a.px = p.getX();
        a.py = p.getY();
        anchors.append(a);
    }

    if (anchors.size() == 0) {
        return;
    }

    ui->uploadAnchorButton->setEnabled(false);

    bool ok = true;
    int car = ui->mapCarBox->value();

    ok = mPacketInterface->clearUwbAnchors(car);

    if (ok) {
        ui->anchorUploadProgressBar->setValue(0);
        for (int i = 0;i < anchors.size();i++) {
            ok = mPacketInterface->addUwbAnchor(car, anchors.at(i));
            if (!ok) {
                break;
            }
        }
    }

    if (!ok) {
        QMessageBox::warning(this, "Upload anchors",
                             "No response when uploading anchors.");
    } else {
        ui->anchorUploadProgressBar->setValue(100);
    }

    ui->uploadAnchorButton->setEnabled(true);
}

void MainWindow::on_anchorIdBox_valueChanged(int arg1)
{
    ui->mapWidget->setAnchorId(arg1);
}

void MainWindow::on_anchorHeightBox_valueChanged(double arg1)
{
    ui->mapWidget->setAnchorHeight(arg1);
}

void MainWindow::on_removeAnchorsButton_clicked()
{
    ui->mapWidget->clearAnchors();
}

void MainWindow::saveRoutes(bool withId)
{
    QString filename = QFileDialog::getSaveFileName(this,
                                                    tr("Save Routes"), "",
                                                    tr("Xml files (*.xml)"));

    // Cancel pressed
    if (filename.isEmpty()) {
        return;
    }

    if (!filename.toLower().endsWith(".xml")) {
        filename.append(".xml");
    }

    QFile file(filename);
    if (!file.open(QIODevice::WriteOnly)) {
        QMessageBox::critical(this, "Save Routes",
                              "Could not open\n" + filename + "\nfor writing");
        showStatusInfo("Could not save routes", false);
        return;
    }


    QXmlStreamWriter stream(&file);
    stream.setCodec("UTF-8");
    stream.setAutoFormatting(true);
    stream.writeStartDocument();

    stream.writeStartElement("routes");

    QList<LocPoint> anchors = ui->mapWidget->getAnchors();
    QList<QList<LocPoint> > routes = ui->mapWidget->getRoutes();

    if (!anchors.isEmpty()) {
        stream.writeStartElement("anchors");
        for (LocPoint p: anchors) {
            stream.writeStartElement("anchor");
            stream.writeTextElement("x", QString::number(p.getX()));
            stream.writeTextElement("y", QString::number(p.getY()));
            stream.writeTextElement("height", QString::number(p.getHeight()));
            stream.writeTextElement("id", QString::number(p.getId()));
            stream.writeEndElement();
        }
        stream.writeEndElement();
    }

    for (int i = 0;i < routes.size();i++) {
        if (!routes.at(i).isEmpty()) {
            stream.writeStartElement("route");

            if (withId) {
                stream.writeTextElement("id", QString::number(i));
            }

            for (const LocPoint p: routes.at(i)) {
                stream.writeStartElement("point");
                stream.writeTextElement("x", QString::number(p.getX()));
                stream.writeTextElement("y", QString::number(p.getY()));
                stream.writeTextElement("speed", QString::number(p.getSpeed()));
                stream.writeTextElement("time", QString::number(p.getTime()));
                stream.writeTextElement("attributes", QString::number(p.getAttributes()));
                stream.writeEndElement();
            }
            stream.writeEndElement();
        }
    }

    stream.writeEndDocument();
    file.close();
    showStatusInfo("Saved routes", true);
}

void MainWindow::on_mapDrawRouteTextBox_toggled(bool checked)
{
    ui->mapWidget->setDrawRouteText(checked);
}

void MainWindow::on_actionGPSSimulator_triggered()
{
#ifdef HAS_LIME_SDR
    mGpsSim->show();
#else
    QMessageBox::warning(this, "GPS Simulator",
                         "This version of RControlStation is not built with LIME SDR support, which "
                         "is required for the GPS simulator.");
#endif
}

void MainWindow::on_mapDrawUwbTraceBox_toggled(bool checked)
{
    ui->mapWidget->setDrawUwbTrace(checked);
}

void MainWindow::on_actionToggleFullscreen_triggered()
{
    if (isFullScreen()) {
        showNormal();
    } else {
        showFullScreen();
    }
}

void MainWindow::on_mapCameraWidthBox_valueChanged(double arg1)
{
    ui->mapWidget->setCameraImageWidth(arg1);
}

void MainWindow::on_mapCameraOpacityBox_valueChanged(double arg1)
{
    ui->mapWidget->setCameraImageOpacity(arg1);
}

void MainWindow::on_actionToggleCameraFullscreen_triggered()
{
    if (mCars.size() == 1) {
        mCars[0]->toggleCameraFullscreen();
    } else {
        for (int i = 0;i < mCars.size();i++) {
            if (mCars[i]->getId() == ui->mapCarBox->value()) {
                mCars[i]->toggleCameraFullscreen();
            }
        }
    }
}

void MainWindow::on_tabWidget_currentChanged(int index)
{
    // Focus on map widget when changing tab to it
    if (index == 1) {
        ui->mapWidget->setFocus();
    }
}

void MainWindow::on_routeZeroButton_clicked()
{
    ui->mapWidget->zoomInOnRoute(ui->mapRouteBox->value(), 0.1);
}

void MainWindow::on_routeZeroAllButton_clicked()
{
    ui->mapWidget->zoomInOnRoute(-1, 0.1);
}

void MainWindow::on_mapRoutePosAttrBox_currentIndexChanged(int index)
{
    quint32 attr = ui->mapWidget->getRoutePointAttributes();
    attr &= ~ATTR_POSITIONING_MASK;
    attr |= index;
    ui->mapWidget->setRoutePointAttributes(attr);
}

void MainWindow::on_clearAnchorButton_clicked()
{
    mPacketInterface->clearUwbAnchors(ui->mapCarBox->value());
}

void MainWindow::on_setBoundsRoutePushButton_clicked()
{
    int r = ui->mapWidget->getRouteNow();
    ui->boundsRouteSpinBox->setValue(r);
}

void MainWindow::on_boundsFillPushButton_clicked()
{
    QList<LocPoint> bounds = ui->mapWidget->getRoute(ui->boundsRouteSpinBox->value());

    double spacing = ui->boundsFillSpacingSpinBox->value();
    if (spacing < 0.5) return;

    QList<LocPoint> route;
    if (ui->generateFrameCheckBox->isChecked())
        route = RouteMagic::fillConvexPolygonWithFramedZigZag(bounds, spacing, ui->boundsFillKeepTurnsInBoundsCheckBox->isChecked(), ui->boundsFillSpeedSpinBox->value()/3.6,
                                                              ui->boundsFillSpeedInTurnsSpinBox->value()/3.6, ui->stepsForTurningSpinBox->value(), ui->visitEverySpinBox->value(),
                                                              ui->lowerToolsCheckBox->isChecked() ? ATTR_HYDRAULIC_FRONT_DOWN : 0, ui->raiseToolsCheckBox->isChecked() ? ATTR_HYDRAULIC_FRONT_UP : 0,
                                                              ui->lowerToolsDistanceSpinBox->value()*2, ui->raiseToolsDistanceSpinBox->value()*2);
                                                              // attribute changes at half distance
    else
        route = RouteMagic::fillConvexPolygonWithZigZag(bounds, spacing, ui->boundsFillKeepTurnsInBoundsCheckBox->isChecked(), ui->boundsFillSpeedSpinBox->value()/3.6,
                                                        ui->boundsFillSpeedInTurnsSpinBox->value()/3.6, ui->stepsForTurningSpinBox->value(), ui->visitEverySpinBox->value(),
                                                        ui->lowerToolsCheckBox->isChecked() ? ATTR_HYDRAULIC_FRONT_DOWN : 0, ui->raiseToolsCheckBox->isChecked() ? ATTR_HYDRAULIC_FRONT_UP : 0,
                                                        ui->lowerToolsDistanceSpinBox->value()*2, ui->raiseToolsDistanceSpinBox->value()*2);

    ui->mapWidget->addRoute(route);
    int r = ui->mapWidget->getRoutes().size()-1;
    ui->mapWidget->setRouteNow(r);
    ui->mapRouteBox->setValue(r);
    ui->mapWidget->repaint();

}

void MainWindow::on_lowerToolsCheckBox_stateChanged(int arg1)
{
    ui->lowerToolsDistanceSpinBox->setEnabled(arg1 != 0);
}

void MainWindow::on_raiseToolsCheckBox_stateChanged(int arg1)
{
    ui->raiseToolsDistanceSpinBox->setEnabled(arg1 != 0);
}

void MainWindow::on_WgSettingsPushButton_clicked()
{
    if (!mWireGuard)
        mWireGuard.reset(new WireGuard(this));
    mWireGuard->show();
}

void MainWindow::on_WgConnectPushButton_clicked()
{
    system("pkexec wg-quick up wg_sdvp");
    QList<QNetworkInterface> interfaces = QNetworkInterface::allInterfaces();
    if (std::find_if(interfaces.begin(), interfaces.end(),
                     [](QNetworkInterface currInterface){return currInterface.name() == "wg_sdvp";}) != interfaces.end())
        ui->wgStatusLabel->setText("Status: Interface up");
    else
        ui->wgStatusLabel->setText("Status: Config. error");
}

void MainWindow::on_WgDisconnectPushButton_clicked()
{
    system("pkexec wg-quick down wg_sdvp");
    QList<QNetworkInterface> interfaces = QNetworkInterface::allInterfaces();
    if (std::find_if(interfaces.begin(), interfaces.end(),
                     [](QNetworkInterface currInterface){return currInterface.name() == "wg_sdvp";}) != interfaces.end())
        ui->wgStatusLabel->setText("Status: Interface up");
    else
        ui->wgStatusLabel->setText("Status: Interface down");
}

void MainWindow::on_AutopilotConfigurePushButton_clicked()
{
    ui->mainTabWidget->setCurrentIndex(ui->mainTabWidget->indexOf(ui->tab));
    ui->carsWidget->setCurrentIndex(ui->mapCarBox->value());

    QWidget *tmp = ui->carsWidget->widget(ui->mapCarBox->value());
    if (tmp) {
        CarInterface *car = dynamic_cast<CarInterface*>(tmp);
        car->showAutoPilotConfiguration();
    }
}

void MainWindow::on_AutopilotStartPushButton_clicked()
{
    ui->throttleOffButton->setChecked(true);
    QWidget *tmp = ui->carsWidget->widget(ui->mapCarBox->value());
    if (tmp) {
        CarInterface *car = dynamic_cast<CarInterface*>(tmp);
        car->setAp(true, false);
    }
}

void MainWindow::on_AutopilotStopPushButton_clicked()
{
    QWidget *tmp = ui->carsWidget->widget(ui->mapCarBox->value());
    if (tmp) {
        CarInterface *car = dynamic_cast<CarInterface*>(tmp);
        car->setAp(false, true);
    }
}

void MainWindow::on_AutopilotRestartPushButton_clicked()
{
    ui->throttleOffButton->setChecked(true);
    QWidget *tmp = ui->carsWidget->widget(ui->mapCarBox->value());
    if (tmp) {
        CarInterface *car = dynamic_cast<CarInterface*>(tmp);
        car->setAp(true, true);
    }
}

void MainWindow::on_AutopilotPausePushButton_clicked()
{
    QWidget *tmp = ui->carsWidget->widget(ui->mapCarBox->value());
    if (tmp) {
        CarInterface *car = dynamic_cast<CarInterface*>(tmp);
        car->setAp(false, false);
    }
}
