vedderb/rise_sdvp/Embedded/RC_Controller/hydraulic.c

/*
	Copyright 2019 Benjamin Vedder	benjamin@vedder.se

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
    You should have received a copy of the GNU General Public License
    along with this program.  If not, see <http://www.gnu.org/licenses/>.
 */

#include "hydraulic.h"
#include "ch.h"
#include "hal.h"
#include "conf_general.h"
#include "pwm_esc.h"
#include "utils.h"
#include "comm_can.h"
#include <math.h>

// Settings
#ifdef IS_MACTRAC
#define SERVO_LEFT				10 // Only one servo
#define SERVO_RIGHT				1
#define SPEED_M_S				1.1
#else
#define SERVO_LEFT				1
#define SERVO_RIGHT				2
#define SPEED_M_S				0.6
#endif
#define TIMEOUT_SECONDS			2.0
#define TIMEOUT_SECONDS_MOVE	10.0

// Private variables
static volatile float m_speed_now = 0.0;
static volatile float m_distance_now = 0.0;
static volatile float m_timeout_cnt = 0.0;
static volatile HYDRAULIC_MOVE m_move_front = HYDRAULIC_MOVE_STOP;
static volatile HYDRAULIC_MOVE m_move_rear = HYDRAULIC_MOVE_STOP;
static volatile HYDRAULIC_MOVE m_move_extra = HYDRAULIC_MOVE_STOP;
static volatile float m_move_timeout_cnt = 0.0;
static volatile float m_throttle_set = 0.0;

// Threads
static THD_WORKING_AREA(hydro_thread_wa, 1024);
static THD_FUNCTION(hydro_thread, arg);

void hydraulic_init(void) {
#ifdef IS_MACTRAC
	main_config.mr.motor_pwm_min_us = 1000;
	main_config.mr.motor_pwm_max_us = 2000;
#else
	main_config.mr.motor_pwm_min_us = 1000;
	main_config.mr.motor_pwm_max_us = 2100;
#endif

	pwm_esc_init();
	pwm_esc_set_all(0.5);

	chThdCreateStatic(hydro_thread_wa, sizeof(hydro_thread_wa), NORMALPRIO, hydro_thread, NULL);
}

/**
 * Get current speed
 *
 * @return
 * Speed in m/s
 */
float hydraulic_get_speed(void) {
	return m_speed_now;
}

/**
 * Get travel distance
 *
 * @param reset
 * Reset distance counter
 *
 * @return
 * Travel distance in meters
 */
float hydraulic_get_distance(bool reset) {
	float ret = m_distance_now;

	if (reset) {
		m_distance_now = 0.0;
	}

	return ret;
}

/**
 * Set speed in m/s
 *
 * @param speed
 * Speed in m/s
 */
void hydraulic_set_speed(float speed) {
	m_timeout_cnt = 0.0;

	if (fabsf(speed) < 0.01) {
		pwm_esc_set(SERVO_LEFT, 0.5);
		pwm_esc_set(SERVO_RIGHT, 0.5);
		m_throttle_set = 0.0;
#ifndef HYDRAULIC_HAS_SPEED_SENSOR
		m_speed_now = 0.0;
#endif
	} else {
#ifdef IS_MACTRAC
		float throttle_val = speed * 0.5;
		float pos = utils_map(throttle_val, -1.0, 1.0, 0.0, 1.0);
		pwm_esc_set(SERVO_RIGHT, 1.0 - pos);
#else
		float throttle_val = 1.0;
		pwm_esc_set(SERVO_LEFT, speed > 0.0 ? throttle_val : 0.0);
		pwm_esc_set(SERVO_RIGHT, speed > 0.0 ? 0.0 : throttle_val);
#endif

		// TODO: Update this
		m_throttle_set = SIGN(speed) * throttle_val;
#ifndef HYDRAULIC_HAS_SPEED_SENSOR
		m_speed_now = SIGN(speed) * SPEED_M_S;
#endif
	}
}

void hydraulic_set_throttle_raw(float throttle) {
	m_timeout_cnt = 0.0;
	utils_truncate_number_abs(&throttle, 1.0);
	m_throttle_set = throttle;

#ifndef HYDRAULIC_HAS_SPEED_SENSOR
	if (fabsf(throttle) > 0.9) {
		m_speed_now = SIGN(throttle) * SPEED_M_S;
	} else {
		m_speed_now = 0.0;
	}
#endif

	float pos = utils_map(throttle, -1.0, 1.0, 0.0, 1.0);
	pwm_esc_set(SERVO_LEFT, pos);
	pwm_esc_set(SERVO_RIGHT, 1.0 - pos);
}

void hydraulic_move(HYDRAULIC_POS pos, HYDRAULIC_MOVE move) {
	m_move_timeout_cnt = 0;

	switch (pos) {
		case HYDRAULIC_POS_FRONT:
			m_move_front = move;
			break;

		case HYDRAULIC_POS_REAR:
			m_move_rear = move;
			break;

		case HYDRAULIC_POS_EXTRA:
			m_move_extra = move;
			break;

		default:
			break;
	}
}

static THD_FUNCTION(hydro_thread, arg) {
	(void)arg;

	chRegSetThreadName("Hydraulic");

	HYDRAULIC_MOVE move_last_front = HYDRAULIC_MOVE_STOP;
	HYDRAULIC_MOVE move_last_rear = HYDRAULIC_MOVE_STOP;
	HYDRAULIC_MOVE move_last_extra = HYDRAULIC_MOVE_STOP;
	int move_repeat_cnt = 0;

	for(;;) {
		if (fabsf(m_speed_now) > 0.01) {
			m_distance_now += m_speed_now * 0.01;
		}

		chThdSleepMilliseconds(10);

		m_timeout_cnt += 0.01;

		if (m_timeout_cnt >= TIMEOUT_SECONDS) {
			pwm_esc_set(SERVO_LEFT, 0.5);
			pwm_esc_set(SERVO_RIGHT, 0.5);
			m_throttle_set = 0.0;
#ifndef HYDRAULIC_HAS_SPEED_SENSOR
			m_speed_now = 0.0;
#endif
		}

		m_move_timeout_cnt += 0.01;
		if (m_move_timeout_cnt >= TIMEOUT_SECONDS_MOVE) {
			m_move_timeout_cnt = TIMEOUT_SECONDS_MOVE - 0.5;
			m_move_front = HYDRAULIC_MOVE_STOP;
			m_move_rear = HYDRAULIC_MOVE_STOP;
			move_last_extra = HYDRAULIC_MOVE_STOP;
		}

		move_repeat_cnt++;
		if (move_repeat_cnt > 10) {
			move_last_front = HYDRAULIC_MOVE_UNDEFINED;
			move_last_rear = HYDRAULIC_MOVE_UNDEFINED;
			move_last_extra = HYDRAULIC_MOVE_UNDEFINED;
		}

#ifdef IS_MACTRAC
		// Measure speed
		const float wheel_diam = 0.65;
		const float cnts_per_rev = 16.0;
		ADC_CNT_t cnt = *comm_can_io_board_adc0_cnt();
		float time_last = fmaxf(cnt.high_time_current, cnt.high_time_last) +
				fmaxf(cnt.low_time_current, cnt.low_time_last);
		m_speed_now = SIGN(m_throttle_set) * (wheel_diam * M_PI) / (time_last * cnts_per_rev);

		// Control hydraulic actuators
		if (comm_can_io_board_lim_sw(0) && m_move_front == HYDRAULIC_MOVE_DOWN) {
			m_move_front = HYDRAULIC_MOVE_STOP;
		} else if (comm_can_io_board_lim_sw(1) && m_move_front == HYDRAULIC_MOVE_UP) {
			m_move_front = HYDRAULIC_MOVE_STOP;
		}

		if (move_last_front != m_move_front) {
			move_last_front = m_move_front;
			comm_can_io_board_set_valve(0, 1, move_last_front == HYDRAULIC_MOVE_UP);
			comm_can_io_board_set_valve(0, 2, move_last_front == HYDRAULIC_MOVE_DOWN);
		}

		if (move_last_rear != m_move_rear) {
			move_last_rear = m_move_rear;
			comm_can_io_board_set_valve(0, 5, move_last_rear == HYDRAULIC_MOVE_UP);
			comm_can_io_board_set_valve(0, 6, move_last_rear == HYDRAULIC_MOVE_DOWN);
		}

		if (move_last_extra != m_move_extra) {
			move_last_extra = m_move_extra;
			comm_can_io_board_set_valve(0, 4, move_last_extra == HYDRAULIC_MOVE_OUT);
			comm_can_io_board_set_valve(0, 3, move_last_extra == HYDRAULIC_MOVE_IN);
		}
#else
		(void)move_last_front;
		(void)move_last_rear;
		(void)move_last_extra;
#endif
	}
}
