vedderb/rise_sdvp/Embedded/RC_Controller/datatypes.h

/*
	Copyright 2016-2017 Benjamin Vedder	benjamin@vedder.se

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
    You should have received a copy of the GNU General Public License
    along with this program.  If not, see <http://www.gnu.org/licenses/>.
 */

#ifndef DATATYPES_H_
#define DATATYPES_H_

#include <stdint.h>
#include <stdbool.h>

// For double precision literals
#define D(x) 						((double)x##L)
#define D_PI						D(3.14159265358979323846)

// Sizes
#define LOG_NAME_MAX_LEN			20

// Constants
#define MS_PER_DAY					(24 * 60 * 60 * 1000)

// CAN ID mask for DecaWave module
#define CAN_MASK_DW					(5 << 8)
#define CAN_DW_ID_ANY				255
#define CAN_MASK_IO_BOARD			(3 << 8)

// External log mode
typedef enum {
	LOG_EXT_OFF = 0,
	LOG_EXT_UART,
	LOG_EXT_UART_POLLED,
	LOG_EXT_ETHERNET
} LOG_EXT_MODE;

// Orientation data
typedef struct {
	float q0;
	float q1;
	float q2;
	float q3;
	float integralFBx;
	float integralFBy;
	float integralFBz;
	float accMagP;
	int initialUpdateDone;
} ATTITUDE_INFO;

// Position and orientation state
typedef struct {
	float px; // Meters
	float py; // Meters
	float pz; // Meters
	float vx; // Meters / second
	float vy; // Meters / second
	float speed; // Meters / second
	float roll; // Degrees
	float pitch; // Degrees
	float yaw; // Degrees
	float yaw_imu;
	float roll_rate; // Degrees / second
	float pitch_rate; // Degrees / second
	float yaw_rate; // Degrees / second
	float q0;
	float q1;
	float q2;
	float q3;

	// Current gps position and time stamp
	float px_gps;
	float py_gps;
	float pz_gps;
	int32_t gps_ms;
	int gps_fix_type;
	float gps_last_corr_diff;

	// Previous GPS position and time stamp
	float px_gps_last;
	float py_gps_last;
	float pz_gps_last;
	int32_t gps_ms_last;

	float gps_corr_cnt;
	float gps_ang_corr_x_last_gps;
	float gps_ang_corr_y_last_gps;
	int32_t gps_ang_corr_last_gps_ms;
	float gps_ground_level;

	uint32_t gps_corr_time;
	uint32_t ultra_update_time;

	// Multirotor state
	float tilt_roll_err;
	float tilt_pitch_err;

	float error_vx_last;
	float error_vy_last;

	float vel_corr_x_int;
	float vel_corr_y_int;

	float tilt_corr_x_int;
	float tilt_corr_y_int;
} POS_STATE;

// Autopilot map point
typedef struct {
	float px;
	float py;
	float pz;
	float speed;
	int32_t time;
	uint32_t attributes;
} ROUTE_POINT;

// Position history point
typedef struct {
	float px;
	float py;
	float pz;
	float yaw;
	float speed;
	int32_t time;
} POS_POINT;

typedef enum {
	MOTE_PACKET_FILL_RX_BUFFER = 0,
	MOTE_PACKET_FILL_RX_BUFFER_LONG,
	MOTE_PACKET_PROCESS_RX_BUFFER,
	MOTE_PACKET_PROCESS_SHORT_BUFFER,
} MOTE_PACKET;

// CAN commands
typedef enum {
	CAN_PACKET_FILL_RX_BUFFER = 5,
	CAN_PACKET_FILL_RX_BUFFER_LONG,
	CAN_PACKET_PROCESS_RX_BUFFER,
	CAN_PACKET_PROCESS_SHORT_BUFFER,
	CAN_PACKET_STATUS
} CAN_PACKET_ID;

// Commands
typedef enum {
	// General commands
	CMD_PRINTF = 0,
	CMD_TERMINAL_CMD,

	// Common vehicle commands
	CMD_VESC_FWD = 50,
	CMD_SET_POS,
	CMD_SET_POS_ACK,
	CMD_SET_ENU_REF,
	CMD_GET_ENU_REF,
	CMD_AP_ADD_POINTS,
	CMD_AP_REMOVE_LAST_POINT,
	CMD_AP_CLEAR_POINTS,
	CMD_AP_GET_ROUTE_PART,
	CMD_AP_SET_ACTIVE,
	CMD_AP_REPLACE_ROUTE,
	CMD_AP_SYNC_POINT,
	CMD_SEND_RTCM_USB,
	CMD_SEND_NMEA_RADIO,
	CMD_SET_YAW_OFFSET,
	CMD_SET_YAW_OFFSET_ACK,
	CMD_LOG_LINE_USB,
	CMD_PLOT_INIT,
	CMD_PLOT_DATA,
	CMD_PLOT_ADD_GRAPH,
	CMD_PLOT_SET_GRAPH,
	CMD_SET_MS_TODAY,
	CMD_SET_SYSTEM_TIME,
	CMD_SET_SYSTEM_TIME_ACK,
	CMD_REBOOT_SYSTEM,
	CMD_REBOOT_SYSTEM_ACK,
	CMD_EMERGENCY_STOP,
	CMD_SET_MAIN_CONFIG,
	CMD_GET_MAIN_CONFIG,
	CMD_GET_MAIN_CONFIG_DEFAULT,
	CMD_ADD_UWB_ANCHOR,
	CMD_CLEAR_UWB_ANCHORS,
	CMD_LOG_ETHERNET,
	CMD_CAMERA_IMAGE,
	CMD_CAMERA_STREAM_START,
	CMD_CAMERA_FRAME_ACK,
	CMD_IO_BOARD_SET_PWM_DUTY,
	CMD_IO_BOARD_SET_VALVE,
	CMD_HYDRAULIC_MOVE,

	// Car commands
	CMD_GET_STATE = 120,
	CMD_RC_CONTROL,
	CMD_SET_SERVO_DIRECT,

	// Multirotor commands
	CMD_MR_GET_STATE = 160,
	CMD_MR_RC_CONTROL,
	CMD_MR_OVERRIDE_POWER,

	// Mote commands
	CMD_MOTE_UBX_START_BASE = 200,
	CMD_MOTE_UBX_START_BASE_ACK,
	CMD_MOTE_UBX_BASE_STATUS
} CMD_PACKET;

// RC control modes
typedef enum {
	RC_MODE_CURRENT = 0,
	RC_MODE_DUTY,
	RC_MODE_PID,
	RC_MODE_CURRENT_BRAKE
} RC_MODE;

typedef enum {
	HYDRAULIC_POS_FRONT = 0,
	HYDRAULIC_POS_REAR,
	HYDRAULIC_POS_EXTRA
} HYDRAULIC_POS;

typedef enum {
	HYDRAULIC_MOVE_STOP = 0,
	HYDRAULIC_MOVE_UP,
	HYDRAULIC_MOVE_DOWN,
	HYDRAULIC_MOVE_OUT = HYDRAULIC_MOVE_UP,
	HYDRAULIC_MOVE_IN = HYDRAULIC_MOVE_DOWN,
	HYDRAULIC_MOVE_UNDEFINED
} HYDRAULIC_MOVE;

typedef struct {
	bool yaw_use_odometry; // Use odometry data for yaw angle correction.
	float yaw_imu_gain; // Gain for yaw angle from IMU (vs odometry)
	bool disable_motor; // Disable motor drive commands to make sure that the motor does not move.
	bool simulate_motor; // Simulate motor movement without motor controller feedback
	bool clamp_imu_yaw_stationary; // Clamp IMU yaw when car is stationary
	bool use_uwb_pos; // Use UWB positioning instead of RTK positioning

	float gear_ratio;
	float wheel_diam;
	float motor_poles;
	float steering_max_angle_rad; // = arctan(axist_distance / turn_radius_at_maximum_steering_angle)
	float steering_center;
	float steering_range;
	float steering_ramp_time; // Ramp time constant for the steering servo in seconds
	// Distance between front and rear wheels in ackermann mode, distance between drive wheels
	// in differential mode.
	float axis_distance;
} MAIN_CONFIG_CAR;

typedef struct {
	// Dead reckoning
	float vel_decay_e;
	float vel_decay_l;
	float vel_max;
	float map_min_x;
	float map_max_x;
	float map_min_y;
	float map_max_y;

	// State correction for dead reckoning
	float vel_gain_p;
	float vel_gain_i;
	float vel_gain_d;

	float tilt_gain_p;
	float tilt_gain_i;
	float tilt_gain_d;

	float max_corr_error;
	float max_tilt_error;

	// Attitude controller
	float ctrl_gain_roll_p;
	float ctrl_gain_roll_i;
	float ctrl_gain_roll_dp;
	float ctrl_gain_roll_de;

	float ctrl_gain_pitch_p;
	float ctrl_gain_pitch_i;
	float ctrl_gain_pitch_dp;
	float ctrl_gain_pitch_de;

	float ctrl_gain_yaw_p;
	float ctrl_gain_yaw_i;
	float ctrl_gain_yaw_dp;
	float ctrl_gain_yaw_de;

	// Position controller
	float ctrl_gain_pos_p;
	float ctrl_gain_pos_i;
	float ctrl_gain_pos_d;

	// Altitude controller
	float ctrl_gain_alt_p;
	float ctrl_gain_alt_i;
	float ctrl_gain_alt_d;

	// Joystick gain
	float js_gain_tilt;
	float js_gain_yaw;
	bool js_mode_rate;

	// Motor mapping and configuration
	int8_t motor_fl_f; // x: Front Left  +: Front
	int8_t motor_bl_l; // x: Back Left   +: Left
	int8_t motor_fr_r; // x: Front Right +: Right
	int8_t motor_br_b; // x: Back Right  +: Back
	bool motors_x; // Use x motor configuration (use + if false)
	bool motors_cw; // Front left (or front in + mode) runs in the clockwise direction (ccw if false)
	uint16_t motor_pwm_min_us; // Minimum servo pulse length for motor in microseconds
	uint16_t motor_pwm_max_us; // Maximum servo pulse length for motor in microseconds
} MAIN_CONFIG_MULTIROTOR;

// Car configuration
typedef struct {
	// Common vehicle settings
	bool mag_use; // Use the magnetometer
	bool mag_comp; // Should be 0 when capturing samples for the calibration
	float yaw_mag_gain; // Gain for yaw angle from magnetomer (vs gyro)

	// Magnetometer calibration
	float mag_cal_cx;
	float mag_cal_cy;
	float mag_cal_cz;
	float mag_cal_xx;
	float mag_cal_xy;
	float mag_cal_xz;
	float mag_cal_yx;
	float mag_cal_yy;
	float mag_cal_yz;
	float mag_cal_zx;
	float mag_cal_zy;
	float mag_cal_zz;

	// GPS parameters
	float gps_ant_x; // Antenna offset from vehicle center in X
	float gps_ant_y; // Antenna offset from vehicle center in Y
	bool gps_comp; // Use GPS position correction
	bool gps_req_rtk; // Require RTK solution
	bool gps_use_rtcm_base_as_enu_ref; // Use RTCM base station position as ENU reference
	float gps_corr_gain_stat; // Static GPS correction gain
	float gps_corr_gain_dyn; // Dynamic GPS correction gain
	float gps_corr_gain_yaw; // Gain for yaw correction
	bool gps_send_nmea; // Send NMEA data for logging and debugging
	bool gps_use_ubx_info; // Use info about the ublox solution
	float gps_ubx_max_acc; // Maximum ublox accuracy to use solution (m, higher = worse)

	// UWB Parameters
	float uwb_max_corr; // Maximum distance to move UWB position in one sample

	// Autopilot parameters
	bool ap_repeat_routes; // Repeat the same route when the end is reached
	float ap_base_rad; // Smallest allowed radius around car
	float ap_rad_time_ahead; // Radius ahead time
	int ap_mode_time; // Drive to route points based on time (1 = abs time, 2 = rel since start)
	float ap_max_speed; // Maximum allowed speed for autopilot
	int32_t ap_time_add_repeat_ms; // Time to add to each point for each repetition of the route

	// Logging
	int log_rate_hz;
	bool log_en;
	char log_name[LOG_NAME_MAX_LEN + 1];
	LOG_EXT_MODE log_mode_ext;
	int log_uart_baud;

	MAIN_CONFIG_CAR car;
	MAIN_CONFIG_MULTIROTOR mr;
} MAIN_CONFIG;

typedef struct {
	// GPS position
	double lat;
	double lon;
	double height;
	double x;
	double y;
	double z;
	int fix_type; // 0=Invalid, 1=SPP, 4=RTK fix, 5=RTK float
	int sats;
	int32_t ms; // Milliseconds today
	uint32_t update_time;
	// Local position (ENU frame)
	bool local_init_done;
	float lx;
	float ly;
	float lz;
	// Initial local position
	double ix;
	double iy;
	double iz;
	// Rotation matrix for local position
	float r1c1, r1c2, r1c3;
	float r2c1, r2c2, r2c3;
	float r3c1, r3c2, r3c3;
} GPS_STATE;

// DW Logging Info
typedef struct {
	bool valid;
	uint8_t dw_anchor;
	int32_t time_today_ms;
	float dw_dist;
	float px;
	float py;
	float px_gps;
	float py_gps;
	float pz_gps;
} DW_LOG_INFO;

typedef struct {
	double lat;
	double lon;
	double height;
	int t_tow;
	int n_sat;
	int fix_type;
	float h_dop;
	float diff_age;
} nmea_gga_info_t;

typedef struct {
	int prn;
	float elevation;
	float azimuth;
	float snr;
	bool lock;
	float base_snr;
	bool base_lock;
	bool local_lock;
} nmea_gsv_sat_t;

typedef struct {
	int sat_num;
	int sentences;
	int sat_last;
	int sat_num_base;
	nmea_gsv_sat_t sats[32];
} nmea_gsv_info_t;

typedef struct {
	int id;
	float px;
	float py;
	float height;
	float dist_last;
	uint32_t timestamp;
	float corr_pcxI;
	float corr_pcyI;
	float corr_pcxLast;
	float corr_pcyLast;
} UWB_ANCHOR;

// ============== UBLOX Datatypes ================== //

typedef struct {
	uint16_t ref_station_id;
	uint32_t i_tow; // GPS time of week of the navigation epoch
	float pos_n; // Position north in meters
	float pos_e; // Position east in meters
	float pos_d; // Position down in meters
	float pos_length; // Length of the relative position vector in meters
	float pos_heading; // Heading of the relative position vector in degree
	float acc_n; // Accuracy north in meters
	float acc_e; // Accuracy east in meters
	float acc_d; // Accuracy down in meters
	float acc_length; // Accuracy length in meters
	float acc_heading; // Accuracy heading in degree
	bool fix_ok; // A valid fix
	bool diff_soln; // Differential corrections are applied
	bool rel_pos_valid; // Relative position components and accuracies valid
	int carr_soln; // fix_type 0: no fix, 1: float, 2: fix
	bool is_moving; // Operating in moving base mode
	bool ref_pos_miss; // Extrapolated reference position was used to compute moving base solution
	bool ref_obs_miss; // Extrapolated reference observations were used to compute moving base solution
	bool rel_pos_heading_valid; // Heading is valid
	bool rel_pos_normalized; // Position values are normalized
} ubx_nav_relposned;

typedef struct {
	uint32_t i_tow; // GPS time of week of the navigation epoch
	uint32_t dur; // Passed survey-in observation time (s)
	double meanX; // Current survey-in mean position ECEF X coordinate
	double meanY; // Current survey-in mean position ECEF Y coordinate
	double meanZ; // Current survey-in mean position ECEF Z coordinate
	float meanAcc; // Current survey-in mean position accuracy
	uint32_t obs; // Number of position observations used during survey-in
	bool valid; // Survey-in position validity flag, 1 = valid, otherwise 0
	bool active; // Survey-in in progress flag, 1 = in-progress, otherwise 0
} ubx_nav_svin;

typedef struct {
	uint32_t i_tow; // GPS time of week of the navigation epoch

	/*
	 * Fractional part of i_tow. (range +/-500000)
	 * The precise GPS time of week in seconds is:
	 * (i_tow * 1e-3) + (f_tow * 1e-9)
	 */
	int32_t f_tow;

	int16_t weel; // GPS week number of the navigation epoch

	/*
	 * GPSfix Type, range 0..5
	 * 0x00 = No Fix
	 * 0x01 = Dead Reckoning only
	 * 0x02 = 2D-Fix
	 * 0x03 = 3D-Fix
	 * 0x04 = GPS + dead reckoning combined
	 * 0x05 = Time only fix
	 * 0x06..0xff: reserved
	 */
	uint8_t gps_fix;

	bool gpsfixok; // Fix within limits (e.g. DOP & accuracy)
	bool diffsoln; // DGPS used
	bool wknset; // Valid GPS week number
	bool towset; // Valid GPS time of week
	double ecef_x; // ECEF X coordinate
	double ecef_y; // ECEF Y coordinate
	double ecef_z; // ECEF Z coordinate
	float p_acc; // 3D Position Accuracy Estimate
	float ecef_vx; // ECEF X velocity
	float ecef_vy; // ECEF Y velocity
	float ecef_vz; // ECEF Z velocity
	float s_acc; // Speed Accuracy Estimate
	float p_dop; // Position DOP
	uint8_t num_sv; // Number of SVs used in Nav Solution
} ubx_nav_sol;

typedef struct {
    uint8_t gnss_id; // 0: GPS, 1: SBAS, 2: GAL, 3: BDS, 5: QZSS, 6: GLO
    uint8_t sv_id;
    uint8_t cno; // Carrier to noise ratio (signal strength)
    int8_t elev; // Elevation (range: +/-90), unknown if out of range
    int16_t azim; // Azimuth (range 0-360), unknown if elevation is out of range
    float pr_res; // Pseudorange residual
    uint8_t quality; // 0: no signal, 1: searching, 2: aquired, 3: unusable, 4: locked, 5-7: carrier, code and time locked
    bool used;
    uint8_t health; // 0: unknown, 1: healthy, 2: unhealthy
    bool diffcorr; // Differential correction available
} ubx_nav_sat_info;

typedef struct {
    uint32_t i_tow_ms; // GPS time of week of the navigation epoch.
    uint8_t num_sv; // Number of satellites.
    ubx_nav_sat_info sats[128];
} ubx_nav_sat;

typedef struct {
	double pr_mes;
	double cp_mes;
	float do_mes;
	uint8_t gnss_id;
	uint8_t sv_id;
	uint8_t freq_id;
	uint16_t locktime;
	uint8_t cno;
	uint8_t pr_stdev;
	uint8_t cp_stdev;
	uint8_t do_stdev;
	bool pr_valid;
	bool cp_valid;
	bool half_cyc_valid;
	bool half_cyc_sub;
} ubx_rxm_rawx_obs;

typedef struct {
	double rcv_tow;
	uint16_t week;
	int8_t leaps;
	uint8_t num_meas;
	bool leap_sec;
	bool clk_reset;
	ubx_rxm_rawx_obs obs[32];
} ubx_rxm_rawx;

typedef struct {
	uint32_t baudrate;
	bool in_rtcm3;
	bool in_rtcm2;
	bool in_nmea;
	bool in_ubx;
	bool out_rtcm3;
	bool out_nmea;
	bool out_ubx;
} ubx_cfg_prt_uart;

typedef struct {
	bool lla; // Use lla instead of ecef
	int mode; // Mode. 0 = Disabled, 1 = Survey in, 2 = Fixed
	double ecefx_lat;
	double ecefy_lon;
	double ecefz_alt;
	float fixed_pos_acc; // Fixed position accuracy
	uint32_t svin_min_dur; // SVIN minimum duration (s)
	float svin_acc_limit; // SVIN accuracy limit
} ubx_cfg_tmode3;

typedef struct {
	bool clear_io_port;
	bool clear_msg_conf;
	bool clear_inf_msg;
	bool clear_nav_conf;
	bool clear_rxm_conf;
	bool clear_sen_conf;
	bool clear_rinv_conf;
	bool clear_ant_conf;
	bool clear_log_conf;
	bool clear_fts_conf;

	bool save_io_port;
	bool save_msg_conf;
	bool save_inf_msg;
	bool save_nav_conf;
	bool save_rxm_conf;
	bool save_sen_conf;
	bool save_rinv_conf;
	bool save_ant_conf;
	bool save_log_conf;
	bool save_fts_conf;

	bool load_io_port;
	bool load_msg_conf;
	bool load_inf_msg;
	bool load_nav_conf;
	bool load_rxm_conf;
	bool load_sen_conf;
	bool load_rinv_conf;
	bool load_ant_conf;
	bool load_log_conf;
	bool load_fts_conf;

	bool dev_bbr; // Battery backed RAM
	bool dev_flash; // Flash
	bool dev_eeprom; // EEPROM
	bool dev_spi_flash; // SPI flash
} ubx_cfg_cfg;

typedef struct {
	bool apply_dyn; // Apply dynamic model settings
	bool apply_min_el; // Apply minimum elevation settings
	bool apply_pos_fix_mode; // Apply fix mode settings
	bool apply_pos_mask; // Apply position mask settings
	bool apply_time_mask; // Apply time mask settings
	bool apply_static_hold_mask; // Apply static hold settings
	bool apply_dgps; // Apply DGPS settings.
	bool apply_cno; // Apply CNO threshold settings (cnoThresh, cnoThreshNumSVs).
	bool apply_utc; // Apply UTC settings

	/*
	 * Dynamic platform model:
	 * 0: portable
	 * 2: stationary
	 * 3: pedestrian
	 * 4: automotive
	 * 5: sea
	 * 6: airborne with <1g acceleration
	 * 7: airborne with <2g acceleration
	 * 8: airborne with <4g acceleration
	 * 9: wrist worn watch
	 */
	uint8_t dyn_model;

	/*
	 * Position Fixing Mode:
	 * 1: 2D only
	 * 2: 3D only
	 * 3: auto 2D/3D
	 */
	uint8_t fix_mode;

	double fixed_alt; // Fixed altitude (mean sea level) for 2D fix mode. (m)
	double fixed_alt_var; // Fixed altitude variance for 2D mode. (m^2)
	int8_t min_elev; // Minimum Elevation for a GNSS satellite to be used in NAV (deg)
	float p_dop; // Position DOP Mask to use
	float t_dop; // Time DOP Mask to use
	uint16_t p_acc; // Position Accuracy Mask (m)
	uint16_t t_acc; // Time Accuracy Mask (m)
	uint8_t static_hold_thres; // Static hold threshold (cm/s)
	uint8_t dgnss_timeout; // DGNSS (RTK) timeout (s)
	uint8_t cno_tres_num_sat; // Number of satellites required to have C/N0 above cnoThresh for a fix to be attempted
	uint8_t cno_tres; // C/N0 threshold for deciding whether to attempt a fix (dBHz)
	uint16_t static_hold_max_dist; // Static hold distance threshold (before quitting static hold) (m)

	/*
	 * UTC standard to be used:
	 * 0: Automatic; receiver selects based on GNSS configuration (see GNSS time bases).
	 * 3: UTC as operated by the U.S. Naval Observatory (USNO); derived from GPS time
	 * 6: UTC as operated by the former Soviet Union; derived from GLONASS time
	 * 7: UTC as operated by the National Time Service Center, China; derived from BeiDou time
	 */
	uint8_t utc_standard;
} ubx_cfg_nav5;

typedef struct {
	uint8_t tp_idx; // Timepulse selection. 0=TP1, 1=TP2
	int16_t ant_cable_delay; // Antenna cable delay in ns
	int16_t rf_group_delay; // RF group delay in ns
	uint32_t freq_period; // Frequency or time period, Hz or us
	uint32_t freq_period_lock; // Frequency or time period when locked to GNSS time, Hz or us
	uint32_t pulse_len_ratio; // Pulse length or duty cycle, us or 2^-32
	uint32_t pulse_len_ratio_lock; // Pulse length or duty cycle when locked to GNSS time, us or 2^-32
	int32_t user_config_delay; // User configurable time pulse delay, ns

	/*
	 * If set enable time pulse; if pin assigned to another function, other function takes
	 * precedence. Must be set for FTS variant.
	 */
	bool active;

	/*
	 * If set synchronize time pulse to GNSS as soon as GNSS time is valid. If not
	 * set, or before GNSS time is valid use local clock. This flag is ignored by
	 * the FTS product variant; in this case the receiver always locks to the best
	 * available time/frequency reference (which is not necessarily GNSS).
	 */
	bool lockGnssFreq;

	/*
	 * If set the receiver switches between the timepulse settings given by 'freqPeriodLocked' &
	 * 'pulseLenLocked' and those given by 'freqPeriod' & 'pulseLen'. The 'Locked' settings are
	 * used where the receiver has an accurate sense of time. For non-FTS products, this occurs
	 * when GNSS solution with a reliable time is available, but for FTS products the setting syncMode
	 * field governs behavior. In all cases, the receiver only uses 'freqPeriod' & 'pulseLen' when
	 * the flag is unset.
	 */
	bool lockedOtherSet;

	/*
	 * If set 'freqPeriodLock' and 'freqPeriod' are interpreted as frequency,
	 * otherwise interpreted as period.
	 */
	bool isFreq;

	/*
	 * If set 'pulseLenRatioLock' and 'pulseLenRatio' interpreted as pulse
	 * length, otherwise interpreted as duty cycle.
	 */
	bool isLength;

	/*
	 * Align pulse to top of second (period time must be integer fraction of 1s).
	 * Also set 'lockGnssFreq' to use this feature.
	 * This flag is ignored by the FTS product variant; it is assumed to be always set
	 * (as is lockGnssFreq). Set maxSlewRate and maxPhaseCorrRate fields of CFG-SMGR to
	 * 0 to disable alignment.
	 */
	bool alignToTow;

	/*
	 * Pulse polarity:
	 * 0: falling edge at top of second
	 * 1: rising edge at top of second
	 */
	bool polarity;

	/*
	 * Timegrid to use:
	 * 0: UTC
	 * 1: GPS
	 * 2: GLONASS
	 * 3: BeiDou
	 * 4: Galileo (not supported in protocol versions less than 18)
	 * This flag is only relevant if 'lockGnssFreq' and 'alignToTow' are set.
	 * Note that configured GNSS time is estimated by the receiver if locked to
	 * any GNSS system. If the receiver has a valid GNSS fix it will attempt to
	 * steer the TP to the specified time grid even if the specified time is not
	 * based on information from the constellation's satellites. To ensure timing
	 * based purely on a given GNSS, restrict the supported constellations in CFG-GNSS.
	 */
	uint8_t gridUtcGnss;

	/*
	 * Sync Manager lock mode to use:
	 *
	 * 0: switch to 'freqPeriodLock' and 'pulseLenRatioLock' as soon as Sync
	 * Manager has an accurate time, never switch back to 'freqPeriod' and 'pulseLenRatio'
	 *
	 * 1: switch to 'freqPeriodLock' and 'pulseLenRatioLock' as soon as Sync Manager has
	 * an accurate time, and switch back to 'freqPeriod' and 'pulseLenRatio' as soon as
	 * time gets inaccurate.
	 *
	 * This field is only relevant for the FTS product variant.
	 * This field is only relevant if the flag 'lockedOtherSet' is set.
	 */
	uint8_t syncMode;
} ubx_cfg_tp5;

typedef struct {
    uint8_t gnss_id;
    uint8_t minTrkCh;
    uint8_t maxTrkCh;
    bool en;
    uint32_t flags;
} ubx_cfg_gnss_block;

typedef struct {
    uint8_t num_ch_hw;
    uint8_t num_ch_use;
    ubx_cfg_gnss_block blocks[10];
    int num_blocks;
} ubx_cfg_gnss;

typedef struct {
    // Filter
    bool posFilt; // Enable position output for failed or invalid fixes
    bool mskPosFilt; // Enable position output for invalid fixes
    bool timeFilt; // Enable time output for invalid times
    bool dateFilt; // Enable date output for invalid dates
    bool gpsOnlyFilt; // Restrict output to GPS satellites only
    bool trackFilt; // Enable COG output even if COG is frozen

    // Flags
    // enable compatibility mode. This might be needed for certain
    // applications when customer's NMEA parser expects a fixed number of digits in position coordinates
    bool compat;
    bool consider; // enable considering mode.
    bool limit82; // enable strict limit to 82 characters maximum.
    bool highPrec; // enable high precision mode.

    // Disable GNSS
    bool disableGps; // Disable reporting of GPS satellites
    bool disableSbas; // Disable reporting of SBAS satellites
    bool disableQzss; // Disable reporting of QZSS satellites
    bool disableGlonass; // Disable reporting of GLONASS satellites
    bool disableBeidou; // Disable reporting of BeiDou satellites

    uint8_t nmeaVersion; // 0x41: 4.10, 0x40: 4.0, 0x23: 2.3, 0x21: 2.1

    // Maximum Number of SVs to report per
    // TalkerId.
    // 0: unlimited
    // 8: 8 SVs
    // 12: 12 SVs
    // 16: 16 SVs
    uint8_t numSv;

    // Configures the display of satellites that do
    // not have an NMEA-defined value.
    // 0: Strict - Satellites are not output
    // 1: Extended - Use proprietary numbering
    uint8_t svNumbering;

    // This field enables the main Talker ID to be overridden.
    // 0: Main Talker ID is not overridden
    // 1: Set main Talker ID to 'GP'
    // 2: Set main Talker ID to 'GL'
    // 3: Set main Talker ID to 'GN'
    // 4: Set main Talker ID to 'GA'
    // 5: Set main Talker ID to 'GB'
    uint8_t mainTalkerId;

    // By default the Talker ID for GSV messages
    // is GNSS specific (as defined by NMEA).
    // This field enables the GSV Talker ID to be
    // overridden.
    // 0: Use GNSS specific Talker ID (as defined by NMEA)
    // 1: Use the main Talker ID
    uint8_t gsvTalkerId;

    // Sets the two characters that should be
    // used for the BeiDou Talker ID
    // If these are set to zero, the default BeiDou
    // TalkerId will be used
    char bdsTalkerId[2];
} ubx_cfg_nmea;

// ============== RTCM Datatypes ================== //

typedef struct {
	double t_tow;       // Time of week (GPS)
	double t_tod;       // Time of day (GLONASS)
	double t_wn;        // Week number
	int staid;          // ref station id
	bool sync;          // True if more messages are coming
	int type;           // RTCM Type
} rtcm_obs_header_t;

typedef struct {
	double P[2];        // Pseudorange observation
	double L[2];        // Carrier phase observation
	uint8_t cn0[2];     // Carrier-to-Noise density [dB Hz]
	uint8_t lock[2];    // Lock. Set to 0 when the lock has changed, 127 otherwise. TODO: is this correct?
	uint8_t prn;        // Sattelite
	uint8_t freq;       // Frequency slot (GLONASS)
	uint8_t code[2];    // Code indicator
} rtcm_obs_t;

typedef struct {
	int staid;
	double lat;
	double lon;
	double height;
	double ant_height;
} rtcm_ref_sta_pos_t;

typedef struct {
	double tgd;           // Group delay differential between L1 and L2 [s]
	double c_rs;          // Amplitude of the sine harmonic correction term to the orbit radius [m]
	double c_rc;          // Amplitude of the cosine harmonic correction term to the orbit radius [m]
	double c_uc;          // Amplitude of the cosine harmonic correction term to the argument of latitude [rad]
	double c_us;          // Amplitude of the sine harmonic correction term to the argument of latitude [rad]
	double c_ic;          // Amplitude of the cosine harmonic correction term to the angle of inclination [rad]
	double c_is;          // Amplitude of the sine harmonic correction term to the angle of inclination [rad]
	double dn;            // Mean motion difference [rad/s]
	double m0;            // Mean anomaly at reference time [radians]
	double ecc;           // Eccentricity of satellite orbit
	double sqrta;         // Square root of the semi-major axis of orbit [m^(1/2)]
	double omega0;        // Longitude of ascending node of orbit plane at weekly epoch [rad]
	double omegadot;      // Rate of right ascension [rad/s]
	double w;             // Argument of perigee [rad]
	double inc;           // Inclination [rad]
	double inc_dot;       // Inclination first derivative [rad/s]
	double af0;           // Polynomial clock correction coefficient (clock bias) [s]
	double af1;           // Polynomial clock correction coefficient (clock drift) [s/s]
	double af2;           // Polynomial clock correction coefficient (rate of clock drift) [s/s^2]
	double toe_tow;       // Time of week [s]
	uint16_t toe_wn;      // Week number [week]
	double toc_tow;       // Clock reference time of week [s]
	int sva;              // SV accuracy (URA index)
	int svh;              // SV health (0:ok)
	int code;             // GPS/QZS: code on L2, GAL/CMP: data sources
	int flag;             // GPS/QZS: L2 P data flag, CMP: nav type
	double fit;           // fit interval (h)
	uint8_t prn;          // Sattelite
	uint8_t iode;         // Issue of ephemeris data
	uint16_t iodc;        // Issue of clock data
} rtcm_ephemeris_t;

typedef struct {
	int buffer_ptr;
	int len;
	uint8_t buffer[1100];
	rtcm_obs_header_t header;
	rtcm_obs_t obs[32]; // 32 observations per sat system should be more than enough
	rtcm_ref_sta_pos_t pos;
	rtcm_ephemeris_t eph;
	void(*rx_rtcm_obs)(rtcm_obs_header_t *header, rtcm_obs_t *obs, int obs_num);
	void(*rx_rtcm_1005_1006)(rtcm_ref_sta_pos_t *pos);
	void(*rx_rtcm_1019)(rtcm_ephemeris_t *eph);
	void(*rx_rtcm)(uint8_t *data, int len, int type);
} rtcm3_state;

// ============== Radar Datatypes ================== //

typedef struct {
	bool log_en;
	float f_center;
	float f_span;
	int points;
	float t_sweep;
	float cc_x;
	float cc_y;
	float cc_rad;
	int log_rate_ms;
	float map_plot_avg_factor;
	float map_plot_max_div;
	int plot_mode; // 0 = off, 1 = sample, 2 = fft
	int map_plot_start;
	int map_plot_end;
} radar_settings_t;

// ============== VESC Datatypes ================== //

// CAN status sent by VESC
typedef struct {
	int id;
	uint32_t rx_time;
	float rpm;
	float current;
	float duty;
} can_status_msg;

typedef enum {
	MOTOR_CONTROL_DUTY = 0,
	MOTOR_CONTROL_CURRENT,
	MOTOR_CONTROL_CURRENT_BRAKE,
	MOTOR_CONTROL_RPM,
	MOTOR_CONTROL_POS
} motor_control_mode;

typedef enum {
	FAULT_CODE_NONE = 0,
	FAULT_CODE_OVER_VOLTAGE,
	FAULT_CODE_UNDER_VOLTAGE,
	FAULT_CODE_DRV,
	FAULT_CODE_ABS_OVER_CURRENT,
	FAULT_CODE_OVER_TEMP_FET,
	FAULT_CODE_OVER_TEMP_MOTOR
} mc_fault_code;

typedef struct {
	float v_in;
	float temp_mos;
	float temp_motor;
	float current_motor;
	float current_in;
	float id;
	float iq;
	float rpm;
	float duty_now;
	float amp_hours;
	float amp_hours_charged;
	float watt_hours;
	float watt_hours_charged;
    int tachometer;
    int tachometer_abs;
    mc_fault_code fault_code;
    float pid_pos;
    uint8_t vesc_id;
} mc_values;

// Communication commands
typedef enum {
	COMM_FW_VERSION = 0,
	COMM_JUMP_TO_BOOTLOADER,
	COMM_ERASE_NEW_APP,
	COMM_WRITE_NEW_APP_DATA,
	COMM_GET_VALUES,
	COMM_SET_DUTY,
	COMM_SET_CURRENT,
	COMM_SET_CURRENT_BRAKE,
	COMM_SET_RPM,
	COMM_SET_POS,
	COMM_SET_HANDBRAKE,
	COMM_SET_DETECT,
	COMM_SET_SERVO_POS,
	COMM_SET_MCCONF,
	COMM_GET_MCCONF,
	COMM_GET_MCCONF_DEFAULT,
	COMM_SET_APPCONF,
	COMM_GET_APPCONF,
	COMM_GET_APPCONF_DEFAULT,
	COMM_SAMPLE_PRINT,
	COMM_TERMINAL_CMD,
	COMM_PRINT,
	COMM_ROTOR_POSITION,
	COMM_EXPERIMENT_SAMPLE,
	COMM_DETECT_MOTOR_PARAM,
	COMM_DETECT_MOTOR_R_L,
	COMM_DETECT_MOTOR_FLUX_LINKAGE,
	COMM_DETECT_ENCODER,
	COMM_DETECT_HALL_FOC,
	COMM_REBOOT,
	COMM_ALIVE,
	COMM_GET_DECODED_PPM,
	COMM_GET_DECODED_ADC,
	COMM_GET_DECODED_CHUK,
	COMM_FORWARD_CAN,
	COMM_SET_CHUCK_DATA,
	COMM_CUSTOM_APP_DATA,
	COMM_NRF_START_PAIRING,
	COMM_GPD_SET_FSW,
	COMM_GPD_BUFFER_NOTIFY,
	COMM_GPD_BUFFER_SIZE_LEFT,
	COMM_GPD_FILL_BUFFER,
	COMM_GPD_OUTPUT_SAMPLE,
	COMM_GPD_SET_MODE,
	COMM_GPD_FILL_BUFFER_INT8,
	COMM_GPD_FILL_BUFFER_INT16,
	COMM_GPD_SET_BUFFER_INT_SCALE,
	COMM_GET_VALUES_SETUP,
	COMM_SET_MCCONF_TEMP,
	COMM_SET_MCCONF_TEMP_SETUP,
	COMM_GET_VALUES_SELECTIVE,
	COMM_GET_VALUES_SETUP_SELECTIVE,
	COMM_EXT_NRF_PRESENT,
	COMM_EXT_NRF_ESB_SET_CH_ADDR,
	COMM_EXT_NRF_ESB_SEND_DATA,
	COMM_EXT_NRF_ESB_RX_DATA,
	COMM_EXT_NRF_SET_ENABLED,
	COMM_DETECT_MOTOR_FLUX_LINKAGE_OPENLOOP,
	COMM_DETECT_APPLY_ALL_FOC,
	COMM_JUMP_TO_BOOTLOADER_ALL_CAN,
	COMM_ERASE_NEW_APP_ALL_CAN,
	COMM_WRITE_NEW_APP_DATA_ALL_CAN,
	COMM_PING_CAN,
	COMM_APP_DISABLE_OUTPUT,
	COMM_TERMINAL_CMD_SYNC,
	COMM_GET_IMU_DATA,
	COMM_BM_CONNECT,
	COMM_BM_ERASE_FLASH_ALL,
	COMM_BM_WRITE_FLASH,
	COMM_BM_REBOOT,
	COMM_BM_DISCONNECT
} COMM_PACKET_ID;

// ============== Decawave Datatypes ================== //

typedef enum {
	CMD_DW_RANGE = 0,
	CMD_DW_PING,
	CMD_DW_REBOOT,
	CMD_DW_UPTIME
} CMD_DW;

// ============== IO Board Datatypes ================== //

typedef enum {
	CAN_IO_PACKET_SET_VALVE = 0,
	CAN_IO_PACKET_SET_VALVES_ALL,
	CAN_IO_PACKET_SET_VALVE_PWM_DUTY,
	CAN_IO_PACKET_ADC_VOLTAGES_0_1_2_3,
	CAN_IO_PACKET_ADC_VOLTAGES_4_5_6_7,
	CAN_IO_PACKET_AS5047_ANGLE,
	CAN_IO_PACKET_LIM_SW,
	CAN_IO_PACKET_ADC0_HIGH_TIME,
	CAN_IO_PACKET_ADC0_LOW_TIME,
	CAN_IO_PACKET_ADC0_HIGH_LOW_CNT
} CAN_IO_PACKET;

typedef struct {
	float low_time_last;
	float high_time_last;
	float low_time_current;
	float high_time_current;
	uint32_t toggle_low_cnt;
	uint32_t toggle_high_cnt;
	bool is_high;
} ADC_CNT_t;

#endif /* DATATYPES_H_ */
