vedderb/rise_sdvp/Linux/RControlStation/routemagic.cpp

/*
    Copyright 2019 Benjamin Vedder benjamin@vedder.se &
                   Bo Joel Svensson svenssonjoel@yahoo.se

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
    You should have received a copy of the GNU General Public License
    along with this program.  If not, see <http://www.gnu.org/licenses/>.
    */
#include "routemagic.h"
#include <locpoint.h>
#include <attributes_masks.h>

#include <chrono>
using namespace std::chrono;
#include <QDebug>

#include <QFileDialog>
#include <QXmlStreamWriter>
#include <QXmlStreamReader>
#include <QMessageBox>
#include <mapwidget.h>
#include <QtMath>
#include <cassert>

RouteMagic::RouteMagic(QObject *parent) : QObject(parent)
{

}

double RouteMagic::maxFrom4(double a, double b, double c, double d)
{
    double res = a;
    if (b > res) res = b;
    if (c > res) res = c;
    if (d > res) res = d;
    return res;
}

double RouteMagic::minFrom4(double a, double b, double c, double d)
{
    double res = a;
    if (b < res) res = b;
    if (c < res) res = c;
    if (d < res) res = d;
    return res;
}

double RouteMagic::randInRange(double min, double max)
{
    double range = max - min;
    double k = RAND_MAX / range;
    return min + (static_cast<double>(rand()) / k);
}

bool RouteMagic::isPointWithin(double px, double py, QList<LocPoint> route)
{
    if (route.size() < 3) {
        return false;
    }
    int nVert = route.size();
    int i,j;
    bool c = false;

    for (i = 0, j = nVert -  1; i < nVert; j = i ++) {
        double vxi = route.at(i).getX();
        double vyi = route.at(i).getY();
        double vxj = route.at(j).getX();
        double vyj = route.at(j).getY();

        if (((vyi > py) != (vyj > py)) &&
            (px < (vxj-vxi) * (py-vyi) / (vyj-vyi) + vxi)) {
            c = !c;
        }
    }
    return c;
}

bool RouteMagic::isPointWithin(LocPoint p, QList<LocPoint> route)
{
    return isPointWithin(p.getX(),p.getY(),route);
}

bool RouteMagic::isPointOutside(double px, double py, QList<LocPoint> route)
{
    if (route.size() < 3) {
        return true;
    }
    int nVert = route.size();
    int i,j;
    bool c = true;

    for (i = 0, j = nVert-1; i < nVert; j = i++) {
        double vxi = route.at(i).getX();
        double vyi = route.at(i).getY();
        double vxj = route.at(j).getX();
        double vyj = route.at(j).getY();
        if (((vyi > py) != (vyj > py)) &&
                ( px < (vxj-vxi) * (py-vyi) / (vyj-vyi) + vxi)) {
            c = !c;
        }
    }
    return c;
}

bool RouteMagic::isPointOutside(LocPoint p, QList<LocPoint> route)
{
    return isPointOutside(p.getX(),p.getY(), route);
}

bool RouteMagic::isPointOutside(double px, double py, QList<QList<LocPoint> > cutouts)
{
    for (auto c : cutouts)  {
        if (!isPointOutside(px,py,c)) return false;
    }
    return true;
}

bool RouteMagic::isPointOutside(LocPoint p, QList<QList<LocPoint> > cutouts)
{
   return isPointOutside(p.getX(),p.getY(),cutouts);
}


bool RouteMagic::isSegmentWithin(LocPoint p1, LocPoint p2, QList<LocPoint> route)
{
    int i,j;
    int nVert = route.size();

    if (!isPointWithin(p2,route)) return false;

    for (i = 0, j = nVert - 1; i < nVert; j = i ++) {
        LocPoint q1 = route.at(j);
        LocPoint q2 = route.at(i);
        if (lineIntersect(p1, p2, q1, q2)) {
            return false;
        }
    }
    return true;
}

bool RouteMagic::isSegmentOutside(LocPoint p1, LocPoint p2, QList<LocPoint> route)
{
    if ( ! (isPointOutside(p1,route) && isPointOutside(p2, route))) return false;

    int i,j;
    int nVert = route.size();

    for (i = 0, j = nVert - 1; i < nVert; j = i ++) {
        LocPoint q1 = route.at(j);
        LocPoint q2 = route.at(i);
        if (lineIntersect(p1, p2, q1, q2)) {
            return false;
        }
    }
    return true;
}

bool RouteMagic::isSegmentOutside(LocPoint p1, LocPoint p2, QList<QList<LocPoint>> cutouts){
    for (auto c : cutouts) {
        if (!isSegmentOutside(p1,p2,c)) {
            return false;
        }
    }
    return true;
}

bool RouteMagic::ccw(LocPoint a, LocPoint b, LocPoint c)
{
    return (c.getY() - a.getY()) * (b.getX() - a.getX())
            > (b.getY() - a.getY()) * (c.getX() - a.getX());
}

bool RouteMagic::lineIntersect(LocPoint a, LocPoint b, LocPoint c, LocPoint d)
{
   return ccw(a,c,d) != ccw(b,c,d) && ccw(a,b,c) != ccw(a,b,d);
}

bool RouteMagic::boxesIntersect(QList<LocPoint> b0, QList<LocPoint> b1)
{
    if (b0.size() != 4 || b1.size() != 4) return false; // malformed boxes.

    int i0,j0;
    int i1,j1;
    for (i0 = 0, j0 = 3;i0 < 4; j0 = i0++) {
        for (i1 = 0, j1 = 3; i1 < 4; j1 = i1++) {
            if (RouteMagic::lineIntersect(b0.at(j0),b0.at(i0),
                              b1.at(j1),b1.at(i1))) {
                    return true;
            }
        }
    }
    return false;
}

bool RouteMagic::intersectionExists(QList<LocPoint> points0, QList<LocPoint> points1)
{
    if (points0.size() < 2 || points1.size() < 2)
        return false;

    for (int i = 1; i < points0.size(); i++)
        for (int j = 1; j < points1.size(); j++)
            if (lineIntersect(points0.at(i-1), points0.at(i), points1.at(j-1), points1.at(j)))
                return true;

    return false;
}

QList<LocPoint> RouteMagic::getAllIntersections(QList<LocPoint> points0, QList<LocPoint> points1)
{
    QList<LocPoint> intersections;
    if (points0.size() < 2 || points1.size() < 2)
        return intersections;

    for (int i = 1; i < points0.size(); i++)
        for (int j = 1; j < points1.size(); j++)
            if (lineIntersect(points0.at(i-1), points0.at(i), points1.at(j-1), points1.at(j))) {
                intersections.append(getLineIntersection(QPair<LocPoint, LocPoint>(points0.at(i-1), points0.at(i)),
                                                         QPair<LocPoint, LocPoint>(points1.at(j-1), points1.at(j))));
            }

    return intersections;
}

LocPoint RouteMagic::getLineIntersection(QPair<LocPoint, LocPoint> line0, QPair<LocPoint, LocPoint> line1) // intersection can lie outside of segments!
{
    double x1=line0.first.getX(), y1=line0.first.getY(), x2=line0.second.getX(), y2=line0.second.getY(),
            x3=line1.first.getX(), y3=line1.first.getY(), x4=line1.second.getX(), y4=line1.second.getY();

    // https://en.wikipedia.org/wiki/Line%E2%80%93line_intersection#Given_two_points_on_each_line
    double xIntersect = ( ((x1*y2-y1*x2)*(x3-x4)-(x1-x2)*(x3*y4-y3*x4)) / ((x1-x2)*(y3-y4)-(y1-y2)*(x3-x4)) );
    double yIntersect = ( ((x1*y2-y1*x2)*(y3-y4)-(y1-y2)*(x3*y4-y3*x4)) / ((x1-x2)*(y3-y4)-(y1-y2)*(x3-x4)) );

    // qDebug() << "(" << x1 << "," << y1 << ")---(" << x2 << "," << y2 << ")  /  (" << x3 << "," << y3 << ")---(" << x4 << "," << y4 << ") => (" << intersection.getX() << "," << intersection.getY() << ")\n";

    return LocPoint(xIntersect, yIntersect);
}

QList<LocPoint> RouteMagic::getAllIntersections(QList<LocPoint> route)
{
    QList<LocPoint> intersections;
    if (route.size() < 2)
        return intersections;

    for (int i = 1; i < route.size(); i++)
        for (int j = i+2; j < route.size(); j++)
            if (lineIntersect(route.at(i-1), route.at(i), route.at(j-1), route.at(j)))
                intersections.append(getLineIntersection(QPair<LocPoint, LocPoint>(route.at(i-1), route.at(i)),
                                                         QPair<LocPoint, LocPoint>(route.at(j-1), route.at(j))));

    return intersections;
}

bool RouteMagic::circlesOverlap(LocPoint p0, double r0, LocPoint p1, double r1)
{
    double dist = p0.getDistanceTo(p1);
    if ((r0 + r1) >= dist) return true;
    return false;
}

bool RouteMagic::lineIntersectsRouteTime(LocPoint p0, LocPoint p1, QList<LocPoint> route)
{
    // Assumes relative-time trajectories.
    // Assumes p1 is in the future relative to p0.

    if (route.size() < 2) return false;

    int i = 1;

    int32_t p0t = p0.getTime();
    int32_t p1t = p1.getTime();

    while (i < route.size()){
        // TEST: Rule out collision with teleporting object
        if (route.at(i-1).getTime() == route.at(i).getTime()) { i ++; continue;}

        if ((p1t >= route.at(i-1).getTime() && (p0t <= route.at(i).getTime()))){
            LocPoint p_last = LocPoint(route.at(i-1).getX(),route.at(i-1).getY());
            LocPoint p_now = LocPoint(route.at(i).getX(),route.at(i).getY());
            if (lineIntersect(p0,p1,p_last,p_now)) return true;
        }
        i++;
    }
    return false;
}

bool RouteMagic::routeIntersectsRouteInTime(QList<LocPoint> t0, QList<LocPoint> t1)
{
    if (t0.size() < 2 || t1.size() < 2) {
        return false;
    }

    LocPoint p0 = t0.at(0);

    for (int i = 1; i < t0.size(); i++) {
        LocPoint p1 = t0.at(i);

        if (lineIntersectsRouteTime(p0,p1, t1)) {
            return true;
        }
        p0 = p1;
    }
    return false;
}

double RouteMagic::angleBetweenLines(double px1, double py1, double px2, double py2,
                                     double qx1, double qy1, double qx2, double qy2)
{
    double a1 = atan2(py2-py1,px2-px1);
    double a2 = atan2(qy2-qy1,qx2-qx1);
    double diff = a2 - a1;
    if (diff > M_PI) {
        diff -= 2.0*M_PI;
    } else if (diff < -M_PI) {
        diff += 2.0*M_PI;
    }
    return diff;
}

double RouteMagic::angleBetweenLines(LocPoint p0a, LocPoint p0b, LocPoint p1a, LocPoint p1b) {
    return angleBetweenLines(p0a.getX(),p0a.getY(),p0b.getX(),p0b.getY(),
                             p1a.getX(),p1a.getY(),p1b.getX(),p1b.getY());
}


bool RouteMagic::getLineIntersection(double p0_x, double p0_y, double p1_x, double p1_y, double p2_x, double p2_y, double p3_x, double p3_y, LocPoint *coll)
{
    double s1_x, s1_y, s2_x, s2_y;
    s1_x = p1_x - p0_x;     s1_y = p1_y - p0_y;
    s2_x = p3_x - p2_x;     s2_y = p3_y - p2_y;

    double s, t;
    s = (-s1_y * (p0_x - p2_x) + s1_x * (p0_y - p2_y)) / (-s2_x * s1_y + s1_x * s2_y);
    t = ( s2_x * (p0_y - p2_y) - s2_y * (p0_x - p2_x)) / (-s2_x * s1_y + s1_x * s2_y);

    if (s >= 0 && s <= 1 && t >= 0 && t <= 1) {
        // Collision detected
        coll->setX(p0_x + (t * s1_x));
        coll->setY(p0_y + (t * s1_y));
        return true;
    }

    return false; // No collision
}

bool RouteMagic::getLineIntersection(LocPoint p0, LocPoint p1, LocPoint p2, LocPoint p3, LocPoint *coll) {
    return getLineIntersection(p0.getX(),p0.getY(),
                               p1.getX(),p1.getY(),
                               p2.getX(),p2.getY(),
                               p3.getX(),p3.getY(), coll);
}

bool RouteMagic::closestLineIntersection(double p0_x, double p0_y, double p1_x, double p1_y, QList<QList<LocPoint>>routes, LocPoint *coll)
{
    bool res = false;
    LocPoint collLast;
    double lastDist = 100000000.0;
    LocPoint pStart = LocPoint(p0_x, p0_y);

    if (routes.size() > 0) {
        for (QList<LocPoint> r: routes) {
            for (int i = 1;i < r.size();i++) {
                if (getLineIntersection(p0_x, p0_y, p1_x, p1_y,
                                        r.at(i - 1).getX(), r.at(i - 1).getY(),
                                        r.at(i).getX(), r.at(i).getY(), &collLast)) {

                    if (res) {
                        double dist = pStart.getDistanceTo(collLast);
                        if (dist < lastDist) {
                            coll->setX(collLast.getX());
                            coll->setY(collLast.getY());
                            lastDist = dist;
                        }
                    } else {
                        coll->setX(collLast.getX());
                        coll->setY(collLast.getY());
                        lastDist = pStart.getDistanceTo(collLast);
                    }

                    res = true;
                }
            }
        }
    }

    return res;
    //return false;
}

double RouteMagic::distanceToLine(LocPoint p, LocPoint l0, LocPoint l1)
{
    double l = l0.getDistanceTo(l1);
    if (l < 0.01) {
        return p.getDistanceTo(l0);
    } // one cm

    double x = p.getX();
    double y = p.getY();
    double x1 = l0.getX();
    double y1 = l0.getY();
    double x2 = l1.getX();
    double y2 = l1.getY();
    double a = x - x1;
    double b = y - y1;
    double c = x2 - x1;
    double d = y2 - y1;

    double dot = a * c + b * d;
    double len_sq = c * c + d * d;

    double param = dot / len_sq;

    double xx, yy;

    if (param < 0) {
        xx = x1;
        yy = y1;
    }
    else if (param > 1) {
        xx = x2;
        yy = y2;
    }
    else {
        xx = x1 + param * c;
        yy = y1 + param * d;
    }

    double dx = x - xx;
    double dy = y - yy;
    return sqrt(dx * dx + dy * dy);
}

QPair<LocPoint,LocPoint> RouteMagic::getBaselineDeterminingMinHeightOfConvexPolygon(QList<LocPoint> convexPolygon)
{
    // 1. Determine point with max distance for each line
    QList<QPair<QPair<LocPoint,LocPoint>, double>> maxDistances;
    for (int i = 0; i < convexPolygon.size() - 1 /* skip last */; i++) {
        LocPoint l0 = convexPolygon.at(i);
        LocPoint l1 = convexPolygon.at(i+1);

        double maxDistance = -1;
        for (int j = 0; j < convexPolygon.size(); j++) {
            if (j == i || j == i+1)
                continue;

            double currDistance = distanceToLine(convexPolygon.at(j), l0, l1);
            maxDistance = (currDistance > maxDistance)? currDistance : maxDistance;
        }
        maxDistances.append(QPair<QPair<LocPoint,LocPoint>, double>(QPair<LocPoint,LocPoint>(l0, l1), maxDistance));
    }
    assert(maxDistances.size() == convexPolygon.size() - 1);

    // 2. Determine line with minimum distance determined in 1.
    return std::min_element(maxDistances.begin(), maxDistances.end(),
                            [](QPair<QPair<LocPoint,LocPoint>, double> const& a, QPair<QPair<LocPoint,LocPoint>, double> const& b) -> bool
    {return a.second < b.second;})->first;
}

int RouteMagic::getClosestPointInRoute(LocPoint referencePoint, QList<LocPoint> route)
{
    double minDistance = std::numeric_limits<double>::max();
    int minIdx = -1;
    for (int i = 0; i < route.size(); i++) {
        double distance = sqrt(pow((route.at(i).getX()-referencePoint.getX()), 2) + pow((route.at(i).getY()-referencePoint.getY()), 2));
        if (distance < minDistance) {
            minDistance = distance;
            minIdx = i;
        }
    }
    assert(minIdx != -1);

    return minIdx;
}


bool RouteMagic::isRouteDrivable(QList<LocPoint> r,
                                 QList<LocPoint> outerFence,
                                 QList<QList<LocPoint>> cutouts,
                                 double maxAng) {
    bool res = true;

    //double maxAng = M_PI / 6;

    if (r.size() == 1) {
        res = isPointWithin(r.at(0), outerFence);
    } else if (r.size() > 1) {
        for (int i = 1;i < r.size();i++) {
            LocPoint p1 = r.at(i - 1);
            LocPoint p2 = r.at(i);

            if (!isSegmentWithin(p1,p2,outerFence)) {
                return false;
            }
            for (auto c : cutouts) {
                if (!isSegmentOutside(p1,p2,c)) {
                    return false;
                }
            }

            if (i >= 2) {
                double px1 = r.at(i - 2).getX();
                double py1 = r.at(i - 2).getY();
                double px = p1.getX();
                double py = p1.getY();
                double qx = p2.getX();
                double qy = p2.getY();

                if (fabs(angleBetweenLines(px1, py1, px, py,
                                           px, py, qx, qy)) > maxAng) {
                    return false;
                }
            }
        }
    }

    return res;
}

QList<LocPoint> RouteMagic::generateRouteWithin(int length,
                                                QList<LocPoint> prev_traj,
                                                double speed,
                                                int aheadmargin,
                                                QList<LocPoint> outerFence,
                                                QList<QList<LocPoint>> cutouts)
{
    QList<LocPoint> res = generateRouteWithin(length+aheadmargin, prev_traj,speed,outerFence,cutouts);
    int start = prev_traj.size();

    int end = length+start;
    if (end > res.size()) {
        end = res.size();
    }

    res = res.mid(0,end);
    return(res);
}
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
