vedderb/rise_sdvp/(commit log)

2016-03-13 Started building the Qt UI
    [quadrotor_base.blend]
2016-03-13 Finished packet implementation and implemented IMU
2016-03-14 Terminal implementation, IMU RT plots, CC2520 packet size and fragmentation fixes
    [carinterface.cpp, carinterface.h, comm_cc2520.c, commands.c, datatypes.h, hal_rf.c, main.c, mainwindow.cpp]
2016-03-14 Updated car 3D model
    [car.blend, quadrotor_base.blend]
2016-03-14 Fixed gyro units in RT plot
    [carinterface.cpp]
2016-03-15 Orientation calculation fixes, orientation widget fixes, mapwidget support for huge maps and more scaling levels, car follow and trace implementation, mapwidget to carinterface connection
    [MahonyAHRS.c, carinfo.cpp, carinfo.h, carinterface.cpp, carinterface.h, locpoint.cpp, locpoint.h, mainwindow.cpp]
2016-03-15 Car selection and minimum size fix
    [mainwindow.cpp, mapwidget.cpp, mapwidget.h, orientationwidget.cpp]
2016-03-16 Fixed segfault and drawing
    [carinterface.cpp, mainwindow.cpp, mapwidget.cpp]
2016-03-16 Magnetometer hard and soft iron compensation
2016-03-22 Added hardware and CAN interface
    [BOM_RCCar_IF.ods, BOM_RFMote_PA.ods, CAN.sch, CC1120.sch, CC1120EM_420_470_Partlist.xls, CC2520-CC2591EM_PARTLIST_zip.xls, CC2520.sch, CC2538-CC2592EM_2_0_1_BOM.xlsx]
2016-03-24 VESC interface, odometry added, IMU updates, bugs file
    [bldc_interface.c, carinterface.cpp, carinterface.h, comm_can.c, comm_cc2520.c, commands.c, conf_general.c, conf_general.h]
2016-03-24 VESC terminal fwd, battery voltage and fault code monitoring, refactoring
2016-03-29 Servo ramping, refactoring, AP editing and uploading
2016-04-01 Settings change at runtime, usb write thread, car client reconnect, vesc settings in fw, RTCM over tcp and serial
    [mcconf_sp_4pole_540kv.xml]
2016-04-04 RTCM bug fix, added script to start local base station
    [mainwindow.cpp, rtcmclient.cpp, rtcmwidget.cpp]
2016-04-06 Optimization, set position fix
    [carinterface.cpp, carinterface.h, mainwindow.cpp, mainwindow.h, mapwidget.cpp, mapwidget.h, orientationwidget.cpp, pos.c]
2016-04-18 Added pictures, Added VESC pre-configured firmware, created cc1120 files
2016-04-21 3d model serialization, defines to remove dependencies besides qt, serialport error print update
    [mainwindow.cpp, mainwindow.h, orientationwidget.cpp, orientationwidget.h]
2016-05-04 First RTK GPS integration, autopilot repeat, servo configuration change, added misc files
2016-05-04 Only use RTK float or fix
    [pos.c]
2016-05-04 Steering center for car0
2016-05-09 PS3 joystick support, NMEA print can be switched off
2016-05-09 Added rtkrcv, updated car_client, fixed js status message
    [datatypes.h, mainwindow.cpp]
2016-05-20 Base station tab, NMEA height fix, js renaming to ps4, NS-RAW conf tool
    [basestation.cpp, basestation.h, datatypes.h, main.cpp, mainwindow.cpp, mainwindow.h, nmeaserver.cpp, pos.c]
2016-05-26 GPS updates, stop button, untested gps yaw correction
    [autopilot.c, carinterface.cpp, carinterface.h, commands.c, conf_general.c, conf_general.h, datatypes.h, mainwindow.cpp]
2016-06-07 Autopilot: ind fix, speed fix, whole route uploading from map, map quick buttons
    [autopilot.c, carinterface.cpp, carinterface.h, commands.c, conf_general.c, conf_general.h, datatypes.h, mainwindow.cpp]
2016-06-07 Change route speed button
2016-06-08 brake on stop, lower pid min erpm, latest vesc firmware and interface
    [mcconf_sp_4pole_540kv.xml]
2016-06-13 Some fixes, tero config
    [autopilot.c, carinterface.cpp, commands.c, conf_general.c, conf_general.h, datatypes.h, packetinterface.cpp, packetinterface.h]
2016-07-08 OSM updates and ENU conv fix
    [mapwidget.cpp, mapwidget.h, networklogger.cpp, osmtile.cpp, pos.c, utility.cpp, utility.h]
2016-07-09 OpenStreetMap fixes and optimization
    [mainwindow.cpp, mainwindow.h, mapwidget.cpp, mapwidget.h]
2016-07-11 fixed OSM caching, GUI updates, network logger fixes, regenerated ping logs
    [datatypes.h, mainwindow.cpp, mainwindow.h, mapwidget.cpp, mapwidget.h, networklogger.cpp, networklogger.h, ping.cpp]
2016-07-13 Map rendering optimizations, some bugs left
    [locpoint.cpp, locpoint.h, mainwindow.cpp, mainwindow.h, mapwidget.cpp, mapwidget.h, networklogger.cpp]
2016-07-13 Finally fixed the drawing optimization bug
    [mapwidget.cpp]
2016-07-13 Fixed nmea parser, plotting updates, show info points that the mouse is close to
    [carinterface.cpp, conf_general.h, locpoint.h, mapwidget.cpp, mapwidget.h, networklogger.cpp, nmeaserver.cpp, pos.c]
2016-08-11 UDP control, bldc_if for latest fw
2016-09-02 Added lost connection timeout, updated VESC firmware
2016-09-19 NMEA import and stream fix type color
    [mainwindow.cpp]
2016-09-23 Fixed logging and added option to forward received NMEA over UDP
    [log.c, mainwindow.cpp, mainwindow.h]
2016-10-10 Circle generation options, map font fix
    [conf_general.h, mainwindow.cpp, mapwidget.cpp]
2016-10-12 TCP server support for VESC Tool communication
2016-12-14 First complete version of command interface
    [mcconf_sp_4pole_540kv.xml]
2016-12-21 Bug fix to support multiple network messages
    [networkinterface.cpp]
2017-01-10 CC1120 working driver
2017-01-17 NMEA forwarding option, correction age display
    [carinterface.cpp, commands.c, conf_general.c, conf_general.h, datatypes.h, eeprom.h, nmeaserver.cpp, nmeaserver.h]
2017-01-17 configurable trace minimum movement for car and gps trace
2017-01-22 Updated VESC interface and firmware
2017-01-24 Added reboot command for the PI, use old serialport implementation in Car_Client to avoid segfaults on unplug
    [carclient.cpp, carclient.h, carinterface.cpp, carinterface.h, commands.c, conf_general.h, datatypes.h, packetinterface.cpp]
2017-02-06 Support for multiple info traces
2017-02-08 Added RTK PCB
    [BOM_RCCar_IF.ods, CAN.sch, CC1120.sch, CC1120EM_420_470_Partlist.xls, CC2520-CC2591EM_PARTLIST_zip.xls, CC2520.sch, CC2538-CC2592EM_2_0_1_BOM.xlsx, MCU.sch]
2017-02-09 First finished version of CC1120 driver
2017-02-10 CC1120 driver update
2017-02-15 Implemented terminal callbacks, updated ublox driver with poll command
2017-02-18 Fixed bugs in base station mode, more ubx cmds
    [commands.c, conf_general.h, datatypes.h, moteconfig.cpp, moteconfig.h, packetinterface.cpp, ublox.c, ublox.h]
2017-02-18 Updated tero gear ratio
2017-02-19 Ublox reset, radio fixes and a bit of cleaning
    [cc1120.c, comm_cc1120.c, comm_cc2520.c, conf_general.h, main.c, mcuconf.h, ublox.c]
2017-02-20 Make sure that the autopilot can be switched off even if many packets are lost
2017-02-21 Added libLAML to RC_Car_Tool and implemented magnetometer compensation in C++
2017-02-21 Updated magnetometer calibration UI
2017-02-21 New IMU yaw angle estimation
2017-02-21 Added comment about memory leaks in libLAML
    [carinterface.cpp]
2017-02-22 Fixed memory leaks in libLAML for the used functions. libLAML still needs proper fixing
    [carinterface.cpp, mainwindow.cpp, packetinterface.cpp, ping.cpp]
2017-02-22 Replaced libLAML with eigen
    [carinterface.cpp]
2017-02-23 Added decawave CAN support and some DMA remapping
2017-02-23 Use odometry for yaw angle correction option
    [carinterface.cpp, commands.c, conf_general.c, conf_general.h, datatypes.h, packetinterface.cpp, pos.c]
2017-02-24 Mote mode bug fix
    [conf_general.c]
2017-02-24 Fixed initial heading calculation
    [commands.c, conf_general.h]
2017-02-24 Set gps yaw offset to 90 to get correct initial heading and ublox refactoring
    [pos.c, ublox.c]
2017-02-24 Added disable motor configuration option
2017-02-24 Ubx rtcm reset bug fix
    [conf_general.c, conf_general.h, pos.c, ublox.c]
2017-02-25 Removed local position offset as they would cause problems
    [commands.c, conf_general.c, conf_general.h, datatypes.h, pos.c]
2017-02-26 Fixed route upload duplicate point issue
    [autopilot.c, autopilot.h, commands.c, conf_general.c, pos.c]
2017-02-28 Added time tag adjustment to RTCM encoder
2017-02-28 Fixed RTCM bugs and various other bugs, added ublox rtklib config, updated carclient
    [commands.c, conf_general.h, datatypes.h, packetinterface.cpp, packetinterface.h, pos.c, rtcm3_simple.c, rtcm3_simple.h]
2017-03-02 Ebike conf, dw logging update, vesc fwd timeout increase to enable measurements
2017-03-07 Added multirotor datatypes, moved magnetometer calibration to separate file
2017-03-07 Moved IMU plotting to separate file
2017-03-09 Created own class for nmea widget, added quadrotor 3d model
    [quadrotor.blend]
2017-03-09 Added SRF10 ultrasonic sensor support
2017-03-09 More multirotor adaption. NOTE: Code is currently broken
    [autopilot.c, commands.c, conf_general.c, datatypes.h, eeprom.h, main.c, mcuconf.h, mr_control.c]
2017-03-15 Updated VESC fw and changed GPS icon in settings widget
2017-03-20 Added more multirotor configuration parameters, got ubx m8t base station mode working, several ubx bug fixes
    [basestation.cpp, commands.c, conf_general.c, conf_general.h, datatypes.h, packetinterface.cpp, rtcm3_simple.c, ublox.c]
2017-03-23 MR actuator and some control implementation
2017-03-28 Voltage measurement, copter ublox fix, copter button handlers
    [actuator.c, adconv.c, adconv.h, commands.c, copterinterface.cpp, copterinterface.h, ublox.c]
2017-03-30 Updated multirotor velocity estimation
2017-03-30 Added show code button for magcal
2017-04-05 Renaming and refactoring, added readme and documentation build script
    [car.blend, quadrotor.blend]
2017-04-06 Removed more files
    [CC2538-CC2592EM_2_0_1_BOM.xlsx, art_param.txt, nc_param.txt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]
2017-04-27 Fixed deadlock in autopilot_replace_route command
    [autopilot.c]
2017-04-27 Ignore state packets with too short length in case they are poll packets from another RControlStation
    [packetinterface.cpp]
2017-05-08 Added ARM build of rtkrcv
2017-05-08 Fixed path in command to start screen
    [carclient.cpp]
2017-05-18 Configure ublox from Car_Client before starting screen, added lambda function to ublox to return correct result on ack
    [carclient.cpp, datatypes.h, nmeaserver.cpp, nmeaserver.h, tcpbroadcast.cpp, tcpbroadcast.h, ublox.cpp, ublox.h]
2017-05-19 Added build and upload script for PCB with ublox
2017-05-19 Moved ubx handling to car client, set system time to GPS time when it differs too much
    [carclient.cpp, carclient.h, main.cpp, ublox.cpp, ublox.h]
2017-05-19 Use commands instead of system calls for reboot and time setting to get cleaner shutdown and to avoid setcap requirement
    [carclient.cpp, carclient.h, nmeaserver.cpp]
2017-09-05 Save and load routes, rtrange widget, fault string bug fix
    [carinterface.cpp, carinterface.h, datatypes.h, mainwindow.cpp, mainwindow.h, mapwidget.cpp, mapwidget.h, packetinterface.cpp]
2017-09-13 Network if bug fix, added first version of intersection_test
    [carinfo.cpp, carinfo.h, locpoint.cpp, locpoint.h, main.cpp, mainwindow.cpp, mainwindow.h, mapwidget.cpp]
2017-09-21 Added UART logging output support and conti radar beginning
2017-10-20 Updated PCB with MPU9250
    [BOM.ods, BOM_RCCar_IF.ods, CAN.sch, CC1120.sch, CC1120EM_420_470_Partlist.xls, CC2520-CC2591EM_PARTLIST_zip.xls, CC2520.sch, MCU.sch]
2017-11-21 Added polled UART logging support
2017-11-29 Support for the new PCBs
2017-11-30 Prepared for motor controller simulation
2017-12-04 Finished motor simulator
2017-12-04 Added timeout to motor simulator
2017-12-12 Increased AP stack size, reverted yaw correction
    [autopilot.c, conf_general.h, pos.c]
2017-12-13 Polled UART logging bug fix
    [log.c]
2017-12-20 Support for any board yaw rotation, magnetometer yaw estimation fixes, always send raw magnetometer values in rt data
    [conf_general.c, conf_general.h, mpu9150.c, mpu9150.h, pos.c]
2017-12-21 More magnetometer yaw estimation fixes
    [conf_general.c, conf_general.h, pos.c, utils.c]
2018-01-31 Relative time mode and sync point fix
    [autopilot.c]
2018-02-22 Do not switch back to time mode after sync rx
2018-02-22 Fixed MONR heading offset
    [chronos.cpp, mainwindow.h]
2018-03-02 Added gitignore files
    [CAN.sch, CC1120.sch, CC2520.sch, MCU.sch, MPU9150.sch, MPU9250.sch, RCCAR_IF_Board_GPS.sch, SERVO_IO.sch]
2018-04-06 Updated GNSS angle correction
    [datatypes.h, pos.c]
2018-04-06 PPS filtering
2018-04-09 Updated default wheel diameter
2018-04-16 GNSS plotting: reset base samples before updating them
    [pos.c]
2018-04-17 Fixed GNSS analysis sample reset
    [pos.c]
2018-04-19 Added button to toggle the visibility of another graph
2018-05-23 Added UWB PCB files and FW, more progress towards automatic test case generation
    [stm32-bv_openocd.cfg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]
2018-06-08 Added UWB antenna offset support
2018-06-14 Added VESC6 precompiled firmware for SP motor
2018-07-02 Fixed typo that prevented compilation
    [locpoint.cpp]
2018-07-06 Command id for car client only, minor car client gui fixes
    [carclient.cpp, commands.c, conf_general.h, main.cpp]
2018-07-19 First version of differential steering
2018-07-23 Multiple motor simulation support, differential steering mode fixes
    [autopilot.c, comm_can.c, conf_general.h, motor_sim.c, motor_sim.h, pos.c, pos_uwb.c, pos_uwb.h]
2018-07-23 Added support for latest vesc firmware with id in the mc_values message
2018-07-24 Scala test updates and fixes
    [pos_uwb.c]
2018-08-01 Map draw route text option, recovery route improvements, stop tests if recovery route fails
    [mainwindow.cpp, mainwindow.h, mapwidget.cpp, mapwidget.h]
2018-09-12 Configurable number of battery cells in Car_Client
2018-09-13 Added solution type to car text on map, added option to disable drawing of UWB trace
2018-09-14 Updated RTK strings with correction age
    [nmeawidget.cpp]
2018-09-14 Added option to clamp IMU yaw when car is stationary
2018-09-14 Avoid yaw jump when toggling yaw clamping
    [pos.c]
2018-09-15 Fixed yaw setting when clamping is enabled
    [conf_general.h, pos.c]
2018-10-18 Added QTime include to mapwidget to fix build problems on some systems
    [mapwidget.cpp]
2018-12-05 Switched off LIME_SDR by default
2019-01-02 Added camera support in Car_Client and RControlStation
2019-01-02 Camera support fixes
2019-01-02 Another camera tweak
2019-01-03 F11 for fullscreen, more camera info
2019-01-03 More camera features, some joystick updates
2019-01-03 Added fullscreen camera support and support for some joystick buttons
2019-01-04 Added repeating joystick button support and implemented up and down events for keys from joystick buttons
2019-01-07 Camera frame dropping, store traces without map in focus, interaction mode in mapwidget, arrows to emulate scroll in mapwidget, better Car_Client id handling
2019-01-23 SimScen open scenario bug fix
    [pagesimscen.cpp]
2019-02-22 Handle multiple log commands in the same tcp frame
2019-04-01 Disabled camera support by default in Car_Client
2019-04-04 Added VESC servo, hydraulic drive and drangen support
2019-04-05 VESC Servo and hydraulic updates
2019-04-05 Added wireless PS4 controller support
2019-04-05 Added hydraulic safety timeout and decreased servo frequency
2019-05-07 Major documentation update
    [BOM.ods, CAN.sch, CC1120.sch, CC1120EM_420_470_Partlist.xls, CC2520-CC2591EM_PARTLIST_zip.xls, CC2520.sch, MCU.sch, MPU9150.sch]
2019-05-17 Fixed bug when reading routes
    [packetinterface.cpp]
2019-05-20 Added button to zoom in on all routes
2019-05-22 More cli parameters and some fixes
    [carinterface.cpp, carinterface.h, main.cpp, mainwindow.cpp, mainwindow.h, networkinterface.cpp, networkinterface.h, tcpclientmulti.cpp]
2019-05-28 Added chronos scenario timer
2019-06-25 Added reset script for raspberry pi
2019-07-04 Added scatterplot button for experiment plot
2019-08-14 Added IMU yaw to pos struct
2019-08-16 UWB yaw correction and support for UWB positioning alone (may not work yet)
    [autopilot.c, autopilot.h, carinterface.cpp, commands.c, conf_general.c, conf_general.h, datatypes.h, packetinterface.cpp]
2019-09-23 Moving development of the f9p board to rise_sdvp repository
    [MCU.sch, f9p.sch, f9p_board.kicad_pcb, f9p_board.sch, power.sch]
2019-09-24 Some more wiring around the F9P and added a library file for the WDFN6 package
    [MCU.sch, f9p.sch, f9p_board.kicad_pcb]
2019-09-24 F9P_Board : ERC without complaints. Wiring most things up. Need review
    [MCU.sch, f9p.sch, f9p_board.kicad_pcb, power.sch]
2019-09-24 F9P_Board experimenting with how to lay components out
    [f9p_board.kicad_pcb]
2019-09-25 Added 3D-printable case for UWB board
    [base.stl, case.FCStd, cover.stl]
2019-09-25 Updated UWB case
    [base.stl, case.FCStd]
2019-09-25 experimentation with layout of components
    [MCU.sch, f9p.sch, f9p_board.kicad_pcb]
2019-09-26 Added missing break in monr decode
    [chronoscomm.cpp]
2019-09-26 f9p_board: started to route and some some small rearrangements
    [f9p_board.kicad_pcb]
2019-09-27 f9p_board: Routed everything, needs review
    [MCU.sch, f9p.sch, f9p_board.kicad_pcb]
2019-09-28 Added uwb pcb case gcode that is easier to print
2019-10-01 F9P_Board moving silks text around and adding resistors on USB data +/- lines
    [MCU.sch, f9p.sch, f9p_board.kicad_pcb]
2019-10-02 Some updates on F9P board
    [MCU.sch, f9p_board.kicad_pcb, power.sch]
2019-10-03 Removed unused slot
2019-10-03 Initialize state in motor sim
2019-10-03 Car_Client fixing mess up related to Signals and Slots
    [chronos.cpp]
2019-10-06 rearranged all the components to align with the grid
    [MCU.sch, f9p.sch, f9p_board.kicad_pcb, power.sch]
2019-10-07 adding power-supply components, rerouting needed!
    [f9p_board.kicad_pcb, power.sch]
2019-10-07 updating component footprints for inductor and caps on dcdc part
    [f9p_board.kicad_pcb, power.sch]
2019-10-08 f9p_board: Added dcdc. todo: routing
    [MCU.sch, f9p_board.kicad_pcb, power.sch]
2019-10-08 started routing
    [f9p_board.kicad_pcb]
2019-10-09 f9p_board : started routing with redesign of dcdc powersupply
    [MCU.sch, f9p_board.kicad_pcb, power.sch]
2019-10-10 f9p_board: progress with routing
    [f9p_board.kicad_pcb, power.sch]
2019-10-11 f9p_board: connecting CAN 5v to PWR_5V net. Also everything routed - first attempt
    [MCU.sch, f9p_board.kicad_pcb]
2019-10-11 f9p_board: Added switch for boot0 to enable USB flashing. Added another pair of servo connectors
    [MCU.sch, f9p_board.kicad_pcb]
2019-10-13 f9p_board: routing
    [f9p_board.kicad_pcb]
2019-10-14 f9p_board: internal copper layers are GND
    [f9p_board.kicad_pcb]
2019-10-14 Finished F9P PCB v1.0
    [f9p_board-B_Cu.gbr, f9p_board-B_Mask.gbr, f9p_board-B_Paste.gbr, f9p_board-B_SilkS.gbr, f9p_board-Edge_Cuts.gbr, f9p_board-F_Cu.gbr, f9p_board-F_Mask.gbr, f9p_board-F_Paste.gbr]
2019-10-21 replacing DCDC Step-down converter footprint with - hopefully - the correct thing.
    [f9p_board.kicad_pcb, power.sch]
2019-10-22 f9p_board: adding more Order numbers
    [MCU.sch, f9p.sch, f9p_board.kicad_pcb, power.sch]
2019-10-23 Updated F9P board
    [MCU.sch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]
2019-11-06 f9p_board added lots of ordernr from digikey and a stp file for rf connector
    [734120110.stp, MCU.sch, f9p.sch, f9p_board.kicad_pcb, power.sch]
2019-11-06 Added step files for F9P board
    [ABM3C.STEP, DPR0010A.stp, PowerDI5.stp, STEP-WE-PD-1210-rev1.stp]
2019-11-06 Added ping and reset functions to UWB module
    [comm_can.c, comm_can.h, datatypes.h, terminal.c]
2019-11-06 Always use WDG on UWB module, initialize variable to avoid possible crash
    [comm_can.c, comm_usb.c, conf_general.c, mainwindow.cpp, mainwindow.h]
2019-11-08 Fixed UWB uptime command print
    [comm_usb.c]
2019-11-08 Fixed UWB pcb watchdog and added twostep SSH tunnel example script
    [comm_can.c]
2019-11-08 Increased stop break current and uncheck poll and kb control when starting camera stream
2019-11-12 Removed old gerber files
    [f9p_board-B_Cu.gbr, f9p_board-B_Mask.gbr, f9p_board-B_Paste.gbr, f9p_board-B_SilkS.gbr, f9p_board-Edge_Cuts.gbr, f9p_board-F_Cu.gbr, f9p_board-F_Mask.gbr, f9p_board-F_Paste.gbr]
2019-11-12 UWB-board: Sketching on DWM1001 based uwb board
    [uwb_pcb_v2.kicad_pcb, uwb_pcb_v2.sch]
2019-11-19 added 3.3V can
    [uwb_pcb_v2.sch]
2019-11-20 added component position and value plot for soldering
    [f9p_board.kicad_pcb]
2019-11-21 Added terminal command buttons
2019-11-23 UWB V2: adding voltage regulator and some other tweaking-about
    [uwb_pcb_v2.sch]
2019-11-25 Added SWD support for raspberry pi 4
    [oo_rpi3.cfg, oo_rpi4.cfg]
2019-11-25 Initial support for f9 board
    [oo_rpi4.cfg]
2019-11-26 Added terminal command to read input voltage
2019-11-26 Updated rpi4 oocd settings
    [oo_rpi4.cfg]
2020-01-14 moving a resistor that was very close to the power connector
2020-01-14 added new gerber but I do not feel entirely confident it is proper. please check
2020-01-14 Moved another resistor a bit. please check my work for sanity
    [f9p_board.kicad_pcb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]
2020-01-15 adding a prototype implementation of area-filling trajectories. RouteMagic is now a part of RControlStation, but needs optimisation
2020-02-03 Added IO board
    [io_board.kicad_pcb, io_board.sch, mcu.sch]
2020-02-03 added some text to the IO board
    [io_board.kicad_pcb]
2020-02-03 Updated io board silkscreen
    [io_board.kicad_pcb]
2020-03-18 RouteMagic::fillConvexPolygonWithZigZag: fix first nodes too far from bounds, cleanup
    [routemagic.cpp]
2020-04-02 Added io_board fw and fixed io_board hw bug
    [io_board.kicad_pcb, io_board.sch, mcu.sch]
2020-04-05 Added valve connector photo
2020-04-05 Added IO board test commands and slider
2020-04-12 Added valve mapping info
2020-04-13 Ublox fixes for new FW, mactrac hydraulic actuator support
    [basestation.cpp, carinterface.cpp, carinterface.h, commands.c, conf_general.c, conf_general.h, datatypes.h, hydraulic.c]
2020-04-13 Turn off NMEA GSV for F9P, as that will overload the UART with too many sats
2020-04-13 Fixed antenna offset calculation
    [pos.c]
2020-04-13 Implemented mactrac speed sensor
2020-04-17 RouteMagic::fillConvexPolygonWithZigZag: fix turns violating bounds when bounds are drawn counterclockwise
    [routemagic.cpp]
2020-05-20 RC_Controller: fix setting UART1 baudrate on unconfigured F9P chips
    [ublox.c]
2020-05-28 RControlStation: do not configure UART1 when connecting UBX over USB
2020-05-28 RControlStation: implement "task_basestation" a command line mode of RControlStation that serves as a RTK GNSS basestation after survey-in, sending RTCM3 over TCP (based on basestation functionality 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
    RControlStation: implement rxSvin slot in Task_BaseStation
    RControlStation: implement Task_BaseStation::rtcmRx
    RControlStation/Task_BaseStation: implement rxNavSat, console status output
    RControlStation/task_basestation: print more info, format output
2020-06-17 RControlStation: add functionality to configure WireGuard as a VPN solution from UI (Linux only for now)
2020-06-17 RControlStation: update WireGuard default values
2020-06-17 RControlStation/task_basestation: fix local IP output
    [task_basestation.cpp]
2020-06-17 RControlStation: clarify wireguard status description
2020-06-17 RC_Controller/pwm_esc.c: fix servo mapping for f9p board
    [pwm_esc.c]
2020-07-11 MacTrac: Improved steering PID controller, changed default radius, enabled ethernet logging by default
2020-07-11 Reset m_point_now in autopilot when reaching end of route
    [autopilot.c]
2020-10-20 autopilot (RC_Controller, Car_Client): fix erratic behaviour when repeating short routes (< lookahead)
    [autopilot.c]
2020-10-22 RC_Controller: reset autopilot state and disable autopilot when ending route
    [autopilot.c]
2020-10-23 RControlStation/wireguard: set default values for uppsala basestation
2020-10-29 RControlStation/routemagic: fix broken turns in specific case
    [routemagic.cpp]
2020-11-09 RControlStation: fix windows build (rename variable "interface" to "currInterface")
    [mainwindow.cpp]
2020-11-20 RControlStation/Basestation: introduce moving basestation feature (note: measurement rate on base and rover need to be identical, high latencies like over 4G can be problematic)
    [basestation.cpp, basestation.h, task_basestation.cpp, task_basestation.h]
