vedderb/rise_sdvp/Hardware/io_board/freecad/20200402_112802.jpg

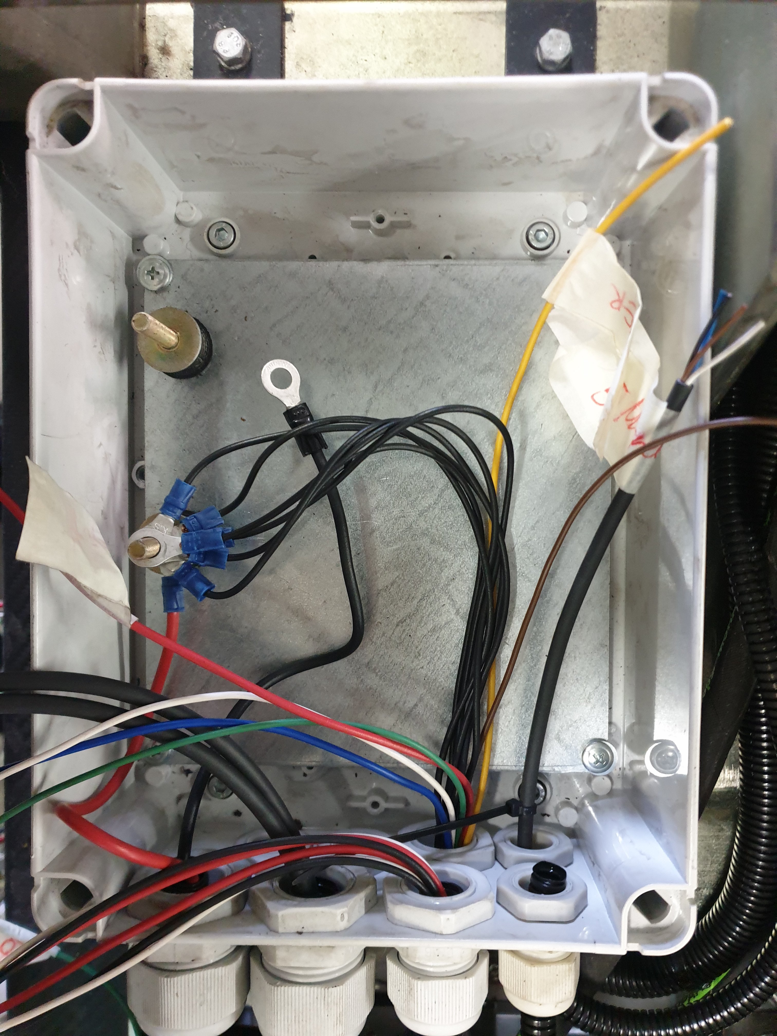
Hardware/io_board/freecad/20200402_112802.jpg
